EPFLXplore/ERC_AV_HW/README.md

# Electronics Subsystem Harware Repository

## How to clone

`git clone https://github.com/EPFLXplore/AV_HW_workspace.git`

`git submodule update --init --remote`
