EPFLXplore/ERC_AV_HW/node_pcb/orion_pcb/misc/TPS25947xx_Design_Calculator.xlsm

Sheet: Calculation Sheet
TPS25947xx Design Calculation Tool
 |  |  |  |  |  |  |  |  |  | Table - 1: Device Comparison Table
 | Constants Cells |  |  |  |  |  |  |  |  | Part number | Overvoltage Response | Overcurrent response | AUXOFF or PG | FLT or PGTH | Response to Thermal Shutdown (TSD) |  | 3.8 | 5.7 | 13.8
 | Input/SelectCells |  |  |  |  |  |  |  |  | TPS259470A | Adjustable OVLO | Active Current Limit | AUXOFF | FLT | Auto-Retry |  | Short | Open | 390
 | Calculation Cells |  |  |  |  |  |  |  |  | TPS259470L | Adjustable OVLO | Active Current Limit | AUXOFF | FLT | Latch-off
 | Calculated, but can be over-ridden by user |  |  |  |  |  |  |  |  | TPS259472A | Pin Selectable OVC (3.8 V/5.7 V/13.8 V) | Active Current Limit | PG | PGTH | Auto-Retry
 | Error Cells, Must be Fixed |  |  |  |  |  |  |  |  | TPS259472L | Pin Selectable OVC(3.8 V/5.7 V/13.8 V) | Active Current Limit | PG | PGTH | Latch-off
 |  |  |  |  |  |  |  |  |  | TPS259474A | Adjustable OVLO | Circuit Breaker | PG | PGTH | Auto-retry
Parameter | Description | Value | Units | Tolerance | Recommended Value |  |  |  |  | TPS259474L | Adjustable OVLO | Circuit Breaker | PG | PGTH | Latch-off
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
