EPFLXplore/ERC_AV_HW/Power/GEOX/rev1/Documentation/Calculation/TPS249x_8x_Design_Calculator_REV_B.xlsx

Sheet: Instructions
 | © 2016
TPS249x/8x Design Tool- Rev. B
Typical design procedure
Typical applications require multiple passes through the design tool using MOSFET factors such as transient
thermal response and safe operating area curves. Refer to the following application reports for more detail.
Robust Hot Swap Design (http://www.ti.com/lit/pdf/slva673)
The basic design process follows:
1. Enter operating conditions.
2. Select current limit parameters.
3. Enter MOSTFET SOA characteristics & power limit.
4. Select start up conditions (load and/or soft start). Check whether FET is operating with reasonable margin, within the SOA curve.
If not, try changing start-up conditions (soft start values, timer values), add more FETs in parallel, or switch to FET with better SOA.
5. Enter desired UVLO and OVLO values to get recommended resistor values.
6. Done
Notes
1. This worksheet is designed for use with Microsoft Excel 5.0 or later. Its use is intended to assist power supply designers in their
routine, day-to-day calculations.
2. All worksheets have light green inputs cells, white calculated cells, yellow warning cells and red high-risk cells.
3. Formulas and device constants used in the spreadsheet are locked to prohibit them from accidentally being overwritten or deleted.
TEXAS INSTRUMENTS TEXT FILE LICENSE Copyright (c) 2014 Texas Instruments Incorporated All rights reserved not granted herein. Limited License. Texas Instruments Incorporated grants a world-wide, royalty-free, non-exclusive license under copyrights and patents it now or hereafter owns or controls to make, have made, use, import, offer to sell and sell ("Utilize") this software subject to the terms herein. With respect to the foregoing patent license, such license is granted solely to the extent that any such patent is necessary to Utilize the software alone. The patent license shall not apply to any combinations which include this software, other than combinations with devices manufactured by or for TI (“TI Devices”). No hardware patent is licensed hereunder. Redistributions must preserve existing copyright notices and reproduce this license (including the above copyright notice and the disclaimer and (if applicable) source code license limitations below) in the documentation and/or other materials provided with the distribution Redistribution and use in binary form, without modification, are permitted provided that the following conditions are met: * No reverse engineering, decompilation, or disassembly of this software is permitted with respect to any software provided in binary form. * any redistribution and use are licensed by TI for use only with TI Devices. * Nothing shall obligate TI to provide you with source code for the software licensed and provided to you in obje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

Sheet: Design Calculator
TPS2490/1/2/3 & TPS2480/1/2/3 Hot Swap Design Tool
 | www.ti.com/hotswap
 |  |  | Enter Values in Green Shaded Cells
 |  |  | Calculated Values are shown in White Cells
 |  |  | Yellow and Red cells highlight pottential issues with the design. Red highlights items that are higher risk.
 | Step 0: Calculator Tutorials |  | Note: Before proceeding, please watch the video tutorials listed to ensure accurate results from this tool!
 |  |  | Steps 1 & 2: Operating Conditions, Current Limit, & Circuit Breaker (7:41) (https://training.ti.com/node/1133677)
 |  |  | Step 3: MOSFET Selection (9:58) (https://training.ti.com/node/1133673)
 |  |  | Step 4: Startup (10:32) (https://training.ti.com/node/1133664)
 |  |  | Step 5: UVLO, OVLO & PGD Thresholds (4:20) (https://training.ti.com/node/1133681)
 |  |  | TPS2490 Datasheet (http://www.ti.com/product/TPS2490)
 |  |  | I understand and agree to watch the video tutorials if help is needed. (Choose Yes to enable the calculator.) |  |  | Yes
 |  |  | Assure to follow the layout and application guidelines listed on the datasheet. |  |  | Yes
 |  |  | *For additional questions not addressed in the videos, please post on E2E.ti.com
 | Step 1: Operating Conditions |  |  | Minimum Input Operating Voltage: VIN(MIN) | 12 | V
 |  |  |  | Nominal Input Operating Voltage: VIN(NOM) | 48 | V
 |  |  |  | Maximum Input Operating Voltage: VIN(MAX) | 52 | V
 |  |  |  | Maximum Load Current: IOUT(MAX) | 150 | A
 |  |  |  | Maximum Output Load Capacitance: CLOAD | 10000 | µF
 |  |  |  | Maximum Ambient Operating Temperature: TMAX | 55 | oC
 | Steps 1 & 2: Operating Conditions, Current Limit, & Circuit Breaker (https://training.ti.com/node/1133677)
 | Step 2: Current Limit and Circuit Breaker |  |  | Maximum Recommended Value for Rs | 0.30 | mW
 |  |  |  | Use External Resistor Divider to Reduce Effecitve RS | No
 |  |  |  | Enter the Resistance for RS | 0.3 | mW
 |  |  |  | Recommended Value for RCL1 | 10 | W
 |  |  |  | Recommended Value for RCL2 | 0.00 | W
 |  |  |  | Enter value for RCL1 | 10 | W
 |  |  |  | Enter value for RCL2 | 2 | W
 | Steps 1 & 2: Operating Conditions, Current Limit, & Circuit Breaker (https://training.ti.com/node/1133677) |  |  | Effective Sense Resistance (RS,EFF) | 0.30 | mW
 |  |  |  | Resulting Minimum Current Limit | 150.0 | A
 |  |  |  | Resulting Typical Current Limit | 166.7 | A
 |  |  |  | Resulting Maximum Current Limit | 183.3 | A
 |  |  |  | Maximum Power Dissipation in RS | 10.1 | W
 | Step 3: MOSFET Selection |  |  | Q1 FET Name | SQJQ184E-T1_GE3
 |  |  |  | Estimated MOSFET RQJA | 30 | oC/W
 |  |  |  | Number of MosFETs | 4 | #
 |  |  |  | MOSFET On resistance @ TJ,DC | 1.54 | mW
 |  |  |  | Maximum FET Junction Temperature | 175 | oC
 |  |  |  | 100ms SOA Current (re-use 1ms data if unavailable) @ VIN(MAX) | 400.0 | A
 |  |  |  | 1ms SOA Current @ VIN(MAX) | 70.0 | A
 | Step 3: MOSFET Selection (https://training.ti.com/node/1133673) |  |  | 10ms SOA Current @ VIN(MAX) | 30.0 | A
 |  |  |  | 100ms Current at @ VIN(MAX) (use DC if 100ms not available) | 12.0 | A
 |  |  |  | 1s or DC SOA Current at @ VIN(MAX) (use DC if 1s not available) | 12.0 | A
 |  |  |  | FET Power dissapation at full load (per FET) | 2.2 | W
 | Note: TI recommends choosing a FET with SOA current specified for 100ms and/or 1s or DC. If choosing a FET without these parameters, this calculator will estimate the values via extrapolation, which leaves an inherent associated risk. |  |  | Maximum steady state FET Junction Temperature (TJ,DC) | 120.0 | oC
 |  |  |  | Minimum Power Limit to Ensure Vsns > 5mV & Vprog > 0.4V (PLIM,MIN) | 866.7 | W
 |  |  |  | Target Power Limit | 866.0 | W
 |  |  |  | Select R3 | 45.0 | kW
 |  |  |  | Calculated R4 | 6.72 | kW
 |  |  |  | Actual R4 (Select next available std. value) | 6.8 | kW | Note: Hover here to see the 3 values affecting this curve, consult a thermal expert if you are unsure!
 |  |  |  | Actual PLIM | 875.16 | W
 | Step 4: Startup |  |  | Load Turn-On Threshold | 0 | V
 |  |  |  | Startup Load Type | Constant Current
 |  |  |  | Startup Load Value | 0.3 | A
 |  |  |  | Use External Soft-Start Control | Yes
 |  |  |  | Typical Start Time with Vinmax (Tstart) | 260.00 | ms
 |  |  |  | IFET - ILOAD margin (lowest for Vout range) | 86.95652174%
 |  |  |  | Target Fault Timer: Tstart + Margin | 455.00 | ms
 |  |  |  | Target Timer capacitance | 2843.75 | nF
 |  |  |  | Selected Timer capacitance | 220 | nF
 | Step 4: Startup (https://training.ti.com/node/1133664) |  |  | Final Fault Timer(Tfault) | 35.20 | ms
 |  |  |  | Derated SOA / PLIM | 3.62
 |  |  |  | Can a "hot" board be hotplugged | No
 |  |  |  | Recommended slew Rate (max) | 0.59 | V/ms
 |  |  |  | Recommended slew Rate (min) | 0.10 | V/ms
 | Note: This is the typical dv/dt rate, but max value can be larger. This is because the gate source current can vary from 16uA to 28uA. Thus TI recommends keeping the overall SOA margin during start-up >1.5 in order to compensate for this. |  |  | dv/dt rate on Vout | 0.2 | V/ms
 |  |  |  | calculated SS capacitance | 110.00 | nF
 |  |  |  | actual SS capacitance | 110 | nF
 |  |  |  | actual dv/dt rate on Vout | 0.20 | V/ms
 |  |  |  | SOA margin during start-up | 4.17
 |  |  |  | Target Fault Time | 0.4 | ms
 |  |  |  | Calculated Timer Capacitance | 2.50 | nF
 |  |  |  | Actual Timer Capacitance (pick one smaller than CT,CALC) | 2 | nF
 |  |  |  | Actual Fault Time (Tfault) | 0.32 | ms
 |  |  |  | SOA margin during "hot-short" or "start-into short" | 3.62
 | Step 5: UVLO, OVLO & PGD Thresholds |  |  | Target Under - Voltage | 30 | V
 |  |  |  | Recommended R2 | 10.00 | kW
 |  |  |  | Actual R2 | 10 | kW
 |  |  |  | Calculated R1 | 212.22 | kW
 |  |  |  | Actual R1 | 212 | kW
 |  | Resulting Thresholds: | Minimum | Typical | Maximum
 | Step 5: UVLO, OVLO & PGD Thresholds (https://training.ti.com/node/1133681) | Resulting Upper UVLO Threshold = | 29.30 | 29.97 | 30.64 | V
 |  | Resulting Lower UVLO Threshold = | 27.08 | 27.75 | 28.42 | V
 | Design Summary |  |  | RS = | 0.3 | mW
 |  |  |  | RCL1 = | DNP | W
 |  |  |  | RCL2 = | short | W
 |  |  |  | R1 = | 212 | kW |  |  | Typical | Units
 |  |  |  | R2 = | 10 | kW |  | Current limit | 166.7 | A
 |  |  |  | R3 = | 45.0 | kW |  | Power Limit | 875.1608752 | W
 |  |  |  | R4 = | 6.8 | kW |  | Fault Timeout | 0.320 | ms
 |  |  |  | CT = | 2.00 | nF |  | Upper UVLO Threshold | 30.0 | V
 |  |  |  | C1 = | 0.10 | µF |  | Lower UVLO Threshold | 27.8 | V
 |  |  |  | Q1 = | SQJQ184E-T1_GE3
 |  |  |  | RG = | 1 | kW
 |  |  |  | CG = | 110 | nF
 | Notes: | 1. Although not mandatory, CIN provides transient suppression at the VIN pin
 |  | 2. A TVS clamp from VIN to GND is absolutely mandatory to clamp the voltage overshoot upon MOSFET turn-off, e.g. during circuit breaker
 |  | 3. Componet tolerances not accounted for in Min/Max Calculations.

Sheet: Equations
Current Limit
 |  |  | CLMIN = | 45 | mV
 |  |  | CLNOM = | 50 | mV
 |  |  | CLMAX = | 55 | mV
 |  |  |  | Max Rs = | 0.297029703
 |  |  |  | RCL1 Recommended = | 10
 |  |  |  | RCL2 Recommmended = | 0
 |  |  |  | Effective Rs = | 0.3
 |  |  |  | Min. Current limit = | 150.00
 |  |  |  | Typ. Current limit = | 166.6666667
 |  |  |  | Max. Current limit = | 183.3333333
 |  |  |  | Rs Power Diss. = | 10083.33333 |  |  |  | R = R4 / (R4+R3)
 |  |  |  |  |  |  |  |  | R* R4 + R*R3 = R4
FET Selection |  |  |  |  |  |  |  |  | R4(1-R) = R *R3
 |  |  |  |  | Nominal |  | Derated at TJ
 |  |  |  | 100ms SOA Current Maximum Input Voltage | 20800 | W | 7631 |  | R4 = R3 * R/(1-R)
 |  |  |  | 1ms SOA Current Maximum Input Voltage | 3640 | W | 1335.425
 |  |  |  | 10ms SOA Current Maximum Input Voltage | 1560 | W | 572.325
 |  |  |  | 100ms or DC SOA Current at Maximum Input Voltage | 624 | W | 228.93
 |  |  |  | Minimum Power Limit= | 866.6666667 | W
 |  |  |  | Target PLIM | 866 | W
 |  |  |  | Target Vprog | 0.5196 | V
 |  |  |  | R3 | 45 | k-ohm
 |  |  |  | Res. Div. | 0.130
 |  |  |  | R4 | 6.718 | k-ohm
 |  |  |  | Act R4 | 6.8
 |  |  |  | Vprog | 0.525 | V
 |  |  |  | Plim | 875.161
Startup
 |  |  | With PLIM
 |  |  |  | Typical Start time | 260.00 | ms
 |  |  |  | Start-slop | 0.75
 |  |  |  | Target Fault Timer | 455 | ms
 |  |  |  | Target Timer capacitance | 2843.75 | nF
 |  |  |  | Selected Timer capacitance | 220.00 | nF
 |  |  |  | Final Fault Timer | 35.2 | ms
 |  |  |  | SOA / PLIM | 3.615049483
 |  |  | With SS
 |  |  |  | dv/dt rate | 0.2 | V/ms
 |  |  |  | calculated SS capacitance | 110 | nF
 |  |  |  | actual SS capacitance | 110 | nF
 |  |  |  | actual dv/dt rate | 0.2 | V/ms
 |  |  |  | I_Cout | 2 | A
 |  |  |  | typical start time | 260 | ms
 |  |  |  | FET Energy dissipated at start-up (EFET) | 15.3985 | J
 |  |  |  | Peak Power dissipated during start-up (PFET) | 119.6 | W
 |  |  |  | Equivalent time at peak power - EFET/PFET (t_power) | 128.75 | ms
 |  |  |  | Available SOA for t_power at Vinmax | 499.2 | W
 |  |  |  | SOA margin | 4.173913043
 |  |  |  |  | 1 | ms
 |  |  | Covering hot-short, start-into short for SS
 |  |  |  | Target Fault Time | 0.40
 |  |  |  | Calculated Timer Capacitance | 2.5 | nF
 |  |  |  | Actual Timer Capacitance | 2.00 | nF
 |  |  |  | Actual Fault Time (Tfault) | 0.32 | ms
 |  |  |  | Available derated SOA for Tfault | 3163.74987 | W
 |  |  |  | SOA margin | 3.615049483
 |  |  |  | UVLO |  |  |  |  | 1.35 = UV * R2/(R2+R1)
 |  |  |  | Target Under - Voltage | 30 | V
 |  |  |  | Recommended R2 | 10 | k-ohm |  |  | R2+R1 = UV * R2 /1.35
 |  |  |  | Actual R2 | 10 | k-ohm
 |  |  |  | Calculated R1 | 212.22 | k-ohm |  |  | R1 = R2*(-1+UV/1.35)
 |  |  |  | Actual R1 | 212 | k-ohm
 |  |  | Resulting Thresholds: | Minimum | Typical | Maximum
 |  |  | Resulting Upper UVLO Threshold = | 29.30 | 29.97 | 30.64
 |  |  | Resulting Lower UVLO Threshold = | 27.08 | 27.75 | 28.42
 |  | GRAPH:
 |  |  |  | Selected Rs = | 0.3
 |  |  |  | Max System voltage = | 52
 |  |  |  | Current Lim (min) = | 150.00
 |  |  |  | Current Lim (typ) = | 166.67
 |  |  |  | Current Lim (max) = | 183.33
 |  |  |  | Power Limit (typ) = | 875.161
 |  |  | A) This table calculates the Ids current based |  |  |  |  | B) This table corrrects the table at left so no |  |  |  | C) This table creates the |  |  | D) This table changes ID values to zero for Vds>Vin(max)
 |  |  | on power limit only - no current limit info. |  |  |  |  | current is greater than the current limit. |  |  |  | SOA data points from |  |  | and adds the SOA curve. This data is plotted.
 | PLIM |  | Vds | Min | Typ | Max |  | Vds | Min | Typ | Max | the customer's SOA |  |  | Vds | Min | Typ | Max | SOA | Temp Derated SOA
 | 875.1608752 | 0.1 | 0.4333333333 | 1514.70 | 2019.60 | 2524.50 |  | 0.4333333333 | 150.00 | 166.67 | 183.33 | data he entered. |  |  | 0.4333333333 | 150.00 | 166.67 | 183.33 | 7300.96 | 3163.74987 | W
 | 875.1608752 | 1 | 4.333333333 | 151.47 | 201.96 | 252.45 |  | 4.333333333 | 150.00 | 166.67 | 183.33 |  |  |  | 4.333333333 | 150.00 | 166.67 | 183.33 | 730.10
 | 875.1608752 | 2 | 8.666666667 | 75.74 | 100.98 | 126.23 |  | 8.666666667 | 75.74 | 100.98 | 126.23 |  | User's |  | 8.666666667 | 75.74 | 100.98 | 126.23 | 365.05
 | 875.1608752 | 3 | 13 | 50.49 | 67.32 | 84.15 |  | 13 | 50.49 | 67.32 | 84.15 | Vds | Ids |  | 13 | 50.49 | 67.32 | 84.15 | 243.37
 | 875.1608752 | 4 | 17.33333333 | 37.87 | 50.49 | 63.11 |  | 17.33333333 | 37.87 | 50.49 | 63.11 | 0.4333333333 | 3163.74987 | x = customer's entry | 17.33333333 | 37.87 | 50.49 | 63.11 | 182.52
 | 875.1608752 | 5 | 21.66666667 | 30.29 | 40.39 | 50.49 |  | 21.66666667 | 30.29 | 40.39 | 50.49 | 4.333333333 | 2862.44 |  | 21.66666667 | 30.29 | 40.39 | 50.49 | 146.02
 | 875.1608752 | 6 | 26 | 25.25 | 33.66 | 42.08 |  | 26 | 25.25 | 33.66 | 42.08 | 8.666666667 | 2768.28 |  | 26 | 25.25 | 33.66 | 42.08 | 121.68
 | 875.1608752 | 7 | 30.33333333 | 21.64 | 28.85 | 36.06 |  | 30.33333333 | 21.64 | 28.85 | 36.06 | 13 | 2695.05 |  | 30.33333333 | 21.64 | 28.85 | 36.06 | 104.30
 | 875.1608752 | 8 | 34.66666667 | 18.93 | 25.25 | 31.56 |  | 34.66666667 | 18.93 | 25.25 | 31.56 | 17.33333333 | 2636.46 | x | 34.66666667 | 18.93 | 25.25 | 31.56 | 91.26
 | 875.1608752 | 9 | 39 | 16.83 | 22.44 | 28.05 |  | 39 | 16.83 | 22.44 | 28.05 | 21.66666667 | 1792.79 |  | 39 | 16.83 | 22.44 | 28.05 | 81.12
 | 875.1608752 | 10 | 43.33333333 | 15.15 | 20.20 | 25.25 |  | 43.33333333 | 15.15 | 20.20 | 25.25 | 26 | 1190.17 |  | 43.33333333 | 15.15 | 20.20 | 25.25 | 73.01
 | 875.1608752 | 11 | 47.66666667 | 13.77 | 18.36 | 22.95 |  | 47.66666667 | 13.77 | 18.36 | 22.95 | 30.33333333 | 738.21 |  | 47.66666667 | 13.77 | 18.36 | 22.95 | 66.37
 | 875.1608752 | 12 | 52 | 12.62 | 16.83 | 21.04 |  | 52 | 12.62 | 16.83 | 21.04 | 34.66666667 | 386.68 |  | 52 | 12.62 | 16.83 | 21.04 | 60.84
 | 875.1608752 | 13 | 56.33333333 | 11.65 | 15.54 | 19.42 |  | 56.33333333 | 11.65 | 15.54 | 19.42 | 39 | 105.46 | x | 56.33333333 | 5e-10 | 5e-10 | 5e-10 | 56.16
 | 875.1608752 | 14 | 60.66666667 | 10.82 | 14.43 | 18.03 |  | 60.66666667 | 10.82 | 14.43 | 18.03 | 43.33333333 | 70.31 |  | 60.66666667 | 5e-10 | 5e-10 | 5e-10 | 52.15
 | 875.1608752 | 15 | 65 | 10.10 | 13.46 | 16.83 |  | 65 | 10.10 | 13.46 | 16.83 | 47.66666667 | 45.20 |  | 65 | 5e-10 | 5e-10 | 5e-10 | 48.67
 | 875.1608752 | 16 | 69.33333333 | 9.47 | 12.62 | 15.78 |  | 69.33333333 | 9.47 | 12.62 | 15.78 | 52 | 26.36 |  | 69.33333333 | 5e-10 | 5e-10 | 5e-10 | 45.63
 |  |  |  |  |  |  |  |  |  |  |  | 56.33333333 | 11.72 |  |  | 0.00 | 0.00 | 0.00 | #DIV/0!
 |  |  | Note: I added an adjustment for the systematic offset |  |  |  |  |  |  |  |  | 60.66666667 | 0.00 | x |  | 0.00 | 0.00 | 0.00 | #DIV/0!
 |  |  |  |  |  |  |  |  |  |  |  | 65 | 0.00 |  |  | 0.00 | 0.00 | 0.00 | #DIV/0!
 |  |  | Vos syst | #REF! |  |  |  |  |  |  |  | 69.33333333 | 0.00
 |  |  | Rs (ohm) | 0.0003
 |  |  | Vin, max | 52
 |  |  | Plim tolerance |  | 0.25
 |  |  | Plim (Vds) = Plim (Vin,max) + (Vds - Vin,max)*Vos,syst/Rs
