EPFLXplore/ERC_AV_HW/hats/neopixel_Eliot/misc/images.png

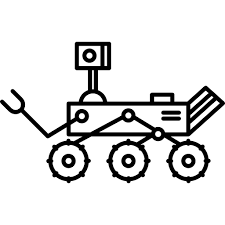
hats/neopixel_Eliot/misc/images.png
