EPFLXplore/ERC_AV_HW/hats/neopixel_Eliot/misc/star-wars-baby-yoda-with-lightsaber-custom-progress-bar-m.png

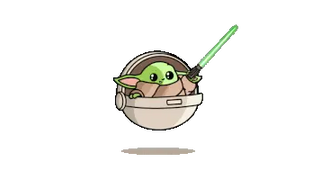
hats/neopixel_Eliot/misc/star-wars-baby-yoda-with-lightsaber-custom-progress-bar-m.png
