EPFLXplore/ERC_AV_HW/nav_controller_interface/nav_controller_interface_v3/nav_lower_controller/misc/kerby_mission_patch.png

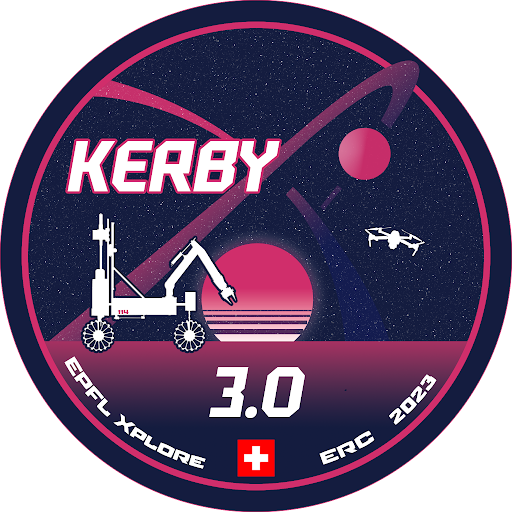
nav_controller_interface/nav_controller_interface_v3/nav_lower_controller/misc/kerby_mission_patch.png
