EPFLXplore/ERC_AV_HW/Power/GEOX/rev2/SMPS_Motherboard/Manufacturing/smps_legged_robot.csv

Id | Référence | Empreinte | Quantité | Désignation | Fournisseur et réf
1 | Y1101 | 7M25000MAAJT | 1 | 7M-25.000MAAJ-T
2 | R1115,R1130,R1135,R1114,R1113,R1136,R1128,R1129 | R_0402_1005_DensityHigh | 8 | 4.75k 0.1% 1/16W
3 | J1104,J1103,J1102,J1105 | 1054301203 | 4 | Nano-Fit 1x03
4 | C1145,C816,C1127,C1709,C1126,C1117,C1116,C901,C1105,C417,C1128,C1146,C808,C1121,C2001,C1115,C1102,C1139,C1140,C809,C416,C409,C1124,C407,C1001,C410,C1104,C403,C408,C1122,C1101,C1801,C815,C1206,C1119,C414,C1109,C1110,C1120,C404,C1112,C1123,C1113,C1701,C1125,C1147,C405,C1118 | C_0402_1005_DensityHigh | 48 | 100n X7R 50V
5 | R1132,R1133,R1125,R1131,R1134 | R_0402_1005_DensityHigh | 5 | 470R 1% 1/16W
6 | Molex_602,Molex_604,Molex_601,Molex_607,Molex_605,Molex_603,Molex_606,Molex_608 | 172448-YY02 | 8 | ~
7 | IC1501 | SOP50P490X110-10N | 1 | TPS2490DGSRG4
8 | R805 | R_0402_1005_DensityHigh | 1 | 43k
9 | C817 | C_0805_2012_DensityHighest | 1 | 22u X7R 10V
10 | D1001,D901,D1301,D2501,D1401,D1302 | SOT1176D | 6 | PESD4USB5B-TBSX
11 | C2103,C2102,C2105,C2201,C2202,C2203,C2204,C2104 | C_0603_1608_DensityHigh | 8 | 1n X7R 1kV
12 | L803 | L_Coilcraft_LPS4018 | 1 | 22u
13 | FB1101,FB1103,FB1104,FB1102 | BLM18SP221SN1B | 4 | BLM18PG330SN1D
14 | D504,D501,D503,D502 | DIOM4336X24N | 4 | SMBJ51CD-M3/H
15 | C802,C1204 | C_0805_2012_DensityHigh | 2 | 100n X7R 100V
16 | D1102,D1104,D1105,D1103 | SOT95P230X117-3N | 4 | PESD2CANFD24V-UX
17 | C805,C1205,C1148,C804 | C_0805_2012_DensityHigh | 4 | 2.2u X7R 25V
18 | R402,R403 | R_0402_1005_DensityHigh | 2 | 5.1k 1% 1/16W
19 | C1133,C1136 | C_0402_1005_DensityHigh | 2 | 18p NP0 50V
20 | R401 | R_0402_1005_DensityHigh | 1 | 33k 1% 1/16W
21 | C1141,C1143,C1142,C1144 | C_0603_1608_DensityHigh | 4 | 22n X7R 50V
22 | R1705,R1103 | R_0603_1608_DensityHigh | 2 | 47k 1% 1/10W
23 | R1101,R406,R1102,R405,R404 | R_0402_1005_DensityHigh | 5 | 10k 1% 1/16W
24 | R1502 | R_1206_3216_DensityHigh_Large | 1 | 10k 1% 1/4W
25 | R1505 | RES_WSLP3921_.003OHM_VIS | 1 | 0.3m
26 | C412,C413,C818,C415,C814,C820,C406 | C_0402_1005_DensityHigh | 7 | 1u X7R 10V
27 | R408,R407 | R_0402_1005_DensityHigh | 2 | 27R 1% 1/5W
28 | Q1102 | SOT-23-3 | 1 | MF-DSC-SOT233-BSS138
29 | L801 | XEL4030682MEC | 1 | 6u8
30 | C1207,C803 | C_1210_3225_DensityHigh | 2 | 10u X7R 25V
31 | D1504,D1505 | LED_0603_1608Metric | 2 | GREEN
32 | IC1102 | SOIC127P600X175-8N | 1 | M24C16-RMN6P
33 | R801 | R_0603_1608_DensityHigh | 1 | 34k 1% 1/4W
34 | FB1201,FB801 | R_0805_2012_DensityHigh | 2 | 1k @ 100MHz
35 | C1111 | C_0402_1005_DensityHigh | 1 | 1u X7R 50V
36 | R806,R803 | R_0402_1005_DensityHigh | 2 | 10k 1%
37 | F1301,F1401 | FUSC6127X294N | 2 | 0451015.MRL
38 | R1127,R1126 | R_0603_1608_DensityHigh | 2 | 10R 1% 1/8W
39 | SW1103,SW1101 | CAS-220A_NDC-L | 2 | CAS-220TA
40 | R1704,R1706,R1703,R1507 | R_0603_1608_DensityHigh | 4 | 1k 1% 1/10W
41 | R1139,R1138,R1108,R1107 | R_0603_1608_DensityHigh | 4 | 60R4 1% 1/4W
42 | C1130,C1138,C1137,C1134,C1131,C1132,C1129,C1135 | C_0603_1608_DensityHigh | 8 | 15p X7R 50V
43 | R1123,R1124,R1117,R1122,R1120,R1119,R1118,R1121 | R_0402_1005_DensityHigh | 8 | 49.9R 0.1% 1/16W
44 | R1501 | R_0603_1608_DensityHigh | 1 | 212k 1% 1/10W
45 | Q1201,Q1202,Q1204,Q1203 | POWERPAK8X8L_VIS | 4 | SQJQ186E-T1_GE3
46 | C1114 | C_0402_1005_DensityHigh | 1 | 220p X7R 50V
47 | C806 | C_1210_3225_DensityHigh | 1 | 4.7uF X7R 25V
48 | FB401 | L_0603_1608Metric | 1 | 100R@100MHz
49 | C1802 | C_0603_1608_DensityHigh | 1 | 4.7u X7R 16V
50 | C1704,C1702,C1703 | C_0603_1608_DensityHigh | 3 | 4.7n X7R 50V
51 | J502 | AMASS_XT90PW-F | 1 | XT90PW-F
52 | U1102,U1101 | HVSON-8-1EP_3x3mm_P0.65mm_EP1.6x2.4mm_ThermalVias | 2 | TCAN1051HGVDRBRQ1
53 | R1116 | R_0402_1005_DensityHigh | 1 | 12k 1%, 1/16W
54 | D1107 | LED_SM1206 | 1 | ORANGE
55 | J501 | AMASS_XT90PW-M | 1 | XT90PW-M
56 | C1503 | C_0603_1608_DensityHigh | 1 | 110n X7R 100V
57 | Q1401,Q1502,Q1501 | SOT-23-3 | 3 | PMV90ENER
58 | J1701 | SHDRRA4W35P0X125_1X4_675X550X350P | 1 | 53048-0450
59 | C1401,C1302,C813 | C_0603_1608_DensityHigh | 3 | 100n X7R 100V
60 | U801 | SOTFL50P160X60-8N | 1 | TPS2116DRLR
61 | R802 | R_0402_1005_DensityHigh | 1 | 0R
62 | J1107,J1108 | RJ45_Wuerth_74980111211_Horizontal | 2 | RJ45_Wuerth_74980111211
63 | R1708,R1707 | R_0603_1608_DensityHigh | 2 | 10k 1% 1/10W
64 | J1702 | 5051103091 | 1 | 505110-3091
65 | R804 | R_0402_1005_DensityHigh | 1 | 10.7k
66 | R1701,R1702 | R_0603_1608_DensityHigh | 2 | 33 1% 1/10W
67 | U1701 | SOT95P280X145-5N | 1 | 74LVC1G125
68 | R1105,R1104 | R_0402_1005_DensityHigh | 2 | 100k 1% 1/8W
69 | C1706,C1705 | C_0603_1608_DensityHigh | 2 | 470n X5R 16V
70 | C1501 | C_1210_3225_DensityHigh | 1 | 10uF X7R 100V
71 | IC2001 | SOP50P490X110-10N | 1 | INA239AQDGSRQ1
72 | C812 | R_0805_2012_DensityHigh | 1 | 2u2 X7R 100V
73 | R1710,R1709 | R_0603_1608_DensityHigh | 2 | 20k 1% 1/10W
74 | C402,C401 | C_0402_1005Metric | 2 | 12p NP0 25V
75 | C801,C1201,C1203,C810,C811,C1202 | C_0805_2012_DensityHigh | 6 | 2u2 X7R 100V
76 | J2501,J1301 | 10159558410421RLF | 2 | 10159558-410421RLF
77 | D401 | SOT-143 | 1 | PRTR5V0U2X
78 | R1508,R1506 | R_0402_1005_DensityHigh | 2 | 470R 1% 1/8W
79 | C1708 | C_0603_1608_DensityHigh | 1 | 1u X7R 16V
80 | C411 | C_0603_1608_DensityHigh | 1 | 4u7 X7R 16V
81 | R1503 | R_0603_1608_DensityHigh | 1 | 45k 1% 1/10W
82 | J402 | CONN_SM06B-GHS-TB_JST | 1 | Conn_Picoblade_JST_DEBUG
83 | C1707 | C_0603_1608_DensityHigh | 1 | 220n X7R 10V
84 | D402 | SOT1176D | 1 | PESD4USB3U-TBSX
85 | C1502 | C_1206_3216_DensityHigh | 1 | 2nF X7R 50V
86 | Q1101 | SOT-23-3 | 1 | MF-DSC-SOT233-BSS84
87 | IC801 | SOTFL50P160X60-8N | 1 | TPS629206QDRLRQ1
88 | IC1101 | QFN50P900X900X100-65N-D | 1 | LAN9252_ML
89 | J1801 | JST_PH_S2B-PH-SM4-TB_1x02-1MP_P2.00mm_Horizontal | 1 | S2B-PH-SM4-TB
90 | J403 | USB_C_Receptacle_GCT_USB4105-xx-A_16P_TopMnt_Horizontal | 1 | USB4105-GF-A
91 | U802 | LMR36503 | 1 | LMR36506MSC5RPERQ1
92 | U1801 | TSOT-23-5 | 1 | DGD0216WT-7
93 | Y401 | ABM8W480000MHZ6D1XT3 | 1 | ABM8W-48.0000MHZ-4-D1X-T3
94 | IC1201 | MAX25262AFOFVY | 1 | MAX25262AFOF_VY+
95 | C1149,C1150 | C_0402_1005_DensityHigh | 2 | 4n7 X7R 100V
96 | R1504 | R_1206_3216_DensityHigh_Large | 1 | 7,5k 1% 1/4W
97 | L802 | IND_XGL3530_COC | 1 | 2u2
98 | U401 | LQFP-64_10x10mm_P0.5mm | 1 | STM32G483RET6
99 | IC1701 | SOP65P490X110-9N | 1 | TPA6205A1DGN
100 | C807 | C_0805_2012_DensityHigh | 1 | 22u X7R 10V
101 | R1602,R1604,R1603,R1601 | R_0805_2012_DensityHigh | 4 | 10R 1% 1/8W
