EPFLXplore/ERC_AV_HW/hats/load_cell_connector_interface/step/load_cell_connector_interface.step

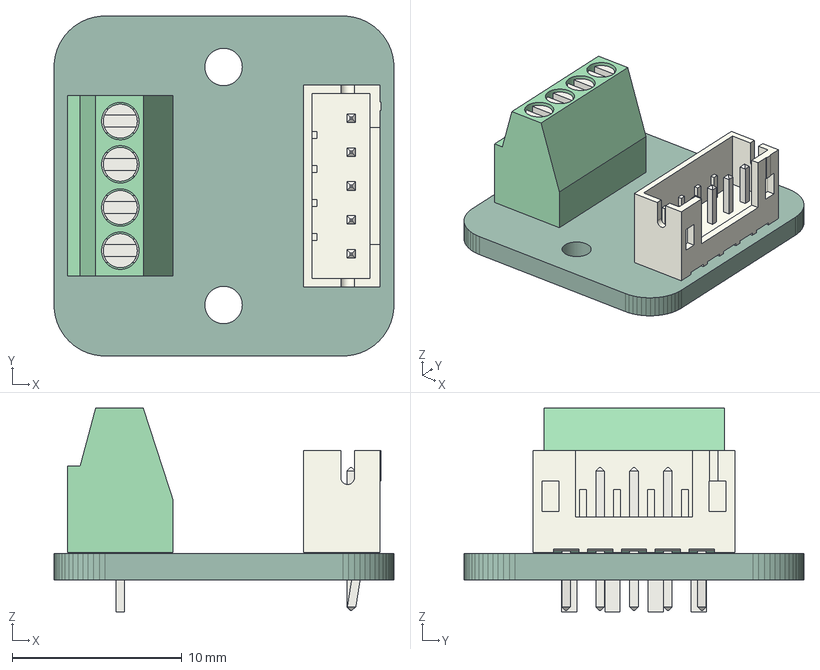
[picture p29: CAD file, 2023-09-30]
hats/load_cell_connector_interface/step/load_cell_connector_interface.step
20.0 x 20.0 x 12.0 mm
PCB
