EPFLXplore/ERC_AV_HW/hats/testing_jig/3d/3352T-1-201LF.STEP

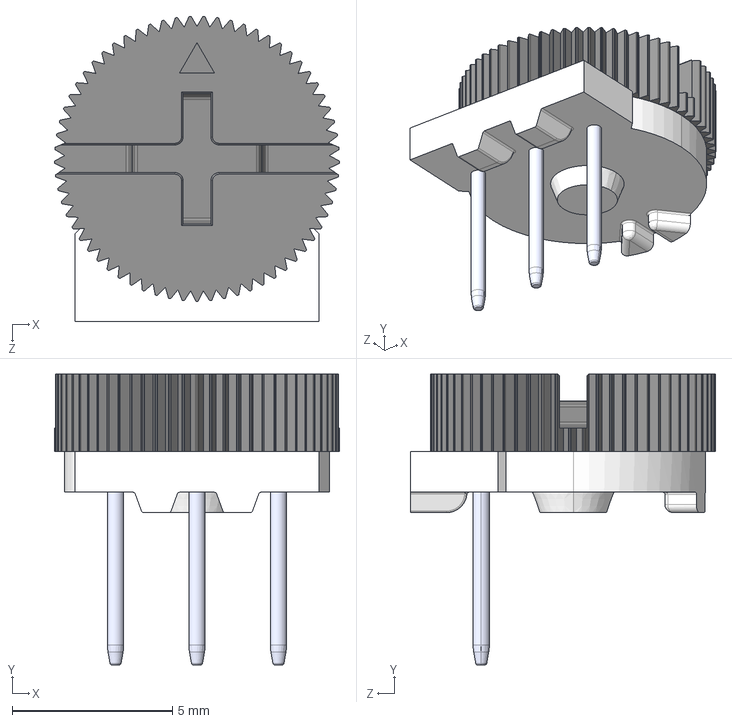
[picture p30: CAD file, 2023-09-30]
hats/testing_jig/3d/3352T-1-201LF.STEP
8.89 x 9.07 x 9.52 mm
