EPFLXplore/ERC_AV_HW/Power/GEOX/rev2/SMPS_legged_robot_module/footprints/Ideal diode controller/LTC4372CMS8#TRPBF.stp

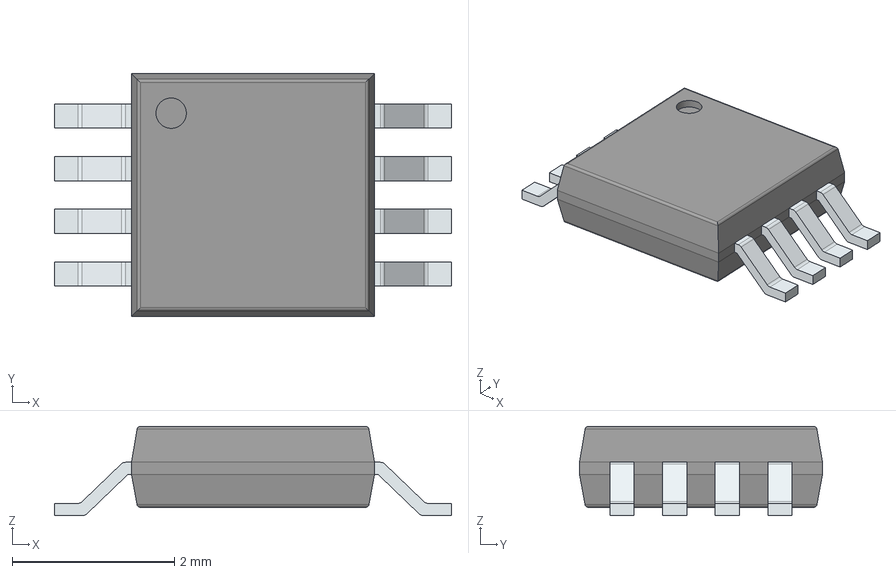
[picture p31: CAD file, 2024-09-16]
Power/GEOX/rev2/SMPS_legged_robot_module/footprints/Ideal diode controller/LTC4372CMS8#TRPBF.stp
4.90 x 3.00 x 1.10 mm
PinsArrayLR
