EPFLXplore/ERC_AV_HW/Power/GEOX/rev2/SMPS_legged_robot_module/footprints/Isolator/SI8630AB-B-IS.step

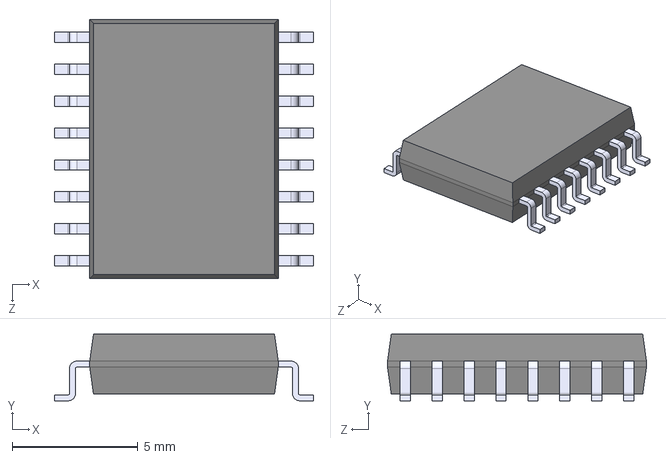
[picture p32: CAD file, 2024-09-16]
Power/GEOX/rev2/SMPS_legged_robot_module/footprints/Isolator/SI8630AB-B-IS.step
10.3 x 2.65 x 10.3 mm
