EPFLXplore/ERC_AV_HW/Power/GEOX/rev2/SMPS_legged_robot_module/footprints/Power module/LTC3889EUKG#PBF.stp

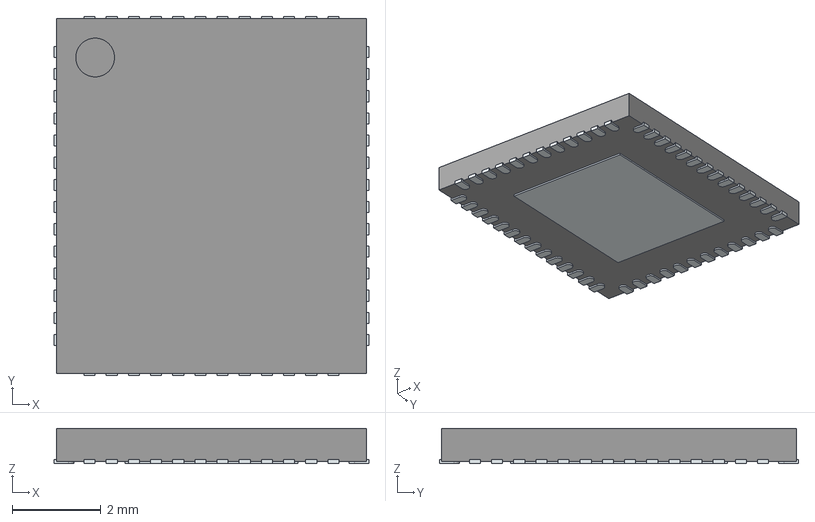
[picture p33: CAD file, 2024-09-16]
Power/GEOX/rev2/SMPS_legged_robot_module/footprints/Power module/LTC3889EUKG#PBF.stp
7.10 x 8.10 x 0.8 mm
ThermalPin
PinsArrayLR
PinsArrayTB
