EPFLXplore/ERC_AV_HW/Power/GEOX/rev2/SMPS_Motherboard/footprints/ampli/TPA6205A1DGN.stp

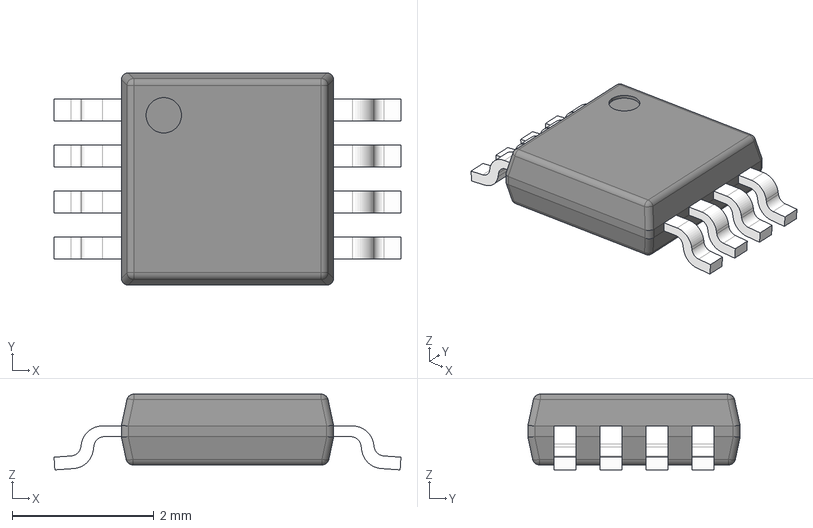
[picture p34: CAD file, 2024-09-16]
Power/GEOX/rev2/SMPS_Motherboard/footprints/ampli/TPA6205A1DGN.stp
4.90 x 3.00 x 1.07 mm
BODY-DGN0008G
LEAD-DGN0008G x 8
PIN1_DGN0008G
DAP_DGN0008G
