EPFLXplore/ERC_AV_HW/Power/GEOX/rev2/SMPS_Motherboard/footprints/connector/Input Voltage/XT90PW-M.STEP

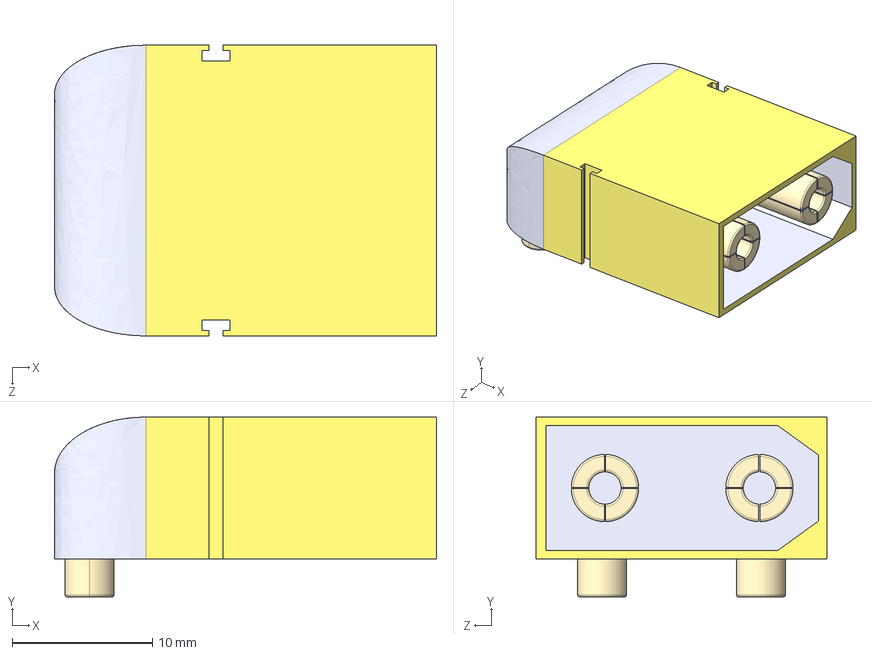
[picture p35: CAD file, 2024-09-16]
Power/GEOX/rev2/SMPS_Motherboard/footprints/connector/Input Voltage/XT90PW-M.STEP
27.2 x 12.8 x 20.7 mm
