EPFLXplore/ERC_AV_HW/Power/GEOX/rev2/SMPS_Motherboard/footprints/connector/JTAG/FTSH-107-01-F-DV-K-P-TR.step

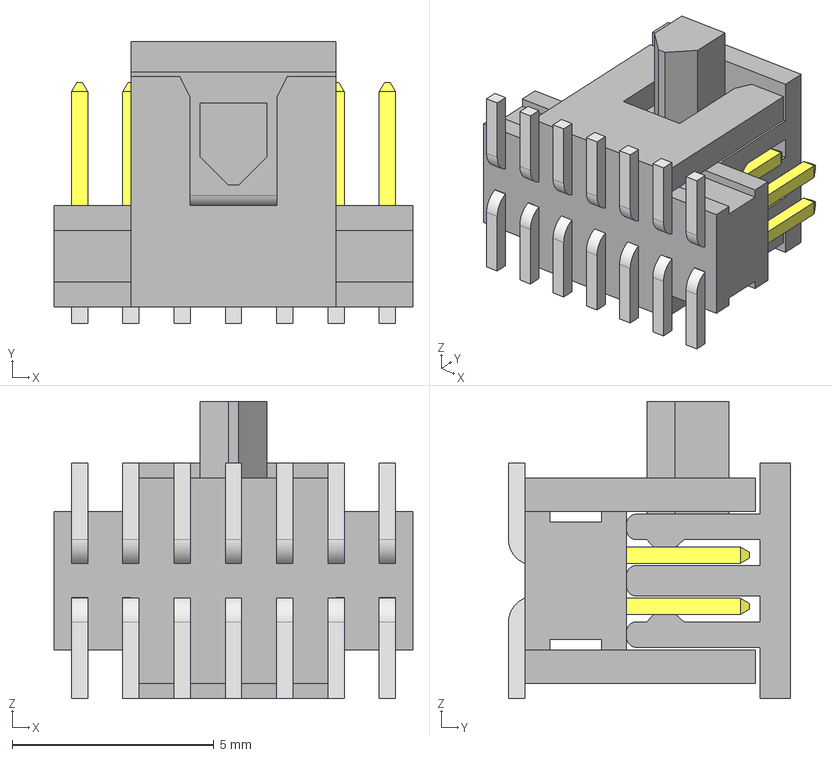
[picture p36: CAD file, 2024-09-16]
Power/GEOX/rev2/SMPS_Motherboard/footprints/connector/JTAG/FTSH-107-01-F-DV-K-P-TR.step
8.89 x 6.98 x 7.37 mm
FTSH-107-01-F-DV-K-P-TR_body
FTSH-107-01-F-DV-K-P-TR_pins1
FTSH-107-01-F-DV-K-P-TR_pins2
FTSH-107-01-F-DV-K-P-TR_pp_pad
