EPFLXplore/ERC_AV_HW/Power/GEOX/rev2/SMPS_Motherboard/footprints/connector/Output Voltage/PJ-082BH.stp

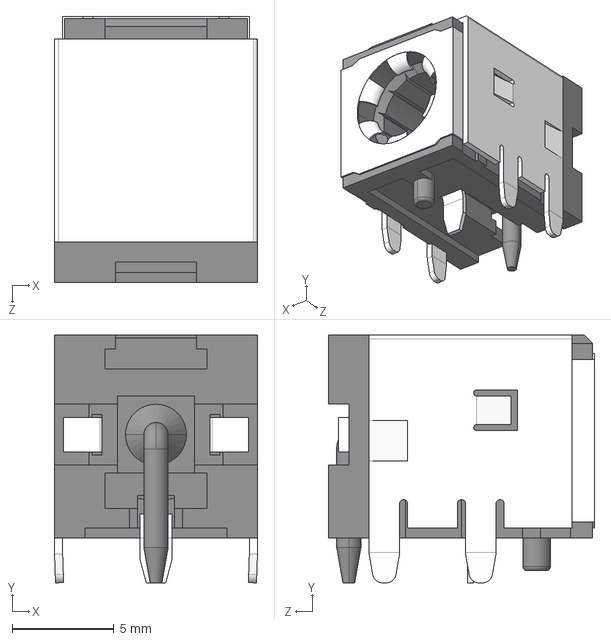
[picture p37: CAD file, 2024-09-16]
Power/GEOX/rev2/SMPS_Motherboard/footprints/connector/Output Voltage/PJ-082BH.stp
10.0 x 12.2 x 13.1 mm
