EPFLXplore/ERC_AV_HW/Power/GEOX/rev2/SMPS_Motherboard/footprints/EEPROM/M24C16-RMN6P.stp

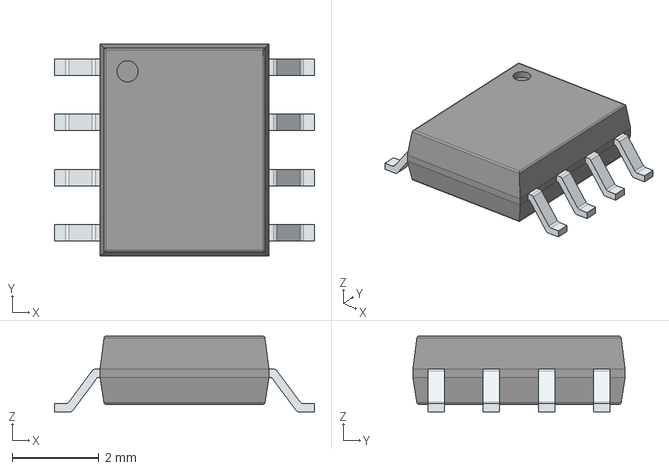
[picture p38: CAD file, 2024-09-16]
Power/GEOX/rev2/SMPS_Motherboard/footprints/EEPROM/M24C16-RMN6P.stp
6.00 x 4.90 x 1.75 mm
PinsArrayLR
