EPFLXplore/ERC_AV_HW/Power/GEOX/rev2/SMPS_Motherboard/footprints/EtherCAT/LAN9252_ML.stp

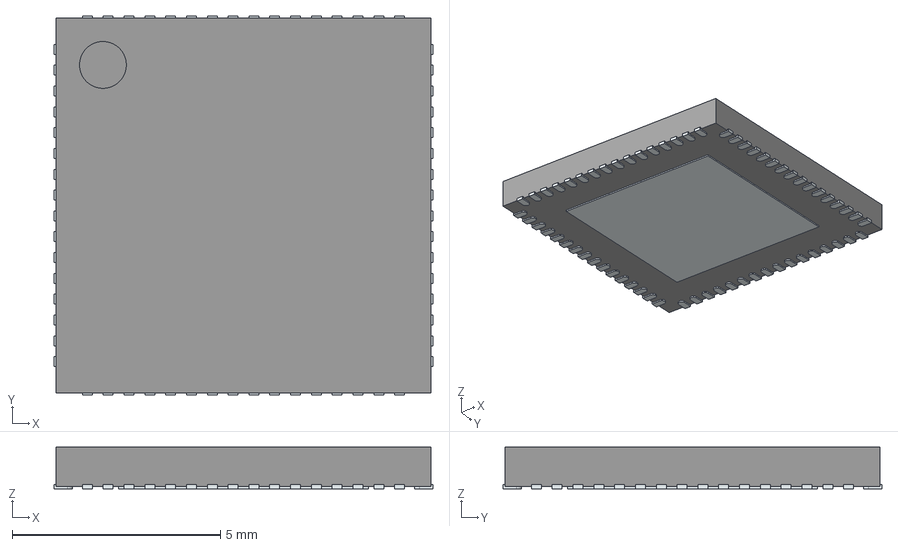
[picture p39: CAD file, 2024-09-16]
Power/GEOX/rev2/SMPS_Motherboard/footprints/EtherCAT/LAN9252_ML.stp
9.10 x 9.10 x 1.00 mm
ThermalPin
PinsArrayLR
PinsArrayTB
