EPFLXplore/ERC_AV_HW/Power/GEOX/rev2/SMPS_Motherboard/footprints/Power safety/Hot-Swap/TPS2490DGSRG4.stp

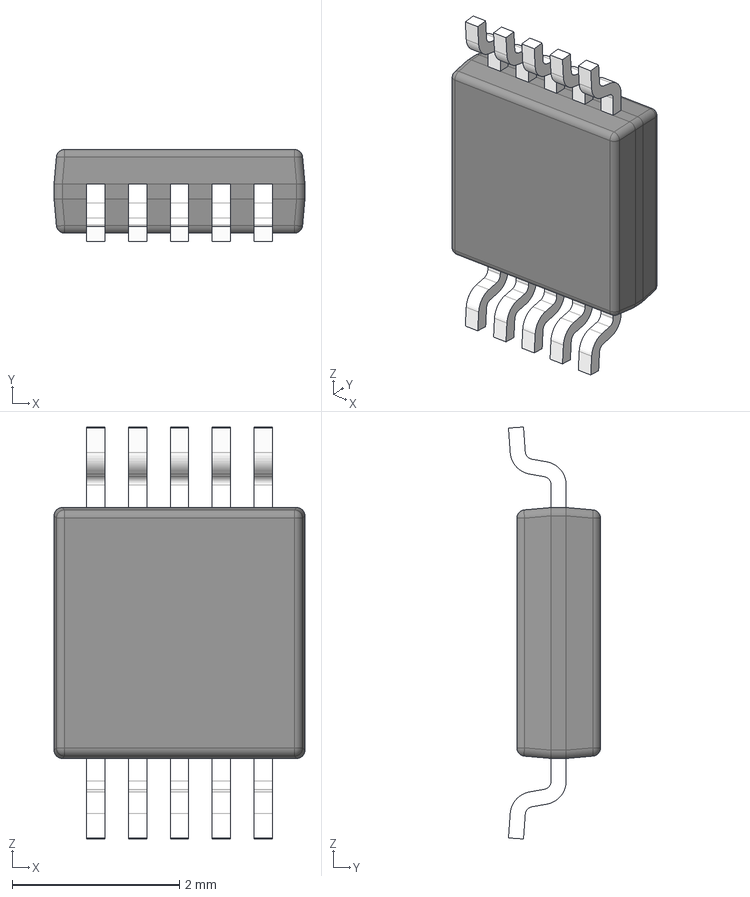
[picture p40: CAD file, 2024-09-16]
Power/GEOX/rev2/SMPS_Motherboard/footprints/Power safety/Hot-Swap/TPS2490DGSRG4.stp
3.00 x 1.10 x 4.93 mm
BODY-SO
LEAD-SO x 10
PIN1-ID
