EPFLXplore/ERC_AV_HW/Power/GEOX/rev2/SMPS_Motherboard/footprints/transistor/PSMN4R8-100BSEJ.stp

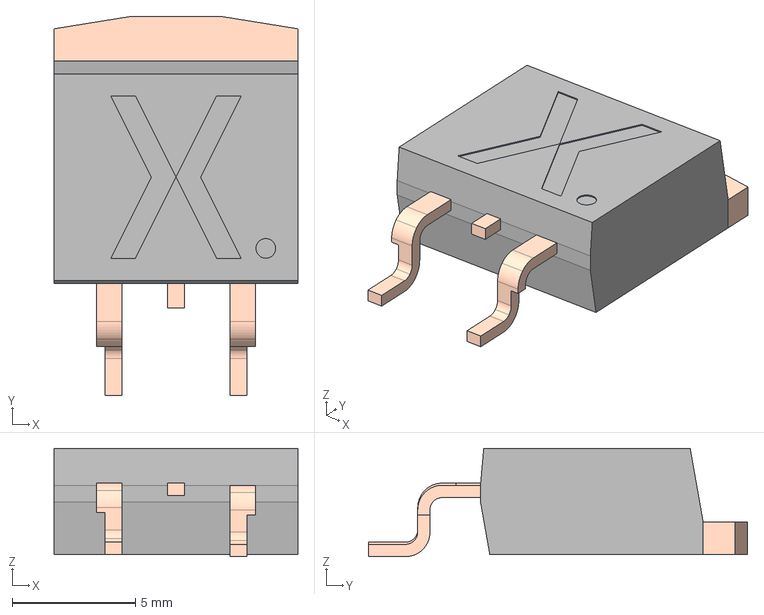
[picture p41: CAD file, 2024-09-16]
Power/GEOX/rev2/SMPS_Motherboard/footprints/transistor/PSMN4R8-100BSEJ.stp
9.90 x 15.4 x 4.40 mm
