EPFLXplore/ERC_AV_HW/Power/GEOX/rev2/SMPS_Motherboard/footprints/connector/Input Voltage/XT90PW-F.STEP

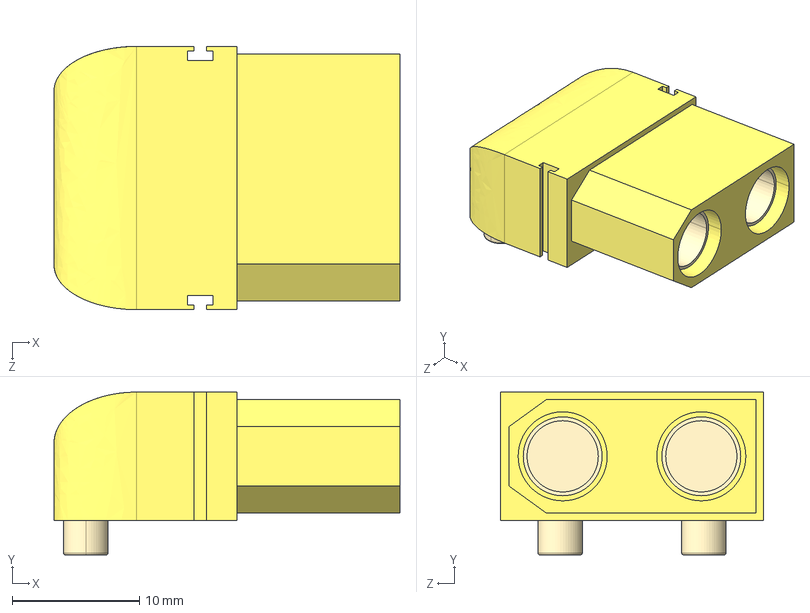
[picture p42: CAD file, 2024-09-16]
Power/GEOX/rev2/SMPS_Motherboard/footprints/connector/Input Voltage/XT90PW-F.STEP
27.2 x 12.8 x 20.7 mm
