EPFLXplore/ERC_AV_HW/Power/GEOX/rev2/SMPS_Motherboard/footprints/connector/ampli/53048-0450.stp

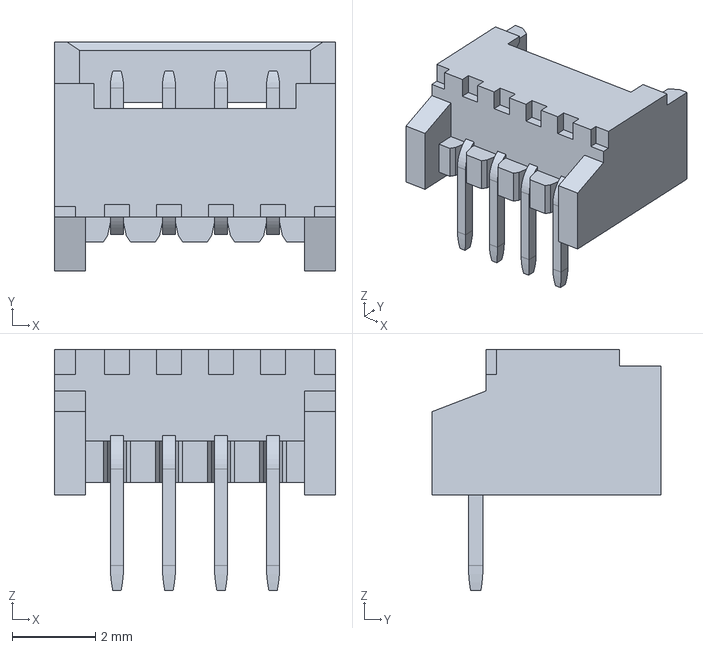
[picture p43: CAD file, 2024-09-16]
Power/GEOX/rev2/SMPS_Motherboard/footprints/connector/ampli/53048-0450.stp
6.75 x 5.50 x 5.80 mm
