EPFLXplore/ERC_AV_HW/(list of files, cad)

Other CAD files:
Power/GEOX/rev2/SMPS_Motherboard/footprints/connector/Board to board/10159558-410421RLF.step
Power/GEOX/rev2/SMPS_Motherboard/footprints/connector/Board to board/10159558-410421RLF.stp
Power/GEOX/rev2/SMPS_Motherboard/footprints/connector/ETH/74980111211_Download_STP_74980111211_rev1.stp
Power/GEOX/rev2/SMPS_Motherboard/footprints/different/fuse/0451015.MRL.stp
