EPFLXplore/ERC_AV_HW/hats/spectrophotometer_interface/plot/spectrophotometer_interface.pdf

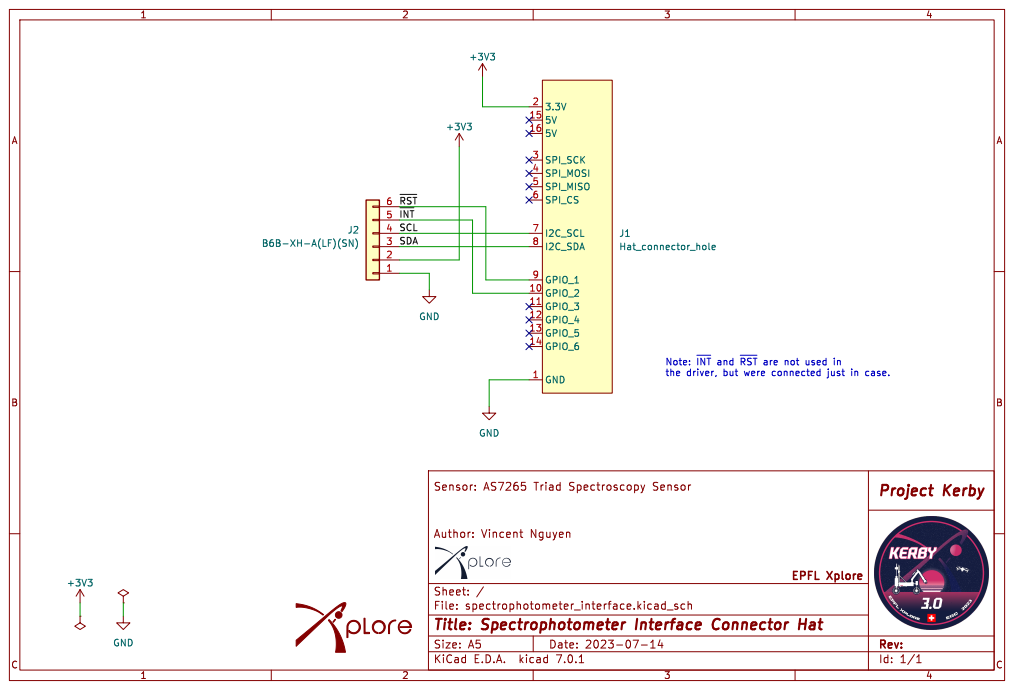
[picture p46: page 1]

SCL ~{INT} SDA 4

2 | I2C_SDA 8 GPIO_1 9
