EPFLXplore/ERC_AV_HW/hats/testing_jig/plot/testing_jig.pdf

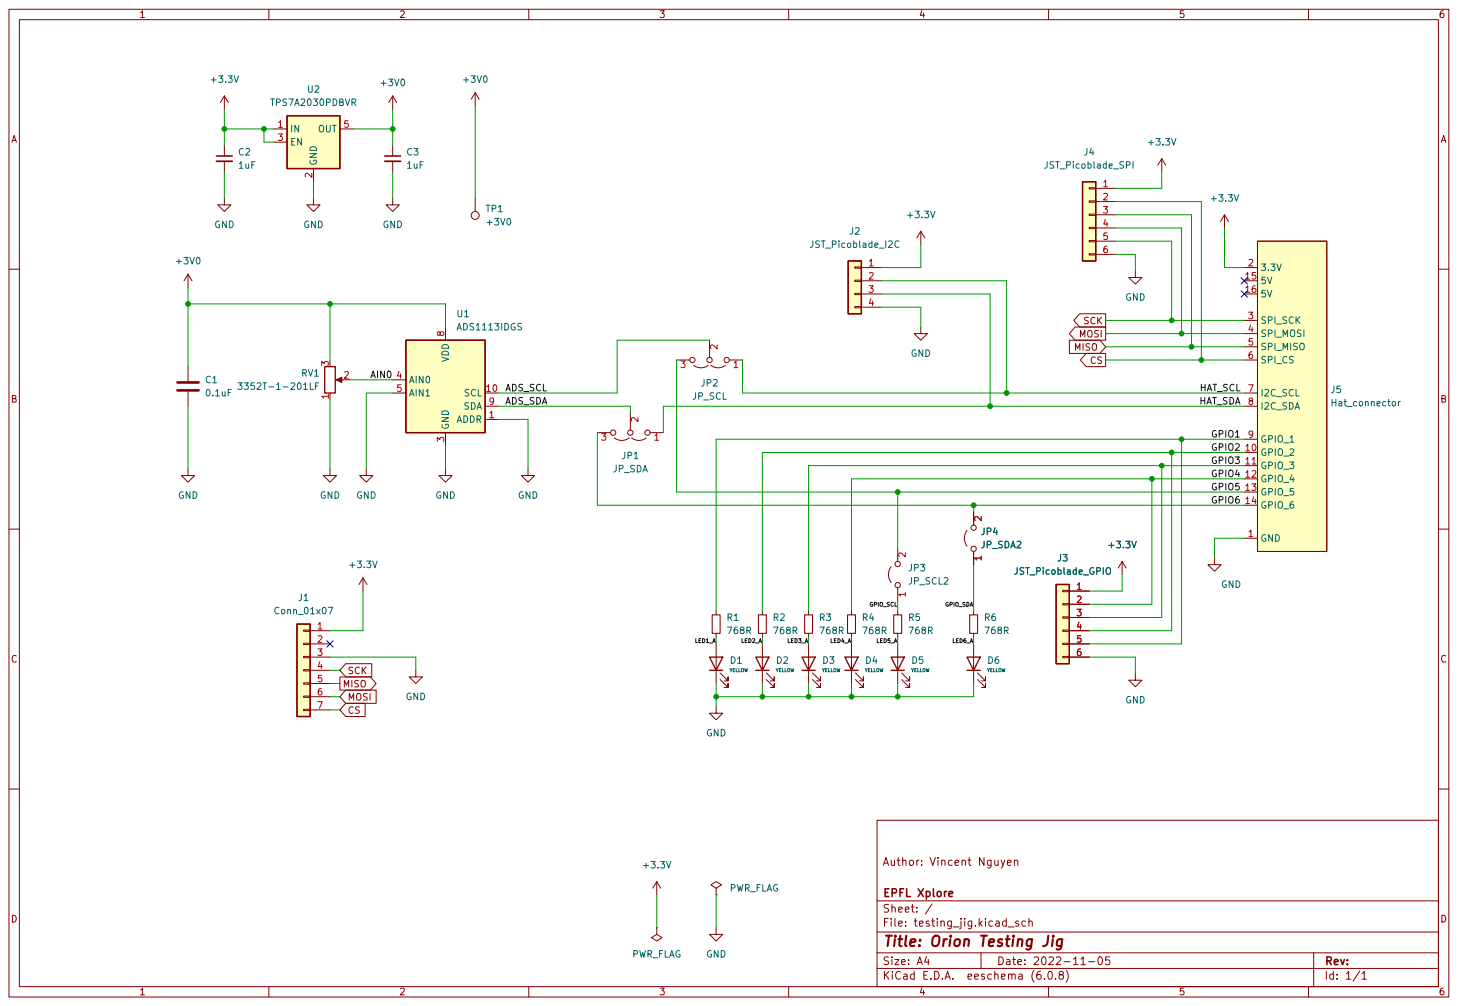
[picture p47: page 1]

File: testing_jig.kicad_sch Sheet: / EPFL Xplore

Id: 1/1 Title: Orion Testing Jig
