EPFLXplore/ERC_AV_HW/hats/new_imu/plot/Xplore ERC IMU.pdf

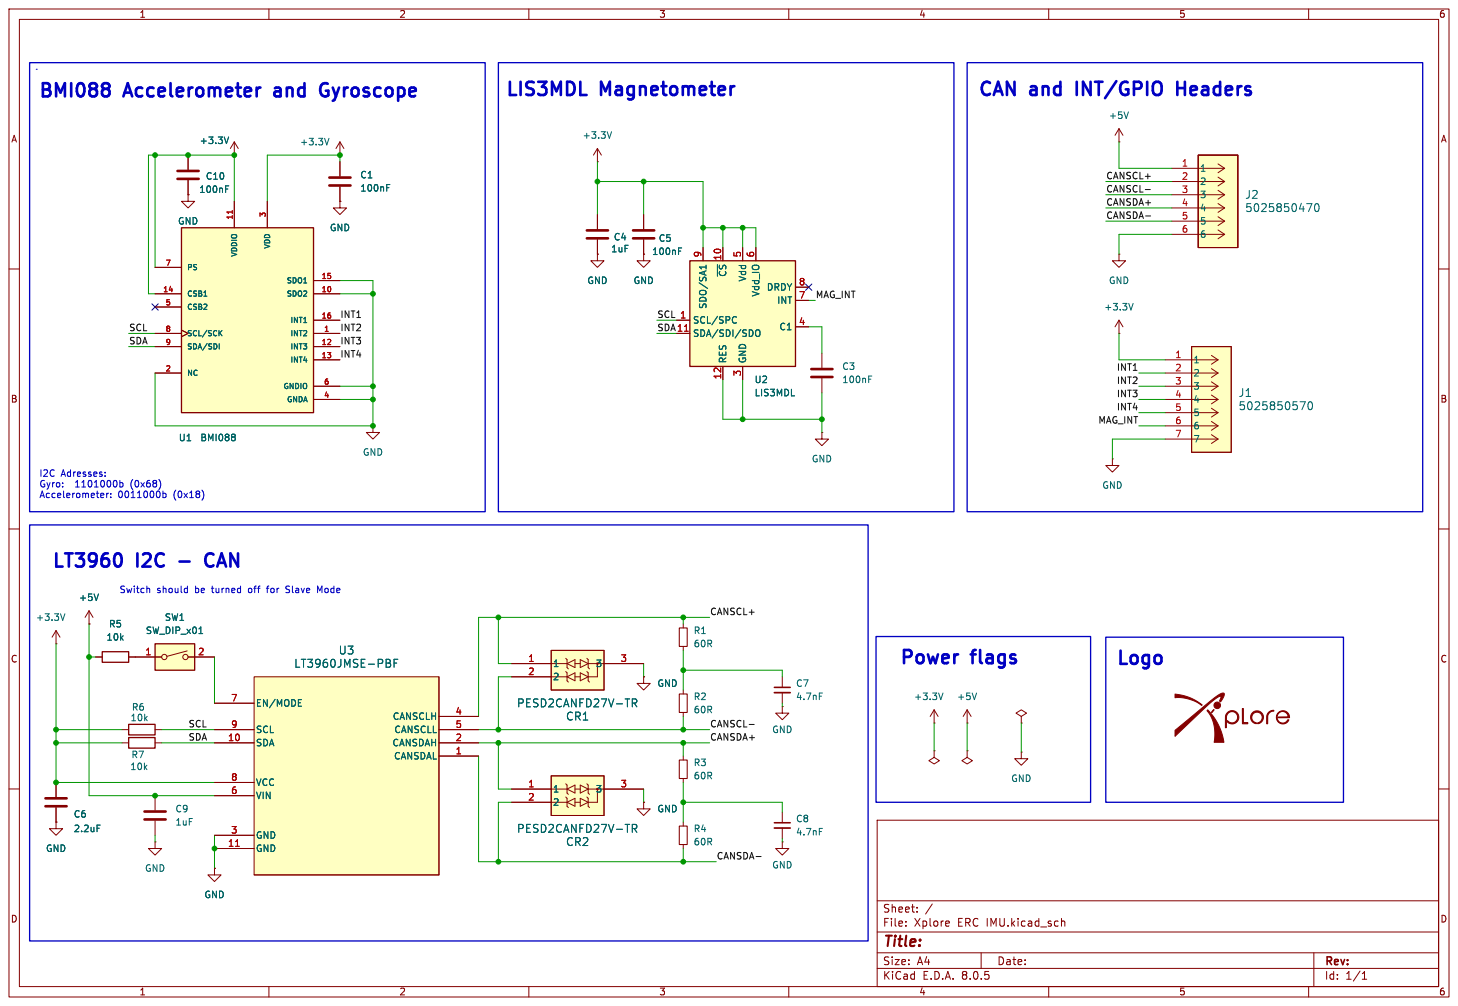
[picture p48: page 1]

CAN and INT/GPIO Headers

3 GNDA 4 CSB2 5 GNDIO 6 PS 7 SCL/SCK 8 SDA/SDI 9 U1 BMI088

3 GNDA 4 CSB2 5 GNDIO 6 PS 7 SCL/SCK 8 SDA/SDI 9 U2

Switch should be turned off for Slave Mode
