EPFLXplore/ERC_AV_HW/hats/new_imu_hat/plot/Xplore ERC IMU HAT.pdf

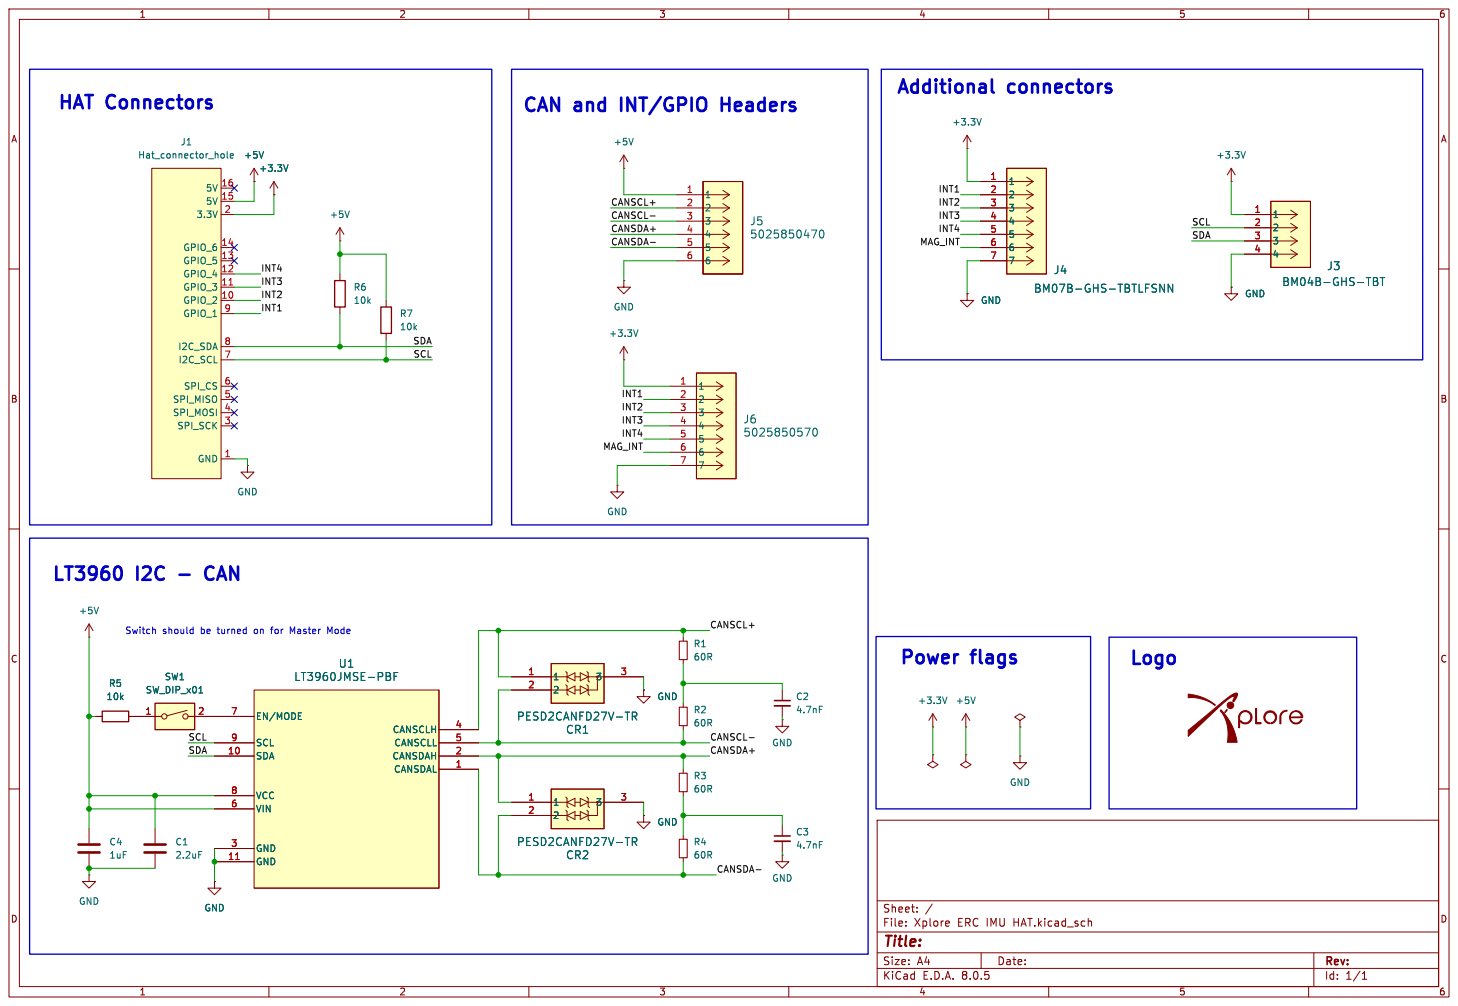
[picture p49: page 1]

CAN and INT/GPIO Headers

Switch should be turned on for Master Mode LT3960 I2C - CAN
