EPFLXplore/ERC_AV_HW/hats/ADS1234_mass_sensor/plot/ADS1234_mass_sensor.pdf

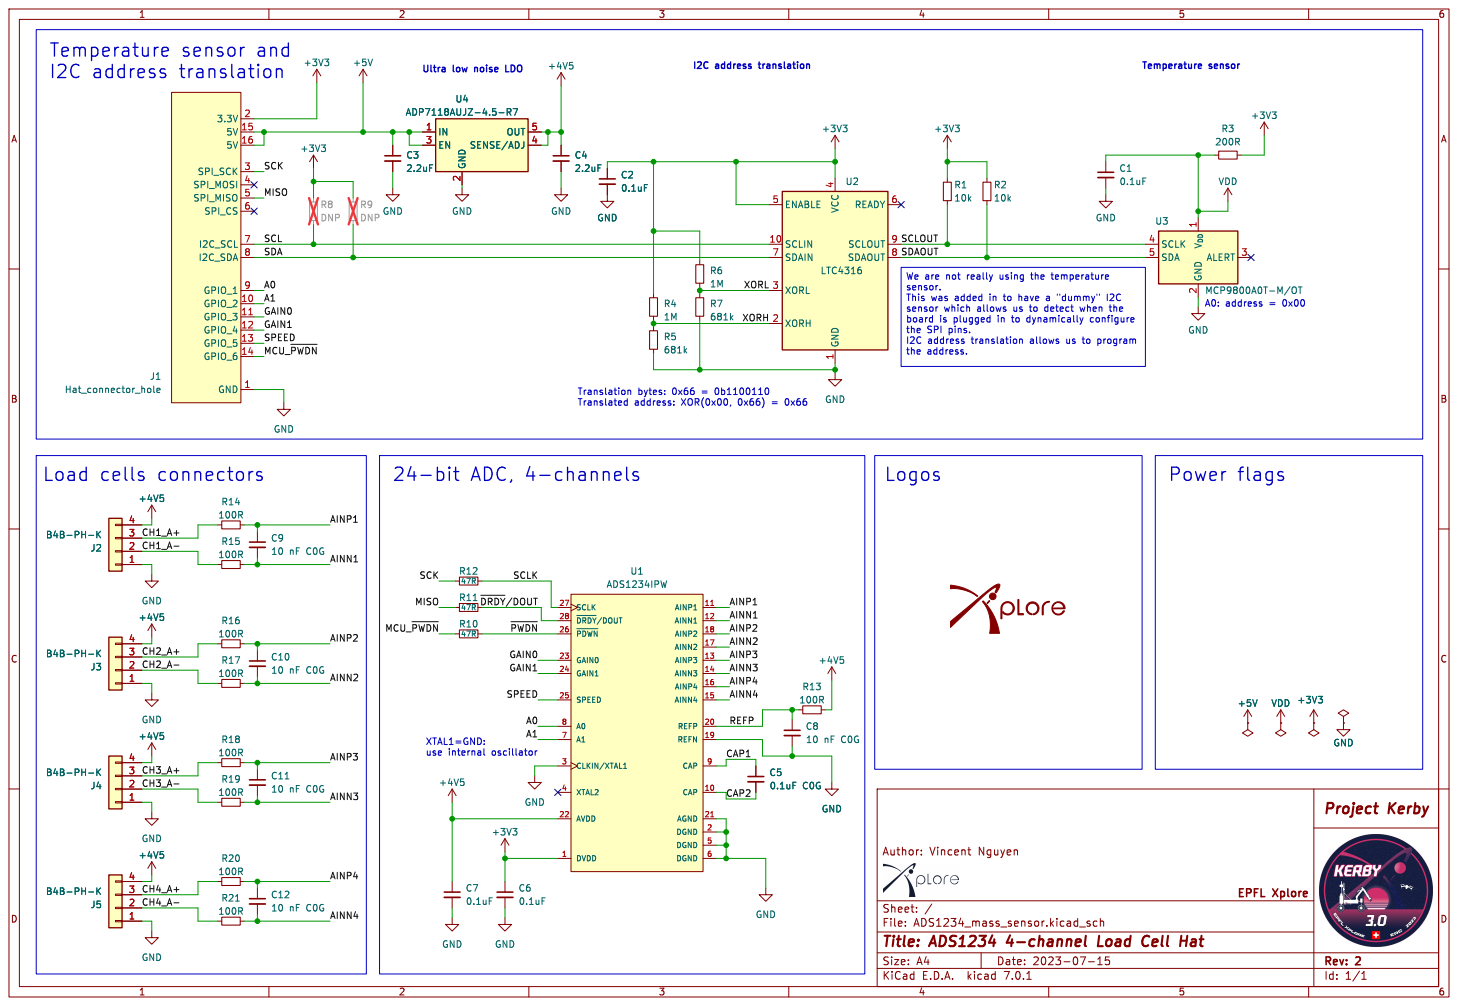
[picture p50: page 1]

Temperature sensor Temperature sensor and

Ultra low noise LDO

2 EN 3 OUT 5 SENSE/ADJ 4 U4 ADP7118AUJZ-4.5-R7 C3

2 EN 3 OUT 5 SENSE/ADJ 4 C3

4 ENABLE 5 READY 6 SDAIN 7 SDAOUT 8 SCLOUT 9 U2

1 SCLIN 10 XORH 2 XORL 3 VCC

2 ALERT 3 SCLK 4 SDA 5 U3 MCP9800A0T-M/OT GND GND

We are not really using the temperature

sensor which allows us to detect when the
the SPI pins.
