EPFLXplore/ERC_AV_HW/hats/imu_9_axis/plot/imu_9_axis.pdf

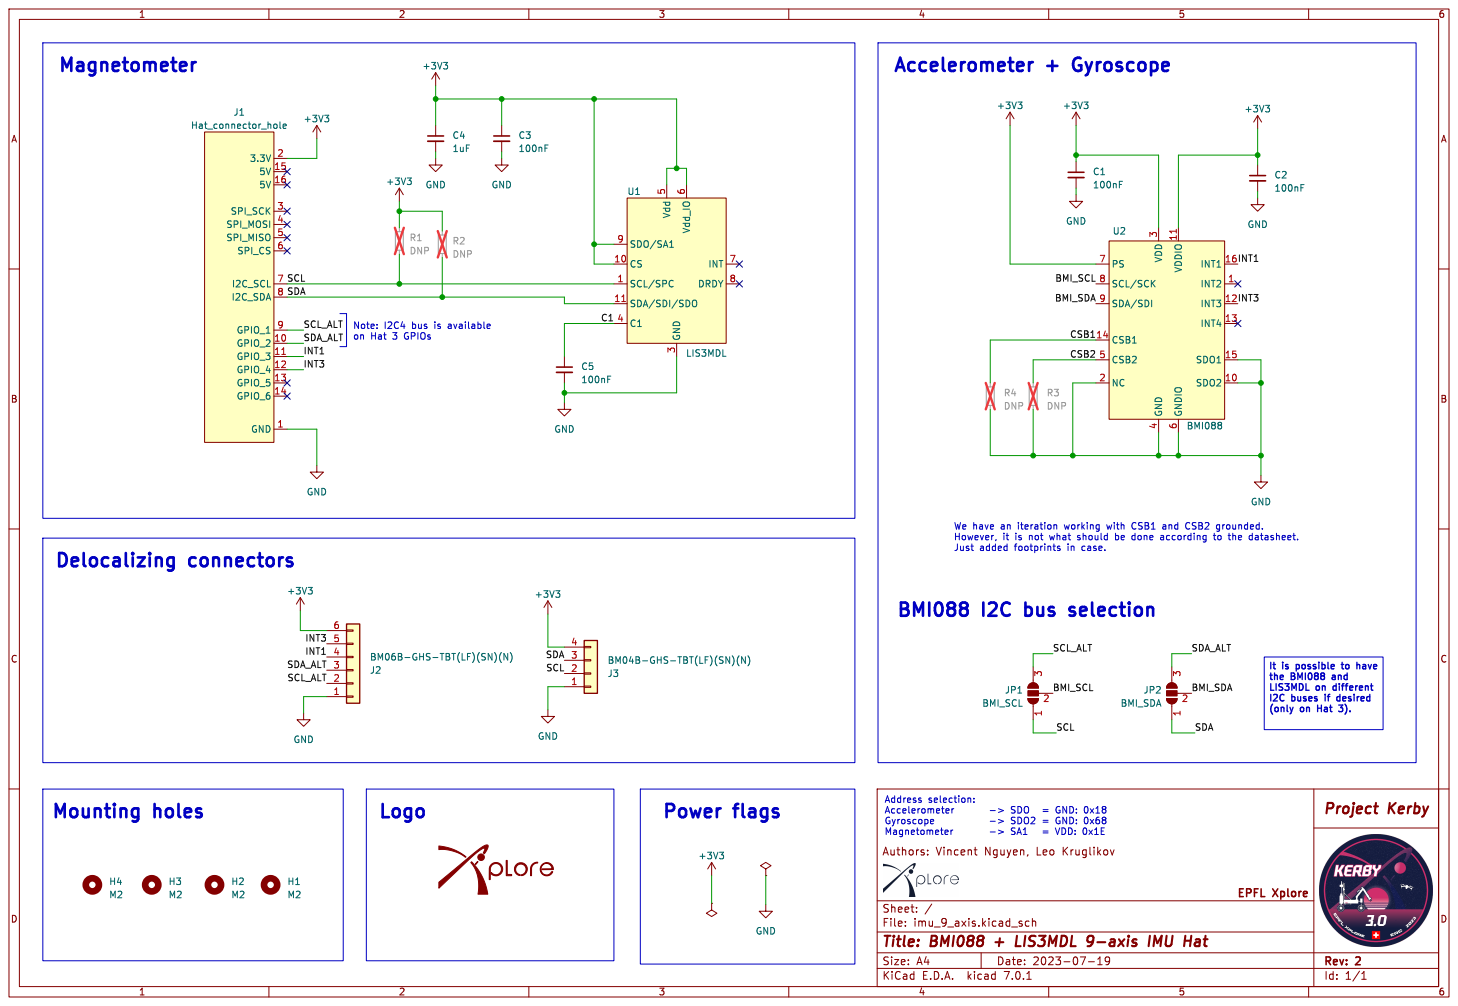
[picture p51: page 1]

6 PS 7 SCL/SCK 8 SDA/SDI 9 U2 BMI088 +3V3 GND GND

J3BM04B-GHS-TBT(LF)(SN)(N) SDA

Note: I2C4 bus is available
on Hat 3 GPIOs

It is possible to have
the BMI088 and
LIS3MDL on different
I2C buses if desired
(only on Hat 3).
