EPFLXplore/ERC_AV_HW/hats/RS485_interface/plot/RS485_interface.pdf

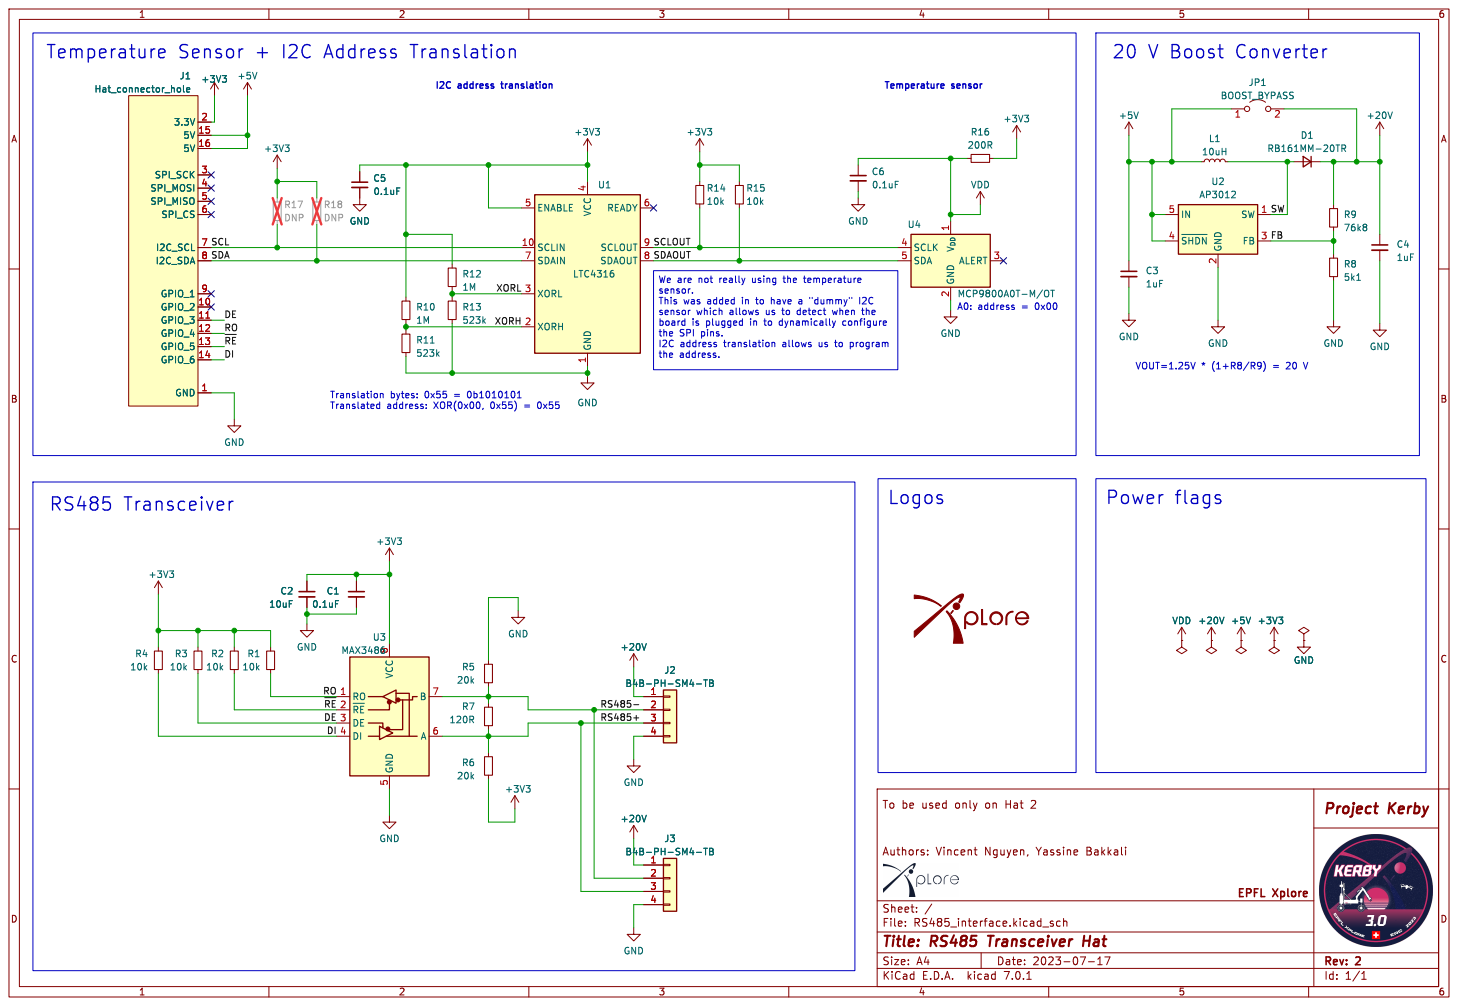
[picture p52: page 1]

20 V Boost Converter We are not really using the temperature

4 ENABLE 5 READY 6 SDAIN 7 SDAOUT 8 SCLOUT 9 U1

2 ALERT 3 SCLK 4 SDA 5 U4 MCP9800A0T-M/OT VDD

1 SCLIN 10 XORH 2 XORL 3 VCC

sensor which allows us to detect when the
the SPI pins.
