EPFLXplore/ERC_AV_HW/hats/servo_level_shifter/plot/servo_level_shifter.pdf

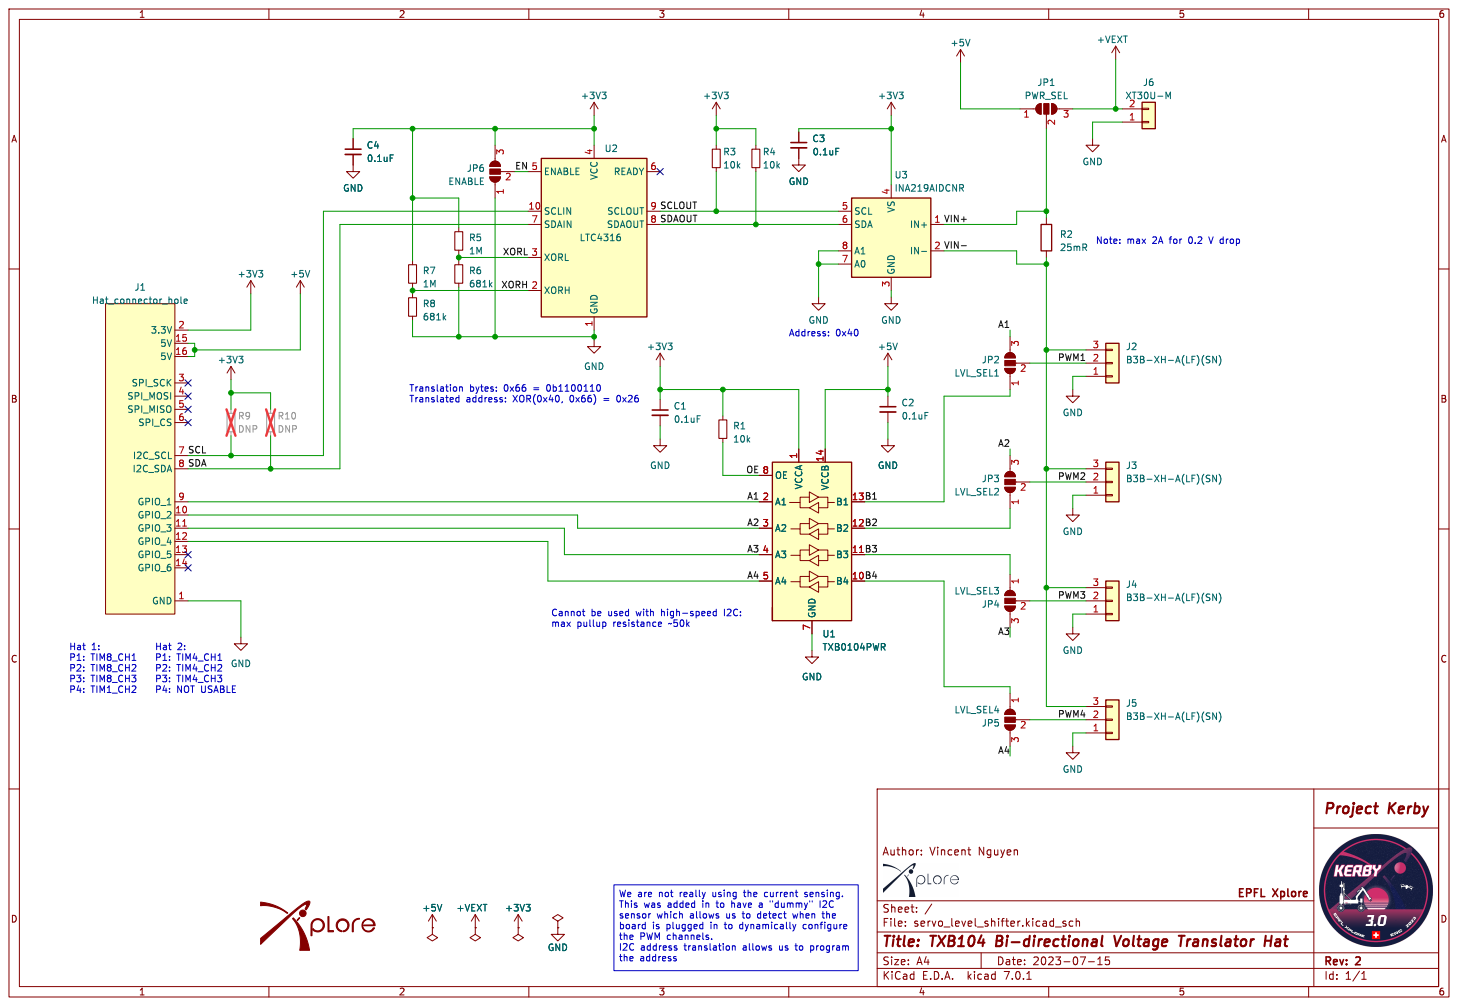
[picture p53: page 1]

4 ENABLE 5 READY 6 SDAIN 7 SDAOUT 8 SCLOUT 9 U2
VIN- VIN+ XORL EN

1 SCLIN 10 XORH 2 XORL 3 VCC

7 OE 8 GND GND GND GND

sensor which allows us to detect when the
the PWM channels.
