EPFLXplore/ERC_AV_HW/hats/voltmeterv2/plot/voltmeter.pdf

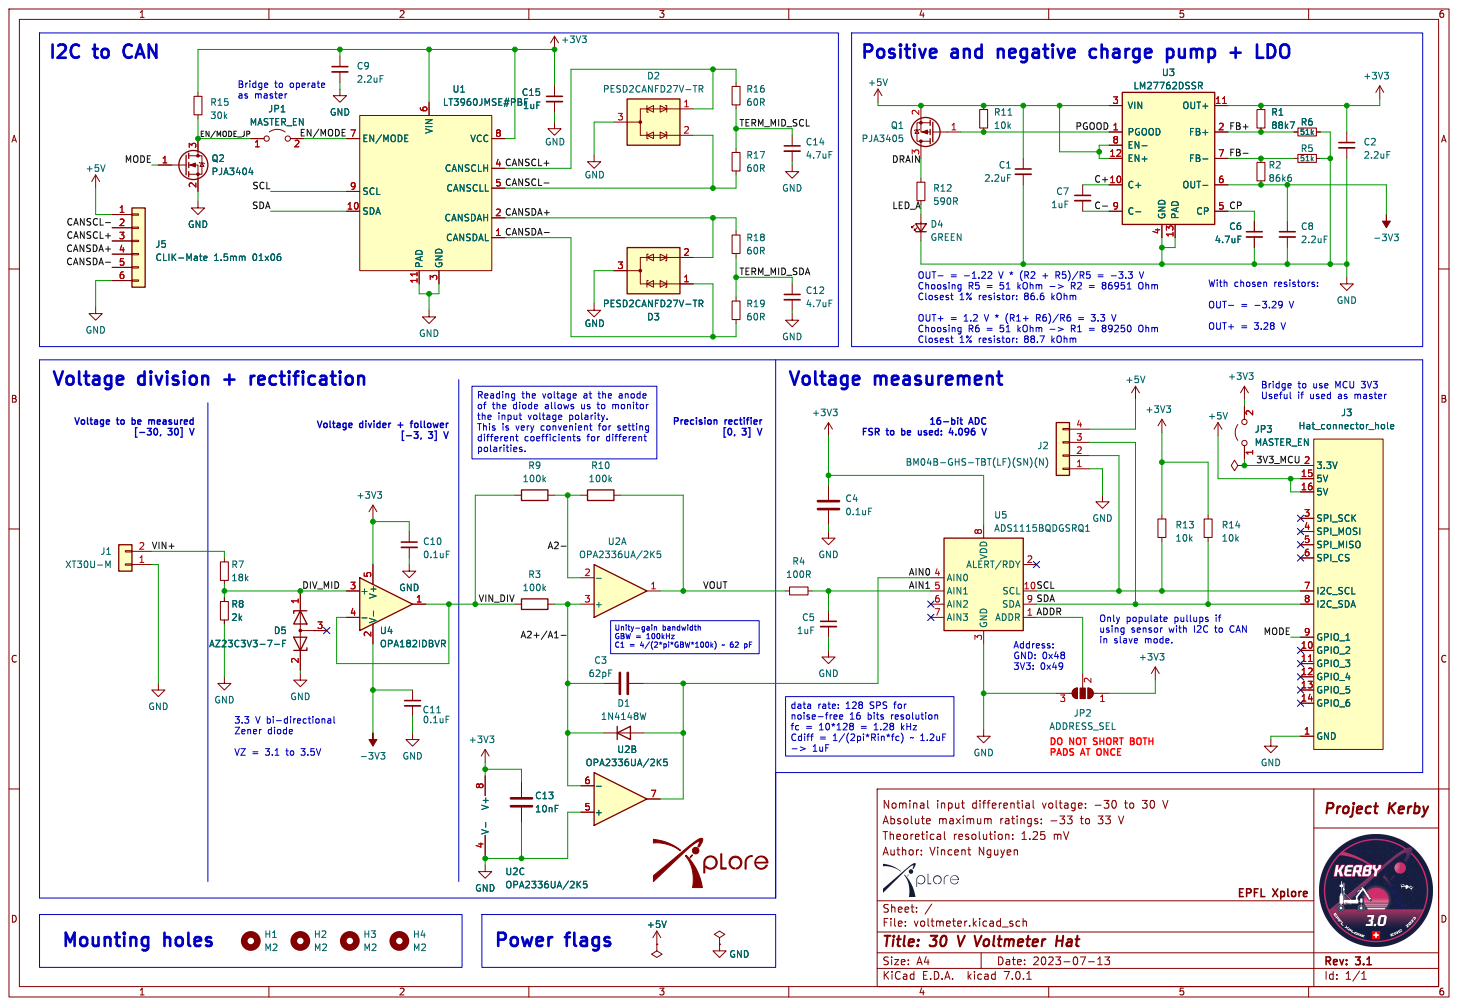
[picture p54: page 1]

FSR to be used: 4.096 V Positive and negative charge pump + LDO

4 CP 5 OUT- 6 FB- 7 EN- 8 C- 9 U3
LM27762DSSR

6 EN/MODE 7 VCC 8 SCL 9 U1
1uF GND

6 EN/MODE 7 VCC 8 SCL 9 GND

4 CP 5 OUT- 6 FB- 7 EN- 8 C- 9

Voltage to be measured

in slave mode. DO NOT SHORT BOTH

3.3 V bi-directional Zener diode VZ = 3.1 to 3.5V
