EPFLXplore/ERC_AV_HW/node_pcb/orion_power/plot/orion_power.pdf

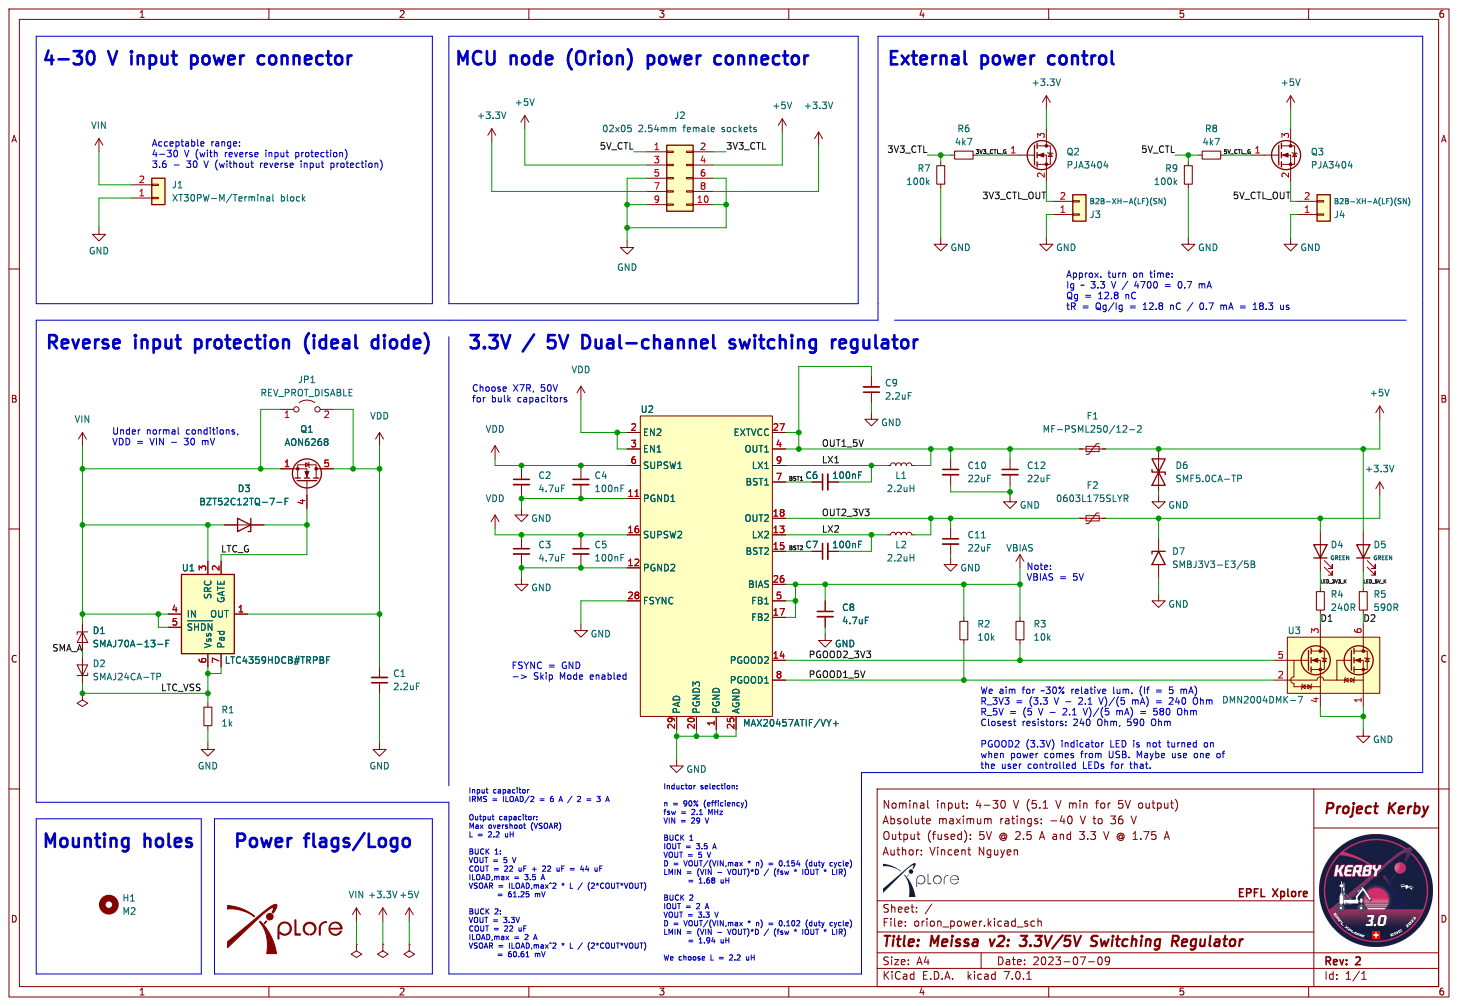
[picture p55: page 1]

02x05 2.54mm female sockets GND GND

tR = Qg/Ig = 12.8 nC / 0.7 mA = 18.3 us MCU node (Orion) power connector

External power control Choose X7R, 50V

IRMS = ILOAD/2 = 6 A / 2 = 3 A Power flags/Logo

BUCK 1: VOUT = 5 V COUT = 22 uF + 22 uF = 44 uF

ILOAD,max = 3.5 A
VSOAR = ILOAD,max^2 * L / (2*COUT*VOUT) = 61.25 mV

BUCK 2: VOUT = 3.3V COUT = 22 uF
