EPFLXplore/ERC_AV_HW/hats/new_imu/plot/New IMU.pdf

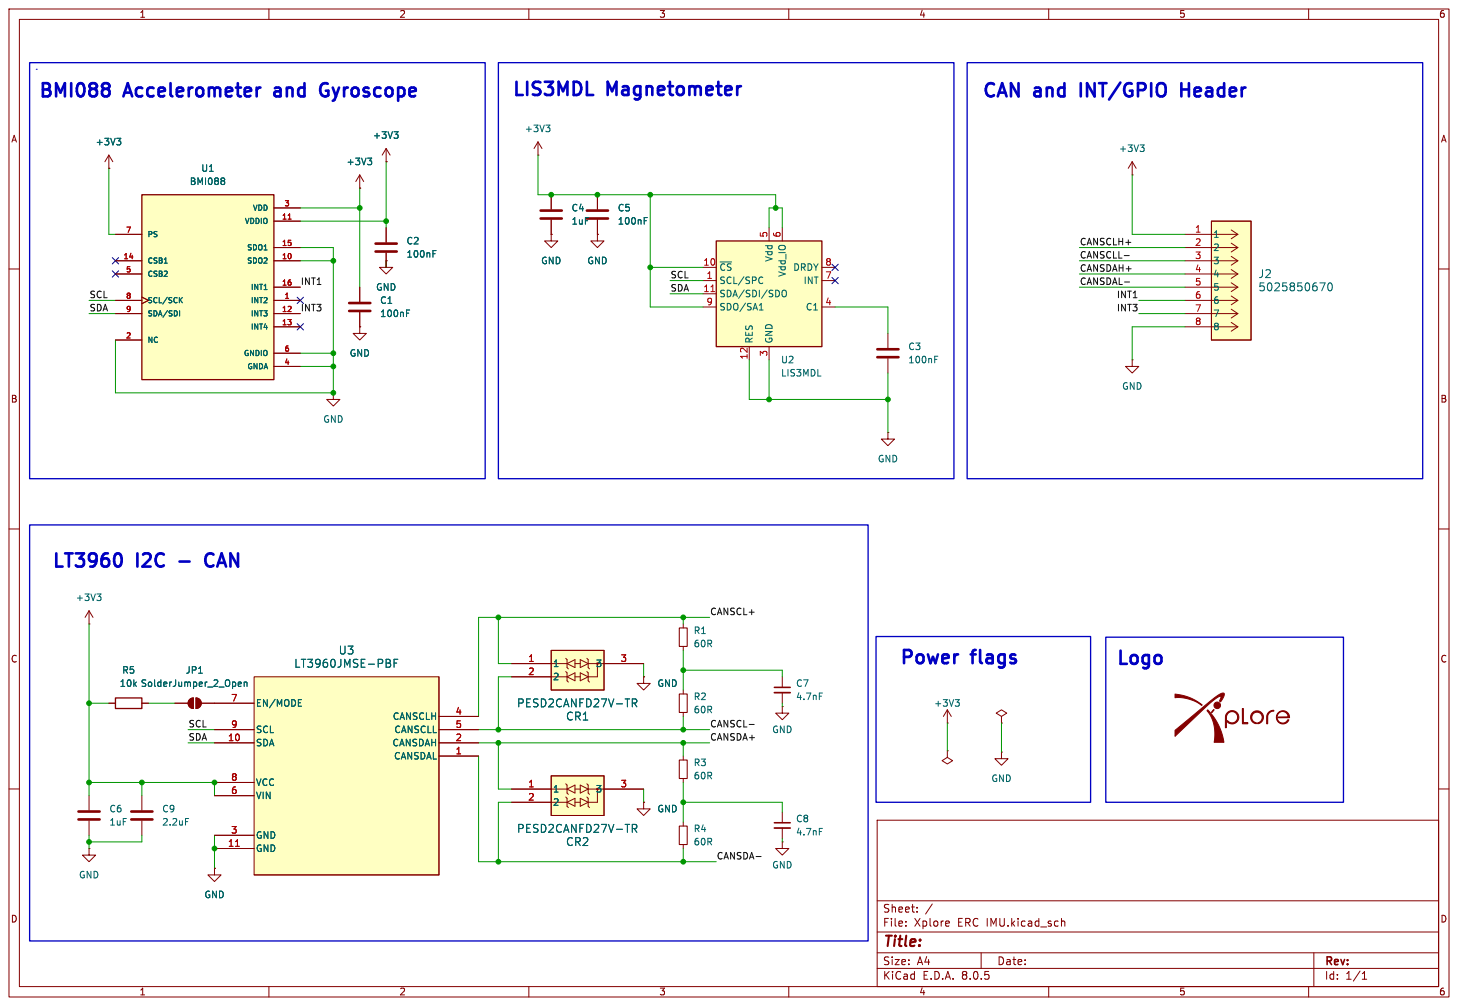
[picture p56: page 1]
