EPFLXplore/ERC_AV_HW/hats/new_imu_hat/plot/New IMU HAT.pdf

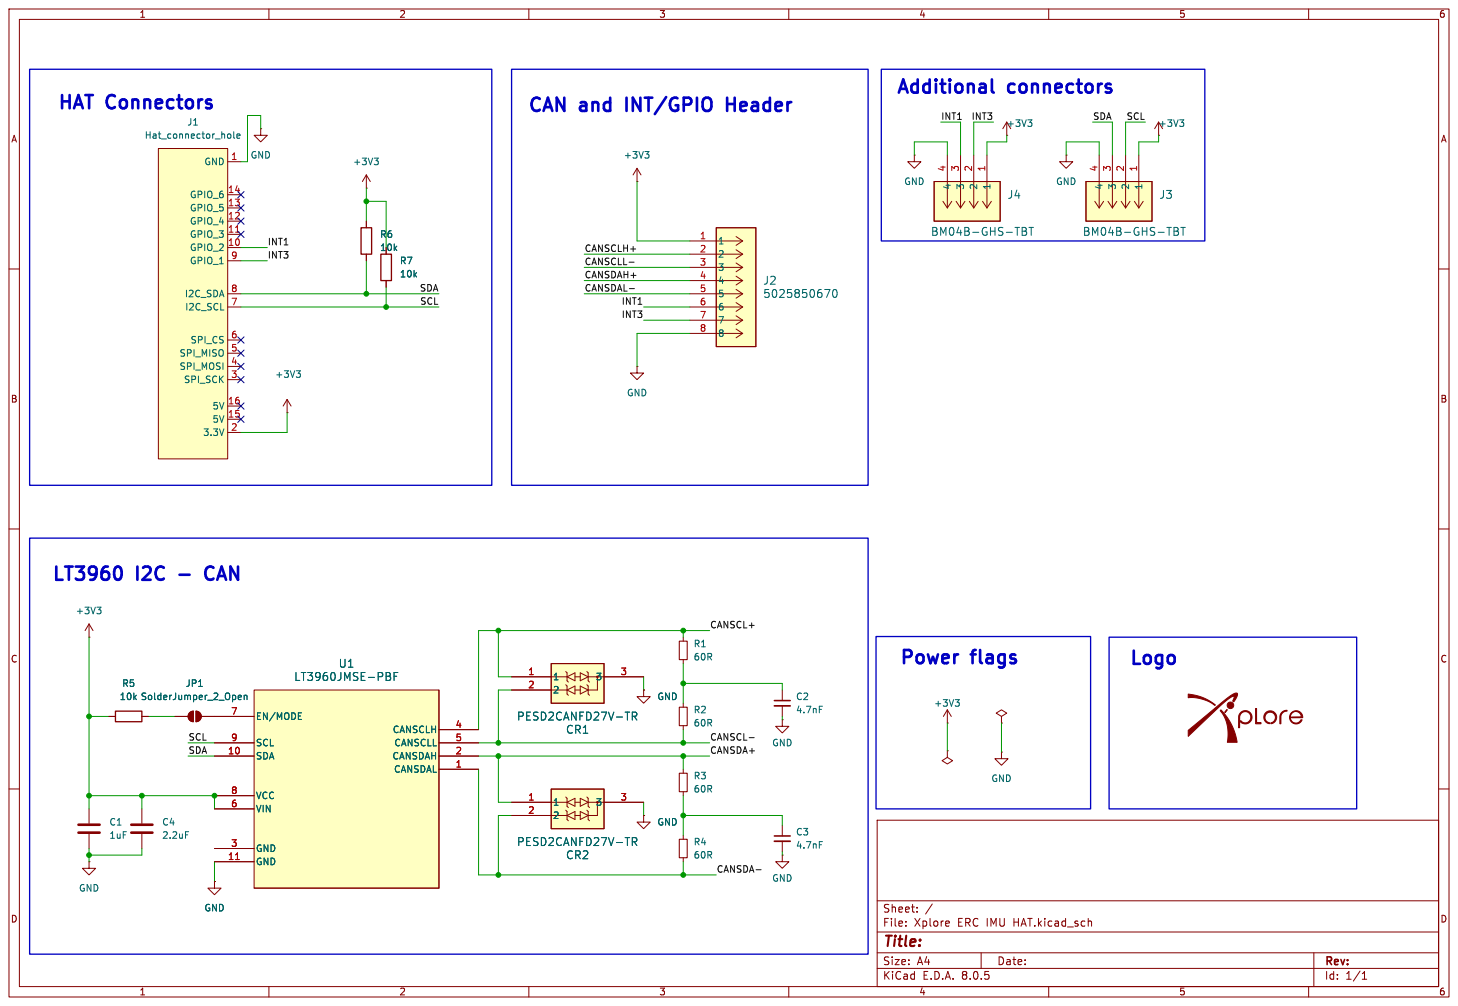
[picture p57: page 1]

CAN and INT/GPIO Header

CANSDAL- CANSDAH+ CANSCLL- CANSCLH+
