EPFLXplore/ERC_AV_HW/hats/ADS1115_POTENTIOMETER/plot/ADS1115_POTENTIOMETER.pdf

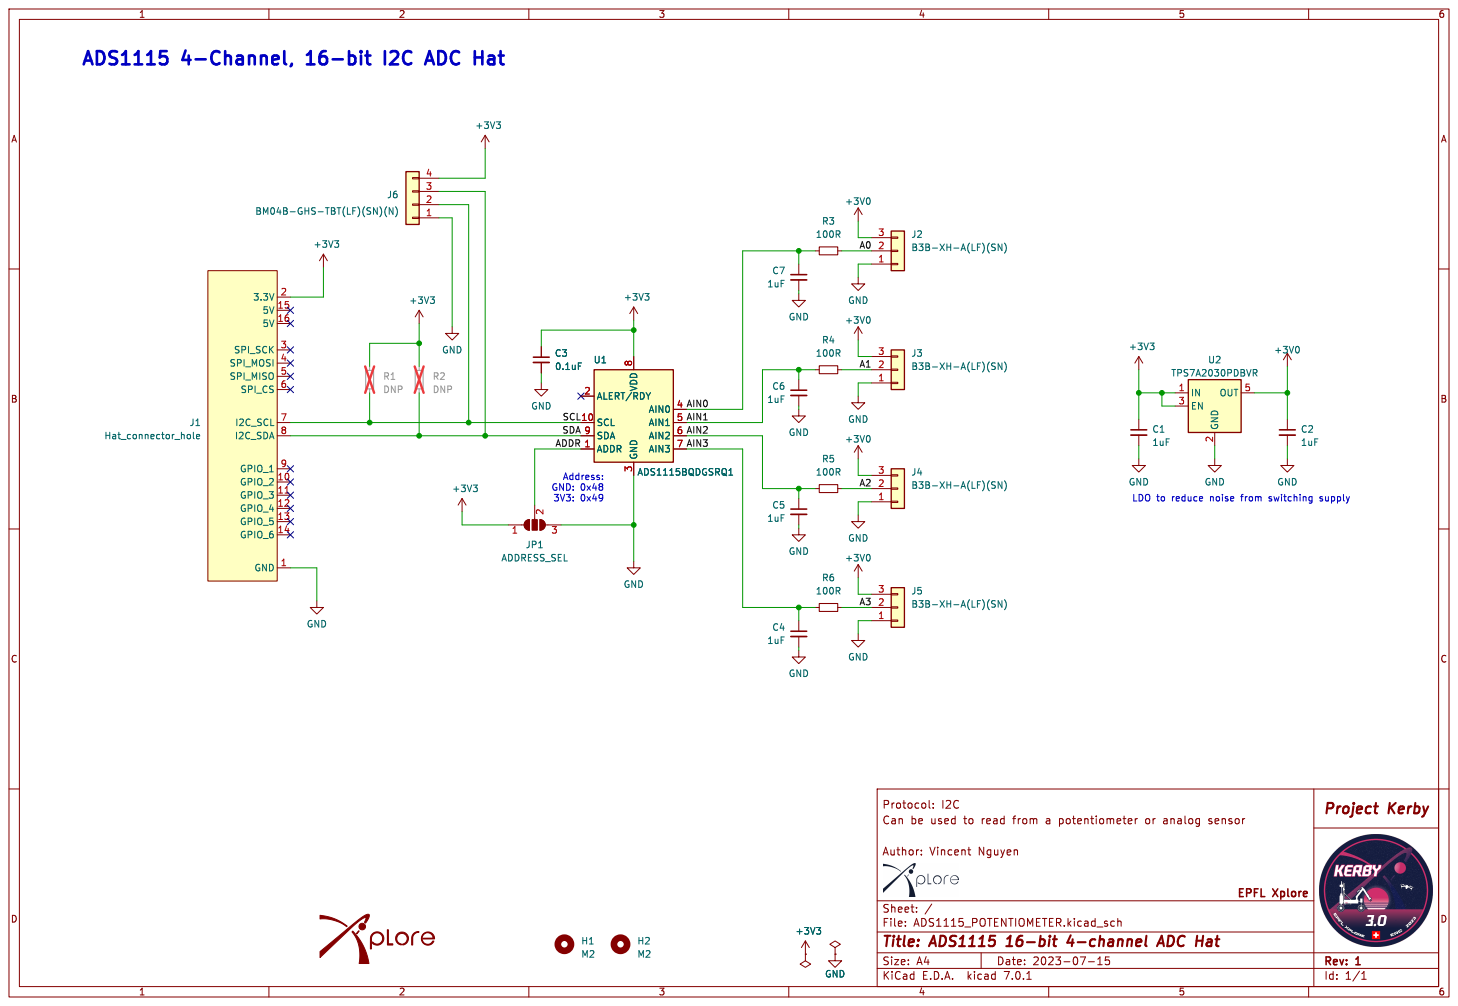
[picture p58: page 1]
