EPFLXplore/ERC_AV_HW/hats/load_cell_connector_interface/plot/load_cell_connector_interface.pdf

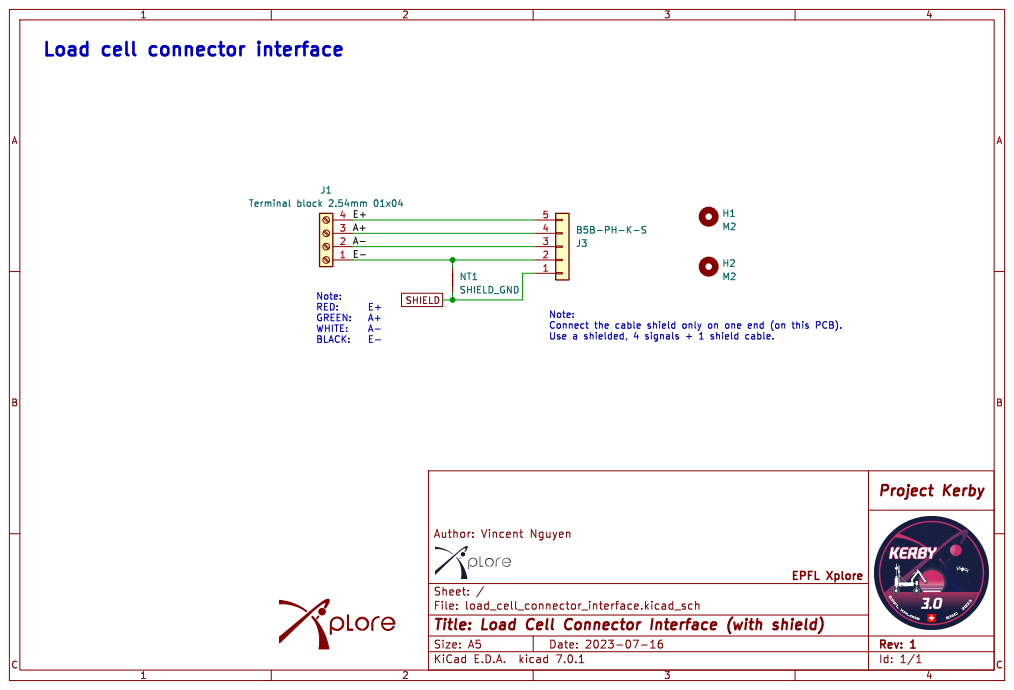
[picture p59: page 1]
