EPFLXplore/ERC_AV_HW/hats/voltmeterv2/spice/voltmeter.asc

C1: cap; 62p
C2: cap; 1µ
D1: diode; 1N4148
R1: res; 100k; tol=1
R2: res; 1k; tol=0.05 pwr=1m
R3: res; 9k; tol=0.05 pwr=100m
R4: res; 100k; tol=0.05 pwr=1m
R5: res; 100k; tol=0.05 pwr=1m
R6: res; 100
U1: opamp2; OPAx336
U2: opamp2; OPAx336
V2: voltage; 3.0
VIN: voltage; 24
Named nets: 0, VIN, VIN_DIV, VOUT, AIN0, 3V0, A1+, A2OUT, A1-
.include C:\\Program Files\\LTC\\LTspiceXVII\\lib\\sub\\OPAx336.LIB
.include C:\\Program Files\\LTC\\LTspiceXVII\\lib\\sub\\1n4148w.lib
.op
