EPFLXplore/ERC_AV_HW/(list of files, drawings)

Other design files:
hats/Meriem_Eliot_IMU.SchDoc
