EPFLXplore/ERC_AV_HW/Power/ElonMux/ElonMux.kicad_pcb

## KiCad design Power/ElonMux/ElonMux.kicad_pcb (continued)

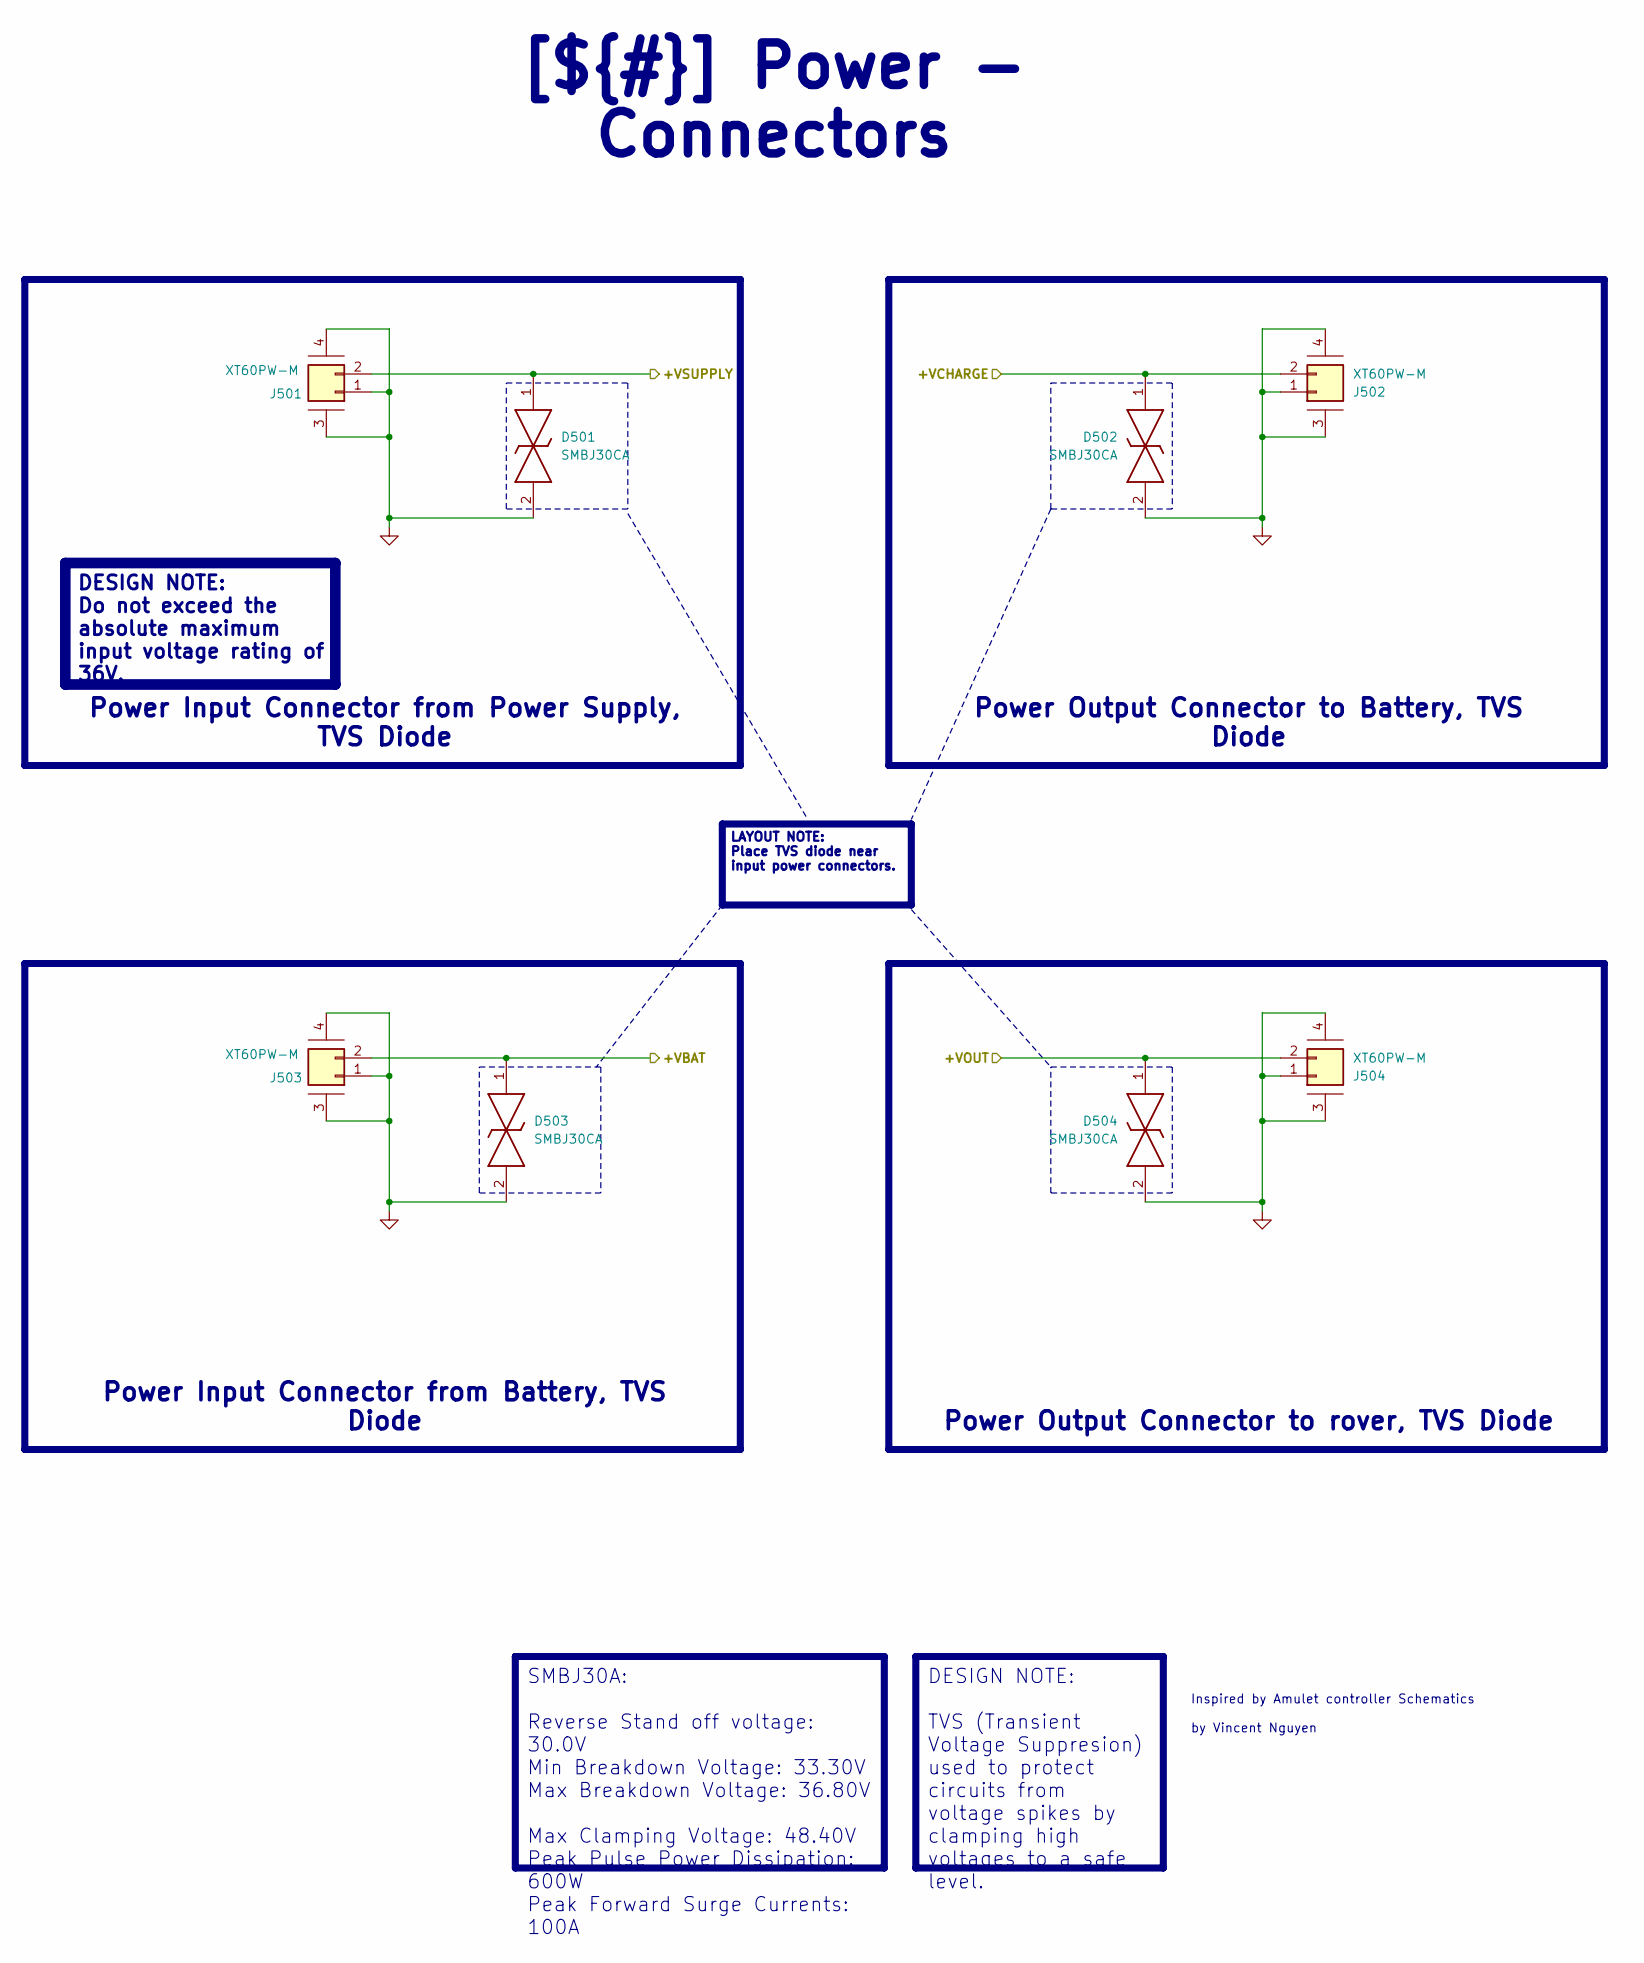
[picture p68: schematic Power - Connectors.kicad_sch]

Parts:
D501, D502, D503, D504: SMBJ30CA; DIOM5436X244N; Manufacturer Part Number SMBJ30CA
J501, J502, J503, J504: XT60PW-M; AMASS_XT60PW-M_1x02_P7.20mm_Horizontal; Manufacturer Part Number XT60PW-M

Connections:
+VBAT: D503.1, J503.2; also elsewhere on the board
+VCHARGE: D502.1, J502.2; also elsewhere on the board
+VSUPPLY: D501.1, J501.2; also elsewhere on the board
/Project Architecture/Power - Generation/+VOUT: D504.1, J504.2; also elsewhere on the board
GND: D501.2, D502.2, D503.2, D504.2, J501.1, J501.3 (MP1), J501.4 (MP2), J502.1, J502.3 (MP1), J502.4 (MP2), J503.1, J503.3 (MP1), J503.4 (MP2), J504.1, J504.3 (MP1), J504.4 (MP2); also elsewhere on the board

Notes on the sheet:
SMBJ30A: Reverse Stand off voltage: 30.0V Min Breakdown Voltage: 33.30V Max Breakdown Voltage: 36.80V Max Clamping Voltage: 48.40V Peak Pulse Power Dissipation: 600W Peak Forward Surge Currents: 100A
DESIGN NOTE: Do not exceed the absolute maximum input voltage rating of 36V.
LAYOUT NOTE: Place TVS diode near input power connectors.
Power Output Connector to Battery, TVS Diode
Power Input Connector from Battery, TVS Diode
Power Output Connector to rover, TVS Diode
[${#}] ${TITLE}
Power Input Connector from Power Supply, TVS Diode
DESIGN NOTE: TVS (Transient Voltage Suppresion) used to protect circuits from voltage spikes by clamping high voltages to a safe level.
Inspired by Amulet controller Schematics by Vincent Nguyen

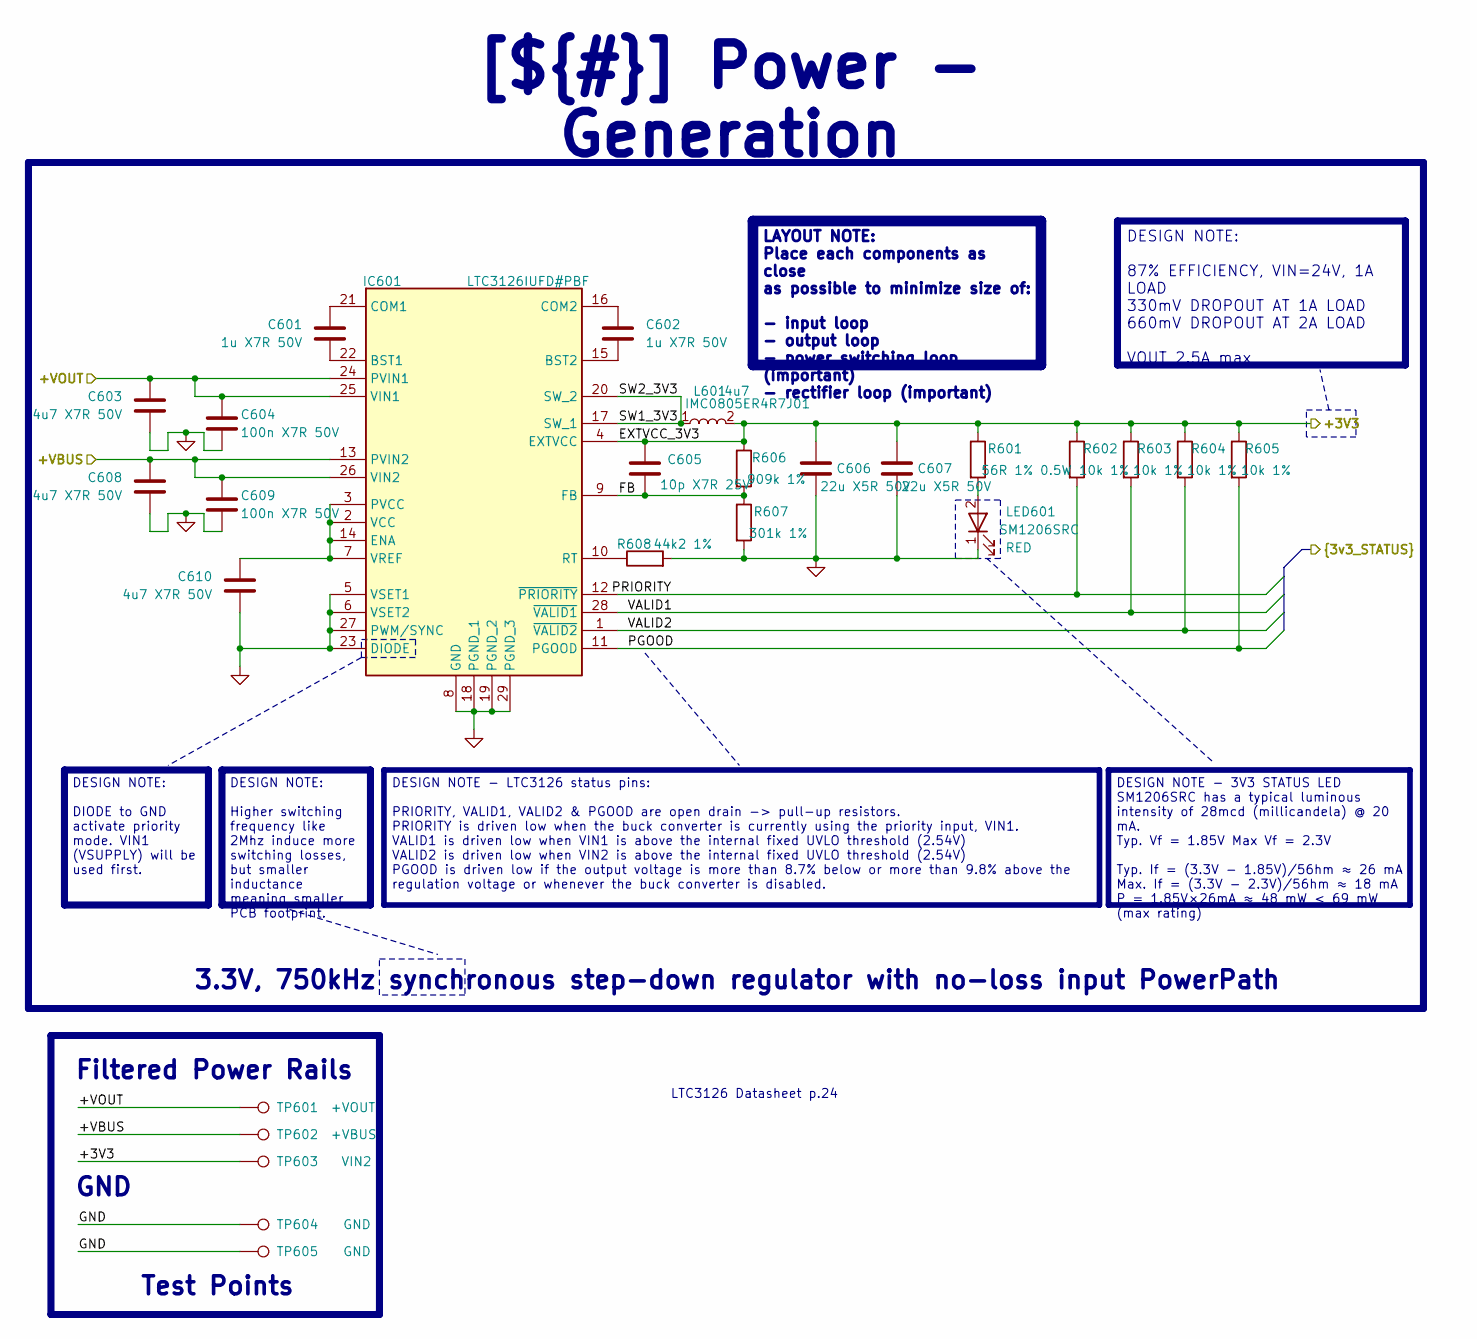
[picture p69: schematic Power - Generation.kicad_sch]

Parts:
C601, C602: 1u X7R 50V; C_0603_1608Metric; Manufacturer Part Number CC0603KRX7R9BB105
C603, C608, C610: 4u7 X7R 50V; C_0805_2012Metric; Manufacturer Part Number CGA4J1X7R1H475K125AC
C604, C609: 100n X7R 50V; C_0402_1005Metric; Manufacturer Part Number UMK105B7104KVHF
C605: 10p X7R 25V; C_0603_1608Metric; Manufacturer Part Number 06033C100KAT2A
C606, C607: 22u X5R 50V; C_0603_1608Metric; Manufacturer Part Number GRT188R61A226ME13D
IC601: LTC3126IUFD#PBF; LTC3126EUFD; Manufacturer Part Number LTC3126IUFD#PBF
L601: 4u7; L_0805_2012Metric; Manufacturer Part Number IMC0805ER4R7J01
LED601: RED; LED_1206_3216Metric; Manufacturer Part Number SM1206SRC
R601: 56R 1% 0.5W; R_0805_2012Metric_Pad1.20x1.40mm_HandSolder; Manufacturer Part Number SG73P2ATTD56R0F
R602, R603, R604, R605: 10k 1%; R_0402_1005Metric; Manufacturer Part Number SG73P1EWTTP1002F
R606: 909k 1%; R_0805_2012Metric_Pad1.20x1.40mm_HandSolder; Manufacturer Part Number ERJ-P06F9093V
R607: 301k 1%; R_0805_2012Metric_Pad1.20x1.40mm_HandSolder; Manufacturer Part Number RK73H2ATTD3013F
R608: 44k2 1%; R_0402_1005Metric; Manufacturer Part Number ERJ-2RKF4422X
TP601: +VOUT; TestPoint_Pad_D1.0mm
TP602: +VBUS; TestPoint_Pad_D1.0mm
TP603: VIN2; TestPoint_Pad_D1.0mm
TP604, TP605: GND; TestPoint_Pad_D1.0mm

Connections:
+3V3: C605.1, C606.2, C607.2, IC601.4 (EXTVCC), L601.2, R601.1, R602.1, R603.1, R604.1, R605.1, R606.1, TP603.1; also elsewhere on the board
+VBUS: C608.1, C609.1, IC601.13 (PVIN2), IC601.26 (VIN2), TP602.1; also elsewhere on the board
/Project Architecture/MCU - Unit/PGOOD: IC601.11 (PGOOD), R605.2; also elsewhere on the board
/Project Architecture/MCU - Unit/PRIORITY: IC601.12 (~PRIORITY), R602.2; also elsewhere on the board
/Project Architecture/MCU - Unit/VALID1: IC601.28 (~VALID1), R603.2; also elsewhere on the board
/Project Architecture/MCU - Unit/VALID2: IC601.1 (~VALID2), R604.2; also elsewhere on the board
/Project Architecture/Power - Generation/+VOUT: C603.1, C604.1, IC601.24 (PVIN1), IC601.25 (VIN1), TP601.1; also elsewhere on the board
/Project Architecture/Power - Generation/FB: C605.2, IC601.9 (FB), R606.2, R607.1
/Project Architecture/Power - Generation/SW1_3V3: IC601.17 (SW_1), IC601.20 (SW_2), L601.1
GND: C603.2, C604.2, C606.1, C607.1, C608.2, C609.2, C610.2, IC601.5 (VSET1), IC601.6 (VSET2), IC601.8 (GND), IC601.18 (PGND_1), IC601.19 (PGND_2), IC601.23 (DIODE), IC601.27 (PWM/SYNC), IC601.29 (PGND_3), LED601.1 (K), R607.2, R608.2, TP604.1, TP605.1; also elsewhere on the board
unnamed: C601.2, IC601.22 (BST1)
unnamed: C602.2, IC601.15 (BST2)
unnamed: C601.1, IC601.21 (COM1)
unnamed: C602.1, IC601.16 (COM2)
unnamed: C610.1, IC601.2 (VCC), IC601.3 (PVCC), IC601.7 (VREF), IC601.14 (ENA)
unnamed: IC601.10 (RT), R608.1
unnamed: LED601.2 (A), R601.2

Notes on the sheet:
DESIGN NOTE: Higher switching frequency like 2Mhz induce more switching losses, but smaller inductance meaning smaller PCB footprint.
Test Points
LAYOUT NOTE: Place each components as close as possible to minimize size of: - input loop - output loop - power switching loop (important) - rectifier loop (important)
GND
Filtered Power Rails
DESIGN NOTE - 3V3 STATUS LED SM1206SRC has a typical luminous intensity of 28mcd (millicandela) @ 20 mA. Typ. Vf = 1.85V Max Vf = 2.3V Typ. If = (3.3V - 1.85V)/56hm ≈ 26 mA Max. If = (3.3V - 2.3V)/56hm ≈ 18 mA P = 1.85V×26mA ≈ 48 mW < 69 mW (max rating)
[${#}] ${TITLE}
DESIGN NOTE - LTC3126 status pins: PRIORITY, VALID1, VALID2 & PGOOD are open drain -> pull-up resistors. PRIORITY is driven low when the buck converter is currently using the priority input, VIN1. VALID1 is driven low when VIN1 is above the internal fixed UVLO threshold (2.54V) VALID2 is driven low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
DESIGN NOTE: DIODE to GND activate priority mode. VIN1 (VSUPPLY) will be used first.
3.3V, 750kHz synchronous step-down regulator with no-loss input PowerPath
DESIGN NOTE: 87% EFFICIENCY, VIN=24V, 1A LOAD 330mV DROPOUT AT 1A LOAD 660mV DROPOUT AT 2A LOAD VOUT 2.5A max
LTC3126 Datasheet p.24

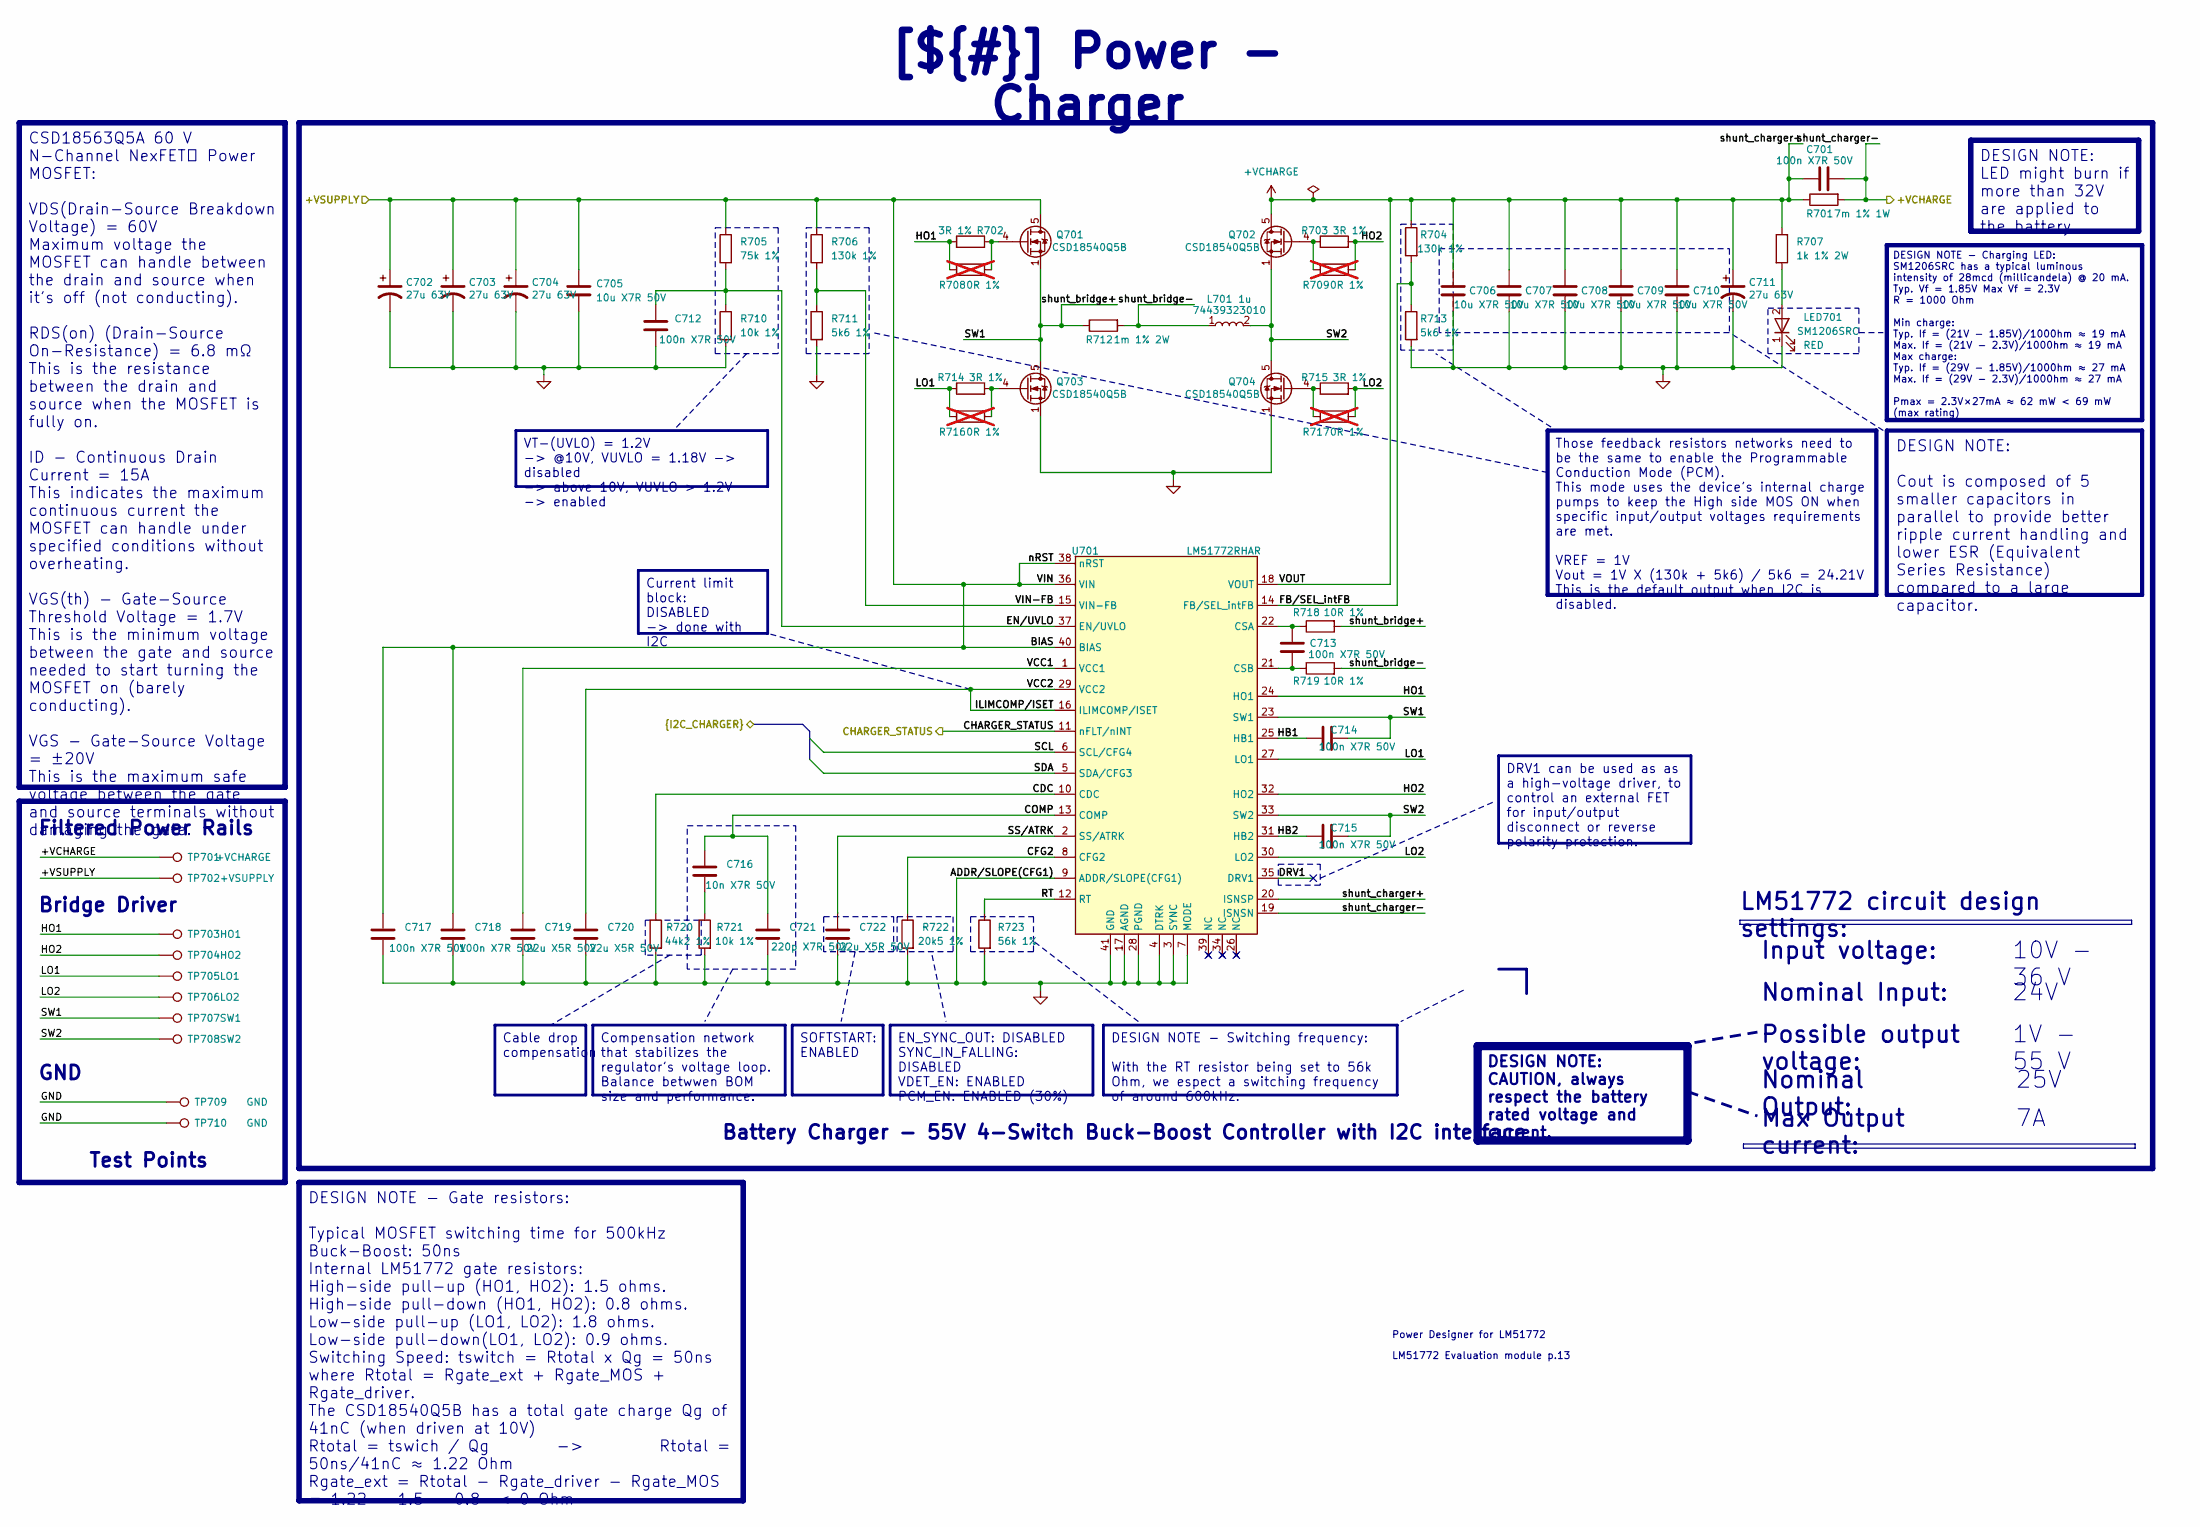
[picture p70: schematic Power - Charger.kicad_sch]

Parts:
C701, C712, C713, C714, C715, C717, C718: 100n X7R 50V; C_0402_1005Metric; Manufacturer Part Number UMK105B7104KVHF
C702, C703, C704, C711: 27u 63V; CP_Elec_8x6.7; Manufacturer Part Number A768KE276M1JLAE054
C705, C706, C707, C708, C709, C710: 10u X7R 50V; C_1206_3216Metric; Manufacturer Part Number CL31B106KBHNNNE
C716: 10n X7R 50V; C_0402_1005Metric; Manufacturer Part Number 04025C103JAT2A
C719, C720, C722: 22u X5R 50V; C_0603_1608Metric; Manufacturer Part Number GRT188R61A226ME13D
C721: 220p X7R 50V; C_0402_1005Metric; Manufacturer Part Number 04025C221JAT2A
L701: 1u; 74439323010; Manufacturer Part Number 74439323010
LED701: RED; LED_1206_3216Metric; Manufacturer Part Number SM1206SRC
Q701, Q702, Q703, Q704: CSD18540Q5B; TDSON-8-1; Manufacturer Part Number CSD18540Q5B
R701: 7m 1% 1W; R_0805_2012Metric_Pad1.20x1.40mm_HandSolder; Manufacturer Part Number WSLP08057L000FEA18
R702, R703, R714, R715: 3R 1%; R_0603_1608Metric; Manufacturer Part Number RK73H1JTTD3R00F
R704, R706: 130k 1%; R_0402_1005Metric; Manufacturer Part Number ERJ-2RKF1303X
R705: 75k 1%; R_0402_1005Metric; Manufacturer Part Number ERJ-PA2F7502X
R707: 1k 1% 2W; R_2010_5025Metric; Manufacturer Part Number 35021K0FT
R708, R709, R716, R717: 0R 1%; R_0603_1608Metric; Manufacturer Part Number RC0603FR-100RL; not fitted
R710, R721: 10k 1%; R_0402_1005Metric; Manufacturer Part Number SG73P1EWTTP1002F
R711, R713: 5k6 1%; R_0402_1005Metric; Manufacturer Part Number RCS04025K60FKED
R712: 1m 1% 2W; R_1206_3216Metric_Pad1.30x1.75mm_HandSolder; Manufacturer Part Number HCS1206FT1L00
R718, R719: 10R 1%; R_0402_1005Metric; Manufacturer Part Number RK73H1ETTPL10R0F
R720: 44k2 1%; R_0402_1005Metric; Manufacturer Part Number ERJ-2RKF4422X
R722: 20k5 1%; R_0402_1005Metric; Manufacturer Part Number RK73H1ETTP2052F
R723: 56k 1%; R_0402_1005Metric; Manufacturer Part Number RCS040256K0FKED
TP701: +VCHARGE; TestPoint_Pad_D1.0mm
TP702: +VSUPPLY; TestPoint_Pad_D1.0mm
TP703: HO1; TestPoint_Pad_D1.0mm
TP704: HO2; TestPoint_Pad_D1.0mm
TP705: LO1; TestPoint_Pad_D1.0mm
TP706: LO2; TestPoint_Pad_D1.0mm
TP707: SW1; TestPoint_Pad_D1.0mm
TP708: SW2; TestPoint_Pad_D1.0mm
TP709, TP710: GND; TestPoint_Pad_D1.0mm
U701: LM51772RHAR; Manufacturer Part Number LM51772RHAR

Connections:
+VCHARGE: C701.1, C701.2, C706.2, C707.2, C708.2, C709.2, C710.2, C711.1, Q702.5 (D), R701.1, R701.2, R704.1, R707.1, TP701.1, U701.18 (VOUT), U701.19 (ISNSN), U701.20 (ISNSP); also elsewhere on the board
+VSUPPLY: C702.1, C703.1, C704.1, C705.2, C717.2, C718.2, Q701.5 (D), R705.1, R706.1, TP702.1, U701.36 (VIN), U701.38 (nRST), U701.40 (BIAS); also elsewhere on the board
/Project Architecture/MCU - Unit/CHARGER_STATUS: U701.11 (nFLT/nINT); also elsewhere on the board
/Project Architecture/MCU - Unit/SCL: U701.6 (SCL/CFG4); also elsewhere on the board
/Project Architecture/MCU - Unit/SDA: U701.5 (SDA/CFG3); also elsewhere on the board
/Project Architecture/Power - Charger/CDC: R720.1, U701.10 (CDC)
/Project Architecture/Power - Charger/CFG2: R722.1, U701.8 (CFG2)
/Project Architecture/Power - Charger/COMP: C716.2, C721.2, U701.13 (COMP)
/Project Architecture/Power - Charger/DRV1: U701.35 (DRV1)
/Project Architecture/Power - Charger/EN/UVLO: C712.2, R705.2, R710.1, U701.37 (EN/UVLO)
/Project Architecture/Power - Charger/FB/SEL_intFB: R704.2, R713.1, U701.14 (FB/SEL_intFB)
/Project Architecture/Power - Charger/HB1: C714.2, U701.25 (HB1)
/Project Architecture/Power - Charger/HB2: C715.2, U701.31 (HB2)
/Project Architecture/Power - Charger/HO1: R702.2, R708.2, TP703.1, U701.24 (HO1)
/Project Architecture/Power - Charger/HO2: R703.2, R709.1, TP704.1, U701.32 (HO2)
/Project Architecture/Power - Charger/ILIMCOMP/ISET: C720.2, U701.16 (ILIMCOMP/ISET), U701.29 (VCC2)
/Project Architecture/Power - Charger/LO1: R714.1, R716.2, TP705.1, U701.27 (LO1)
/Project Architecture/Power - Charger/LO2: R715.2, R717.1, TP706.1, U701.30 (LO2)
/Project Architecture/Power - Charger/RT: R723.1, U701.12 (RT)
/Project Architecture/Power - Charger/SS/ATRK: C722.2, U701.2 (SS/ATRK)
/Project Architecture/Power - Charger/SW1: C714.1, Q701.1 (S), Q701.2 (S), Q701.3 (S), Q703.5 (D), R712.1, R718.2, TP707.1, U701.23 (SW1)
/Project Architecture/Power - Charger/SW2: C715.1, L701.2, Q702.1 (S), Q702.2 (S), Q702.3 (S), Q704.5 (D), TP708.1, U701.33 (SW2)
/Project Architecture/Power - Charger/VCC1: C719.2, U701.1 (VCC1)
/Project Architecture/Power - Charger/VIN-FB: R706.2, R711.1, U701.15 (VIN-FB)
/Project Architecture/Power - Charger/shunt_bridge-: L701.1, R712.2, R719.2
GND: C702.2, C703.2, C704.2, C705.1, C706.1, C707.1, C708.1, C709.1, C710.1, C711.2, C712.1, C717.1, C718.1, C719.1, C720.1, C721.1, C722.1, LED701.1 (K), Q703.1 (S), Q703.2 (S), Q703.3 (S), Q704.1 (S), Q704.2 (S), Q704.3 (S), R710.2, R711.2, R713.2, R720.2, R721.2, R722.2, R723.2, TP709.1, TP710.1, U701.3 (SYNC), U701.4 (DTRK), U701.7 (MODE), U701.9 (ADDR/SLOPE(CFG1)), U701.17 (AGND), U701.28 (PGND), U701.41 (GND); also elsewhere on the board
unnamed: C716.1, R721.1
unnamed: LED701.2 (A), R707.2
unnamed: Q701.4 (G), R702.1, R708.1
unnamed: Q702.4 (G), R703.1, R709.2
unnamed: Q703.4 (G), R714.2, R716.1
unnamed: Q704.4 (G), R715.1, R717.2
unnamed: C713.2, R718.1, U701.22 (CSA)
unnamed: C713.1, R719.1, U701.21 (CSB)

Notes on the sheet:
1V - 55 V
Bridge Driver
Compensation network that stabilizes the regulator's voltage loop. Balance betwwen BOM size and performance.
GND
DESIGN NOTE - Charging LED: SM1206SRC has a typical luminous intensity of 28mcd (millicandela) @ 20 mA. Typ. Vf = 1.85V Max Vf = 2.3V R = 1000 Ohm Min charge: Typ. If = (21V - 1.85V)/1000hm ≈ 19 mA Max. If = (21V - 2.3V)/1000hm ≈ 19 mA Max charge: Typ. If = (29V - 1.85V)/1000hm ≈ 27 mA Max. If = (2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
DESIGN NOTE: LED might burn if more than 32V are applied to the battery
DESIGN NOTE - Gate resistors: Typical MOSFET switching time for 500kHz Buck-Boost: 50ns Internal LM51772 gate resistors: High-side pull-up (HO1, HO2): 1.5 ohms. High-side pull-down (HO1, HO2): 0.8 ohms. Low-side pull-up (LO1, LO2): 1.8 ohms. Low-side pull-down(LO1, LO2): 0.9 ohms . Switching Speed: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
Current limit block: DISABLED -> done with I2C
LM51772 circuit design settings:
DRV1 can be used as as a high-voltage driver, to control an external FET for input/output disconnect or reverse polarity protection.
DESIGN NOTE - Switching frequency: With the RT resistor being set to 56k Ohm, we espect a switching frequency of around 600kHz.
Nominal Input:
Input voltage:
Possible output voltage:
DESIGN NOTE: Cout is composed of 5 smaller capacitors in parallel to provide better ripple current handling and lower ESR (Equivalent Series Resistance) compared to a large capacitor.
Test Points
DESIGN NOTE: CAUTION, always respect the battery rated voltage and current.
VT-(UVLO) = 1.2V -> @10V, VUVLO = 1.18V -> disabled -> above 10V, VUVLO > 1.2V -> enabled
Nominal Output:
24V
[${#}] ${TITLE}
25V
Cable drop compensation
Max Output current:
SOFTSTART: ENABLED
Filtered Power Rails
Those feedback resistors networks need to be the same to enable the Programmable Conduction Mode (PCM). This mode uses the device's internal charge pumps to keep the High side MOS ON when specific input/output voltages requirements are met. VREF = 1V Vout = 1V X (130k + 5k6) / 5k6 = 24.21V This is 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
CSD18563Q5A 60 V N-Channel NexFET™ Power MOSFET: VDS(Drain-Source Breakdown Voltage) = 60V Maximum voltage the MOSFET can handle between the drain and source when it's off (not conducting). RDS(on) (Drain-Source On-Resistance) = 6.8 mΩ This is the resistance between the drain and source when the MO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
Battery Charger - 55V 4-Switch Buck-Boost Controller with I2C interface
EN_SYNC_OUT: DISABLED SYNC_IN_FALLING: DISABLED VDET_EN: ENABLED PCM_EN: ENABLED (30%)
10V - 36 V
LM51772 Evaluation module p.13
Power Designer for LM51772

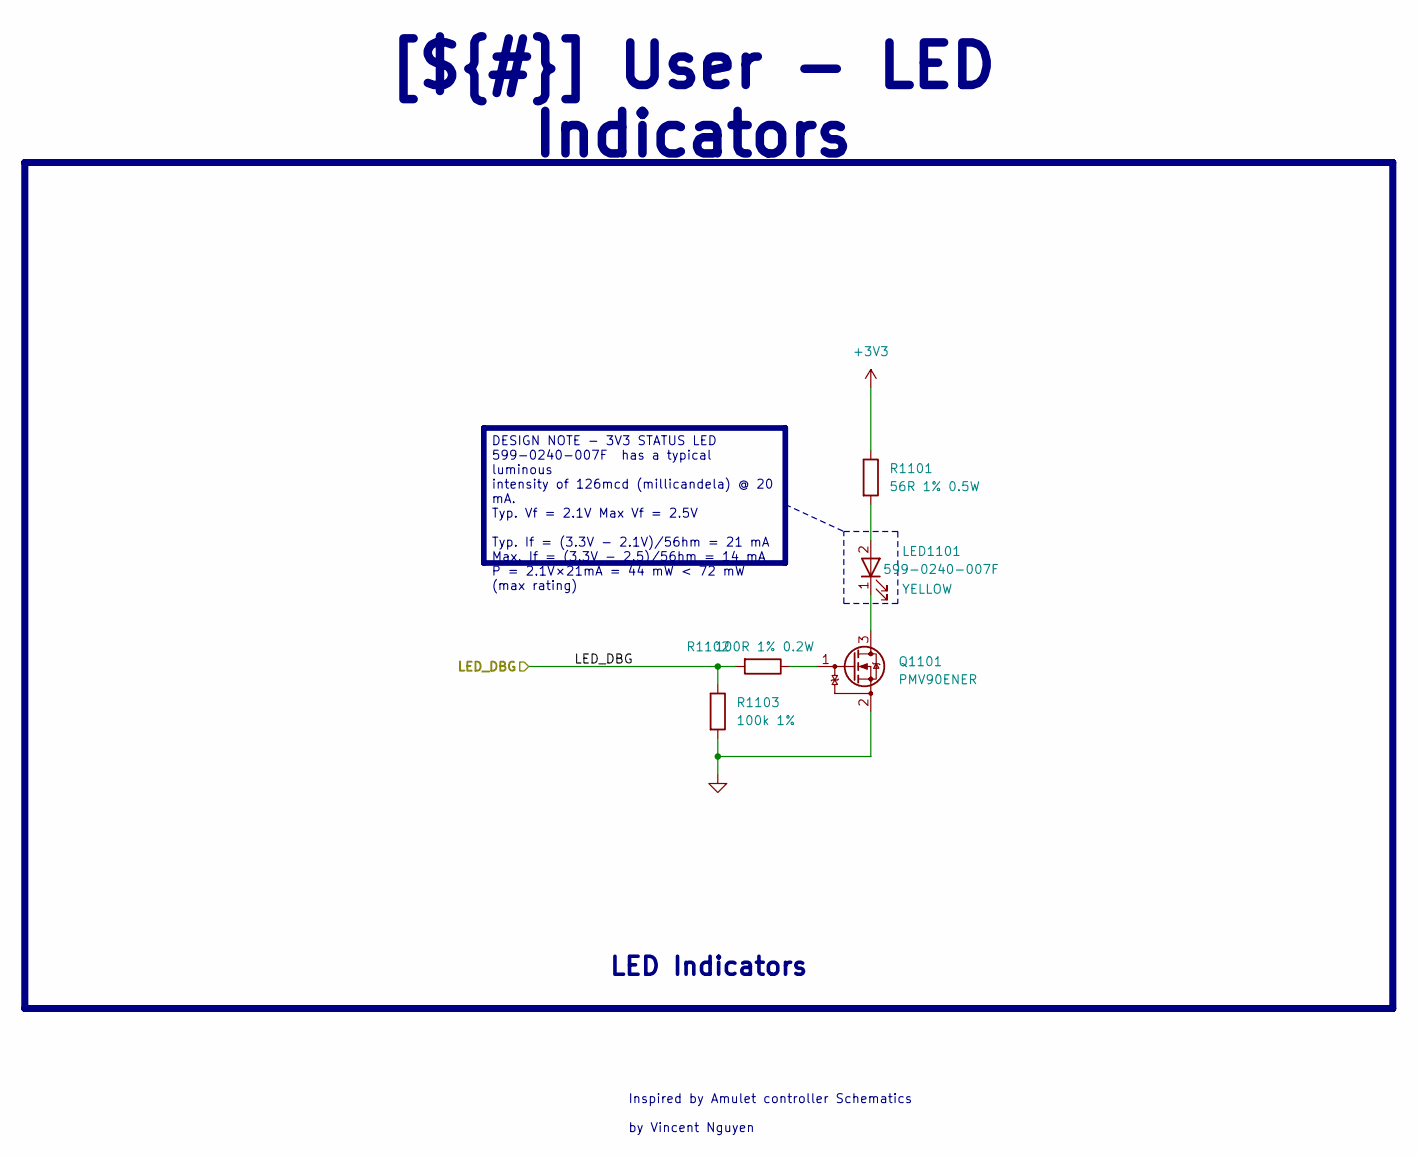
[picture p71: schematic User - LED Indicators.kicad_sch]

Parts:
LED1101: YELLOW; LED_1206_3216Metric; Manufacturer Part Number 599-0240-007F
Q1101: PMV90ENER; SOT-23-3; Manufacturer Part Number PMV90ENER
R1101: 56R 1% 0.5W; R_0805_2012Metric_Pad1.20x1.40mm_HandSolder; Manufacturer Part Number SG73P2ATTD56R0F
R1102: 100R 1% 0.2W; R_0402_1005Metric; Manufacturer Part Number CRCW0402100RFKEDHP
R1103: 100k 1%; R_0402_1005Metric; Manufacturer Part Number ERJ-PA2F1003X

Connections:
+3V3: R1101.1; also elsewhere on the board
/Project Architecture/MCU - Unit/LED_DBG: R1102.2, R1103.1; also elsewhere on the board
GND: Q1101.2 (S), R1103.2; also elsewhere on the board
unnamed: LED1101.2 (A), R1101.2
unnamed: LED1101.1 (K), Q1101.3 (D)
unnamed: Q1101.1 (G), R1102.1

Notes on the sheet:
DESIGN NOTE - 3V3 STATUS LED 599-0240-007F has a typical luminous intensity of 126mcd (millicandela) @ 20 mA. Typ. Vf = 2.1V Max Vf = 2.5V Typ. If = (3.3V - 2.1V)/56hm = 21 mA Max. If = (3.3V - 2.5)/56hm = 14 mA P = 2.1V×21mA = 44 mW < 72 mW (max rating)
[${#}] ${TITLE}
LED Indicators
Inspired by Amulet controller Schematics by Vincent Nguyen

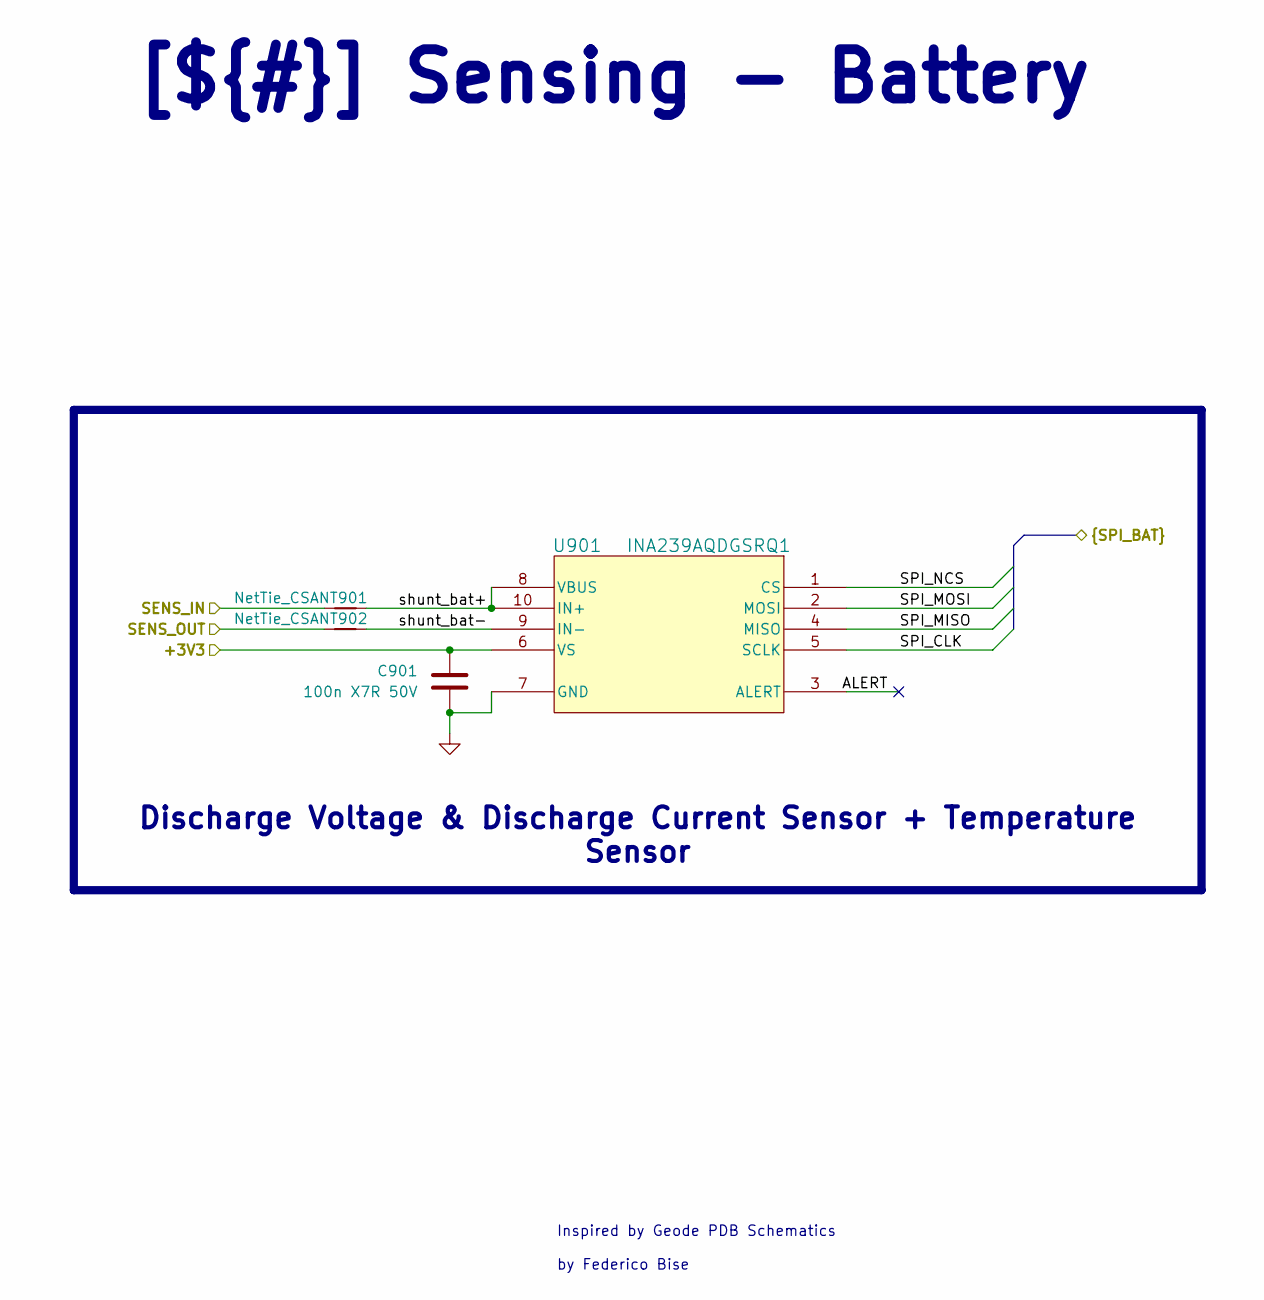
[picture p72: schematic Sensor - Battery.kicad_sch, Sensing - Battery]

Parts:
C901: 100n X7R 50V; C_0402_1005Metric; Manufacturer Part Number UMK105B7104KVHF
NT901, NT902: NetTie_CSA; NetTie-2_SMD_Pad0.5mm
U901: INA239AQDGSRQ1; Manufacturer Part Number INA239AQDGSRQ1

Connections:
+3V3: C901.1, U901.6 (VS); also elsewhere on the board
+VBAT: NT901.1, NT902.1; also elsewhere on the board
/Project Architecture/MCU - Unit/SPI_CLK: U901.5 (SCLK); also elsewhere on the board
/Project Architecture/MCU - Unit/SPI_MISO: U901.4 (MISO); also elsewhere on the board
/Project Architecture/MCU - Unit/SPI_MOSI: U901.2 (MOSI); also elsewhere on the board
/Project Architecture/MCU - Unit/SPI_NCS: U901.1 (CS); also elsewhere on the board
/Project Architecture/Sensing - Battery/ALERT: U901.3 (ALERT)
/Project Architecture/Sensing - Battery/shunt_bat+: NT901.2, U901.8 (VBUS), U901.10 (IN+)
/Project Architecture/Sensing - Battery/shunt_bat-: NT902.2, U901.9 (IN-)
GND: C901.2, U901.7 (GND); also elsewhere on the board

Notes on the sheet:
[${#}] ${TITLE}
Discharge Voltage & Discharge Current Sensor + Temperature Sensor
Inspired by Geode PDB Schematics by Federico Bise
