EPFLXplore/ERC_AV_HW/Power/ElonMux/ElonMux.kicad_pcb

## KiCad design Power/ElonMux/ElonMux.kicad_pcb (continued)

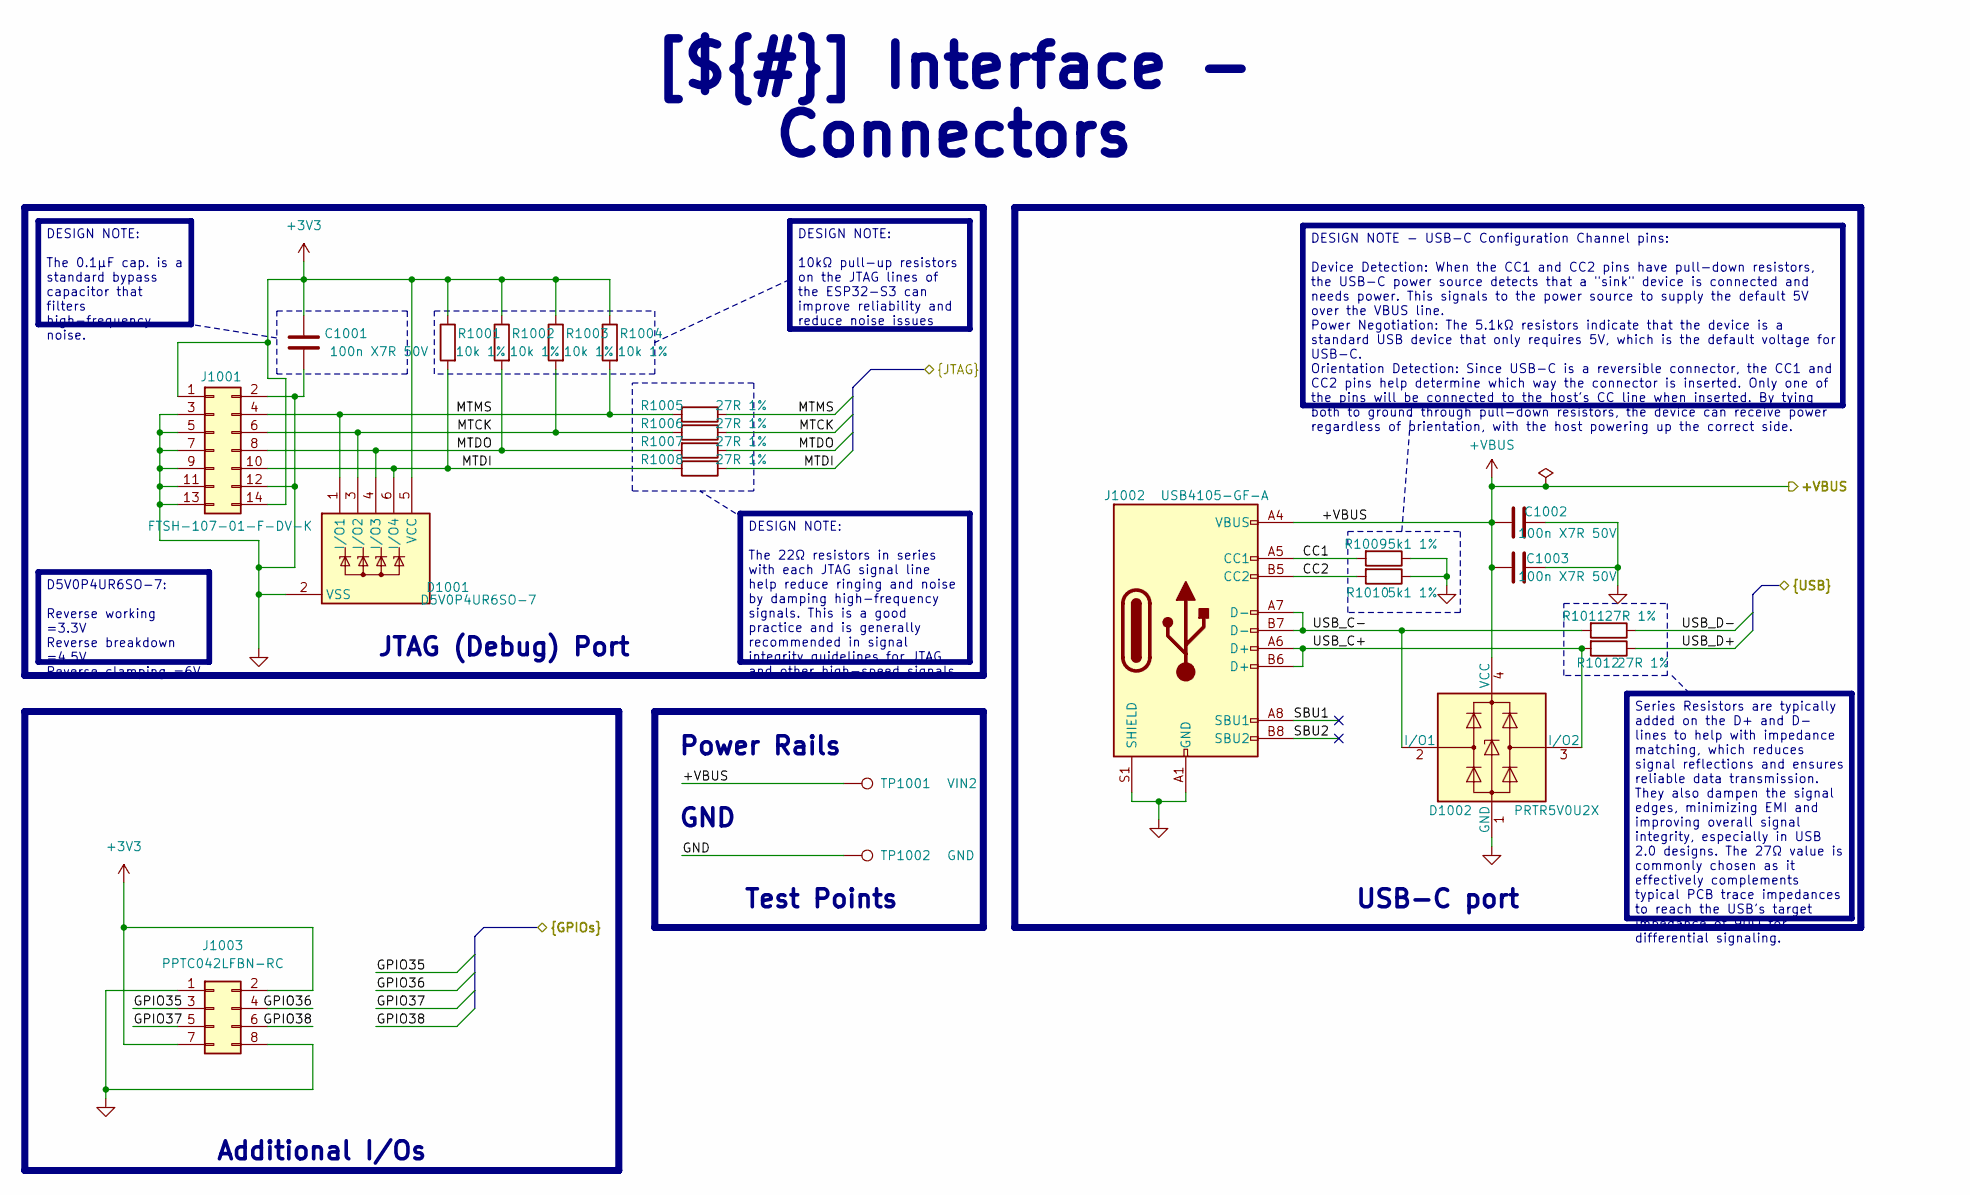
[picture p73: schematic Interface - Connectors.kicad_sch]

Parts:
C1001, C1002, C1003: 100n X7R 50V; C_0402_1005Metric; Manufacturer Part Number UMK105B7104KVHF
D1001: D5V0P4UR6SO-7; D5V0P4UR6SO-7 SOT95P285X140-6N; Manufacturer Part Number D5V0P4UR6SO-7
D1002: PRTR5V0U2X; SOT-143; Manufacturer Part Number PRTR5V0U2X,215
J1001: FTSH-107-01-F-DV-K; FTSH-107-XX-YYY-DV-K; Manufacturer Part Number FTSH-107-01-F-DV-K
J1002: USB4105-GF-A; GCT_USB4105-GF-A; Manufacturer Part Number USB4105-GF-A
J1003: PPTC042LFBN-RC; PinSocket_2x04_P2.54mm_Vertical; Manufacturer Part Number PPTC042LFBN-RC
R1001, R1002, R1003, R1004: 10k 1%; R_0402_1005Metric; Manufacturer Part Number SG73P1EWTTP1002F
R1005, R1006, R1007, R1008, R1011, R1012: 27R 1%; R_0402_1005Metric; Manufacturer Part Number RCS040227R0FKED
R1009, R1010: 5k1 1%; R_0402_1005Metric; Manufacturer Part Number RCS04025K10FKED
TP1001: VIN2; TestPoint_Pad_D1.0mm
TP1002: GND; TestPoint_Pad_D1.0mm

Connections:
+3V3: C1001.1, D1001.5 (VCC), J1001.1, J1001.14, J1003.2, J1003.7, R1001.1, R1002.1, R1003.1, R1004.1; also elsewhere on the board
+VBUS: C1002.1, C1003.1, D1002.4 (VCC), J1002.A4 (VBUS), J1002.A9 (VBUS), J1002.B4 (VBUS), J1002.B9 (VBUS), TP1001.1; also elsewhere on the board
/Project Architecture/Interface - Connectors/CC1: J1002.A5 (CC1), R1009.2
/Project Architecture/Interface - Connectors/CC2: J1002.B5 (CC2), R1010.2
/Project Architecture/Interface - Connectors/GPIO35: J1003.3; also elsewhere on the board
/Project Architecture/Interface - Connectors/GPIO36: J1003.4; also elsewhere on the board
/Project Architecture/Interface - Connectors/GPIO37: J1003.5; also elsewhere on the board
/Project Architecture/Interface - Connectors/GPIO38: J1003.6; also elsewhere on the board
/Project Architecture/Interface - Connectors/MTCK: D1001.3 (I/O2), J1001.6, R1003.2, R1006.1, R1006.2; also elsewhere on the board
/Project Architecture/Interface - Connectors/MTDI: D1001.6 (I/O4), J1001.10, R1001.2, R1008.1, R1008.2; also elsewhere on the board
/Project Architecture/Interface - Connectors/MTDO: D1001.4 (I/O3), J1001.8, R1002.2, R1007.1, R1007.2; also elsewhere on the board
/Project Architecture/Interface - Connectors/MTMS: D1001.1 (I/O1), J1001.4, R1004.2, R1005.1, R1005.2; also elsewhere on the board
/Project Architecture/Interface - Connectors/SBU1: J1002.A8 (SBU1)
/Project Architecture/Interface - Connectors/SBU2: J1002.B8 (SBU2)
/Project Architecture/Interface - Connectors/USB_C+: D1002.3 (I/O2), J1002.A6 (D+), J1002.B6 (D+), R1012.2
/Project Architecture/Interface - Connectors/USB_C-: D1002.2 (I/O1), J1002.A7 (D-), J1002.B7 (D-), R1011.2
/Project Architecture/Interface - Connectors/USB_D+: R1012.1; also elsewhere on the board
/Project Architecture/Interface - Connectors/USB_D-: R1011.1; also elsewhere on the board
GND: C1001.2, C1002.2, C1003.2, D1001.2 (VSS), D1002.1 (GND), J1001.2, J1001.3, J1001.5, J1001.7, J1001.9, J1001.11, J1001.12, J1001.13, J1002.A1 (GND), J1002.A12 (GND), J1002.B1 (GND), J1002.B12 (GND), J1002.S1 (SHIELD), J1003.1, J1003.8, R1009.1, R1010.1, TP1002.1; also elsewhere on the board

Notes on the sheet:
Test Points
GND
DESIGN NOTE: 10kΩ pull-up resistors on the JTAG lines of the ESP32-S3 can improve reliability and reduce noise issues
Additional I/Os
Series Resistors are typically added on the D+ and D- lines to help with impedance matching, which reduces signal reflections and ensures reliable data transmission. They also dampen the signal edges, minimizing EMI and improving overall signal integrity, especially in USB 2.0 designs. The 27Ω valu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
USB-C port
DESIGN NOTE: The 22Ω resistors in series with each JTAG signal line help reduce ringing and noise by damping high-frequency signals. This is a good practice and is generally recommended in signal integrity guidelines for JTAG and other high-speed signals.
JTAG (Debug) Port
Power Rails
D5V0P4UR6SO-7: Reverse working =3.3V Reverse breakdown =4.5V Reverse clamping =6V
[${#}] ${TITLE}
DESIGN NOTE - USB-C Configuration Channel pins: Device Detection: When the CC1 and CC2 pins have pull-down resistors, the USB-C power source detects that a "sink" device is connected and needs power. This signals to the power source to supply the default 5V over the VBUS line. Power Negotiation: Th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
DESIGN NOTE: The 0.1µF cap. is a standard bypass capacitor that filters high-frequency noise.

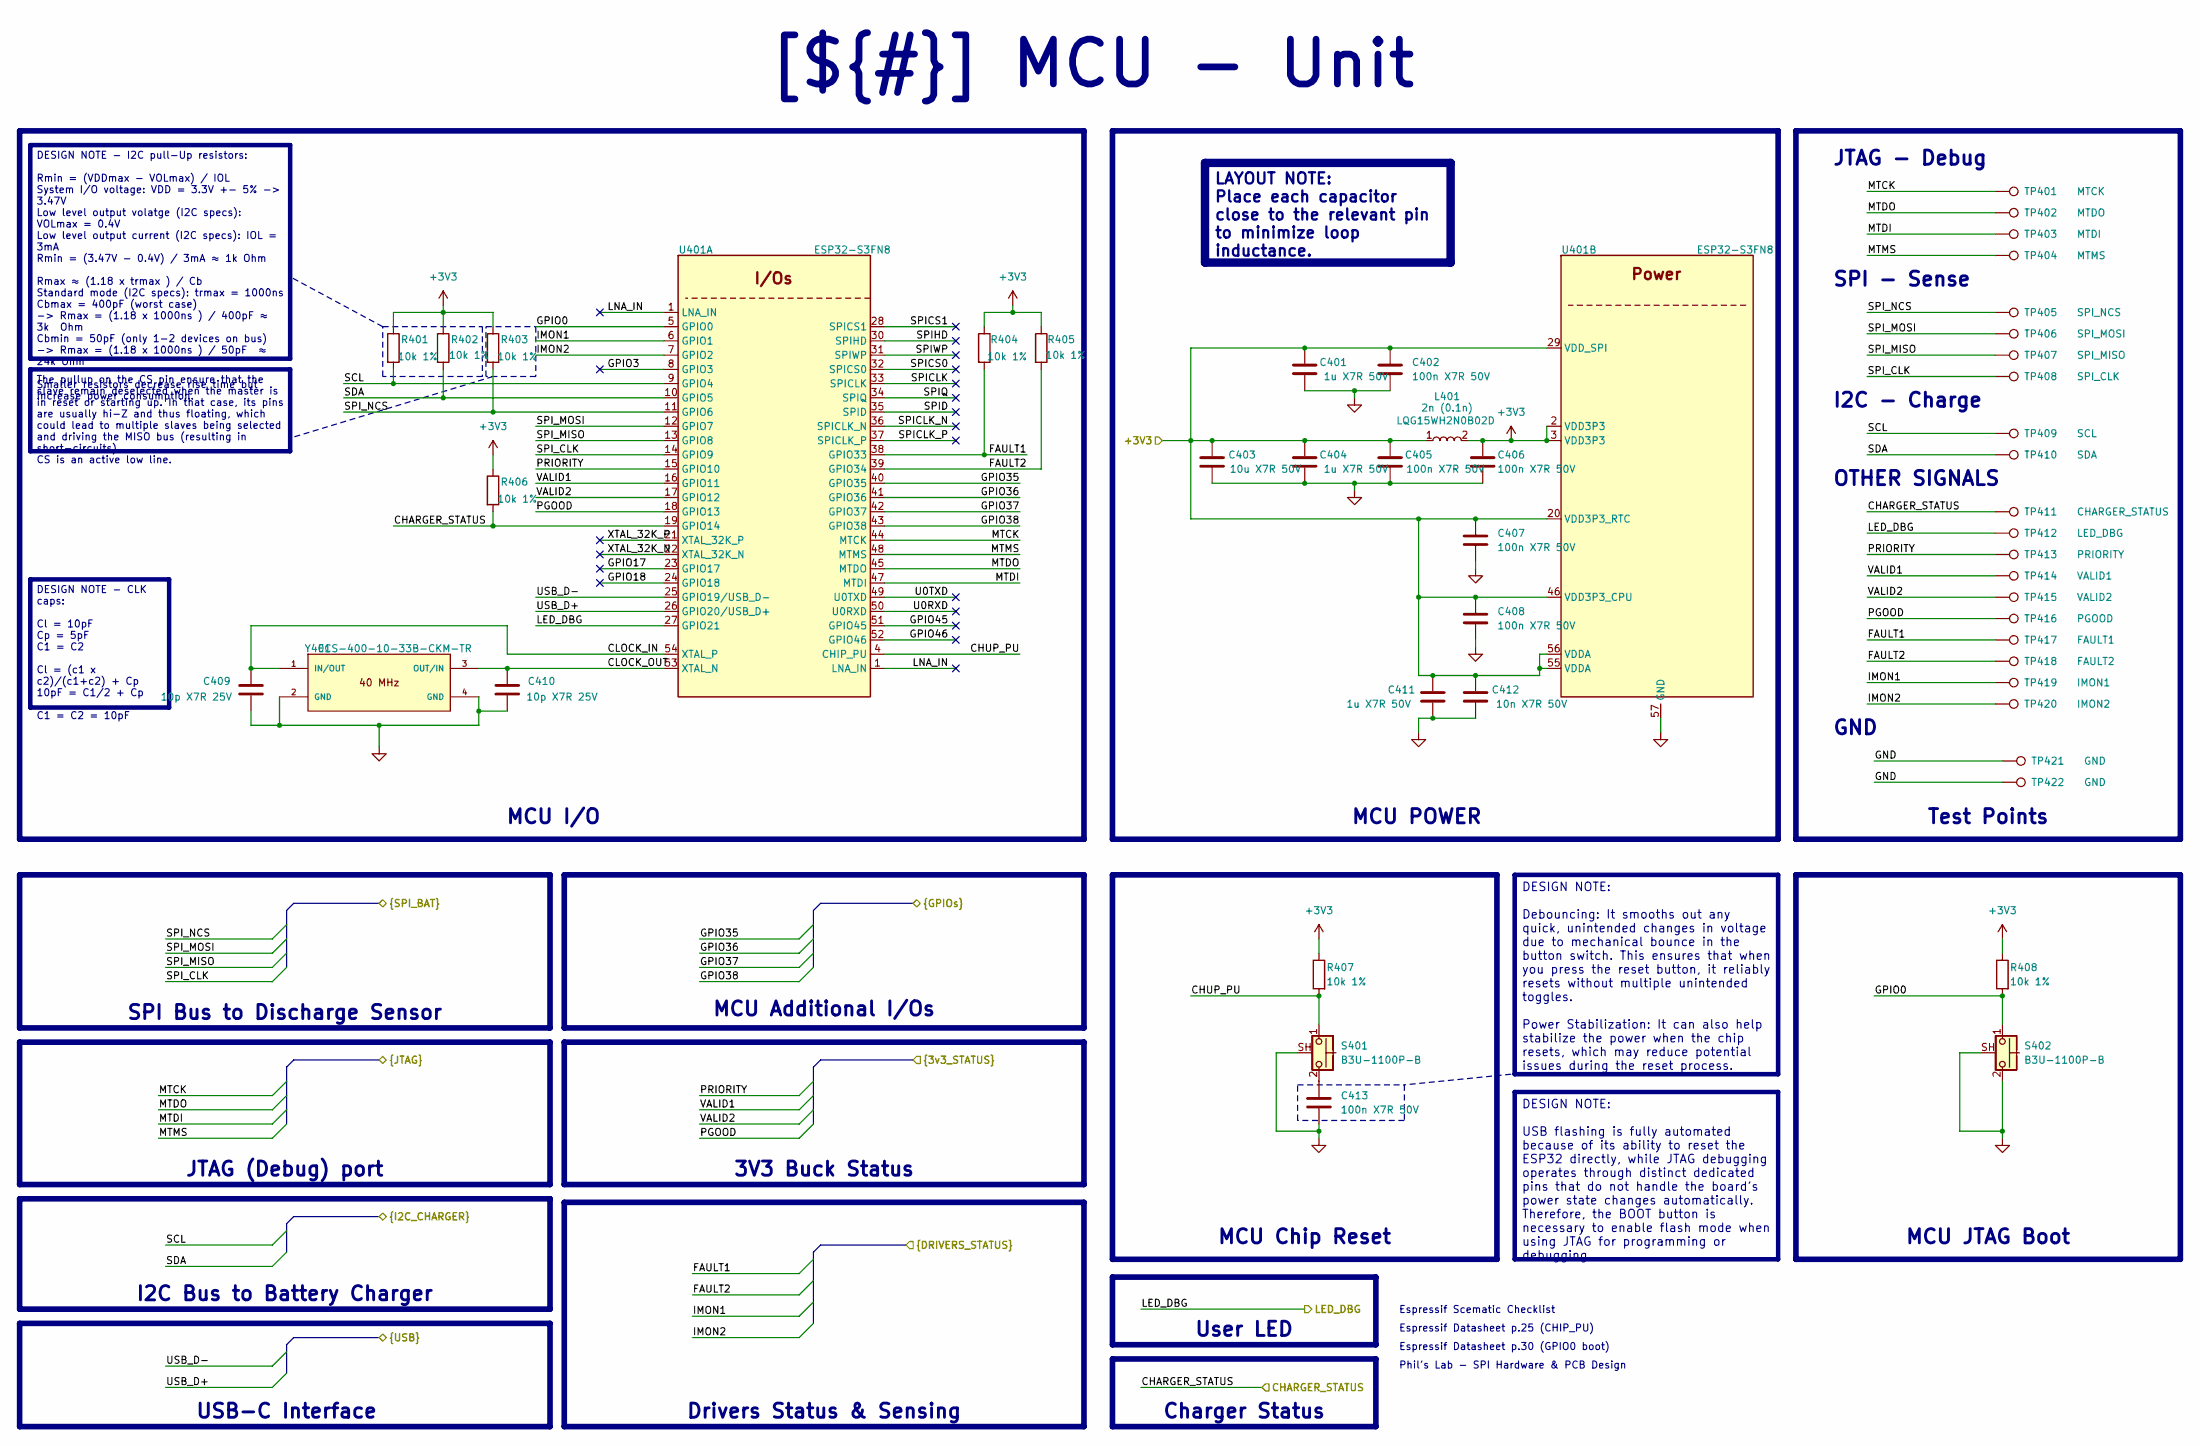
[picture p74: schematic MCU - Unit.kicad_sch]

Parts:
C401, C404, C411: 1u X7R 50V; C_0603_1608Metric; Manufacturer Part Number CC0603KRX7R9BB105
C402, C405, C406, C407, C408, C413: 100n X7R 50V; C_0402_1005Metric; Manufacturer Part Number UMK105B7104KVHF
C403: 10u X7R 50V; C_1206_3216Metric; Manufacturer Part Number CL31B106KBHNNNE
C409, C410: 10p X7R 25V; C_0402_1005Metric; Manufacturer Part Number 04025U100BAT2A
C412: 10n X7R 50V; C_0402_1005Metric; Manufacturer Part Number 04025C103JAT2A
L401: 2n (0.1n); L_0402_1005Metric; Manufacturer Part Number LQG15WH2N0B02D
R401, R402, R403, R404, R405, R406, R407, R408: 10k 1%; R_0402_1005Metric; Manufacturer Part Number SG73P1EWTTP1002F
S401, S402: B3U-1100P-B; B3U1100PB; Manufacturer Part Number B3U-1100P-B
TP401: MTCK; TestPoint_Pad_D1.0mm
TP402: MTDO; TestPoint_Pad_D1.0mm
TP403: MTDI; TestPoint_Pad_D1.0mm
TP404: MTMS; TestPoint_Pad_D1.0mm
TP405: SPI_NCS; TestPoint_Pad_D1.0mm
TP406: SPI_MOSI; TestPoint_Pad_D1.0mm
TP407: SPI_MISO; TestPoint_Pad_D1.0mm
TP408: SPI_CLK; TestPoint_Pad_D1.0mm
TP409: SCL; TestPoint_Pad_D1.0mm
TP410: SDA; TestPoint_Pad_D1.0mm
TP411: CHARGER_STATUS; TestPoint_Pad_D1.0mm
TP412: LED_DBG; TestPoint_Pad_D1.0mm
TP413: PRIORITY; TestPoint_Pad_D1.0mm
TP414: VALID1; TestPoint_Pad_D1.0mm
TP415: VALID2; TestPoint_Pad_D1.0mm
TP416: PGOOD; TestPoint_Pad_D1.0mm
TP417: FAULT1; TestPoint_Pad_D1.0mm
TP418: FAULT2; TestPoint_Pad_D1.0mm
TP419: IMON1; TestPoint_Pad_D1.0mm
TP420: IMON2; TestPoint_Pad_D1.0mm
TP421, TP422: GND; TestPoint_Pad_D1.0mm
U401: ESP32-S3FN8; QFN-56-1EP_7x7mm_P0.4mm_EP4x4mm; Manufacturer Part Number ESP32-S3FN8
Y401: ECS-400-10-33B-CKM-TR; XTAL_ECS-400-10-33B-CKM-TR; Manufacturer Part Number ECS-400-10-33B-CKM-TR

Connections:
+3V3: C401.1, C402.1, C403.1, C404.1, C405.1, C406.1, C407.1, C408.1, C411.1, C412.1, L401.1, L401.2, R401.1, R402.1, R403.1, R404.1, R405.1, R406.1, R407.1, R408.1, U401.2 (VDD3P3), U401.3 (VDD3P3), U401.20 (VDD3P3_RTC), U401.29 (VDD_SPI), U401.46 (VDD3P3_CPU), U401.55 (VDDA), U401.56 (VDDA); also elsewhere on the board
/Project Architecture/Interface - Connectors/GPIO35: U401.40 (GPIO35); also elsewhere on the board
/Project Architecture/Interface - Connectors/GPIO36: U401.41 (GPIO36); also elsewhere on the board
/Project Architecture/Interface - Connectors/GPIO37: U401.42 (GPIO37); also elsewhere on the board
/Project Architecture/Interface - Connectors/GPIO38: U401.43 (GPIO38); also elsewhere on the board
/Project Architecture/Interface - Connectors/MTCK: TP401.1, U401.44 (MTCK); also elsewhere on the board
/Project Architecture/Interface - Connectors/MTDI: TP403.1, U401.47 (MTDI); also elsewhere on the board
/Project Architecture/Interface - Connectors/MTDO: TP402.1, U401.45 (MTDO); also elsewhere on the board
/Project Architecture/Interface - Connectors/MTMS: TP404.1, U401.48 (MTMS); also elsewhere on the board
/Project Architecture/Interface - Connectors/USB_D+: U401.26 (GPIO20/USB_D+); also elsewhere on the board
/Project Architecture/Interface - Connectors/USB_D-: U401.25 (GPIO19/USB_D-); also elsewhere on the board
/Project Architecture/MCU - Unit/CHARGER_STATUS: R406.2, TP411.1, U401.19 (GPIO14); also elsewhere on the board
/Project Architecture/MCU - Unit/CHUP_PU: R407.2, S401.1, U401.4 (CHIP_PU)
/Project Architecture/MCU - Unit/CLOCK_IN: C409.2, U401.54 (XTAL_P), Y401.1 (IN/OUT)
/Project Architecture/MCU - Unit/CLOCK_OUT: C410.2, U401.53 (XTAL_N), Y401.3 (OUT/IN)
/Project Architecture/MCU - Unit/FAULT1: R404.2, TP417.1, U401.38 (GPIO33); also elsewhere on the board
/Project Architecture/MCU - Unit/FAULT2: R405.2, TP418.1, U401.39 (GPIO34); also elsewhere on the board
/Project Architecture/MCU - Unit/GPIO0: R408.2, S402.1, U401.5 (GPIO0)
/Project Architecture/MCU - Unit/GPIO3: U401.8 (GPIO3)
/Project Architecture/MCU - Unit/GPIO17: U401.23 (GPIO17)
/Project Architecture/MCU - Unit/GPIO18: U401.24 (GPIO18)
/Project Architecture/MCU - Unit/GPIO45: U401.51 (GPIO45)
/Project Architecture/MCU - Unit/GPIO46: U401.52 (GPIO46)
/Project Architecture/MCU - Unit/IMON1: TP419.1, U401.6 (GPIO1); also elsewhere on the board
/Project Architecture/MCU - Unit/IMON2: TP420.1, U401.7 (GPIO2); also elsewhere on the board
/Project Architecture/MCU - Unit/LED_DBG: TP412.1, U401.27 (GPIO21); also elsewhere on the board
/Project Architecture/MCU - Unit/LNA_IN: U401.1 (LNA_IN)
/Project Architecture/MCU - Unit/PGOOD: TP416.1, U401.18 (GPIO13); also elsewhere on the board
/Project Architecture/MCU - Unit/PRIORITY: TP413.1, U401.15 (GPIO10); also elsewhere on the board
/Project Architecture/MCU - Unit/SCL: R401.2, TP409.1, U401.9 (GPIO4); also elsewhere on the board
/Project Architecture/MCU - Unit/SDA: R402.2, TP410.1, U401.10 (GPIO5); also elsewhere on the board
/Project Architecture/MCU - Unit/SPICLK: U401.33 (SPICLK)
/Project Architecture/MCU - Unit/SPICLK_N: U401.36 (SPICLK_N)
/Project Architecture/MCU - Unit/SPICLK_P: U401.37 (SPICLK_P)
/Project Architecture/MCU - Unit/SPICS0: U401.32 (SPICS0)
/Project Architecture/MCU - Unit/SPICS1: U401.28 (SPICS1)
/Project Architecture/MCU - Unit/SPID: U401.35 (SPID)
/Project Architecture/MCU - Unit/SPIHD: U401.30 (SPIHD)
/Project Architecture/MCU - Unit/SPIQ: U401.34 (SPIQ)
/Project Architecture/MCU - Unit/SPIWP: U401.31 (SPIWP)
/Project Architecture/MCU - Unit/SPI_CLK: TP408.1, U401.14 (GPIO9); also elsewhere on the board
/Project Architecture/MCU - Unit/SPI_MISO: TP407.1, U401.13 (GPIO8); also elsewhere on the board
/Project Architecture/MCU - Unit/SPI_MOSI: TP406.1, U401.12 (GPIO7); also elsewhere on the board
/Project Architecture/MCU - Unit/SPI_NCS: R403.2, TP405.1, U401.11 (GPIO6); also elsewhere on the board
/Project Architecture/MCU - Unit/U0RXD: U401.50 (U0RXD)
/Project Architecture/MCU - Unit/U0TXD: U401.49 (U0TXD)
/Project Architecture/MCU - Unit/VALID1: TP414.1, U401.16 (GPIO11); also elsewhere on the board
/Project Architecture/MCU - Unit/VALID2: TP415.1, U401.17 (GPIO12); also elsewhere on the board
/Project Architecture/MCU - Unit/XTAL_32K_N: U401.22 (XTAL_32K_N)
/Project Architecture/MCU - Unit/XTAL_32K_P: U401.21 (XTAL_32K_P)
GND: C401.2, C402.2, C403.2, C404.2, C405.2, C406.2, C407.2, C408.2, C409.1, C410.1, C411.2, C412.2, C413.2, S401.SH, S402.2, S402.SH, TP421.1, TP422.1, U401.57 (GND), Y401.2 (GND), Y401.4 (GND); also elsewhere on the board
unnamed: C413.1, S401.2

Notes on the sheet:
MCU Additional I/Os
MCU Chip Reset
SPI Bus to Discharge Sensor
GND
Charger Status
JTAG (Debug) port
DESIGN NOTE - I2C pull-Up resistors: Rmin = (VDDmax - VOLmax) / IOL System I/O voltage: VDD = 3.3V +- 5% -> 3.47V Low level output volatge (I2C specs): VOLmax = 0.4V Low level output current (I2C specs): IOL = 3mA Rmin = (3.47V - 0.4V) / 3mA ≈ 1k Ohm Rmax ≈ (1.18 x trmax ) / Cb Standard mode (I2C s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
User LED
[${#}] ${TITLE}
DESIGN NOTE - CLK caps: Cl = 10pF Cp = 5pF C1 = C2 Cl = (c1 x c2)/(c1+c2) + Cp 10pF = C1/2 + Cp C1 = C2 = 10pF
Test Points
The pullup on the CS pin ensure that the slave remain deselected when the master is in reset or starting up. In that case, its pins are usually hi-Z and thus floating, which could lead to multiple slaves being selected and driving the MISO bus (resulting in short-circuits). CS is an active low line.
SPI - Sense
MCU JTAG Boot
JTAG - Debug
I2C - Charge
LAYOUT NOTE: Place each capacitor close to the relevant pin to minimize loop inductance.
MCU I/O
I2C Bus to Battery Charger
USB-C Interface
MCU POWER
3V3 Buck Status
OTHER SIGNALS
Drivers Status & Sensing
DESIGN NOTE: USB flashing is fully automated because of its ability to reset the ESP32 directly, while JTAG debugging operates through distinct dedicated pins that do not handle the board's power state changes automatically. Therefore, the BOOT button is necessary to enable flash mode when using JT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
DESIGN NOTE: Debouncing: It smooths out any quick, unintended changes in voltage due to mechanical bounce in the button switch. This ensures that when you press the reset button, it reliably resets without multiple unintended toggles. Power Stabilization: It can also help stabilize the power when t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
Espressif Datasheet p.25 (CHIP_PU)
Phil's Lab - SPI Hardware & PCB Design
Espressif Datasheet p.30 (GPIO0 boot)
Espressif Scematic Checklist

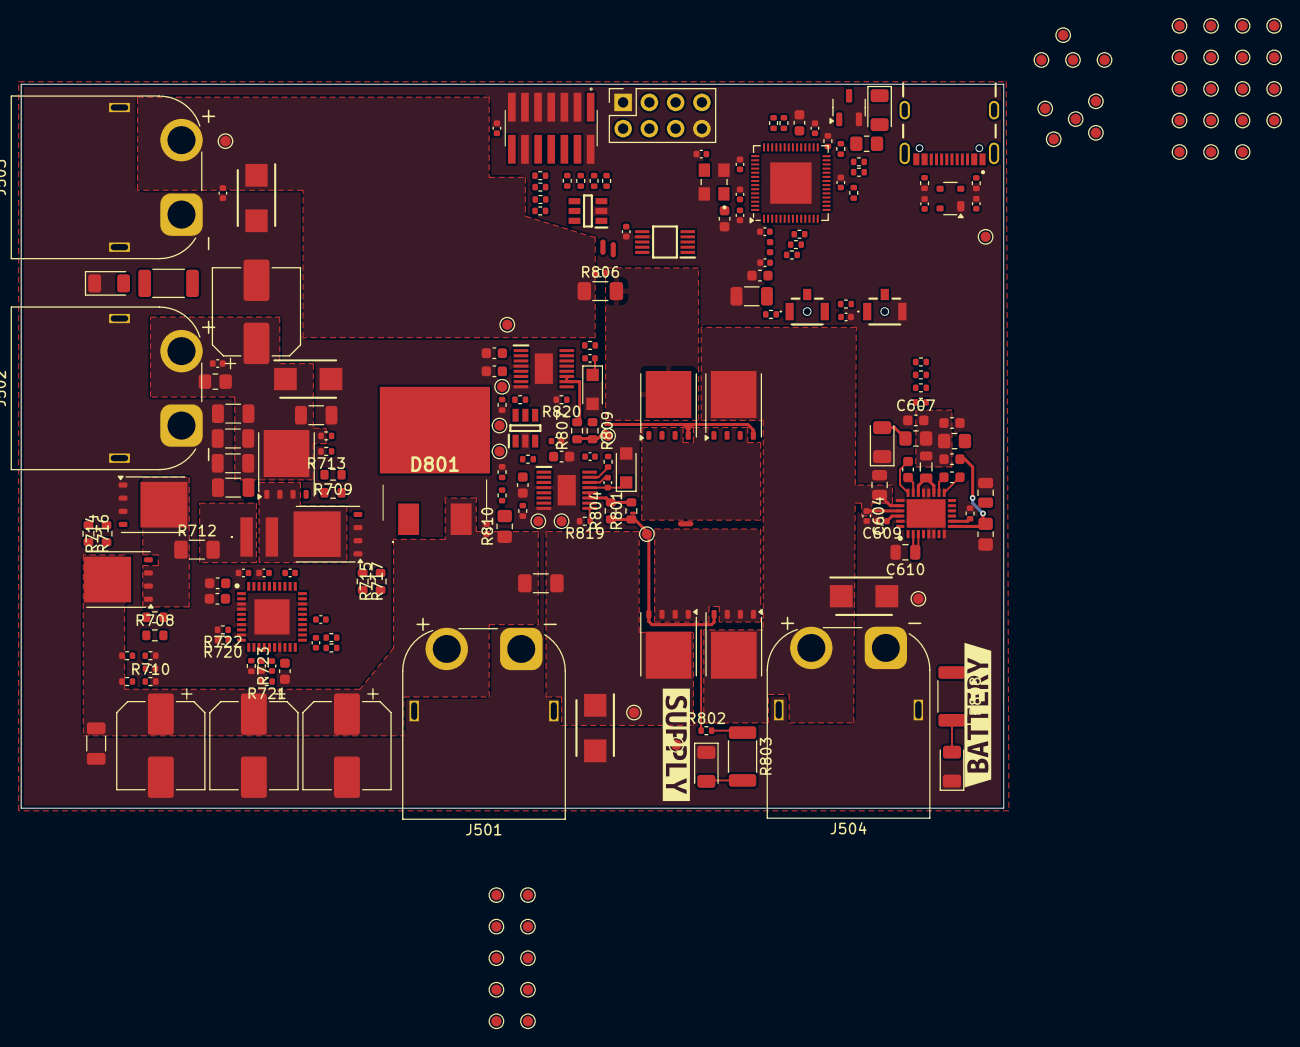
[picture p75: board ElonMux.kicad_pcb from above]

Board: 4 copper layers, 95.0 x 70.0 mm, 233 parts (0 on the bottom side), 106 nets.

Other parts of the board:
kibuzzard-67161F44: G***; kibuzzard-67161F44
kibuzzard-67141537: G***; kibuzzard-67141537
