EPFLXplore/ERC_AV_HW/hats/power_hat/power_hat.kicad_pcb

## KiCad design hats/power_hat/power_hat.kicad_pcb (2024-10-18)

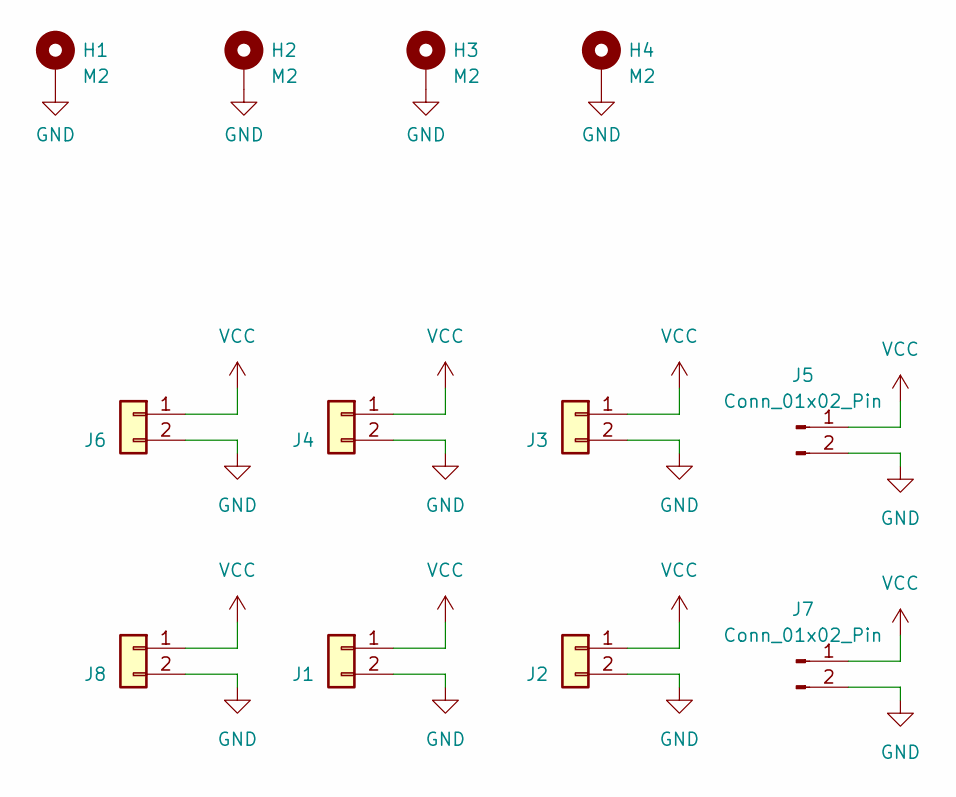
[picture p76: schematic power_hat.kicad_sch]

Parts:
H1, H2, H3, H4: M2; MountingHole_2.2mm_M2_Pad_Via
J1, J2, J3, J4, J6, J8: XT30PW-M/Terminal block; AMASS_XT30PW-M_1x02_P2.50mm_Horizontal
J5, J7: Conn_01x02_Pin; AMASS_XT60PW-F_1x02_P7.20mm_Horizontal

Connections:
GND: H1.1, H2.1, H3.1, H4.1, J1.2, J2.2, J3.2, J4.2, J5.2, J6.2, J7.2, J8.2
VCC: J1.1, J2.1, J3.1, J4.1, J5.1, J6.1, J7.1, J8.1

Board: 2 copper layers, 12 parts (0 on the bottom side), 2 nets, no tracks yet.
