EPFLXplore/ERC_AV_HW/hats/neopixel_Eliot/neopixel_eliot_hat.kicad_pcb

## KiCad design hats/neopixel_Eliot/neopixel_eliot_hat.kicad_pcb (2024-07-27)

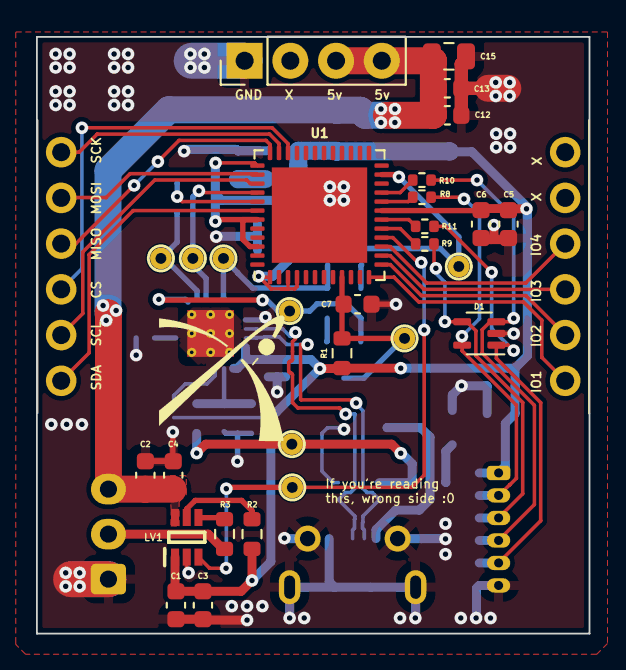
[picture p77: board neopixel_eliot_hat.kicad_pcb from above]

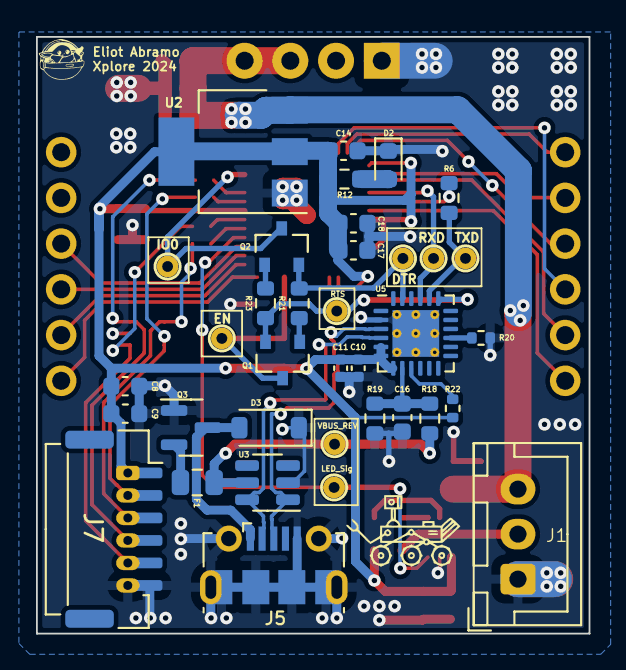
[picture p78: board neopixel_eliot_hat.kicad_pcb from below]

Board: 4 copper layers, 30.7 x 33.1 mm, 59 parts (36 on the bottom side), 43 nets.

Parts:
C1, C4, C8, C13: 4.7uF; C_0603_1608Metric
C2, C3, C5, C6, C7, C9, C12, C17, C18: 0.1uF; C_0603_1608Metric
C10: 0.1uF; C_0402_1005Metric
C11: 4.7uF; C_0402_1005Metric
C14: 22uF; C_0603_1608Metric
C15: 10uF; C_0805_2012Metric
C16: 1uF; C_0603_1608Metric
D1: ESDALC6V1W5; SOT323-5L
D2: RED; LED_0603_1608Metric
D3: SMF5.0CA-TP; D_SOD-123
F1: 0805L075SLYR; Fuse_0805_2012Metric
G1: Xplore_Logo; Xplore_Logo_X_only_20mm
G701: Xplore_Logo; Xplore_Logo_X_only_7mm
J1: B3B-XH-A(LF)(SN); JST_XH_B3B-XH-A_1x03_P2.50mm_Vertical
J2: Hat_connector
J5: USB_B_Micro; USB_Micro-B_Molex-105017-0001
J7: Conn_Picoblade_JST_DEBUG; PicoBlade-JST-GH-1x06_1.25mm_Horizontal
LV1: SN74LVC1T45DCKT; SOP65P210X110-6N
Q1, Q2: SS8050-G; TRANS_SS8050-G
Q3: PJA3405; SOT-23
R1, R2, R21, R23: 10k; R_0603_1608Metric
R3: 100R; R_0603_1608Metric
R6: 499R; R_0603_1608Metric
R8, R9, R10, R11: 22R; R_0402_1005Metric
R12: 2K(1%); R_0603_1608Metric
R18: 22k1; R_0603_1608Metric
R19: 47k5; R_0603_1608Metric
R20: 10k; R_0402_1005Metric
R22: 1k; R_0402_1005Metric
TP1: LED_Sig; TestPoint
TP2: VBUS_REV; TestPoint
TP3: RXD; TestPoint
TP4: TXD; TestPoint
TP6: EN; TestPoint
TP7: DTR; TestPoint
TP8: RTS; TestPoint
TP9: IO0; TestPoint
U1: ESP32-PICO-D4; QFN-48-1EP_7x7mm_P0.5mm_EP5.3x5.3mm
U2: AMS1117; SOT-223-3_TabPin2
U3: SRV05-4A; SOT-23-6
U5: CP2102N-A02-GQFN24; QFN-24-1EP_4x4mm_P0.5mm_EP2.6x2.6mm_ThermalVias

Connections:
+3V3: C1.1, C3.1, C5.1, C6.1, C8.1, C9.1, C10.1, C11.1, C14.1, C17.2, C18.2, J7.1, LV1.1 (VCCA), R1.1, R2.1, R12.2, R22.1, U1.1 (VDDA), U1.3 (VDDA3P3), U1.4 (VDDA3P3), U1.19 (VDD3P3_RTC), U1.37 (VDD3P3_CPU), U1.43 (VDDA), U1.46 (VDDA), U2.2 (VO), U5.5 (VIO), U5.6 (VDD), U5.7 (VREGIN)
+5V_MCU: C2.1, C4.1, C12.1, C13.1, C15.1, J1.3, J2.15 (5V), J2.16 (5V), LV1.6 (VCCB), U2.3 (VI)
/D+: J5.3 (D+), U3.1 (IO1), U5.3 (D+)
/D-: J5.2 (D-), U3.6 (IO4), U5.4 (D-)
/DATA_5V: J1.2, R3.1
/DIR_LED: LV1.5 (DIR), R2.2
/DTR: Q2.2, R21.1, TP7.1, U5.23 (~DTR)
/EN: C7.1, Q1.3, R1.2, TP6.1, U1.9 (EN)
/GPIO0: Q2.3, TP9.1, U1.23 (IO0)
/I2C_SCL: J2.7 (I2C_SCL), U1.39 (IO22)
/I2C_SDA: J2.8 (I2C_SDA), U1.42 (IO21)
/JTCK_MCU: R8.2, U1.20 (IO13)
/JTCK_SIG: D1.5 (IO4), J7.2, R8.1
/JTD0_SIG: D1.3 (IO2), J7.4, R10.1
/JTDI_MCU: R11.2, U1.18 (IO12)
/JTDI_SIG: D1.1 (IO1), J7.5, R11.1
/JTDO_MCU: R10.2, U1.21 (IO15)
/JTMS_MCU: R9.2, U1.17 (IO14)
/JTMS_SIG: D1.4 (IO3), J7.3, R9.1
/MCU_GPIO1: J2.9 (GPIO_1), U1.12 (IO32)
/MCU_GPIO2: J2.10 (GPIO_2), U1.13 (IO33)
/MCU_GPIO3: J2.11 (GPIO_3), U1.14 (IO25)
/MCU_GPIO4: J2.12 (GPIO_4), U1.15 (IO26)
/RSTb: R22.2, U5.9 (~RST)
/RTS: Q1.2, R23.1, TP8.1, U5.19 (~RTS)
/SIGNAL_LED: LV1.3 (A), TP1.1, U1.16 (IO27)
/SPI_CS: J2.6 (SPI_CS), U1.34 (IO5)
/SPI_MISO: J2.5 (SPI_MISO), U1.36 (IO23)
/SPI_MOSI: J2.4 (SPI_MOSI), U1.38 (IO19)
/SPI_SCK: J2.3 (SPI_SCK), U1.35 (IO18)
/SUSPENDb: R20.1, U5.15 (~SUSPEND)
/U0RXD: TP3.1, U1.40 (U0RXD/IO3), U5.21 (TXD)
/U0TXD: R6.1, U1.41 (U0TXD/IO1)
/U0TXD_R: R6.2, TP4.1, U5.20 (RXD)
/VBUS_USB: C16.1, R18.2, R19.1, U5.8 (VBUS)
/base_Q1: Q1.1, R21.2
/base_Q2: Q2.1, R23.2
GND: C1.2, C2.2, C3.2, C4.2, C5.2, C6.2, C7.2, C8.2, C9.2, C10.2, C11.2, C12.2, C13.2, C14.2, C15.2, C16.2, C17.1, C18.1, D1.2 (GND), D2.1 (K), D3.1 (A1), J1.1, J2.1 (GND), J5.5 (GND), J5.6 (Shield), J7.6, LV1.2 (GND), Q3.1 (G), R19.2, R20.2, U1.49 (GND), U2.1 (ADJ), U3.2 (VN), U5.2 (GND), U5.25 (GND)
unnamed: D2.2 (A), R12.1
unnamed: LV1.4 (B), R3.2
unnamed: F1.1, Q3.2 (S)
VBUS: D3.2 (A2), J5.1 (VBUS), Q3.3 (D)
VBUS_REV: F1.2, R18.1, TP2.1, U3.5 (VP)
