EPFLXplore/ERC_AV_HW/hats/voltmeter_Meriem_Eliot/voltmeter_Meriem_Eliot.kicad_pcb

## KiCad design hats/voltmeter_Meriem_Eliot/voltmeter_Meriem_Eliot.kicad_pcb (2024-07-27)

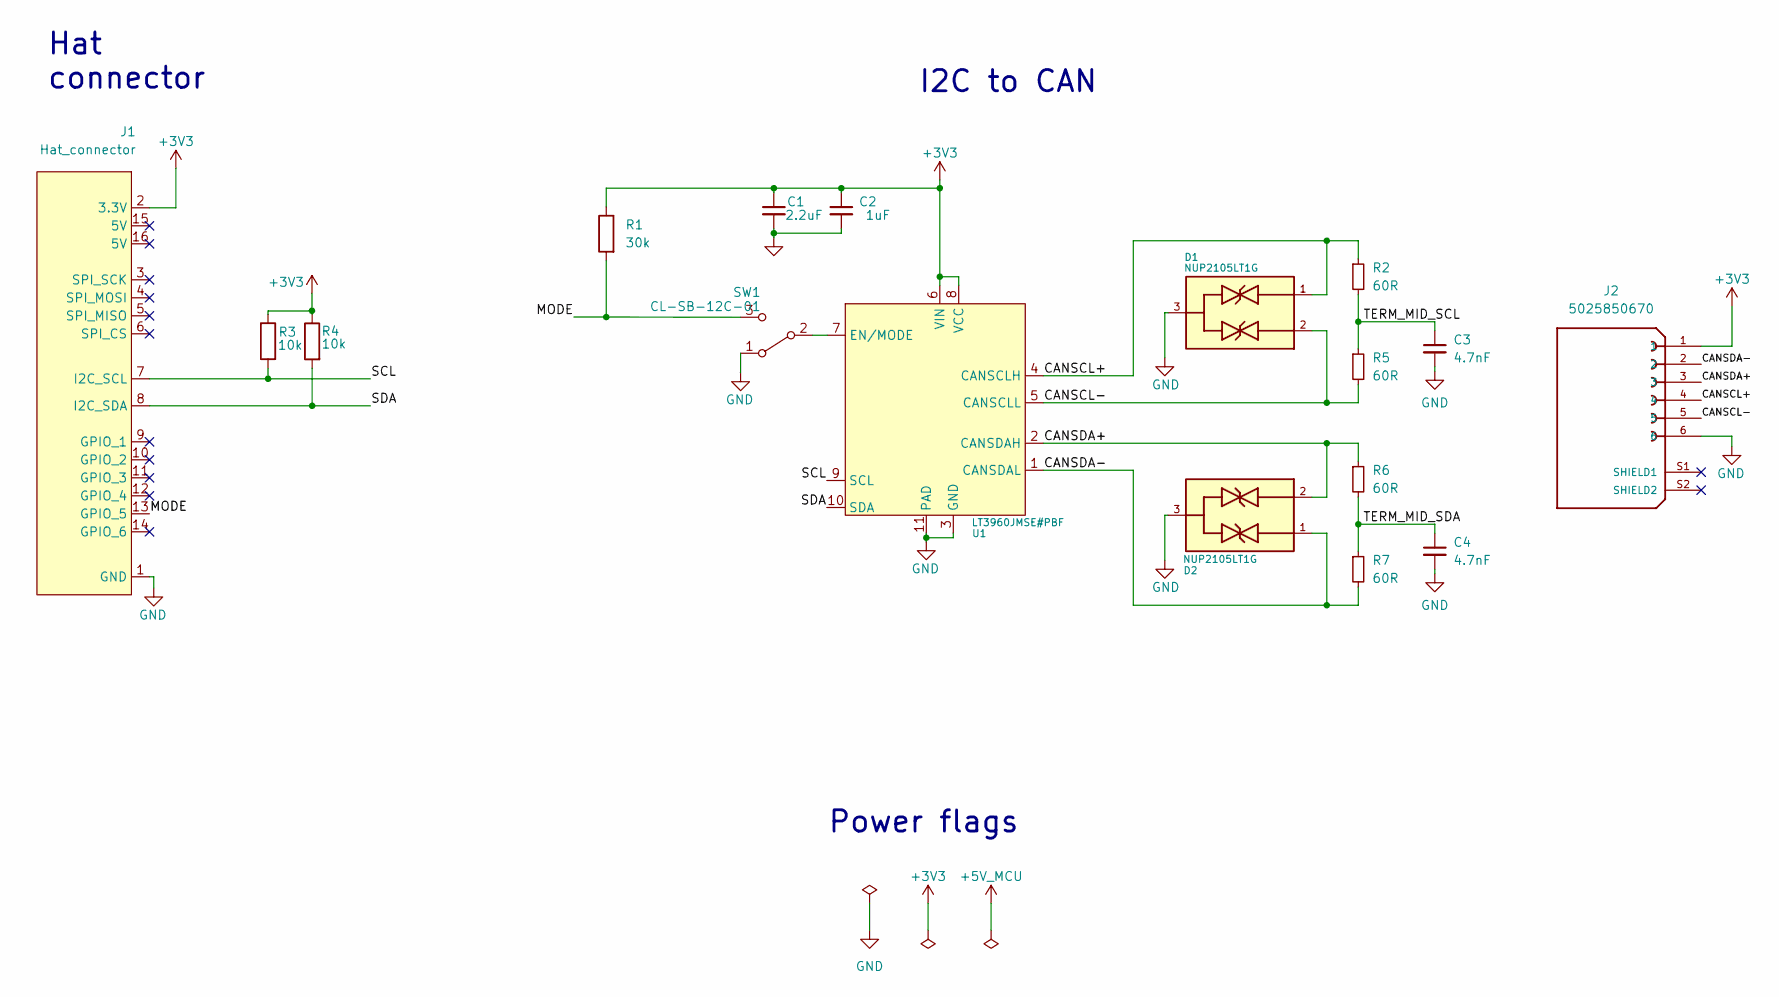
[picture p79: schematic voltmeter_Meriem_Eliot.kicad_sch]

Parts:
C1: 2.2uF; C_0603_1608Metric_Pad1.08x0.95mm_HandSolder
C2: 1uF; C_0603_1608Metric_Pad1.08x0.95mm_HandSolder
C3, C4: 4.7nF; C_0402_1005Metric; Mouser ref 581-0402YD475MAT2A
D1, D2: NUP2105LT1G; SOT95P237X111-3N; PARTREV 10
J1: Hat_connector; Hat_connector_hole
J2: 5025850670; MOLEX_5025850670; PARTREV C
R1: 30k; R_0603_1608Metric
R2, R5, R6, R7: 60R; R_0603_1608Metric; Mouser ref 71-CRCW060360R4FKEAH
R3, R4: 10k; R_0603_1608Metric
SW1: CL-SB-12C-01; SW_DIP_SPSTx01_Slide_Copal_CVS-01xB_W5.9mm_P1mm; Digikey ref 563-1322-ND
U1: LT3960JMSE#PBF; MSOP-10-1EP_3x3mm_P0.5mm_EP1.68x1.88mm; Mouser ref 584-LT3960JMSE#PBF

Connections:
+3V3: C1.1, C2.1, J1.2 (3.3V), J2.1, R1.1, R3.1, R4.1, U1.6 (VIN), U1.8 (VCC)
/CANSCL+: D1.1, J2.4, R2.1, U1.4 (CANSCLH)
/CANSCL-: D1.2, J2.5, R5.2, U1.5 (CANSCLL)
/CANSDA+: D2.2, J2.3, R6.1, U1.2 (CANSDAH)
/CANSDA-: D2.1, J2.2, R7.2, U1.1 (CANSDAL)
/MODE: J1.13 (GPIO_5), R1.2, SW1.3 (C)
/SCL: J1.7 (I2C_SCL), R3.2, U1.9 (SCL)
/SDA: J1.8 (I2C_SDA), R4.2, U1.10 (SDA)
/TERM_MID_SCL: C3.1, R2.2, R5.1
/TERM_MID_SDA: C4.1, R6.2, R7.1
GND: C1.2, C2.2, C3.2, C4.2, D1.3, D2.3, J1.1 (GND), J2.6, SW1.1 (A), U1.3 (GND), U1.11 (PAD)
unnamed: SW1.2 (B), U1.7 (EN/MODE)

Notes on the sheet:
I2C to CAN
Hat connector
Power flags

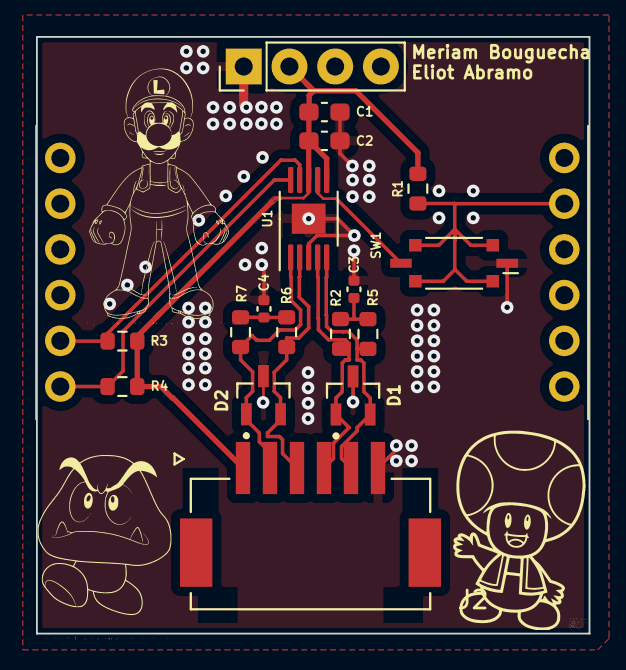
[picture p80: board voltmeter_Meriem_Eliot.kicad_pcb from above]

Board: 2 copper layers, 30.7 x 33.1 mm, 17 parts (0 on the bottom side), 12 nets.
