EPFLXplore/ERC_AV_HW/nav_controller_interface/nav_controller_interface_v3/nav_lower_controller/nav_lower_controller.kicad_pcb

## KiCad design nav_controller_interface/nav_controller_interface_v3/nav_lower_controller/nav_lower_controller.kicad_pcb (2024-05-18)

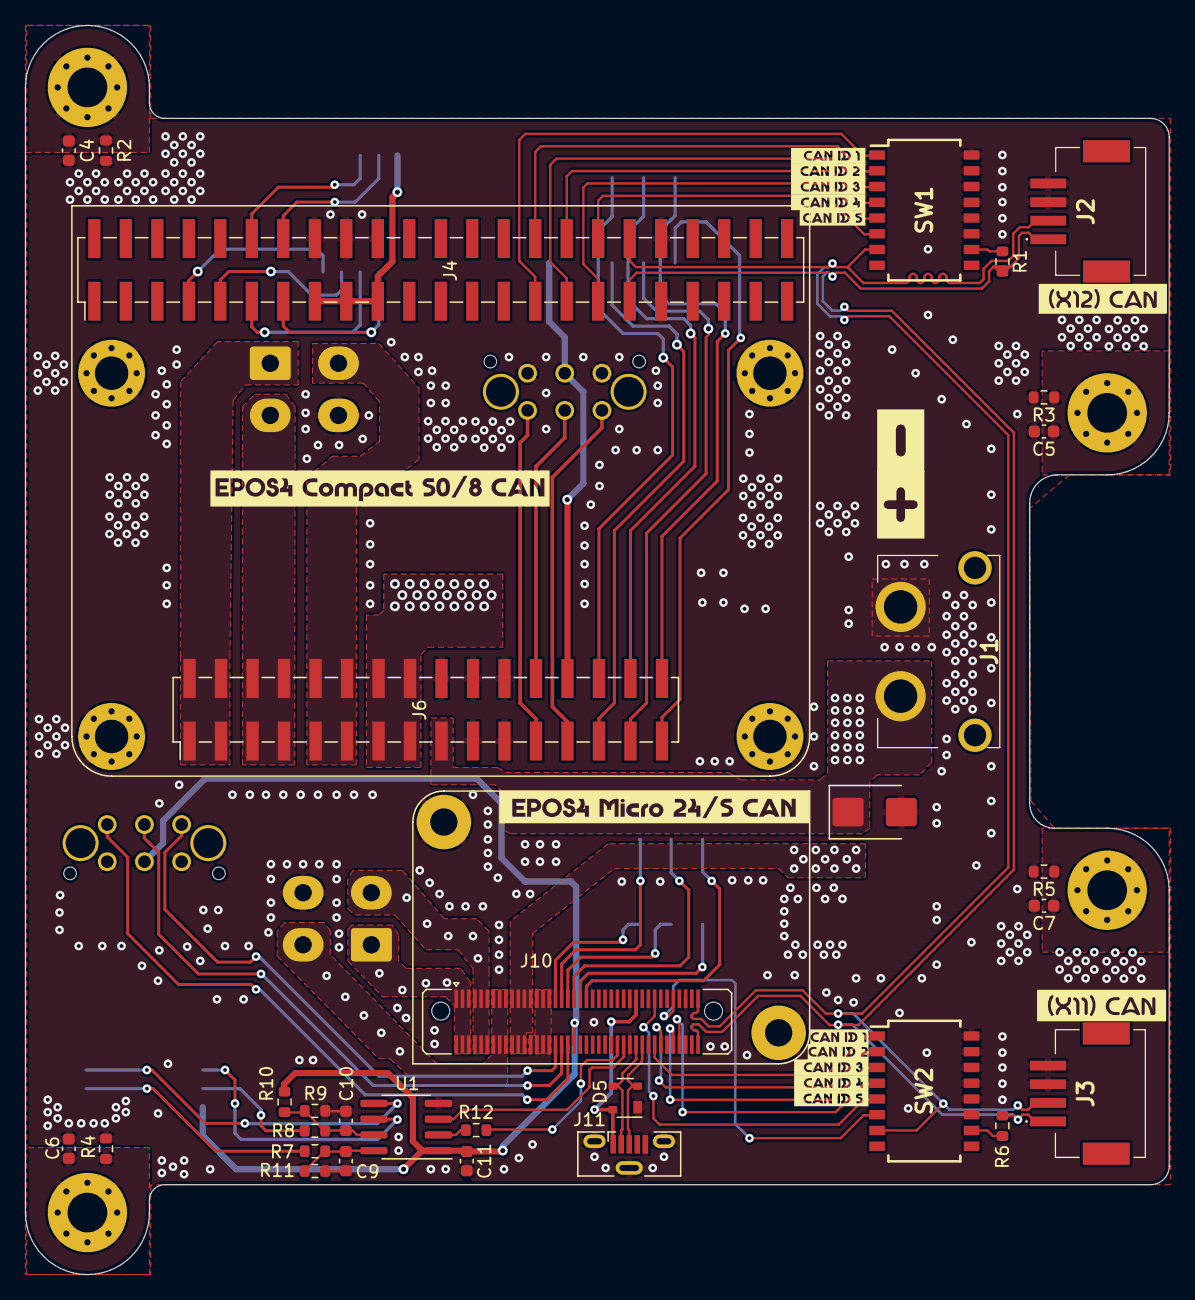
[picture p81: board nav_lower_controller.kicad_pcb from above]

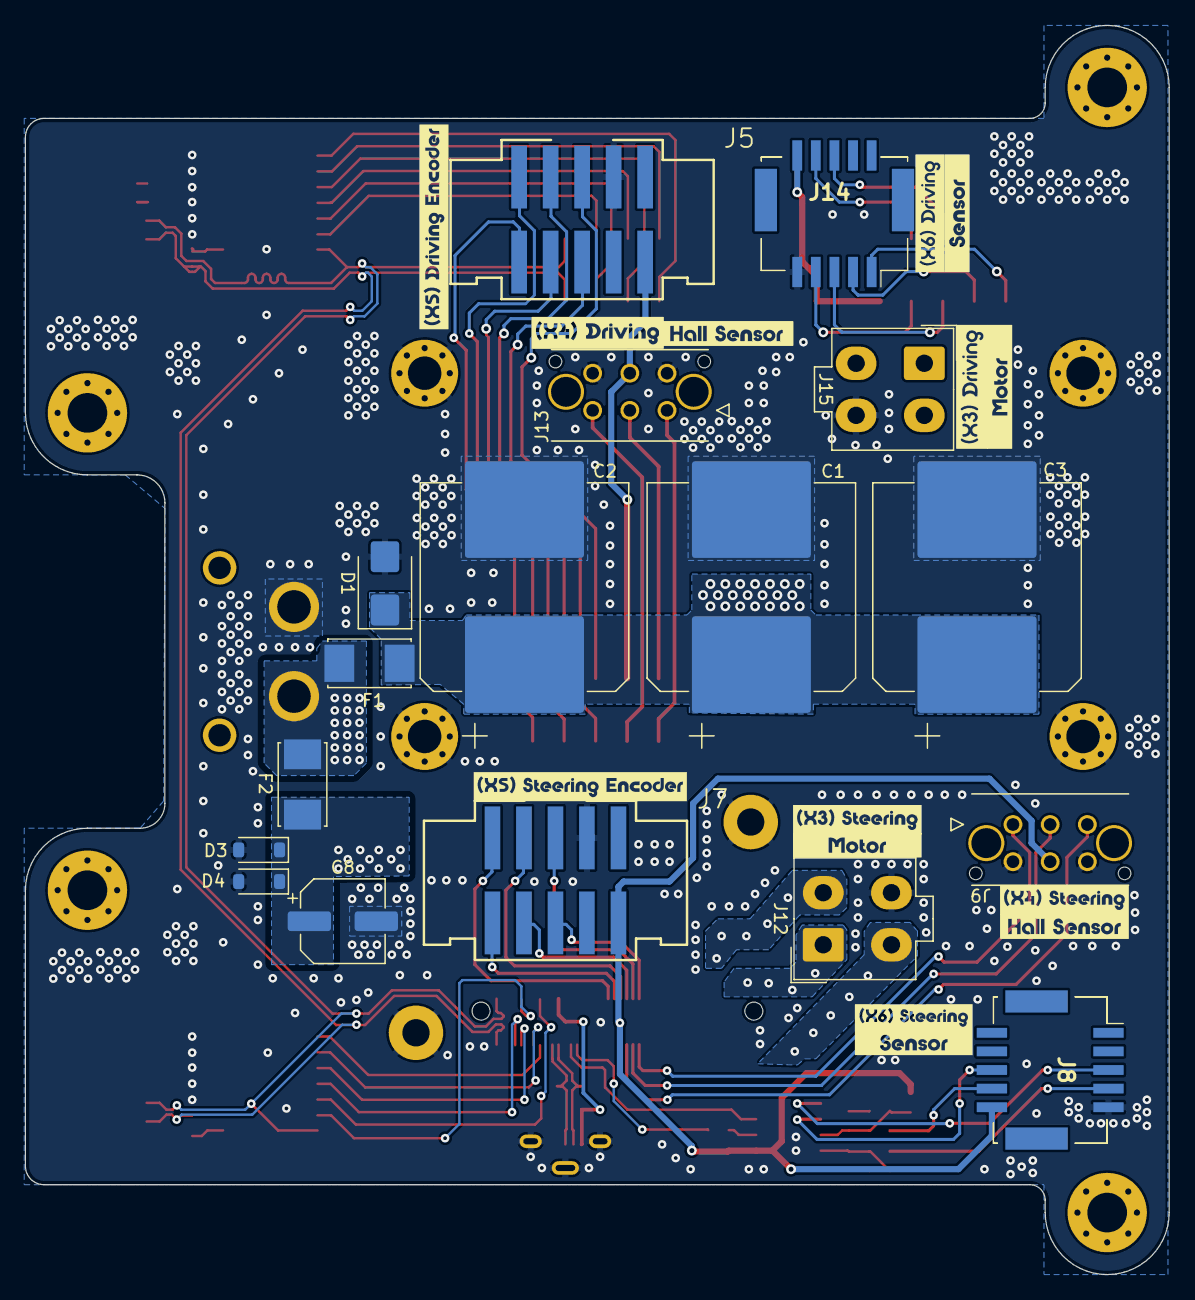
[picture p82: board nav_lower_controller.kicad_pcb from below]

Board: 4 copper layers, 92.2 x 100.8 mm, 88 parts (31 on the bottom side), 69 nets.

Parts:
C1, C2, C3: 390uF 63V (UCZ1J391MNS1MS); CP_Elec_16x17.5
C4, C5, C6, C7: 330nF; C_0603_1608Metric
C8: 68uF (EEHZA1V680XP); CP_Elec_6.3x7.7
C9, C10: 220pF 50V C0G; C_0603_1608Metric
C11: 0.1uF 50V X7R; C_0603_1608Metric
CAN1: G***; kibuzzard-642A8EDE
D1, D2: SMBJ54A; D_SMB
D3, D4: SMF30A; D_SOD-123
D5: PRTR5V0U2X; SOT-143
F1, F2: 0157010; Fuseholder_Littelfuse_Nano2_157x
H1, H2, H3, H4: M2.5 (2.7mm); MountingHole_2.7mm_M2.5_Pad_Via
H5, H6, H7, H8: M3 (3.2mm); MountingHole_3.2mm_M3_Pad_Via
H9, H10: M2 (2.2mm); MountingHole_2.2mm_M2_Pad
J1: Power supply (X1) - XT60; XT60PWM
J2: CAN 1 (X2) - Molex CLIK-Mate; 2132260431
J3: CAN2 (X3) - Molex CLIK-Mate; 2132260431
J4: 02x23 Socket header (SSM-123-L-DV); SSM-123-L-DV
J5, J7: Encoder (X5) - Pin headers 2.54mm; SAMTEC-HTST-105-01-X-DV
J6: 02x16 Socket header (SSM-116-L-DV); SSM-116-L-DV
J8, J14: Sensor (X6) - Molex CLIK-Mate; MOLEX_5031541090
J9, J13: Hall Sensor (X4) - Molex Micro-Fit 3.0; MOLEX_43045-0624
J10: EPOS4 Micro 24/5 CAN Terminal/socket (LSHM-140-02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; Samtec_LSHM-140-xx.x-x-DV-N_2x40_P0.50mm_Vertical
J11: USB_B_Micro; USB_Micro-B_Molex-105133-0001
J12, J15: Motor (X4) - Molex Mini-Fit Jr.; Molex_Mini-Fit_Jr_5566-04A_2x02_P4.20mm_Vertical
R1, R6: 120R; R_0603_1608Metric
R2, R3, R4, R5: 100k; R_0603_1608Metric
R7, R8: 150R; R_0603_1608Metric
R9, R10: 20k; R_0603_1608Metric
R11: 22k; R_0603_1608Metric
R12: 1k; R_0603_1608Metric
SW1, SW2: 218-8LPST; 2188LPST
U1: ISL8490E; ISL8490E-SOIC-8
kibuzzard-642A0BFC: G***; kibuzzard-642A0BFC
kibuzzard-642A0CF2: G***; kibuzzard-642A0CF2
kibuzzard-642A0D20: G***; kibuzzard-642A0D20
kibuzzard-642A04E4: G***; kibuzzard-642A04E4
kibuzzard-642A8EC3, kibuzzard-642A8EC3#2: G***; kibuzzard-642A8EC3
kibuzzard-642A8EC9, kibuzzard-642A8EC9#2: G***; kibuzzard-642A8EC9
kibuzzard-642A8ED1, kibuzzard-642A8ED1#2: G***; kibuzzard-642A8ED1
kibuzzard-642A8ED7, kibuzzard-642A8ED7#2: G***; kibuzzard-642A8ED7
kibuzzard-642A8EDE: G***; kibuzzard-642A8EDE
kibuzzard-642A8F3A: G***; kibuzzard-642A8F3A
kibuzzard-642A8F16: G***; kibuzzard-642A8F16
kibuzzard-642A8FAF: G***; kibuzzard-642A8FAF
kibuzzard-642A8FCA: G***; kibuzzard-642A8FCA
kibuzzard-642A8FD2: G***; kibuzzard-642A8FD2
kibuzzard-642A8FE0: G***; kibuzzard-642A8FE0
kibuzzard-642A056F: G***; kibuzzard-642A056F
kibuzzard-642A90A5: G***; kibuzzard-642A90A5
kibuzzard-642A90B7: G***; kibuzzard-642A90B7
kibuzzard-642A90CC: G***; kibuzzard-642A90CC
kibuzzard-642A90E8: G***; kibuzzard-642A90E8
kibuzzard-642A907B: G***; kibuzzard-642A907B
kibuzzard-642A9061: G***; kibuzzard-642A9061
kibuzzard-642A9082: G***; kibuzzard-642A9082
kibuzzard-642A9089: G***; kibuzzard-642A9089
kibuzzard-642A9101: G***; kibuzzard-642A9101

Connections:
/Driving controller/Auto bit rate: J4.34, SW1.6
/Driving controller/CAN ID 1: J4.29, SW1.1
/Driving controller/CAN ID 2: J4.30, SW1.2
/Driving controller/CAN ID 3: J4.31, SW1.3
/Driving controller/CAN ID 4: J4.32, SW1.4
/Driving controller/CAN ID 5: J4.33, SW1.5
/Driving controller/CAN+: J2.1, J3.1, J4.35, J10.79, R1.2, R6.2
/Driving controller/CAN-: J2.2, J3.2, J4.36, J10.80, SW1.7, SW2.7
/Driving controller/CHA: J5.6, J6.27
/Driving controller/CHA\: J5.5, J6.28
/Driving controller/CHA/HsDigIN1: J4.7, J14.1
/Driving controller/CHB: J5.8, J6.29
/Driving controller/CHB\: J5.7, J6.30
/Driving controller/CHB/HsDigIN2: J4.9, J14.3
/Driving controller/CHI: J5.10, J6.31
/Driving controller/CHI\: J5.9, J6.32
/Driving controller/Clock/HsDigOUT1: J4.11, J14.5
/Driving controller/Clock/HsDigOUT1\: J4.12, J14.6
/Driving controller/Data/HsDigIN4: J4.13, J14.7
/Driving controller/Data/HsDigIN4\: J4.14, J14.8
/Driving controller/HS1-IN: J6.23, J13.1
/Driving controller/HS2-IN: J6.24, J13.2
/Driving controller/HS3-IN: J6.25, J13.3
/Driving controller/M1/M+: J6.1, J6.2, J6.3, J6.4, J15.1
/Driving controller/M2/M-: J6.5, J6.6, J6.7, J6.8, J15.2
/Driving controller/M3: J6.9, J6.10, J6.11, J6.12, J15.3
/Driving controller/VCC_fused: C1.1, C2.1, C3.1, D1.1 (K), F1.2, J6.13, J6.14, J6.15, J6.16
/Steering controller/Auto bit rate: J10.72, SW2.6
/Steering controller/CAN ID 1: J10.65, SW2.1
/Steering controller/CAN ID 2: J10.67, SW2.2
/Steering controller/CAN ID 3: J10.71, SW2.3
/Steering controller/CAN ID 4: J10.73, SW2.4
/Steering controller/CAN ID 5: J10.66, SW2.5
/Steering controller/CHA: J7.6, J10.34
/Steering controller/CHA\: J7.5, J10.36
/Steering controller/CHB: J7.8, J10.38
/Steering controller/CHB\: J7.7, J10.40
/Steering controller/CHI: J7.10, J10.42
/Steering controller/CHI\: J7.9, J10.44
/Steering controller/Clock/HsDigOUT1: J8.5, U1.5 (Y)
/Steering controller/Clock/HsDigOUT1\: J8.6, U1.6 (Z)
/Steering controller/Clock/HsDigOUT1_A55: J10.55, U1.3 (DI)
/Steering controller/Data/HsDigIN4: J8.7, R7.1
/Steering controller/Data/HsDigIN4\: J8.8, R8.1
/Steering controller/Data/HsDigIN4_A53: J10.53, R12.2
/Steering controller/HS1-IN: J9.1, J10.33
/Steering controller/HS2-IN: J9.2, J10.35
/Steering controller/HS3-IN: J9.3, J10.37
/Steering controller/M1/M+: J10.1, J10.2, J10.3, J10.4, J10.5, J10.6, J12.1
/Steering controller/M2/M-: J10.7, J10.8, J10.9, J10.10, J10.11, J10.12, J12.2
/Steering controller/M3: J10.13, J10.14, J10.15, J10.16, J10.17, J10.18, J12.3
/Steering controller/RS422 interface/ISL_A: C9.1, R7.2, R11.1, U1.8 (A)
/Steering controller/RS422 interface/ISL_B: C10.1, R8.2, R9.1, R10.2, U1.7 (B)
/Steering controller/RS422 interface/ISL_RO: R12.1, U1.2 (RO)
/Steering controller/USB_D+: D5.2 (I/O1), J10.61, J11.3 (D+)
/Steering controller/USB_D-: D5.3 (I/O2), J10.59, J11.2 (D-)
/Steering controller/VCC_fused: C8.1, D3.1 (K), D4.1 (K), F2.2, J10.19, J10.20, J10.21, J10.22, J10.23, J10.24, J10.26
GND: C1.2, C2.2, C3.2, C4.2, C5.2, C6.2, C7.2, C8.2, C9.2, C10.2, C11.2, D1.2 (A), D2.2 (A), D3.2 (A), D4.2 (A), D5.1 (GND), H1.1, H2.1, H3.1, H4.1, H9.1, H10.1, J1.1, J2.3, J2.4, J3.3, J3.4, J4.16, J4.18, J4.20, J4.37, J4.38, J5.3, J6.18, J6.19, J6.20, J6.21, J6.22, J7.3, J8.9, J9.4, J9.6, J10.25, J10.27, J10.28, J10.29, J10.30, J10.31, J10.32, J10.57, J10.58, J10.63, J10.64, J10.75, J10.76, J11.5 (GND), J11.6 (Shield), J12.4, J13.4, J13.6, J14.9, J15.4, R2.2, R3.2, R4.2, R5.2, R9.2, R11.2, SW1.11, SW1.12, SW1.13, SW1.14, SW1.15, SW1.16, SW2.11, SW2.12, SW2.13, SW2.14, SW2.15, SW2.16, U1.4 (GND)
unnamed: C4.1, H5.1, R2.1
unnamed: C5.1, H6.1, R3.1
unnamed: C6.1, H7.1, R4.1
unnamed: C7.1, H8.1, R5.1
unnamed: R1.1, SW1.10
unnamed: R6.1, SW2.10
VBUS: D5.4 (VCC), J10.60, J11.1 (VBUS)
VCC: D2.1 (K), F1.1, F2.1, J1.2, J6.17
Vaux2: J4.15, J4.17, J4.19, J14.10
Vsensor: C11.1, J7.2, J8.10, J9.5, J10.39, R10.1, U1.1 (VCC)
Vsensor2: J5.2, J6.26, J13.5
