EPFLXplore/ERC_AV_HW/hats/ADS1115_POTENTIOMETER/ADS1115_POTENTIOMETER.kicad_pcb

## KiCad design hats/ADS1115_POTENTIOMETER/ADS1115_POTENTIOMETER.kicad_pcb (2024-02-15)

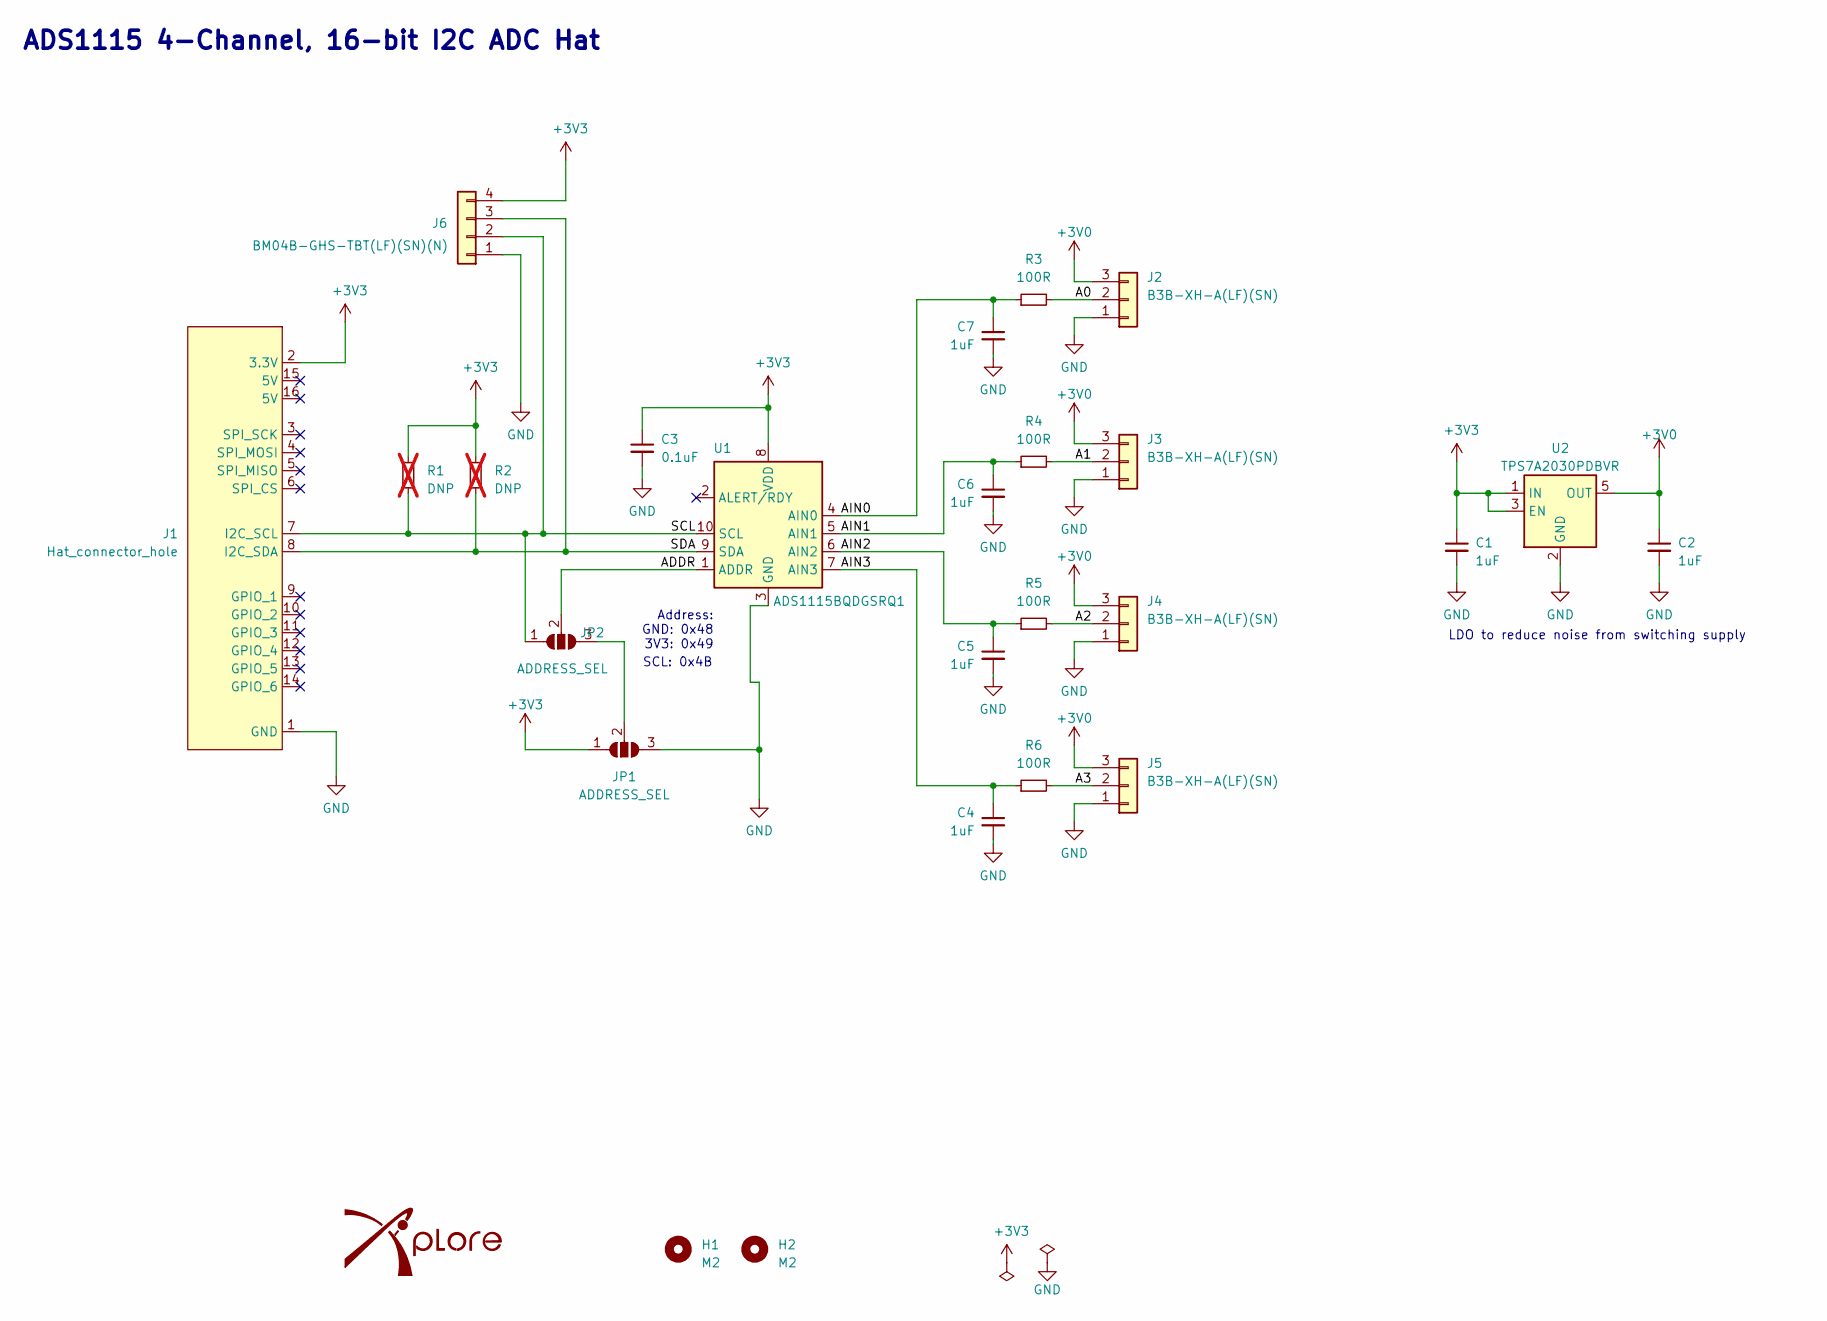
[picture p83: schematic ADS1115_POTENTIOMETER.kicad_sch, ADS1115 16-bit 4-channel ADC Hat]

Parts:
C1, C2, C4, C5, C6, C7: 1uF; C_0603_1608Metric_Pad1.08x0.95mm_HandSolder; Digikey ref 587-2984-1-ND
C3: 0.1uF; C_0603_1608Metric_Pad1.08x0.95mm_HandSolder; Digikey ref 478-KGM15BR71H104JTCT-ND
G1: Xplore_Logo; Xplore_Logo_X_only_10mm
H1, H2: M2; MountingHole_2.2mm_M2
J1: Hat_connector_hole
J2, J3, J4, J5: B3B-XH-A(LF)(SN); JST_XH_B3B-XH-A_1x03_P2.50mm_Vertical; Digikey ref 455-2248-ND
J6: BM04B-GHS-TBT(LF)(SN)(N); PicoBlade-JST-GH-1x04_1.25mm_Vertical; Digikey ref 455-1580-1-ND
JP1, JP2: ADDRESS_SEL; SolderJumper-3_P1.3mm_Open_RoundedPad1.0x1.5mm
R1, R2: DNP; R_0603_1608Metric_Pad0.98x0.95mm_HandSolder; not fitted
R3, R4, R5, R6: 100R; R_0603_1608Metric_Pad0.98x0.95mm_HandSolder; Digikey ref RMCF0603FT100RCT-ND
U1: ADS1115BQDGSRQ1; VSSOP-10_3x3mm_P0.5mm; Mouser ref 595-ADS1115BQDGSRQ1
U2: TPS7A2030PDBVR; SOT-23-5; Digikey ref 296-TPS7A2030PDBVRCT-ND

Connections:
+3V0: C2.1, J2.3, J3.3, J4.3, J5.3, U2.5 (OUT)
+3V3: C1.1, C3.1, J1.2 (3.3V), J6.4, JP1.1 (A), R1.1, R2.1, U1.8 (VDD), U2.1 (IN), U2.3 (EN)
/A0: J2.2, R3.2
/A1: J3.2, R4.2
/A2: J4.2, R5.2
/A3: J5.2, R6.2
/ADDR: JP2.2 (C), U1.1 (ADDR)
/AIN0: C7.1, R3.1, U1.4 (AIN0)
/AIN1: C6.1, R4.1, U1.5 (AIN1)
/AIN2: C5.1, R5.1, U1.6 (AIN2)
/AIN3: C4.1, R6.1, U1.7 (AIN3)
/SCL: J1.7 (I2C_SCL), J6.2, JP2.1 (A), R1.2, U1.10 (SCL)
/SDA: J1.8 (I2C_SDA), J6.3, R2.2, U1.9 (SDA)
GND: C1.2, C2.2, C3.2, C4.2, C5.2, C6.2, C7.2, J1.1 (GND), J2.1, J3.1, J4.1, J5.1, J6.1, JP1.3 (B), U1.3 (GND), U2.2 (GND)
unnamed: JP1.2 (C), JP2.3 (B)

Notes on the sheet:
ADS1115 4-Channel, 16-bit I2C ADC Hat
Address: GND: 0x48 3V3: 0x49
LDO to reduce noise from switching supply
SCL: 0x4B

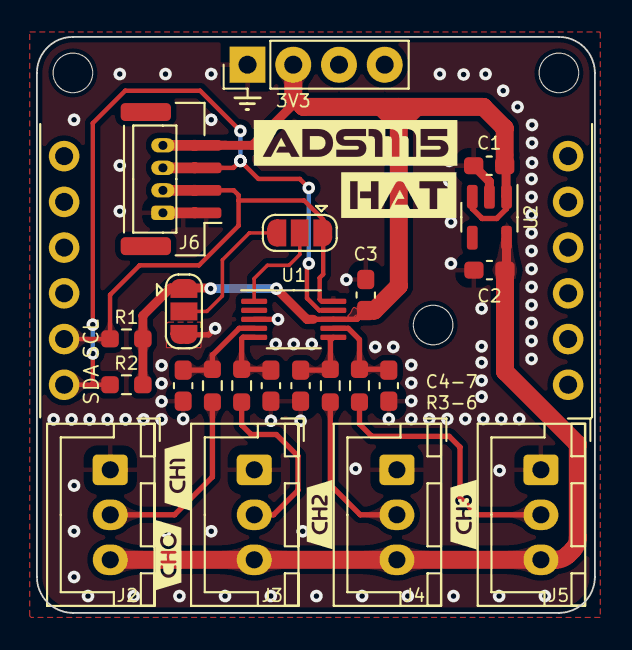
[picture p84: board ADS1115_POTENTIOMETER.kicad_pcb from above]

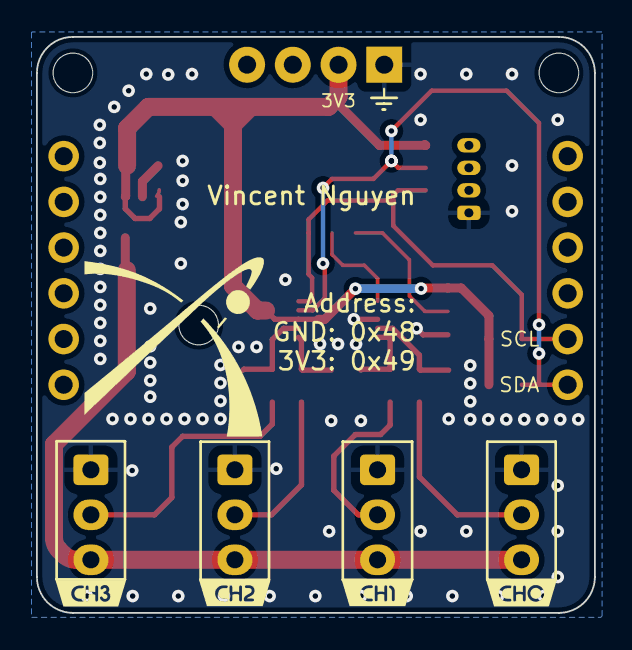
[picture p85: board ADS1115_POTENTIOMETER.kicad_pcb from below]

Board: 2 copper layers, 31.0 x 32.0 mm, 37 parts (6 on the bottom side), 15 nets.

Other parts of the board:
kibuzzard-64B1E9EE: G***; kibuzzard-64B1E9EE
kibuzzard-64B1E571: G***; kibuzzard-64B1E571
kibuzzard-64B1E576: G***; kibuzzard-64B1E576
kibuzzard-64B1EA4E: G***; kibuzzard-64B1EA4E
kibuzzard-64B1EA07: G***; kibuzzard-64B1EA07
kibuzzard-64B1EA19: G***; kibuzzard-64B1EA19
kibuzzard-64B1EB6B: G***; kibuzzard-64B1EB6B
kibuzzard-64B2D70A: G***; kibuzzard-64B2D70A
kibuzzard-64B2D711: G***; kibuzzard-64B2D711
kibuzzard-64B2D718: G***; kibuzzard-64B2D718
kibuzzard-64B2D724: G***; kibuzzard-64B2D724
