EPFLXplore/ERC_AV_HW/hats/RS485_interface/RS485_interface.kicad_pcb

## KiCad design hats/RS485_interface/RS485_interface.kicad_pcb (2023-09-30)

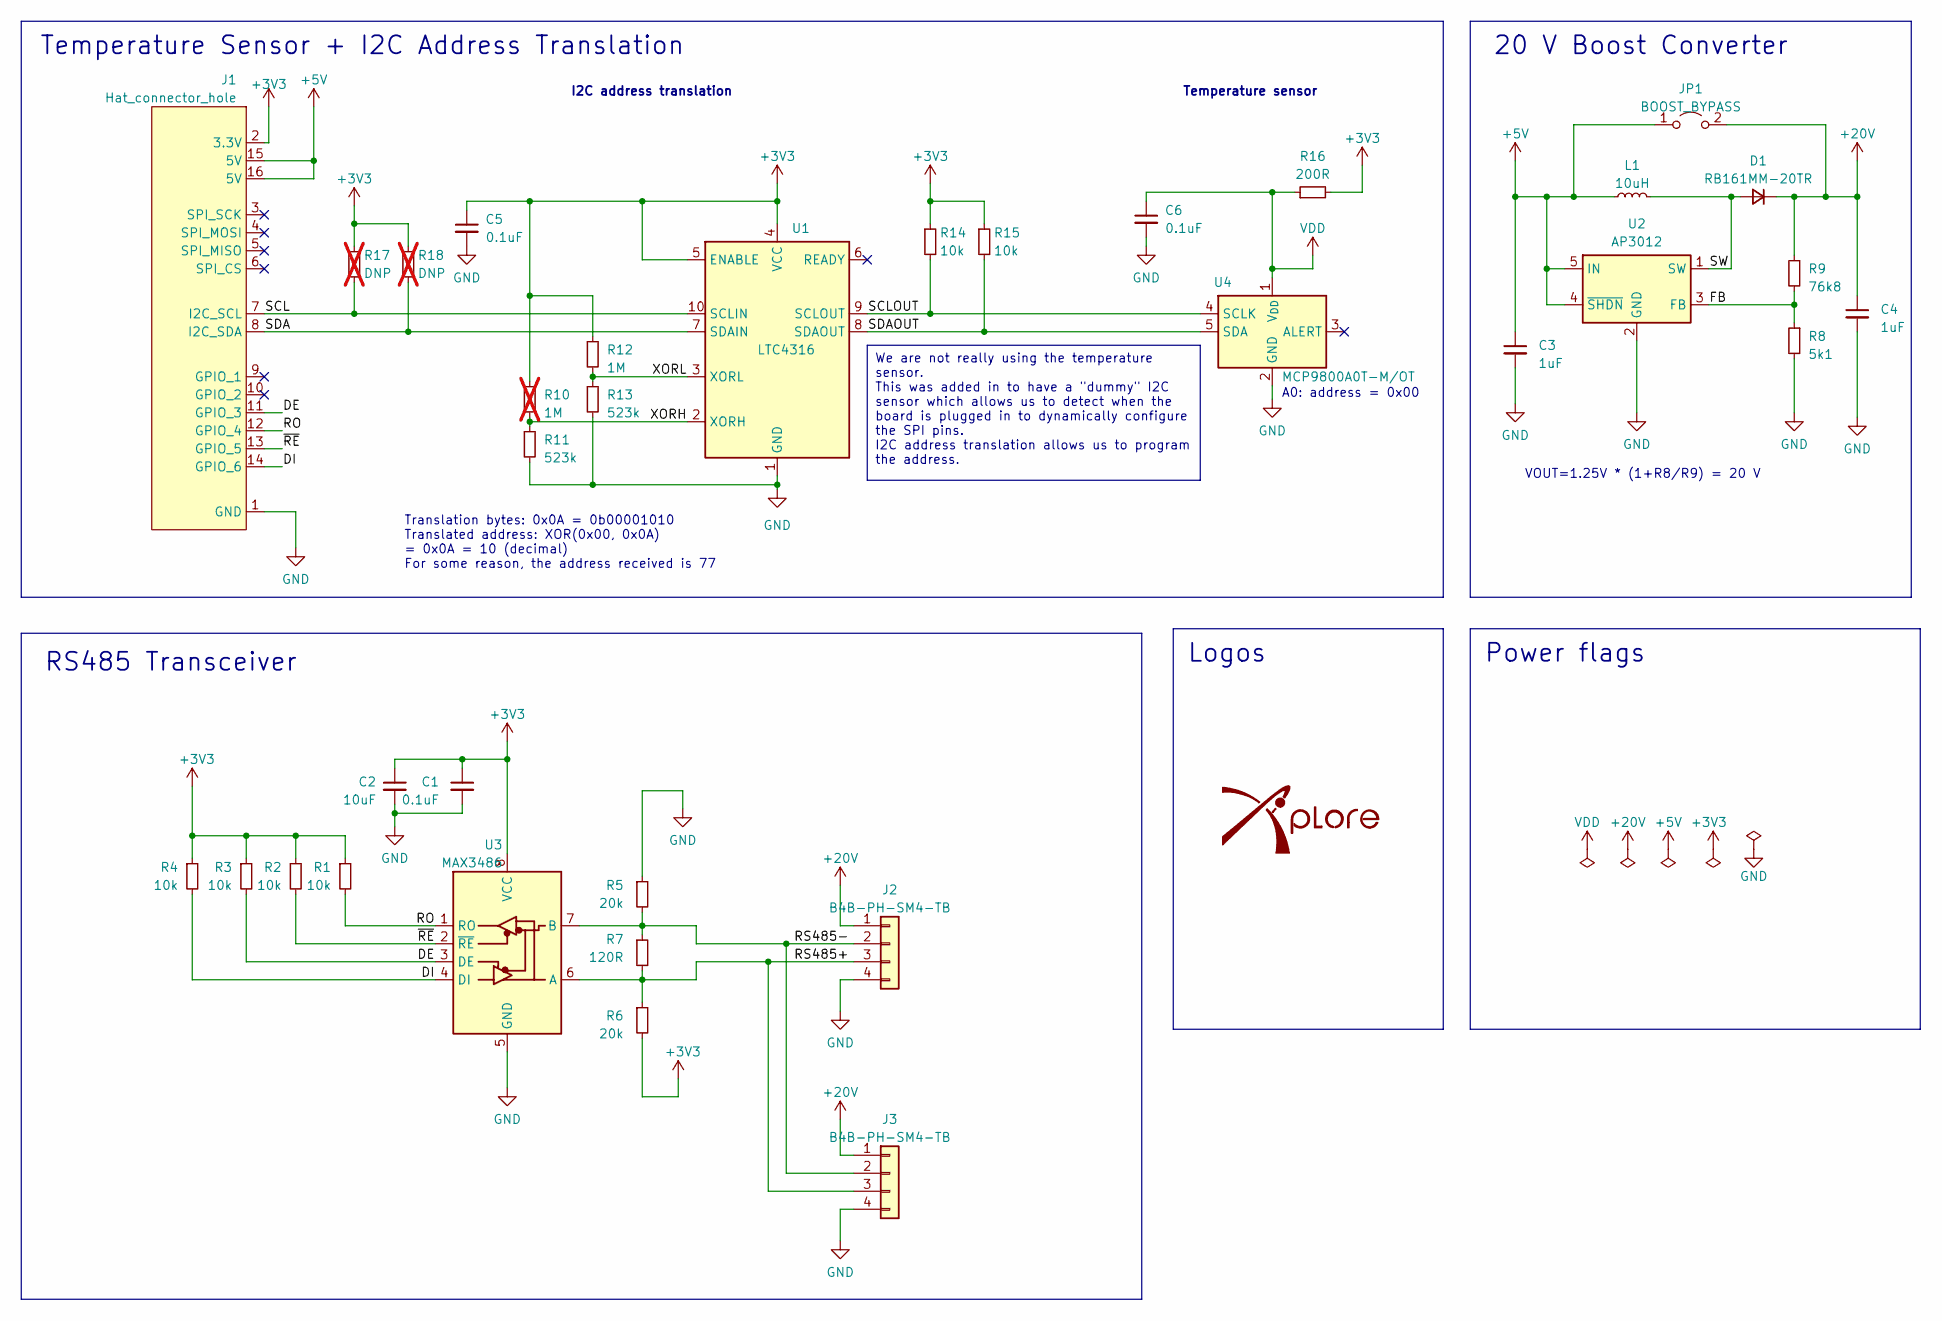
[picture p86: schematic RS485_interface.kicad_sch, RS485 Transceiver Hat]

Parts:
C1: 0.1uF; C_0603_1608Metric_Pad1.08x0.95mm_HandSolder; Digikey ref 478-KGM15BR71H104JTCT-ND
C2: 10uF; C_0603_1608Metric_Pad1.08x0.95mm_HandSolder; Digikey ref 1276-1948-1-ND
C3, C4: 1uF; C_0603_1608Metric_Pad1.08x0.95mm_HandSolder; Digikey ref 587-3247-1-ND
C5, C6: 0.1uF; C_0603_1608Metric; Digikey ref 478-KGM15BR71H104JTCT-ND
D1: RB161MM-20TR; D_SOD-123F; Digikey ref RB161MM-20CT-ND
G1: Xplore_Logo; Xplore_Logo_X_only_10mm
J1: Hat_connector_hole
J2, J3: B4B-PH-SM4-TB; JST_PH_B4B-PH-SM4-TB_1x04-1MP_P2.00mm_Vertical; Digikey ref 455-B4B-PH-SM4-TBCT-ND
JP1: BOOST_BYPASS; SolderJumper-2_P1.3mm_Open_RoundedPad1.0x1.5mm
L1: 10uH; L_1210_3225Metric_Pad1.42x2.65mm_HandSolder; Digikey ref 490-10589-1-ND
R1, R2, R3, R4: 10k; R_0603_1608Metric_Pad0.98x0.95mm_HandSolder; Digikey ref RNCP0603FTD10K0CT-ND
R5, R6: 20k; R_0603_1608Metric_Pad0.98x0.95mm_HandSolder; Digikey ref A102237CT-ND
R7: 120R; R_0603_1608Metric_Pad0.98x0.95mm_HandSolder; Digikey ref 541-120SCT-ND
R8: 5k1; R_0603_1608Metric_Pad0.98x0.95mm_HandSolder; Digikey ref 13-RC0603FR-135K1LCT-ND
R9: 76k8; R_0603_1608Metric_Pad0.98x0.95mm_HandSolder; Digikey ref 311-76.8KHRCT-ND
R10: 1M; R_0603_1608Metric; Digikey ref A121559CT-ND; not fitted
R11, R13: 523k; R_0603_1608Metric; Digikey ref 311-523KHRCT-ND
R12: 1M; R_0603_1608Metric; Digikey ref A121559CT-ND
R14, R15: 10k; R_0603_1608Metric; Digikey ref RNCP0603FTD10K0CT-ND
R16: 200R; R_0603_1608Metric; Digikey ref RHM200ADCT-ND
R17, R18: DNP; R_0603_1608Metric; not fitted
U1: LTC4316; MSOP-10_3x3mm_P0.5mm; Digikey ref 505-LTC4316IMS#PBF-ND
U2: AP3012; SOT-23-5; Digikey ref AP3012KTR-G1DICT-ND
U3: MAX3486; SOIC-8_3.9x4.9mm_P1.27mm; Digikey ref MAX3486ESA+CT-ND
U4: MCP9800A0T-M/OT; SOT-23-5; Digikey ref MCP9800A0T-M/OTCT-ND

Connections:
+3V3: C1.1, C2.1, C5.1, J1.2 (3.3V), R1.1, R2.1, R3.1, R4.1, R6.2, R10.1, R12.1, R14.1, R15.1, R16.2, R17.1, R18.1, U1.4 (VCC), U1.5 (ENABLE), U3.8 (VCC)
+5V: C3.1, J1.15 (5V), J1.16 (5V), JP1.1 (A), L1.1, U2.4 (~SHDN), U2.5 (IN)
+20V: C4.1, D1.1 (K), J2.1, J3.1, JP1.2 (B), R9.1
/DE: J1.11 (GPIO_3), R3.2, U3.3 (DE)
/DI: J1.14 (GPIO_6), R4.2, U3.4 (DI)
/FB: R8.1, R9.2, U2.3 (FB)
/RO: J1.12 (GPIO_4), R1.2, U3.1 (RO)
/RS485+: J2.3, J3.3, R6.1, R7.2, U3.6 (A)
/RS485-: J2.2, J3.2, R5.2, R7.1, U3.7 (B)
/SCL: J1.7 (I2C_SCL), R17.2, U1.10 (SCLIN)
/SCLOUT: R14.2, U1.9 (SCLOUT), U4.4 (SCLK)
/SDA: J1.8 (I2C_SDA), R18.2, U1.7 (SDAIN)
/SDAOUT: R15.2, U1.8 (SDAOUT), U4.5 (SDA)
/SW: D1.2 (A), L1.2, U2.1 (SW)
/XORH: R10.2, R11.1, U1.2 (XORH)
/XORL: R12.2, R13.1, U1.3 (XORL)
/~RE: J1.13 (GPIO_5), R2.2, U3.2 (~RE)
GND: C1.2, C2.2, C3.2, C4.2, C5.2, C6.2, J1.1 (GND), J2.4, J3.4, R5.1, R8.2, R11.2, R13.2, U1.1 (GND), U2.2 (GND), U3.5 (GND), U4.2 (GND)
VDD: C6.1, R16.1, U4.1 (V_{DD})

Notes on the sheet:
We are not really using the temperature sensor. This was added in to have a "dummy" I2C sensor which allows us to detect when the board is plugged in to dynamically configure the SPI pins. I2C address translation allows us to program the address.
A0: address = 0x00
Translation bytes: 0x0A = 0b00001010 Translated address: XOR(0x00, 0x0A) = 0x0A = 10 (decimal) For some reason, the address received is 77
I2C address translation
20 V Boost Converter
Logos
Power flags
RS485 Transceiver
Temperature Sensor + I2C Address Translation
VOUT=1.25V * (1+R8/R9) = 20 V
Temperature sensor

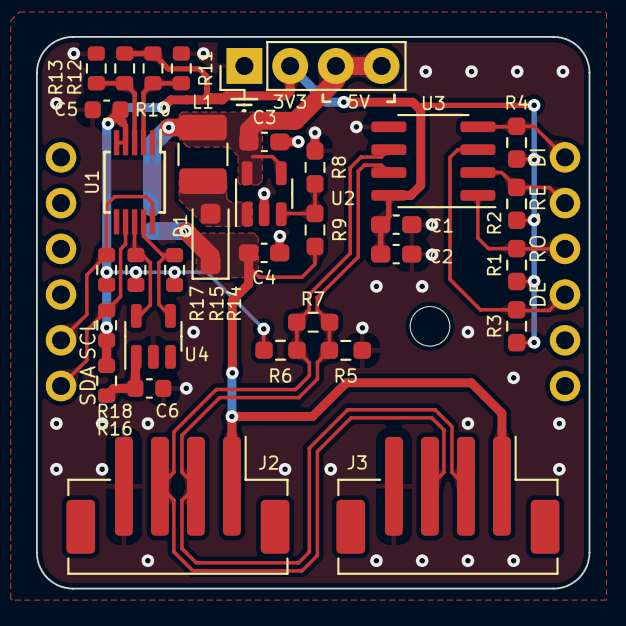
[picture p87: board RS485_interface.kicad_pcb from above]

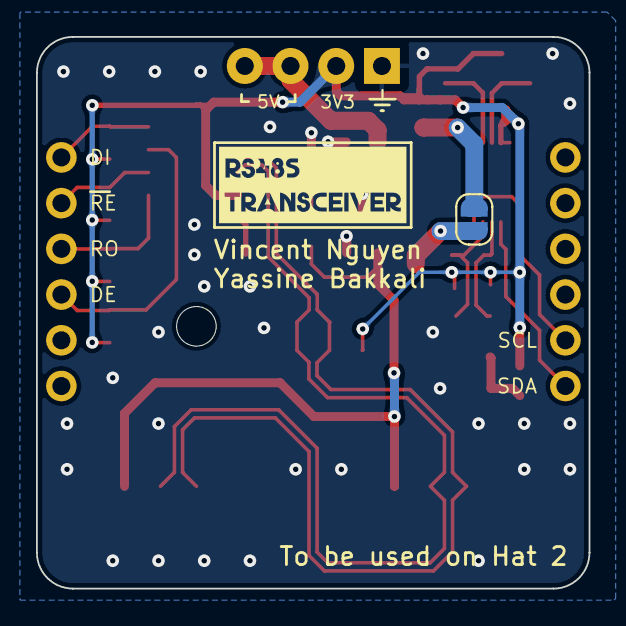
[picture p88: board RS485_interface.kicad_pcb from below]

Board: 2 copper layers, 30.7 x 30.7 mm, 35 parts (2 on the bottom side), 19 nets.

Other parts of the board:
kibuzzard-64B3FF95: G***; kibuzzard-64B3FF95
