EPFLXplore/ERC_AV_HW/hats/untested/Yassine_Leds/Yassine_Leds.kicad_pcb

## KiCad design hats/untested/Yassine_Leds/Yassine_Leds.kicad_pcb (2023-09-30)

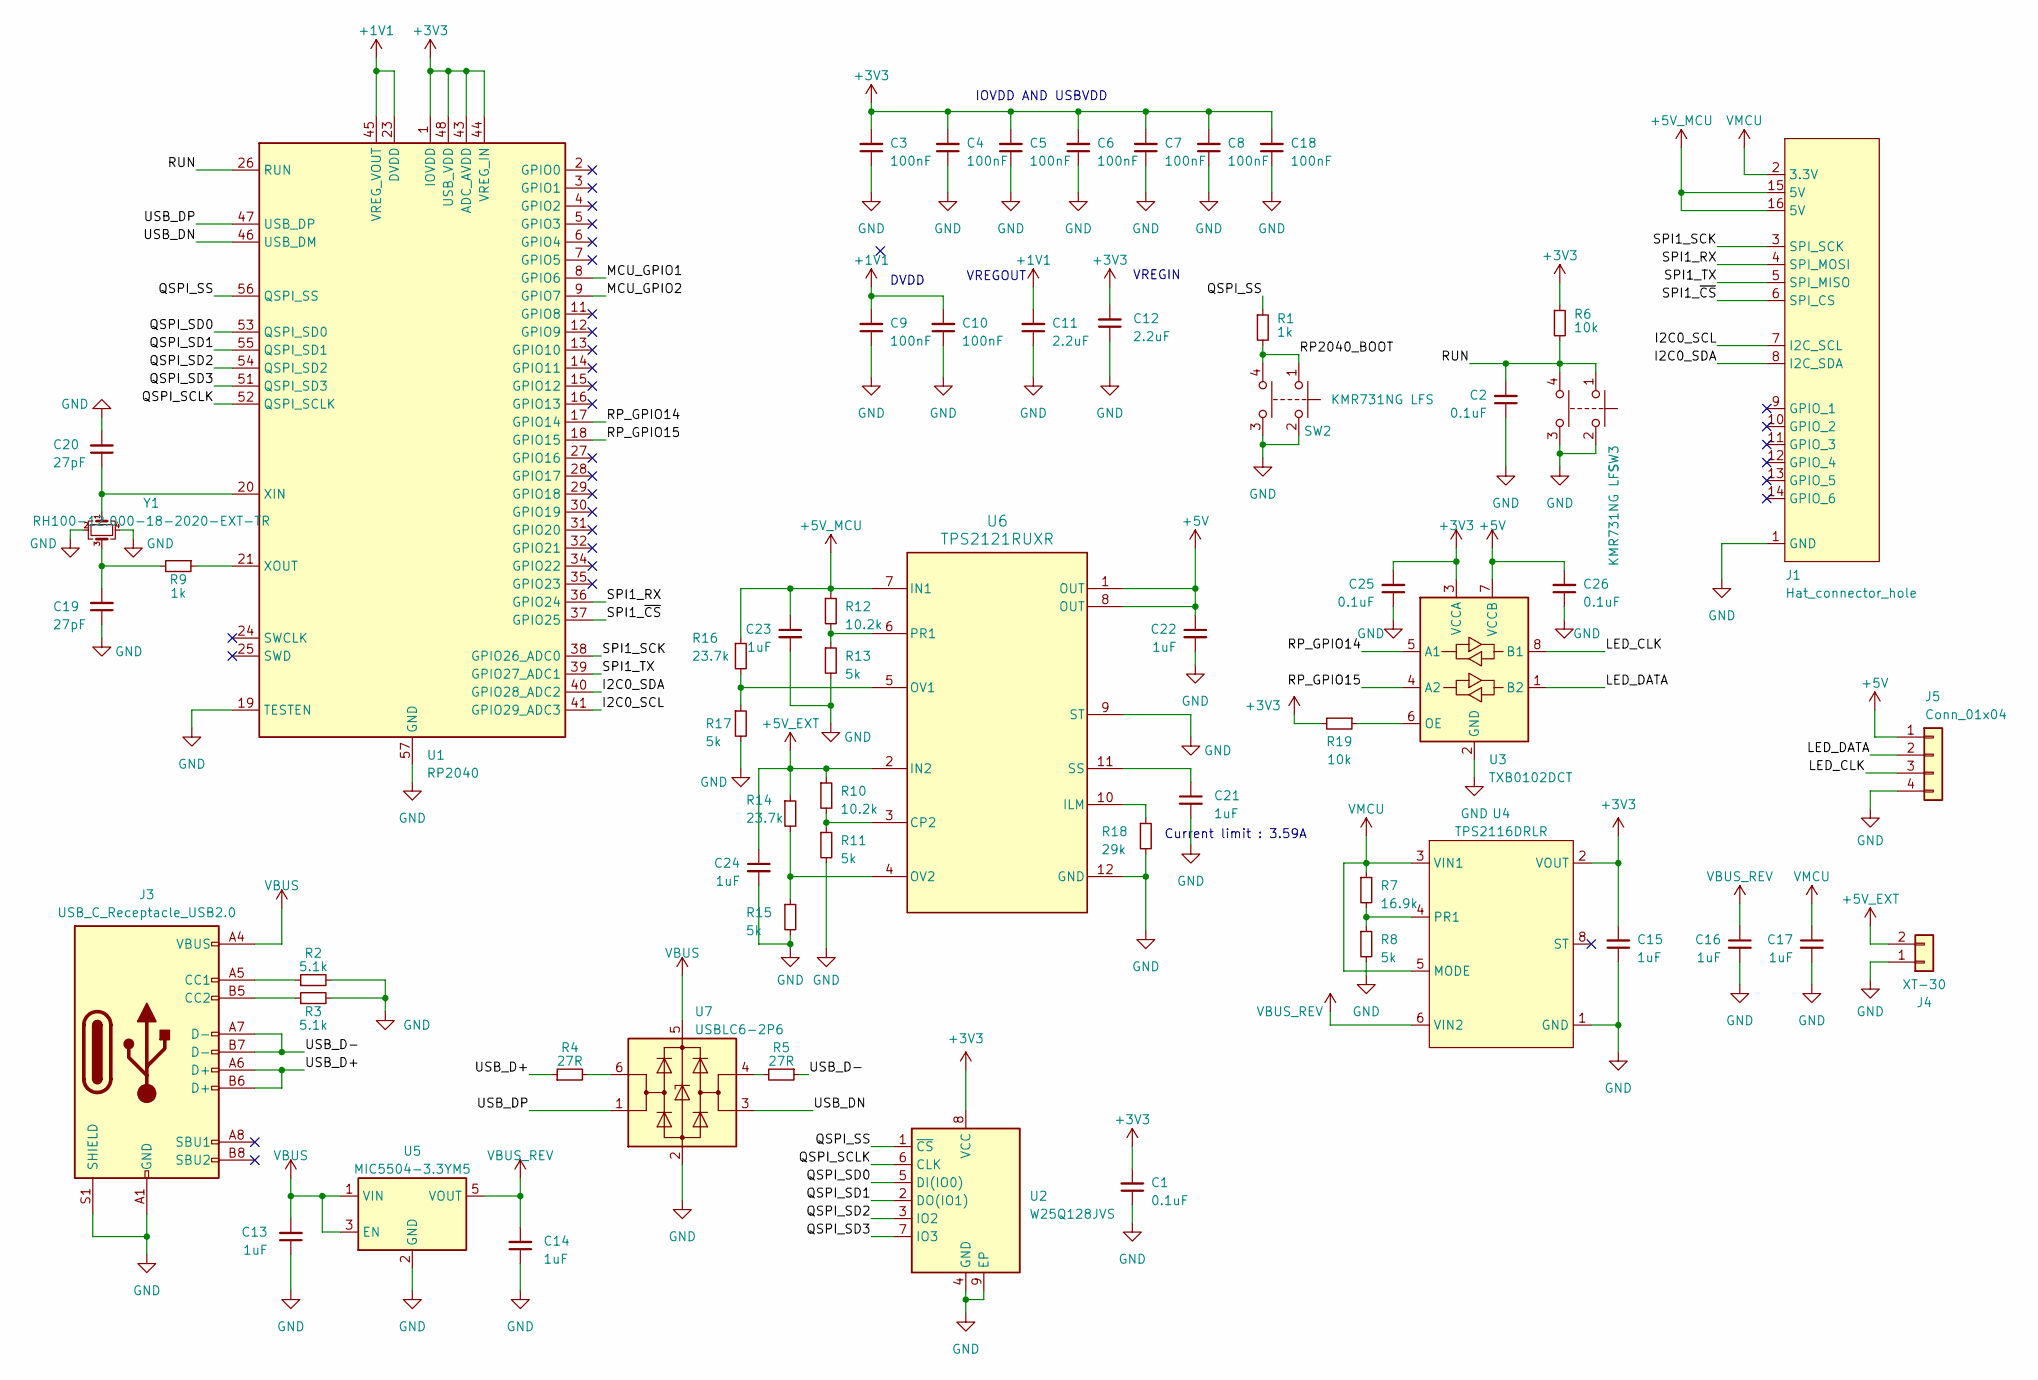
[picture p89: schematic Yassine_Leds.kicad_sch]

Parts:
C1, C2, C25, C26: 0.1uF; C_0402_1005Metric_Pad0.74x0.62mm_HandSolder
C3, C4, C5, C6, C7, C8, C9, C10, C18: 100nF; C_0402_1005Metric_Pad0.74x0.62mm_HandSolder
C11, C12: 2.2uF; C_0402_1005Metric_Pad0.74x0.62mm_HandSolder
C13, C14, C15, C16, C17, C21, C22, C23, C24: 1uF; C_0402_1005Metric_Pad0.74x0.62mm_HandSolder
C19, C20: 27pF; C_0402_1005Metric_Pad0.74x0.62mm_HandSolder
J1: Hat_connector_hole
J3: USB_C_Receptacle_USB2.0; USB_C_Receptacle_GCT_USB4105-xx-A_16P_TopMnt_Horizontal
J4: XT-30; AMASS_XT30U-M_1x02_P5.0mm_Vertical
J5: Conn_01x04; JST_XH_B4B-XH-A_1x04_P2.50mm_Vertical
R1, R9: 1k; R_0402_1005Metric_Pad0.72x0.64mm_HandSolder
R2, R3: 5.1k; R_0402_1005Metric_Pad0.72x0.64mm_HandSolder
R4, R5: 27R; R_0402_1005Metric_Pad0.72x0.64mm_HandSolder
R6, R19: 10k; R_0402_1005Metric_Pad0.72x0.64mm_HandSolder
R7: 16.9k; R_0402_1005Metric_Pad0.72x0.64mm_HandSolder
R8, R11, R13, R15, R17: 5k; R_0402_1005Metric_Pad0.72x0.64mm_HandSolder
R10, R12: 10.2k; R_0402_1005Metric_Pad0.72x0.64mm_HandSolder
R14, R16: 23.7k; R_0402_1005Metric_Pad0.72x0.64mm_HandSolder
R18: 29k; R_0402_1005Metric_Pad0.72x0.64mm_HandSolder
SW2, SW3: KMR731NG LFS; SW_KMR731NGLFS
U1: RP2040; QFN-56-1EP_7x7mm_P0.4mm_EP3.2x3.2mm
U2: W25Q128JVS; WSON-8-1EP_6x5mm_P1.27mm_EP3.4x4.3mm
U3: TXB0102DCT; TSSOP-8_3x3mm_P0.65mm
U4: TPS2116DRLR
U5: MIC5504-3.3YM5; SOT-23-5
U6: TPS2121RUXR; IC_TPS2121RUXR
U7: USBLC6-2P6; SOT-666
Y1: RH100-12.000-18-2020-EXT-TR; Crystal_SMD_3225-4Pin_3.2x2.5mm

Connections:
+1V1: C9.2, C10.2, C11.2, U1.23 (DVDD), U1.45 (VREG_VOUT), U1.50 (DVDD)
+3V3: C1.2, C3.2, C4.2, C5.2, C6.2, C7.2, C8.2, C12.2, C15.2, C18.2, C25.2, R6.1, R19.2, U1.1 (IOVDD), U1.10 (IOVDD), U1.22 (IOVDD), U1.33 (IOVDD), U1.42 (IOVDD), U1.43 (ADC_AVDD), U1.44 (VREG_IN), U1.48 (USB_VDD), U1.49 (IOVDD), U2.8 (VCC), U3.3 (VCCA), U4.2 (VOUT), U4.7 (VOUT)
+5V: C22.1, C26.2, J5.1, U3.7 (VCCB), U6.1 (OUT), U6.1_1 (OUT), U6.8 (OUT), U6.8_1 (OUT)
+5V_EXT: C24.1, J4.2, R10.1, R14.1, U6.2 (IN2), U6.2_1 (IN2)
+5V_MCU: C23.1, J1.15 (5V), J1.16 (5V), R12.1, R16.1, U6.7 (IN1), U6.7_1 (IN1)
/I2C0_SCL: J1.7 (I2C_SCL), U1.41 (GPIO29_ADC3)
/I2C0_SDA: J1.8 (I2C_SDA), U1.40 (GPIO28_ADC2)
/LED_CLK: J5.3, U3.8 (B1)
/LED_DATA: J5.2, U3.1 (B2)
/MCU_GPIO1: U1.8 (GPIO6)
/MCU_GPIO2: U1.9 (GPIO7)
/QSPI_SCLK: U1.52 (QSPI_SCLK), U2.6 (CLK)
/QSPI_SD0: U1.53 (QSPI_SD0), U2.5 (DI(IO0))
/QSPI_SD1: U1.55 (QSPI_SD1), U2.2 (DO(IO1))
/QSPI_SD2: U1.54 (QSPI_SD2), U2.3 (IO2)
/QSPI_SD3: U1.51 (QSPI_SD3), U2.7 (IO3)
/QSPI_SS: R1.1, U1.56 (QSPI_SS), U2.1 (~CS)
/RP2040_BOOT: R1.2, SW2.1, SW2.4
/RP_GPIO14: U1.17 (GPIO14), U3.5 (A1)
/RP_GPIO15: U1.18 (GPIO15), U3.4 (A2)
/RUN: C2.2, R6.2, SW3.1, SW3.4, U1.26 (RUN)
/SPI1_RX: J1.4 (SPI_MOSI), U1.36 (GPIO24)
/SPI1_SCK: J1.3 (SPI_SCK), U1.38 (GPIO26_ADC0)
/SPI1_TX: J1.5 (SPI_MISO), U1.39 (GPIO27_ADC1)
/SPI1_~CS: J1.6 (SPI_CS), U1.37 (GPIO25)
/USB_D+: J3.A6 (D+), J3.B6 (D+), R4.1
/USB_D-: J3.A7 (D-), J3.B7 (D-), R5.1
/USB_DN: U1.46 (USB_DM), U7.3 (I/O2)
/USB_DP: U1.47 (USB_DP), U7.1 (I/O1)
GND: C1.1, C2.1, C3.1, C4.1, C5.1, C6.1, C7.1, C8.1, C9.1, C10.1, C11.1, C12.1, C13.1, C14.1, C15.1, C16.2, C17.2, C18.1, C19.1, C20.2, C21.2, C22.2, C23.2, C24.2, C25.1, C26.1, J1.1 (GND), J3.A1 (GND), J3.A12 (GND), J3.B1 (GND), J3.B12 (GND), J3.S1 (SHIELD), J4.1, J5.4, R2.2, R3.2, R8.2, R11.2, R13.2, R15.2, R17.2, R18.2, SW2.2, SW2.3, SW3.2, SW3.3, U1.19 (TESTEN), U1.57 (GND), U2.4 (GND), U2.9 (EP), U3.2 (GND), U4.1 (GND), U5.2 (GND), U6.9 (ST), U6.12 (GND), U7.2 (GND), Y1.2, Y1.4
unnamed: C19.2, R9.2, Y1.3
unnamed: J3.A5 (CC1), R2.1
unnamed: J3.B5 (CC2), R3.1
unnamed: R4.2, U7.6 (I/O1)
unnamed: R5.2, U7.4 (I/O2)
unnamed: C20.1, U1.20 (XIN), Y1.1
unnamed: R9.1, U1.21 (XOUT)
unnamed: R19.1, U3.6 (OE)
unnamed: R7.2, R8.1, U4.4 (PR1)
unnamed: R10.2, R11.1, U6.3 (CP2)
unnamed: R18.1, U6.10 (ILM)
unnamed: R16.2, R17.1, U6.5 (OV1)
unnamed: R14.2, R15.1, U6.4 (OV2)
unnamed: R12.2, R13.1, U6.6 (PR1)
unnamed: C21.1, U6.11 (SS)
VBUS: C13.2, J3.A4 (VBUS), J3.A9 (VBUS), J3.B4 (VBUS), J3.B9 (VBUS), U5.1 (VIN), U5.3 (EN), U7.5 (VBUS)
VBUS_REV: C14.2, C16.1, U4.6 (VIN2), U5.5 (VOUT)
VMCU: C17.1, J1.2 (3.3V), R7.1, U4.3 (VIN1), U4.5 (MODE)

Notes on the sheet:
VREGOUT
VREGIN
DVDD
IOVDD AND USBVDD
Current limit : 3.59A
