EPFLXplore/ERC_AV_HW/hats/untested/Yassine_Leds/Yassine_Leds.kicad_pcb

## KiCad design hats/untested/Yassine_Leds/Yassine_Leds.kicad_pcb (continued)

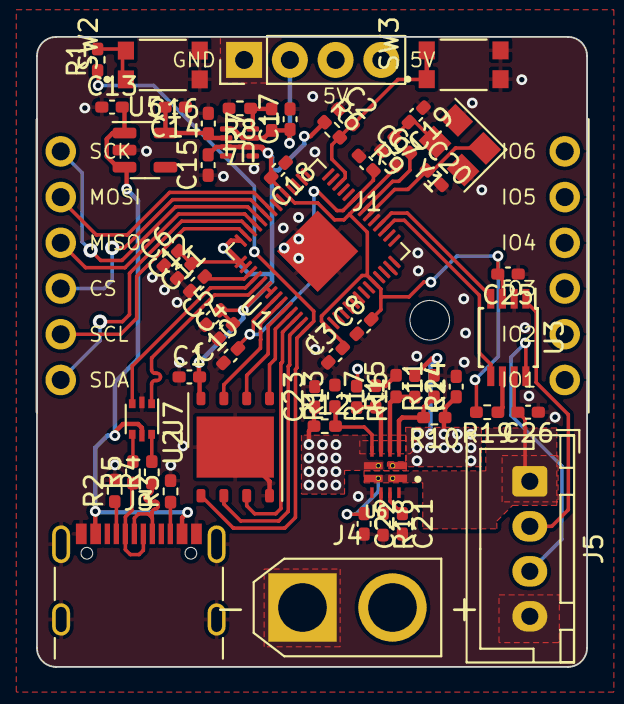
[picture p90: board Yassine_Leds.kicad_pcb from above]

Board: 2 copper layers, 30.6 x 35.0 mm, 59 parts (0 on the bottom side), 46 nets.
