EPFLXplore/ERC_AV_HW/hats/testing_jig/testing_jig.kicad_pcb

## KiCad design hats/testing_jig/testing_jig.kicad_pcb (2023-09-30)

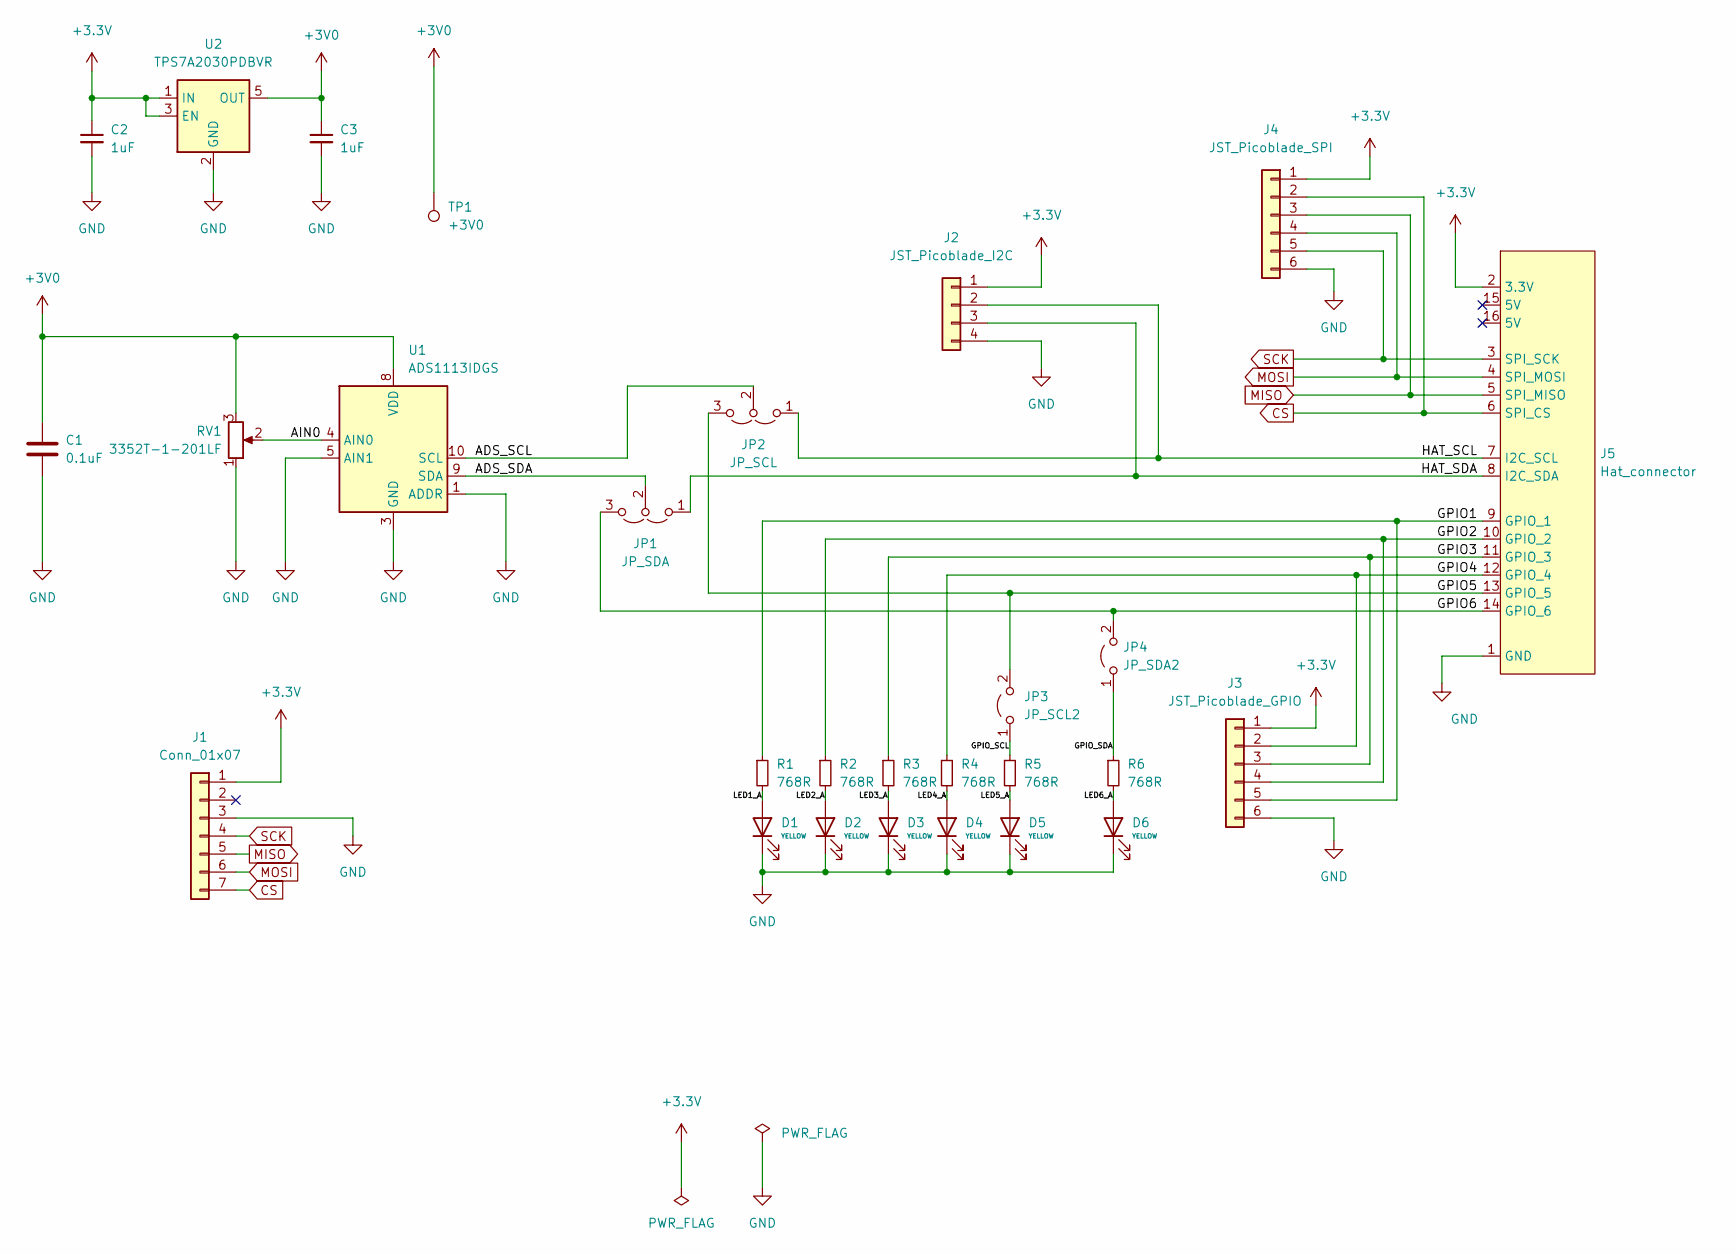
[picture p91: schematic testing_jig.kicad_sch, Orion Testing Jig]

Parts:
C1: 0.1uF; C_0603_1608Metric
C2, C3: 1uF; C_0603_1608Metric
D1, D2, D3, D4, D5, D6: YELLOW; LED_0603_1608Metric; Digikey ref 492-1325-1-ND
J1: Conn_01x07; PinHeader_1x07_P2.54mm_Vertical
J2: JST_Picoblade_I2C; PicoBlade-JST-GH-1x04_1.25mm_Vertical
J3: JST_Picoblade_GPIO; PicoBlade_JST-GH-1x06_1.25mm_Vertical
J4: JST_Picoblade_SPI; PicoBlade_JST-GH-1x06_1.25mm_Vertical
J5: Hat_connector
JP1: JP_SDA; SolderJumper-3_P1.3mm_Open_RoundedPad1.0x1.5mm
JP2: JP_SCL; SolderJumper-3_P1.3mm_Open_RoundedPad1.0x1.5mm
JP3: JP_SCL2; SolderJumper-2_P1.3mm_Open_RoundedPad1.0x1.5mm
JP4: JP_SDA2; SolderJumper-2_P1.3mm_Open_RoundedPad1.0x1.5mm
R1, R2, R3, R4, R5, R6: 768R; R_0603_1608Metric
RV1: 3352T-1-201LF; TRIM_3352T-1-201LF; Digikey ref 3352T-201LF-ND
TP1: +3V0; TestPoint
U1: ADS1113IDGS; TSSOP-10_3x3mm_P0.5mm; Digikey ref 296-24930-1-ND
U2: TPS7A2030PDBVR; SOT-23-5; Digikey ref 296-TPS7A2030PDBVRCT-ND

Connections:
+3.3V: C2.1, J1.1, J2.1, J3.1, J4.1, J5.2 (3.3V), U2.1 (IN), U2.3 (EN)
+3V0: C1.1, C3.1, RV1.3, TP1.1, U1.8 (VDD), U2.5 (OUT)
/ADS_SCL: JP2.2 (C), U1.10 (SCL)
/ADS_SDA: JP1.2 (C), U1.9 (SDA)
/AIN0: RV1.2, U1.4 (AIN0)
/GPIO1: J3.5, J5.9 (GPIO_1), R1.1
/GPIO2: J3.4, J5.10 (GPIO_2), R2.1
/GPIO3: J3.3, J5.11 (GPIO_3), R3.1
/GPIO4: J3.2, J5.12 (GPIO_4), R4.1
/GPIO5: J5.13 (GPIO_5), JP2.3 (B), JP3.2 (B)
/GPIO6: J5.14 (GPIO_6), JP1.3 (B), JP4.2 (B)
/GPIO_SCL: JP3.1 (A), R5.1
/GPIO_SDA: JP4.1 (A), R6.1
/HAT_SCL: J2.2, J5.7 (I2C_SCL), JP2.1 (A)
/HAT_SDA: J2.3, J5.8 (I2C_SDA), JP1.1 (A)
/LED1_A: D1.2 (A), R1.2
/LED2_A: D2.2 (A), R2.2
/LED3_A: D3.2 (A), R3.2
/LED4_A: D4.2 (A), R4.2
/LED5_A: D5.2 (A), R5.2
/LED6_A: D6.2 (A), R6.2
CS: J1.7, J4.2, J5.6 (SPI_CS)
GND: C1.2, C2.2, C3.2, D1.1 (K), D2.1 (K), D3.1 (K), D4.1 (K), D5.1 (K), D6.1 (K), J1.3, J2.4, J3.6, J4.6, J5.1 (GND), RV1.1, U1.1 (ADDR), U1.3 (GND), U1.5 (AIN1), U2.2 (GND)
MISO: J1.5, J4.3, J5.5 (SPI_MISO)
MOSI: J1.6, J4.4, J5.4 (SPI_MOSI)
SCK: J1.4, J4.5, J5.3 (SPI_SCK)

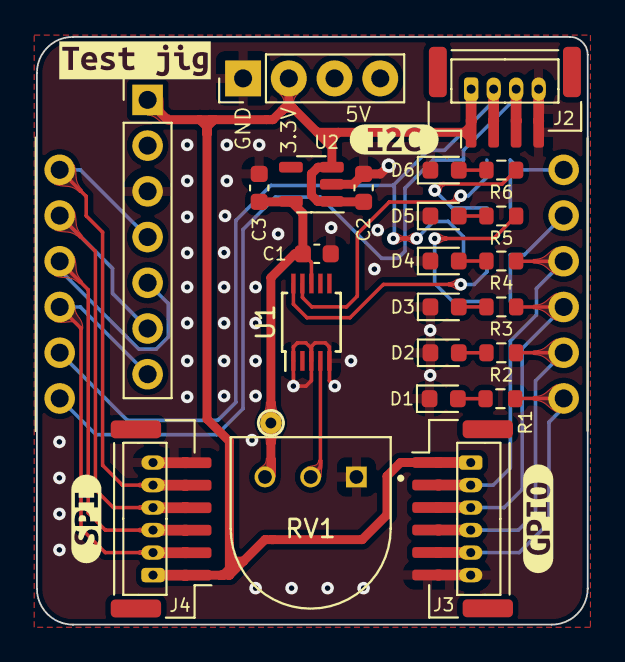
[picture p92: board testing_jig.kicad_pcb from above]

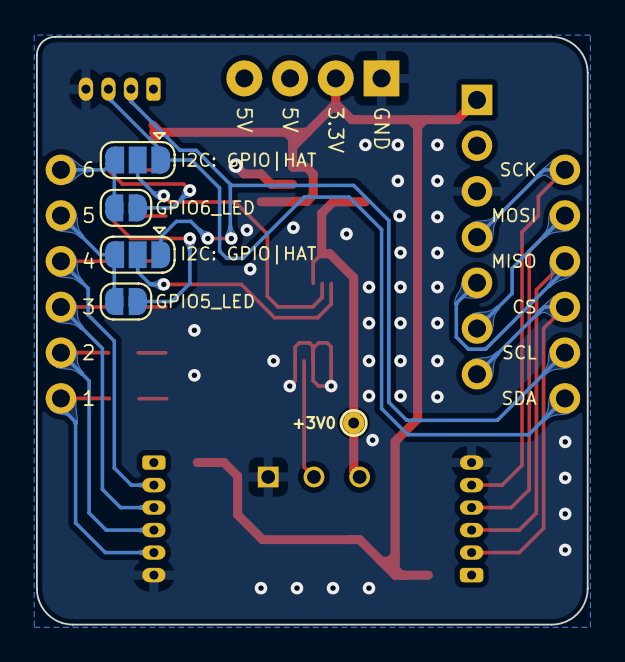
[picture p93: board testing_jig.kicad_pcb from below]

Board: 2 copper layers, 30.6 x 32.7 mm, 32 parts (4 on the bottom side), 26 nets.

Other parts of the board:
kibuzzard-6366EC6B: G***; kibuzzard-6366EC6B
kibuzzard-6366EC37: G***; kibuzzard-6366EC37
kibuzzard-6366EC83: G***; kibuzzard-6366EC83
kibuzzard-6366ECB1: G***; kibuzzard-6366ECB1
