EPFLXplore/ERC_AV_HW/node_pcb/orion_debug/orion_debug.kicad_pcb

## KiCad design node_pcb/orion_debug/orion_debug.kicad_pcb (2023-09-30)

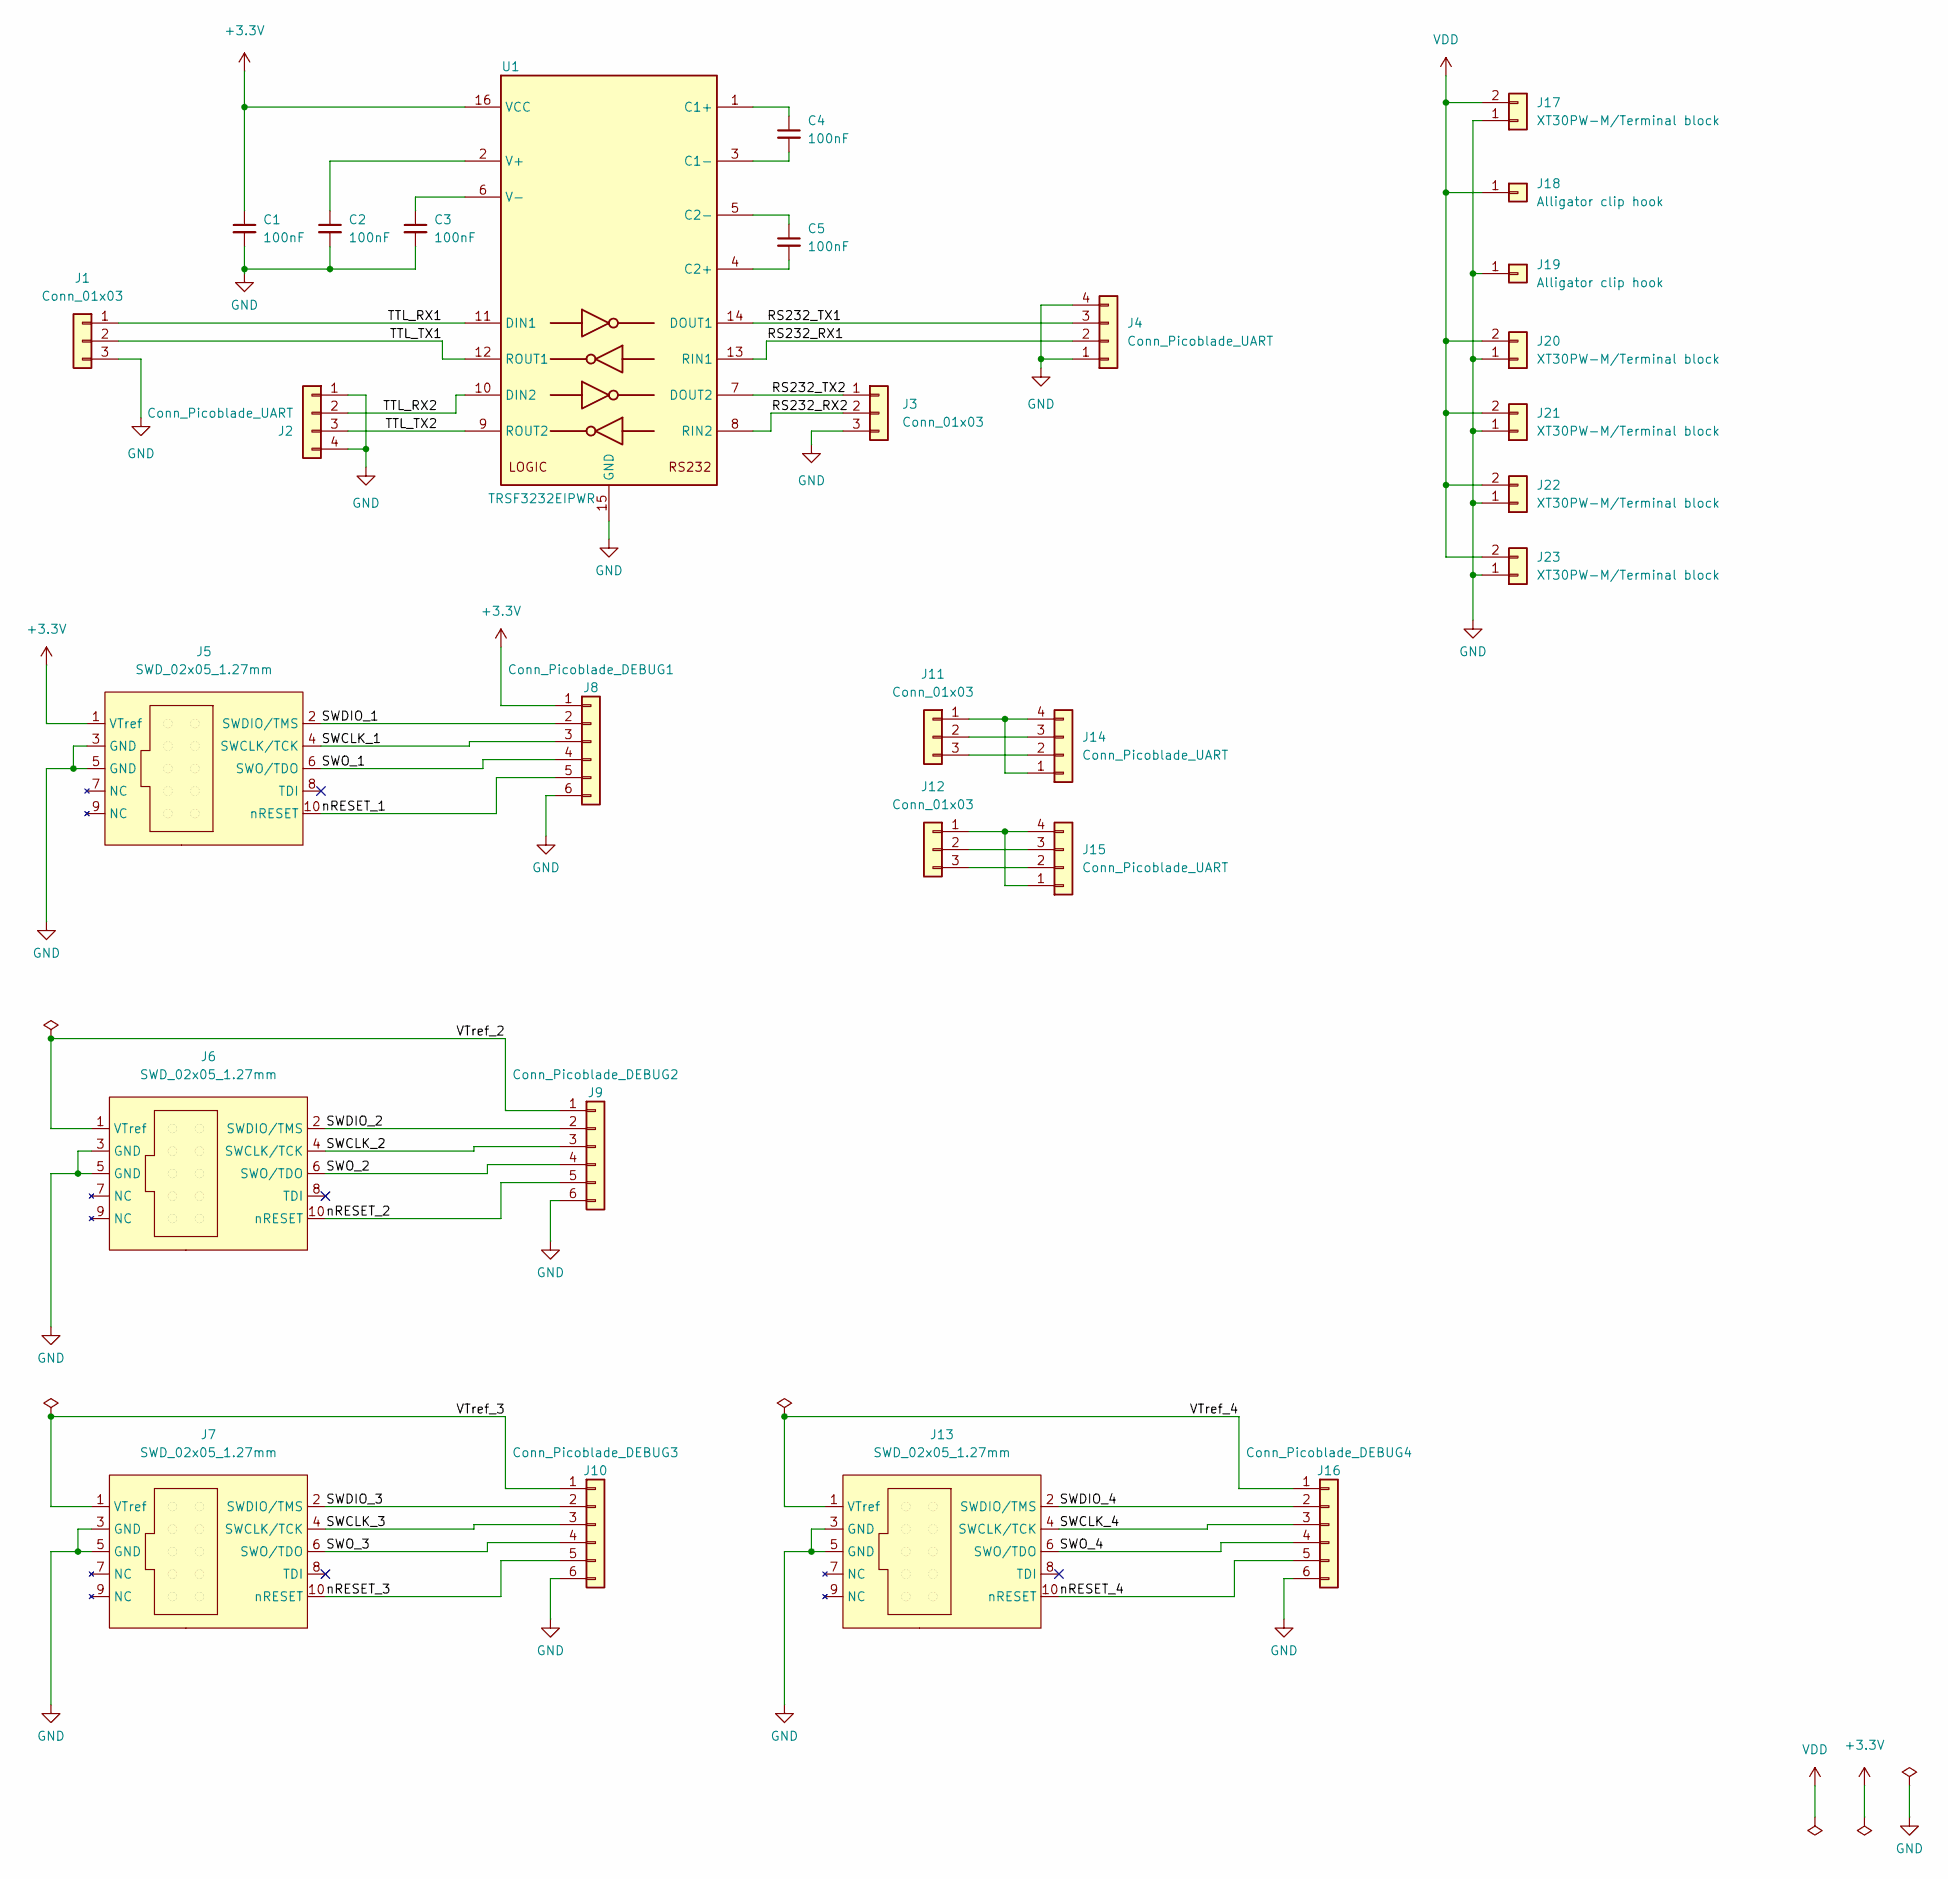
[picture p94: schematic orion_debug.kicad_sch]

Parts:
C1, C2, C3, C4, C5: 100nF; C_0603_1608Metric
J1, J3, J11, J12: Conn_01x03; PinHeader_1x03_P2.54mm_Vertical
J2, J4, J14, J15: Conn_Picoblade_UART; Molex_PicoBlade_53047-0410_1x04_P1.25mm_Vertical; Digikey ref WM1733-ND
J5, J6, J7, J13: SWD_02x05_1.27mm; 3220-10-0100-00; Digikey ref 1175-1627-ND
J8: Conn_Picoblade_DEBUG1; Molex_PicoBlade_53047-0610_1x06_P1.25mm_Vertical; Digikey ref WM1735-ND
J9: Conn_Picoblade_DEBUG2; Molex_PicoBlade_53047-0610_1x06_P1.25mm_Vertical; Digikey ref WM1735-ND
J10: Conn_Picoblade_DEBUG3; Molex_PicoBlade_53047-0610_1x06_P1.25mm_Vertical; Digikey ref WM1735-ND
J16: Conn_Picoblade_DEBUG4; Molex_PicoBlade_53047-0610_1x06_P1.25mm_Vertical; Digikey ref WM1735-ND
J17, J20, J21, J22, J23: XT30PW-M/Terminal block; AMASS_XT30PW-M_1x02_P2.50mm_Horizontal
J18, J19: Alligator clip hook; Alligator_clip_hook
U1: TRSF3232EIPWR; TSSOP-16_4.4x5mm_P0.65mm; Digikey ref 296-25093-1-ND

Connections:
+3.3V: C1.1, J5.1 (VTref), J8.1, U1.16 (VCC)
/RS232_RX1: J4.2, U1.13 (RIN1)
/RS232_RX2: J3.2, U1.8 (RIN2)
/RS232_TX1: J4.3, U1.14 (DOUT1)
/RS232_TX2: J3.1, U1.7 (DOUT2)
/SWCLK_1: J5.4 (SWCLK/TCK), J8.3
/SWCLK_2: J6.4 (SWCLK/TCK), J9.3
/SWCLK_3: J7.4 (SWCLK/TCK), J10.3
/SWCLK_4: J13.4 (SWCLK/TCK), J16.3
/SWDIO_1: J5.2 (SWDIO/TMS), J8.2
/SWDIO_2: J6.2 (SWDIO/TMS), J9.2
/SWDIO_3: J7.2 (SWDIO/TMS), J10.2
/SWDIO_4: J13.2 (SWDIO/TMS), J16.2
/SWO_1: J5.6 (SWO/TDO), J8.4
/SWO_2: J6.6 (SWO/TDO), J9.4
/SWO_3: J7.6 (SWO/TDO), J10.4
/SWO_4: J13.6 (SWO/TDO), J16.4
/TTL_RX1: J1.1, U1.11 (DIN1)
/TTL_RX2: J2.2, U1.10 (DIN2)
/TTL_TX1: J1.2, U1.12 (ROUT1)
/TTL_TX2: J2.3, U1.9 (ROUT2)
/VTref_2: J6.1 (VTref), J9.1
/VTref_3: J7.1 (VTref), J10.1
/VTref_4: J13.1 (VTref), J16.1
/nRESET_1: J5.10 (nRESET), J8.5
/nRESET_2: J6.10 (nRESET), J9.5
/nRESET_3: J7.10 (nRESET), J10.5
/nRESET_4: J13.10 (nRESET), J16.5
GND: C1.2, C2.2, C3.2, J1.3, J2.1, J2.4, J3.3, J4.1, J4.4, J5.3 (GND), J5.5 (GND), J6.3 (GND), J6.5 (GND), J7.3 (GND), J7.5 (GND), J8.6, J9.6, J10.6, J13.3 (GND), J13.5 (GND), J16.6, J17.1, J19.1, J20.1, J21.1, J22.1, J23.1, U1.15 (GND)
unnamed: C2.1, U1.2 (V+)
unnamed: C3.1, U1.6 (V-)
unnamed: C4.1, U1.1 (C1+)
unnamed: C4.2, U1.3 (C1-)
unnamed: C5.1, U1.5 (C2-)
unnamed: C5.2, U1.4 (C2+)
unnamed: J11.1, J14.1, J14.4
unnamed: J11.2, J14.3
unnamed: J11.3, J14.2
unnamed: J12.1, J15.1, J15.4
unnamed: J12.2, J15.3
unnamed: J12.3, J15.2
VDD: J17.2, J18.1, J20.2, J21.2, J22.2, J23.2

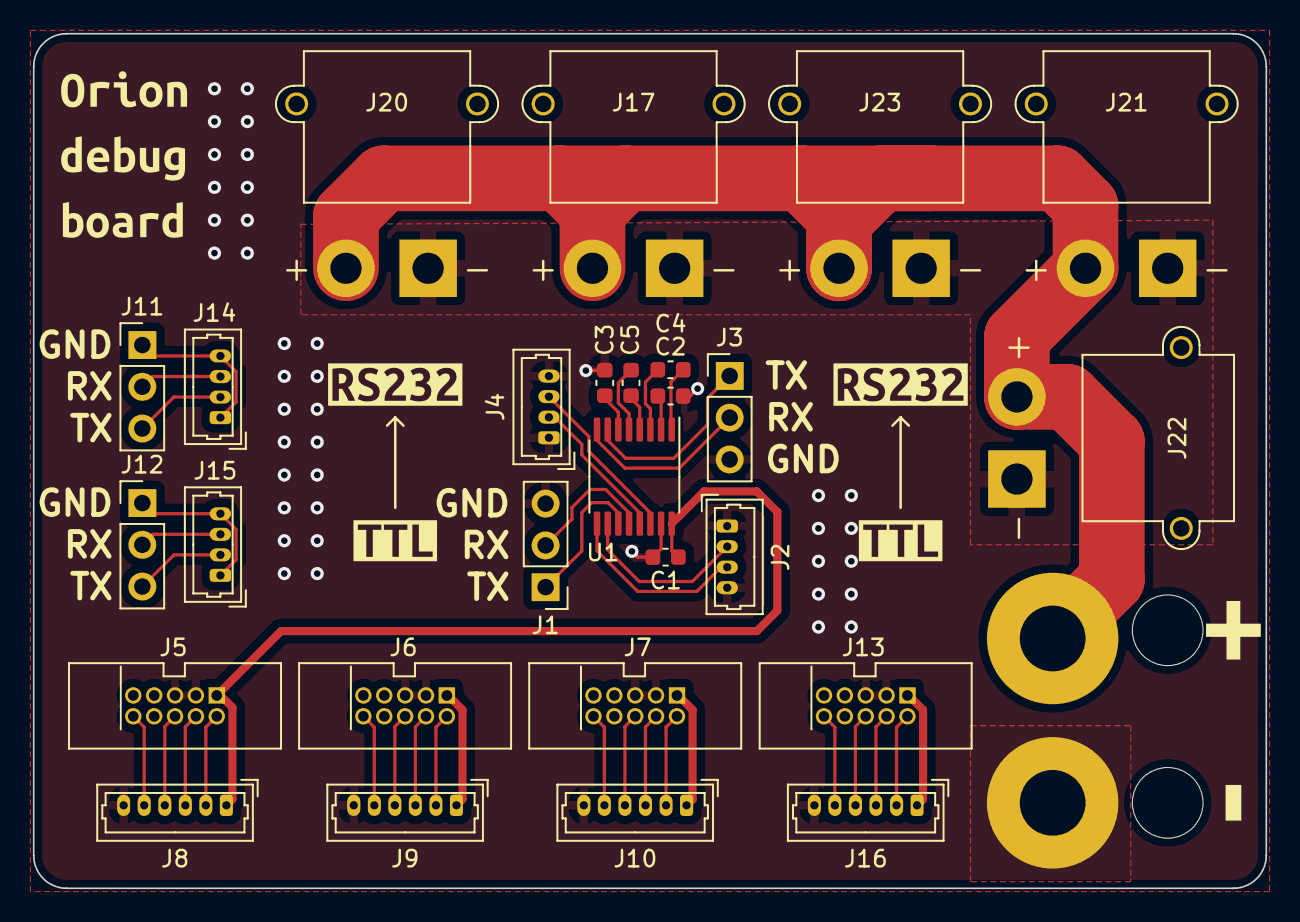
[picture p95: board orion_debug.kicad_pcb from above]

Board: 2 copper layers, 75.0 x 52.0 mm, 36 parts (0 on the bottom side), 42 nets.

Other parts of the board:
kibuzzard-634C72A3: G***; kibuzzard-634C72A3
kibuzzard-634C72BB: G***; kibuzzard-634C72BB
kibuzzard-634C755D, kibuzzard-634C755D#2: G***; kibuzzard-634C755D
kibuzzard-634C7533: G***; kibuzzard-634C7533
kibuzzard-634C7551, kibuzzard-634C7551#2: G***; kibuzzard-634C7551
