EPFLXplore/ERC_AV_HW/node_pcb/orion_power/orion_power.kicad_pcb

## KiCad design node_pcb/orion_power/orion_power.kicad_pcb (2023-09-30)

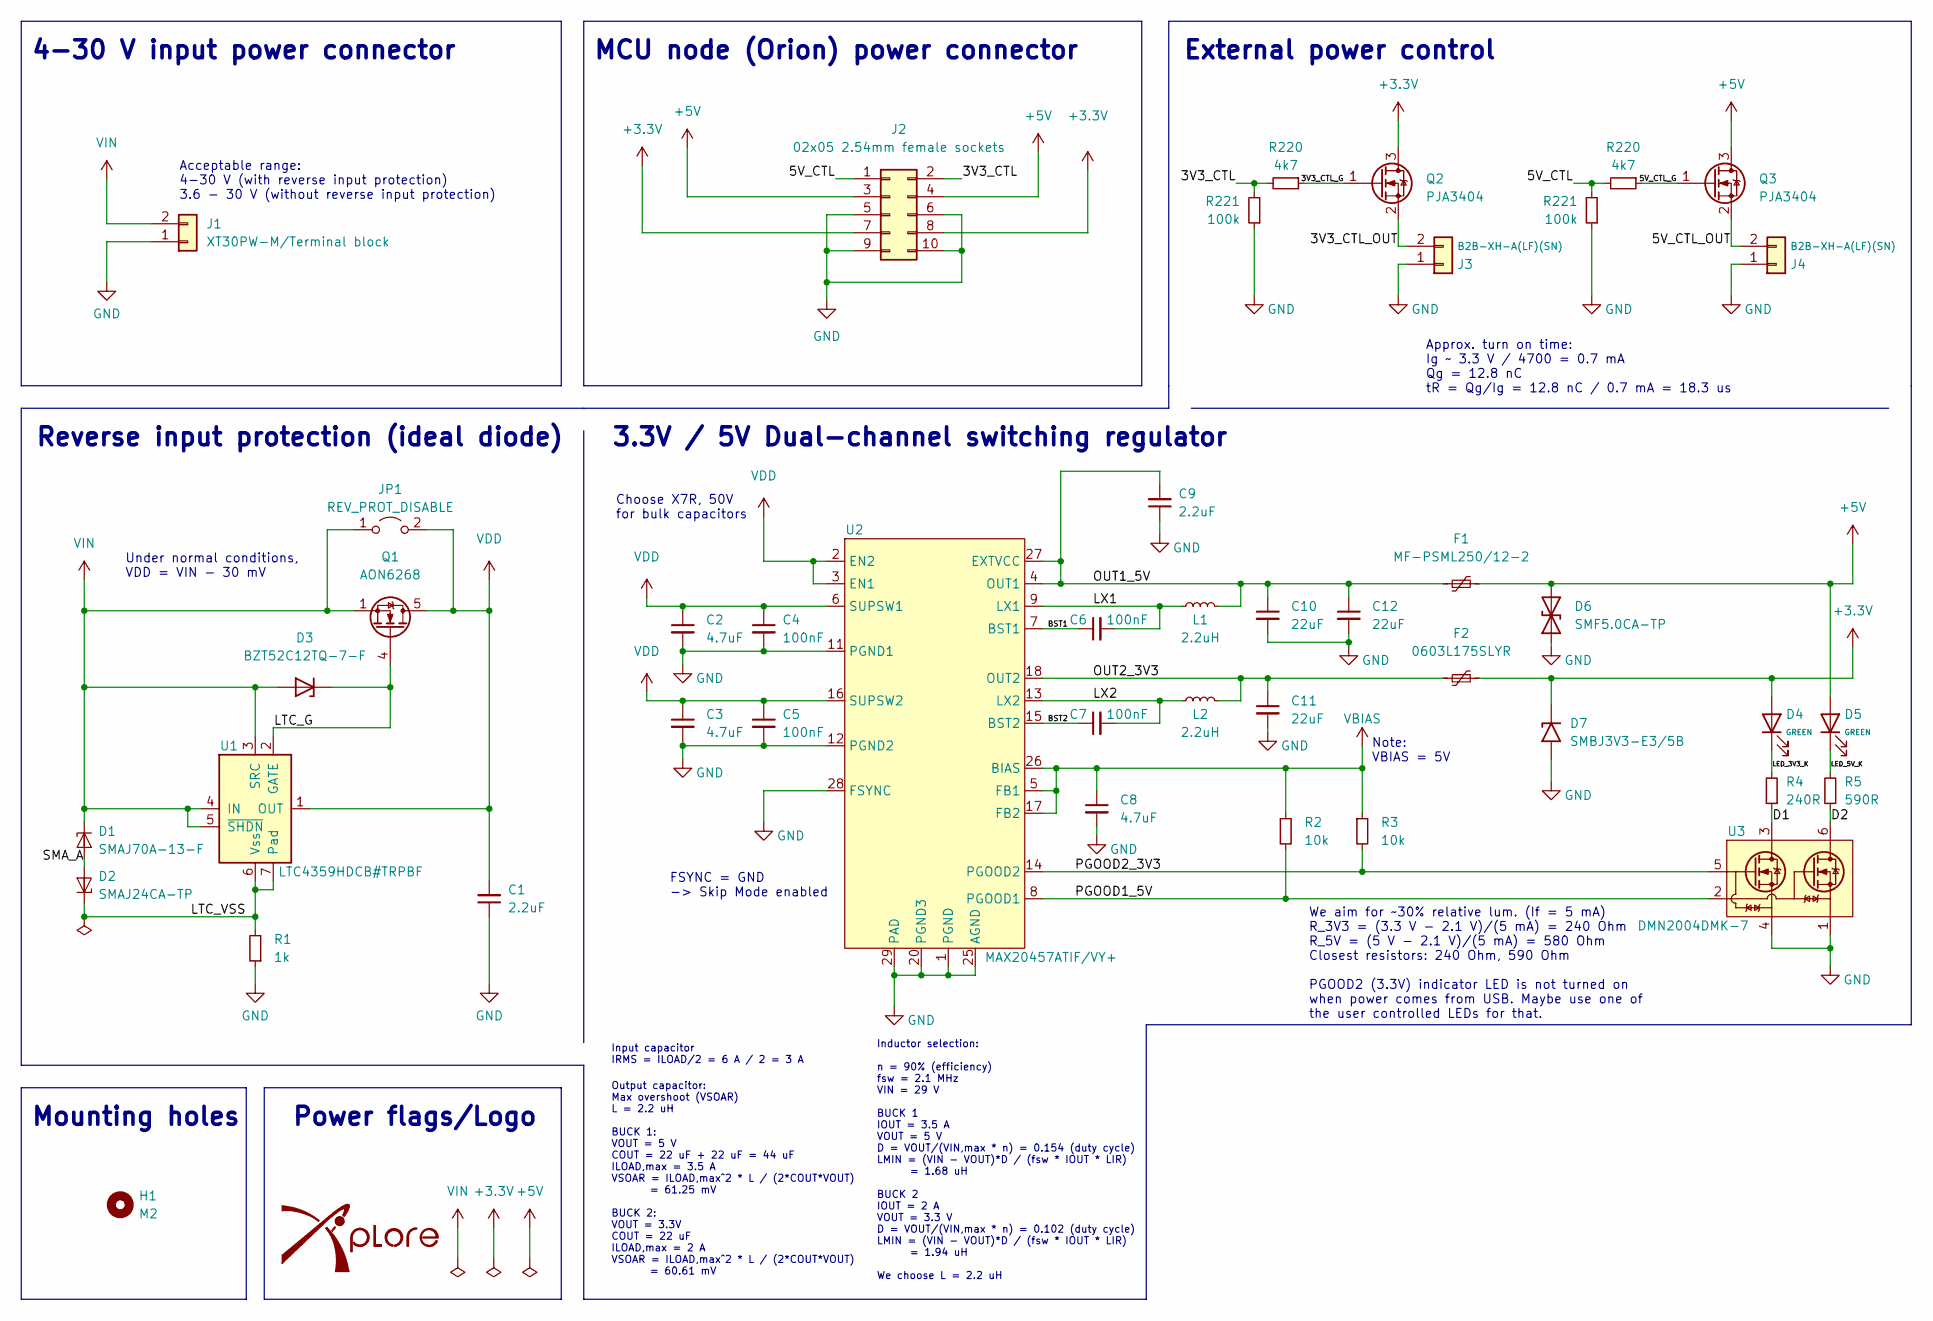
[picture p96: schematic orion_power.kicad_sch, Meissa v2: 3.3V/5V Switching Regulator]

Parts:
C1, C9: 2.2uF; C_0603_1608Metric; Digikey ref 587-4320-1-ND
C2, C3: 4.7uF; C_1206_3216Metric; Digikey ref 490-6521-1-ND
C4, C5: 100nF; C_0603_1608Metric; Digikey ref 478-KGM15BR71H104JTCT-ND
C6, C7: 100nF; C_0603_1608Metric_Pad1.08x0.95mm_HandSolder; Digikey ref 478-KGM15BR71H104JTCT-ND
C8: 4.7uF; C_0603_1608Metric; Digikey ref 490-GRM188Z71C475KE21JCT-ND
C10, C11, C12: 22uF; C_1206_3216Metric; Digikey ref 490-5309-1-ND
D1: SMAJ70A-13-F; D_SMA; Digikey ref SMAJ70A-FDICT-ND
D2: SMAJ24CA-TP; D_SMA; Digikey ref SMAJ24CA-TPMSCT-ND
D3: BZT52C12TQ-7-F; D_SOD-523; Digikey ref BZT52C12TQ-7-FDICT-ND
D4, D5: GREEN; LED_0603_1608Metric; Digikey ref 492-1324-1-ND
D6: SMF5.0CA-TP; D_SOD-123; Digikey ref 353-SMF5.0CA-TPCT-ND
D7: SMBJ3V3-E3/5B; D_SMB; Digikey ref SMBJ3V3-E3/5BGICT-ND
F1: MF-PSML250/12-2; Fuse_0805_2012Metric; Digikey ref MF-PSML250/12-2CT-ND
F2: 0603L175SLYR; Fuse_0603_1608Metric; Digikey ref F5778CT-ND
G1: Xplore_Logo; Xplore_Logo_X_only_10mm
H1: M2; MountingHole_2.2mm_M2
J1: XT30PW-M/Terminal block; AMASS_XT30PW-M_1x02_P2.50mm_Horizontal
J2: 02x05 2.54mm female sockets; SFH11-PBPC-D05-ST-BK; Digikey ref S9194-ND
J3, J4: B2B-XH-A(LF)(SN); JST_XH_B2B-XH-A_1x02_P2.50mm_Vertical; Digikey ref 455-2247-ND
JP1: REV_PROT_DISABLE; Jumper_wide
L1, L2: 2.2uH; 0640CDMCCDS-2R2MC; Digikey ref 308-0640CDMCCDS-2R2MCCT-ND
Q1: AON6268; AO_DFN-8-1EP_5.55x5.2mm_P1.27mm_EP4.12x4.6mm; Digikey ref 800-3748-1-ND
Q2, Q3: PJA3404; SOT-23; Digikey ref 3757-PJA3404_R1_00001CT-ND
R1: 1k; R_1206_3216Metric; Digikey ref 541-1.0KUACT-ND
R2, R3: 10k; R_0603_1608Metric; Digikey ref RNCP0603FTD10K0CT-ND
R4: 240R; R_0603_1608Metric; Digikey ref RHM240DCT-ND
R5: 590R; R_0603_1608Metric; Digikey ref 2019-RK73H1JTTD5900FCT-ND
R220: 4k7; R_0402_1005Metric; Digikey ref A130363CT-ND
R221: 100k; R_0402_1005Metric; Digikey ref 13-AC0402FR-7W100KLCT-ND
U1: LTC4359HDCB#TRPBF; DFN-6-1EP_3x2mm_P0.5mm_EP1.65x1.35mm; Digikey ref 505-LTC4359HDCB#TRPBFCT-ND
U2: MAX20457ATIF/VY+; TQFN-28-1EP_5x5mm_P0.5mm_EP3.25x3.25mm_ThermalVias; Digikey ref 175-MAX20457ATIF/VY+-ND
U3: DMN2004DMK-7; SOT-23-6; Digikey ref DMN2004DMKDICT-ND

Connections:
+3.3V: D4.2 (A), D7.1 (A1), F2.2, J2.7, J2.8, Q2.3 (D)
+5V: D5.2 (A), D6.2 (A2), F1.2, J2.3, J2.4, Q3.3 (D)
/3V3_CTL: J2.2; also elsewhere on the board
/3V3_CTL_G: Q2.1 (G); also elsewhere on the board
/3V3_CTL_OUT: J3.2, Q2.2 (S)
/5V_CTL: J2.1; also elsewhere on the board
/5V_CTL_G: Q3.1 (G); also elsewhere on the board
/5V_CTL_OUT: J4.2, Q3.2 (S)
/BST1: C6.1, U2.7 (BST1)
/BST2: C7.1, U2.15 (BST2)
/D1: R4.1, U3.3 (D1)
/D2: R5.1, U3.6 (D2)
/LED_3V3_K: D4.1 (K), R4.2
/LED_5V_K: D5.1 (K), R5.2
/LTC_G: D3.1 (K), Q1.4 (G), U1.2 (GATE)
/LTC_VSS: D2.1 (K1), R1.2, U1.6 (Vss), U1.7 (Pad)
/LX1: C6.2, L1.1, U2.9 (LX1), U2.10 (LX1)
/LX2: C7.2, L2.1, U2.13 (LX2)
/OUT1_5V: C9.2, C10.1, C12.1, F1.1, L1.2, U2.4 (OUT1), U2.27 (EXTVCC)
/OUT2_3V3: C11.1, F2.1, L2.2, U2.18 (OUT2)
/PGOOD1_5V: R2.2, U2.8 (PGOOD1), U3.2 (G2)
/PGOOD2_3V3: R3.2, U2.14 (PGOOD2), U3.5 (G1)
/SMA_A: D1.2 (A), D2.2 (A)
GND: C1.1, C2.2, C3.2, C4.2, C5.2, C8.2, C9.1, C10.2, C11.2, C12.2, D6.1 (A1), D7.2 (A2), J1.1, J2.5, J2.6, J2.9, J2.10, J3.1, J4.1, R1.1, U2.1 (PGND), U2.11 (PGND1), U2.12 (PGND2), U2.19 (PGND), U2.20 (PGND3), U2.23 (PGND), U2.24 (PGND), U2.25 (AGND), U2.28 (FSYNC), U2.29 (PAD), U3.1 (S2), U3.4 (S1); also elsewhere on the board
VBIAS: C8.1, R2.1, R3.1, U2.5 (FB1), U2.17 (FB2), U2.26 (BIAS)
VDD: C1.2, C2.1, C3.1, C4.1, C5.1, JP1.2 (B), Q1.5 (D), U1.1 (OUT), U2.2 (EN2), U2.3 (EN1), U2.6 (SUPSW1), U2.16 (SUPSW2)
VIN: D1.1 (K1), D3.2 (A), J1.2, JP1.1 (A), Q1.1 (S), Q1.2 (S), Q1.3 (S), U1.3 (SRC), U1.4 (IN), U1.5 (~SHDN)

Notes on the sheet:
Approx. turn on time: Ig ~ 3.3 V / 4700 = 0.7 mA Qg = 12.8 nC tR = Qg/Ig = 12.8 nC / 0.7 mA = 18.3 us
Output capacitor: Max overshoot (VSOAR) L = 2.2 uH BUCK 1: VOUT = 5 V COUT = 22 uF + 22 uF = 44 uF ILOAD,max = 3.5 A VSOAR = ILOAD,max^2 * L / (2*COUT*VOUT) = 61.25 mV BUCK 2: VOUT = 3.3V COUT = 22 uF ILOAD,max = 2 A VSOAR = ILOAD,max^2 * L / (2*COUT*VOUT) = 60.61 mV
Reverse input protection (ideal diode)
3.3V / 5V Dual-channel switching regulator
We aim for ~30% relative lum. (If = 5 mA) R_3V3 = (3.3 V - 2.1 V)/(5 mA) = 240 Ohm R_5V = (5 V - 2.1 V)/(5 mA) = 580 Ohm Closest resistors: 240 Ohm, 590 Ohm PGOOD2 (3.3V) indicator LED is not turned on when power comes from USB. Maybe use one of the user controlled LEDs for that.
Inductor selection: n = 90% (efficiency) fsw = 2.1 MHz VIN = 29 V BUCK 1 IOUT = 3.5 A VOUT = 5 V D = VOUT/(VIN,max * n) = 0.154 (duty cycle) LMIN = (VIN - VOUT)*D / (fsw * IOUT * LIR) = 1.68 uH BUCK 2 IOUT = 2 A VOUT = 3.3 V D = VOUT/(VIN,max * n) = 0.102 (duty cycle) LMIN = (VIN - VOUT)*D / (fsw *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
4-30 V input power connector
Acceptable range: 4-30 V (with reverse input protection) 3.6 - 30 V (without reverse input protection)
FSYNC = GND -> Skip Mode enabled
Power flags/Logo
Choose X7R, 50V for bulk capacitors
MCU node (Orion) power connector
Mounting holes
Note: VBIAS = 5V
External power control
Input capacitor IRMS = ILOAD/2 = 6 A / 2 = 3 A
Under normal conditions, VDD = VIN - 30 mV

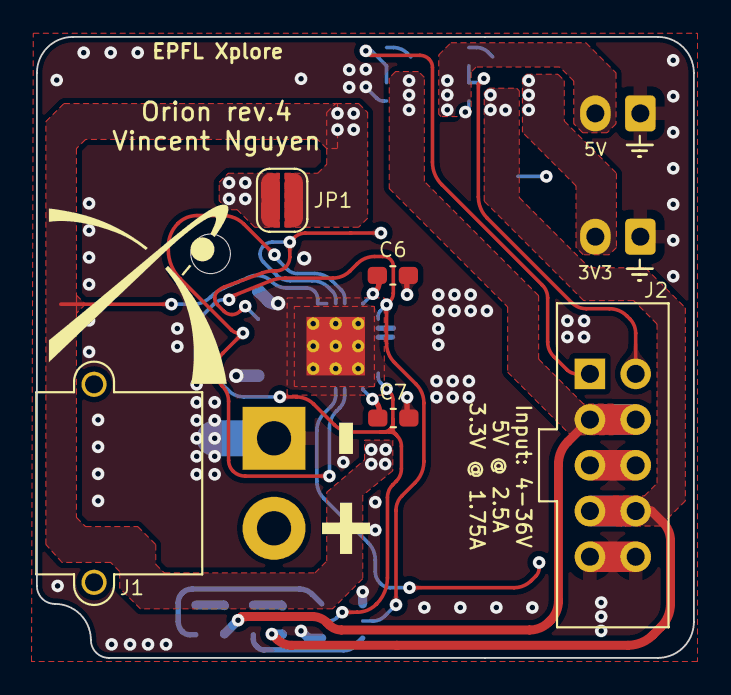
[picture p97: board orion_power.kicad_pcb from above]

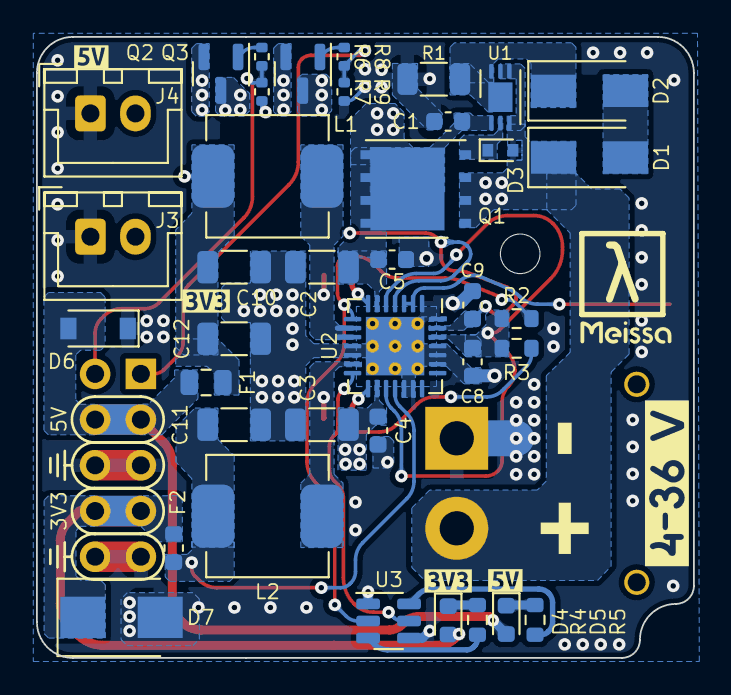
[picture p98: board orion_power.kicad_pcb from below]

Board: 4 copper layers, 36.5 x 34.5 mm, 57 parts (47 on the bottom side), 27 nets.

Other parts of the board:
R6, R8: 4k7; R_0402_1005Metric
R7, R9: 100k; R_0402_1005Metric
kibuzzard-64AA9C09: G***; kibuzzard-64AA9C09
kibuzzard-64AA9EDE: G***; kibuzzard-64AA9EDE
kibuzzard-64AAA738: G***; kibuzzard-64AAA738
kibuzzard-63491EED, kibuzzard-63491EED#2: G***; kibuzzard-63491EED
kibuzzard-63491F09, kibuzzard-63491F09#2: G***; kibuzzard-63491F09
kibuzzard-634922C3, kibuzzard-634922C3#2: G***; kibuzzard-634922C3
kibuzzard-634922CB, kibuzzard-634922CB#2: G***; kibuzzard-634922CB
kibuzzard-6349252F: G***; kibuzzard-6349252F

Their connections:
/3V3_CTL: R6.2, R7.2; also elsewhere on the board
/3V3_CTL_G: R6.1; also elsewhere on the board
/5V_CTL: R8.2, R9.2; also elsewhere on the board
/5V_CTL_G: R8.1; also elsewhere on the board
GND: R7.1, R9.1; also elsewhere on the board
