EPFLXplore/ERC_AV_HW/hats/load_cell_connector_interface/load_cell_connector_interface.kicad_pcb

## KiCad design hats/load_cell_connector_interface/load_cell_connector_interface.kicad_pcb (2023-09-30)

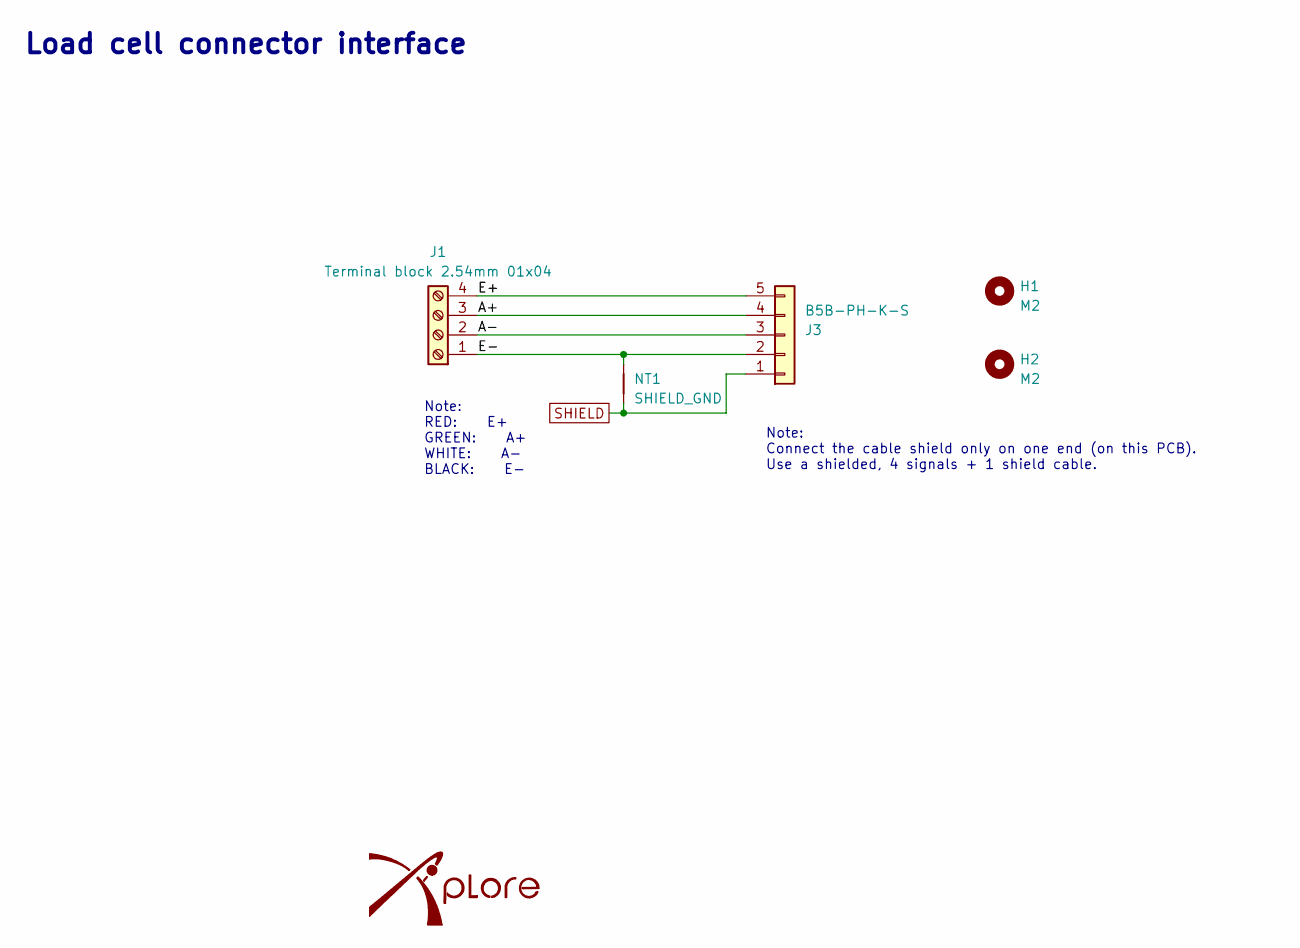
[picture p99: schematic load_cell_connector_interface.kicad_sch, Load Cell Connector Interface (with shield)]

Parts:
G1: Xplore_Logo; Xplore_Logo_X_only_10mm
H1, H2: M2; MountingHole_2.2mm_M2
J1: Terminal block 2.54mm 01x04; TerminalBlock_Phoenix_MPT-0,5-4-2.54_1x04_P2.54mm_Horizontal; Digikey ref 277-1275-ND
J3: B5B-PH-K-S; JST_PH_B5B-PH-K_1x05_P2.00mm_Vertical; Digikey ref 455-1707-ND
NT1: SHIELD_GND; NetTie-2_SMD_Pad0.5mm

Connections:
/A+: J1.3, J3.4
/A-: J1.2, J3.3
/E+: J1.4, J3.5
/E-: J1.1, J3.2, NT1.2
SHIELD: J3.1, NT1.1

Notes on the sheet:
Note: Connect the cable shield only on one end (on this PCB). Use a shielded, 4 signals + 1 shield cable.
Load cell connector interface
Note: RED: E+ GREEN: A+ WHITE: A- BLACK: E-

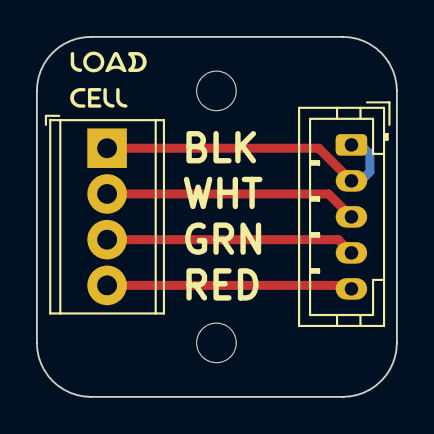
[picture p100: board load_cell_connector_interface.kicad_pcb from above]

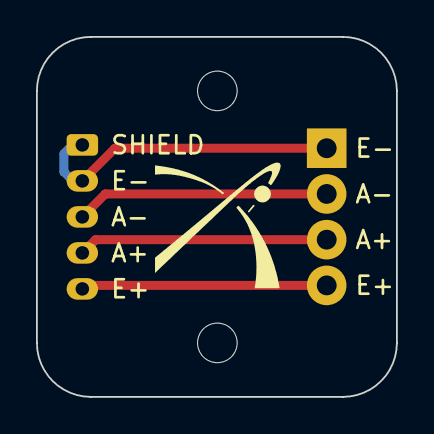
[picture p101: board load_cell_connector_interface.kicad_pcb from below]

Board: 2 copper layers, 20.0 x 20.0 mm, 7 parts (2 on the bottom side), 5 nets.

Other parts of the board:
kibuzzard-64B349D4: G***; kibuzzard-64B349D4
