EPFLXplore/ERC_AV_HW/hats/voltmeterv2/voltmeter.kicad_pcb

## KiCad design hats/voltmeterv2/voltmeter.kicad_pcb (2023-09-30)

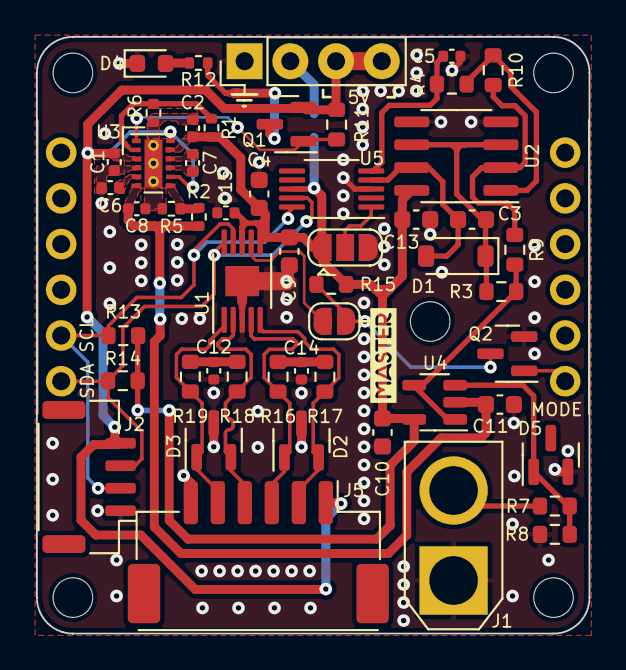
[picture p102: board voltmeter.kicad_pcb from above]

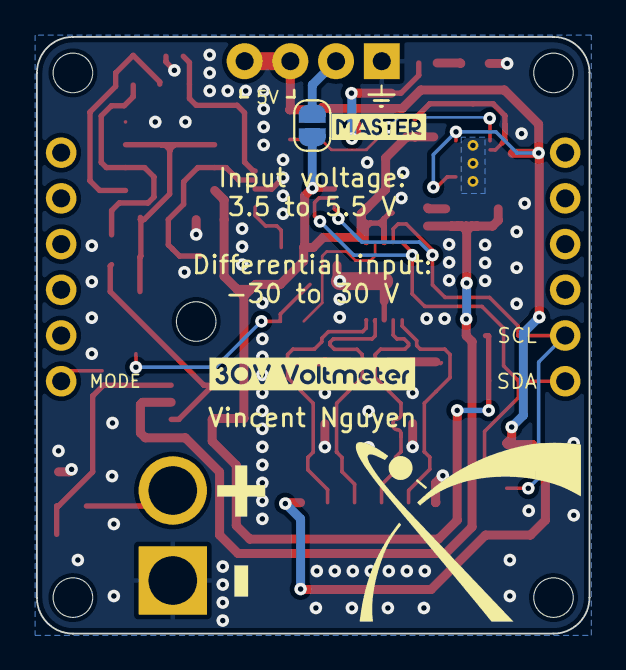
[picture p103: board voltmeter.kicad_pcb from below]

Board: 2 copper layers, 30.7 x 33.1 mm, 63 parts (6 on the bottom side), 33 nets.

Parts:
C1, C2, C8: 2.2uF; C_0402_1005Metric
C3: 62pF; C_0603_1608Metric
C4, C10, C11: 0.1uF; C_0603_1608Metric
C5, C7, C15: 1uF; C_0402_1005Metric
C6, C12, C14: 4.7uF; C_0402_1005Metric
C9: 2.2uF; C_0603_1608Metric
C13: 10nF; C_0603_1608Metric
D1: 1N4148W; D_SOD-123
D2, D3: PESD2CANFD27V-TR; SOT-23
D4: GREEN; LED_0603_1608Metric
D5: AZ23C3V3-7-F; SOT-23
G1: Xplore_Logo; Xplore_Logo_X_only_10mm
H1, H2, H3, H4: M2; MountingHole_2.2mm_M2
J1: XT30U-M; AMASS_XT30U-M_1x02_P5.0mm_Vertical
J2: BM04B-GHS-TBT(LF)(SN)(N); JST_GH_BM04B-GHS-TBT_1x04-1MP_P1.25mm_Vertical
J3: Hat_connector_hole
J5: CLIK-Mate 1.5mm 01x06; Molex_CLIK-Mate_505405-0670_1x06-1MP_P1.50mm_Vertical
JP1, JP3: MASTER_EN; SolderJumper-2_P1.3mm_Open_RoundedPad1.0x1.5mm
JP2: ADDRESS_SEL; SolderJumper-3_P1.3mm_Open_RoundedPad1.0x1.5mm
Q1: PJA3405; SOT-23
Q2: PJA3404; SOT-23
R1: 88k7; R_0402_1005Metric
R2: 86k6; R_0402_1005Metric
R3, R9, R10: 100k; R_0603_1608Metric
R4: 100R; R_0603_1608Metric
R5, R6: 51k; R_0402_1005Metric
R7: 18k; R_0603_1608Metric
R8: 2k; R_0603_1608Metric
R11, R13, R14: 10k; R_0603_1608Metric
R12: 590R; R_0402_1005Metric
R15: 30k; R_0603_1608Metric
R16, R17, R18, R19: 60R; R_0603_1608Metric
U1: LT3960JMSE#PBF; MSOP-10-1EP_3x3mm_P0.5mm_EP1.68x1.88mm
U2: OPA2336UA/2K5; SOIC-8_3.9x4.9mm_P1.27mm
U3: LM27762DSSR; WSON-12-1EP_3x2mm_P0.5mm_EP1x2.65_ThermalVias
U4: OPA182IDBVR; SOT-23-5
U5: ADS1115BQDGSRQ1; VSSOP-10_3x3mm_P0.5mm
kibuzzard-64AE83D2: G***; kibuzzard-64AE83D2
kibuzzard-64AE87D5, kibuzzard-64AE87D5#2: G***; kibuzzard-64AE87D5
kibuzzard-63491EED: G***; kibuzzard-63491EED
kibuzzard-63491F09: G***; kibuzzard-63491F09

Connections:
+3V3: C2.1, C4.1, C9.1, C10.1, C13.1, C15.1, JP2.1 (A), JP3.2 (B), R1.1, R13.1, R14.1, R15.1, U1.6 (VIN), U1.8 (VCC), U2.8 (V+), U3.11 (OUT+), U4.5 (V+), U5.8 (VDD)
+5V: C1.1, J2.4, J3.15 (5V), J3.16 (5V), J5.1, Q1.2 (S), R11.1, U3.3 (VIN), U3.8 (EN-), U3.12 (EN+)
-3V3: C8.1, C11.1, R2.2, U3.6 (OUT-), U4.2 (V-)
/3V3_MCU: J3.2 (3.3V), JP3.1 (A)
/A2+/A1-: C3.1, D1.1 (K), R3.2, U2.3 (+), U2.6 (-)
/A2-: R9.2, R10.1, U2.2 (-)
/ADDR: JP2.2 (C), U5.1 (ADDR)
/AIN0: C3.2, D1.2 (A), U2.7, U5.4 (AIN0)
/AIN1: C5.1, R4.2, U5.5 (AIN1)
/C+: C7.1, U3.10 (C+)
/C-: C7.2, U3.9 (C-)
/CANSCL+: D2.1 (K1), J5.3, R16.1, U1.4 (CANSCLH)
/CANSCL-: D2.2 (K2), J5.2, R17.2, U1.5 (CANSCLL)
/CANSDA+: D3.2 (K2), J5.4, R18.1, U1.2 (CANSDAH)
/CANSDA-: D3.1 (K1), J5.5, R19.2, U1.1 (CANSDAL)
/CP: C6.1, U3.5 (CP)
/DIV_MID: D5.1 (K), R7.2, R8.1, U4.3 (+)
/DRAIN: Q1.3 (D), R12.1
/EN/MODE: JP1.2 (B), U1.7 (EN/MODE)
/EN/MODE_JP: JP1.1 (A), Q2.3 (D), R15.2
/FB+: R1.2, R6.1, U3.2 (FB+)
/FB-: R2.1, R5.1, U3.7 (FB-)
/LED_A: D4.2 (A), R12.2
/MODE: J3.9 (GPIO_1), Q2.1 (G)
/PGOOD: Q1.1 (G), R11.2, U3.1 (PGOOD)
/SCL: J2.2, J3.7 (I2C_SCL), R13.2, U1.9 (SCL), U5.10 (SCL)
/SDA: J2.3, J3.8 (I2C_SDA), R14.2, U1.10 (SDA), U5.9 (SDA)
/TERM_MID_SCL: C14.1, R16.2, R17.1
/TERM_MID_SDA: C12.1, R18.2, R19.1
/VIN+: J1.2, R7.1
/VIN_DIV: R3.1, R9.1, U4.1, U4.4 (-)
/VOUT: R4.1, R10.2, U2.1
GND: C1.2, C2.2, C4.2, C5.2, C6.2, C8.2, C9.2, C10.2, C11.2, C12.2, C13.2, C14.2, C15.2, D2.3 (CC), D3.3 (CC), D4.1 (K), D5.2 (K), J1.1, J2.1, J3.1 (GND), J5.6, JP2.3 (B), Q2.2 (S), R5.2, R6.2, R8.2, U1.3 (GND), U1.11 (PAD), U2.4 (V-), U2.5 (+), U3.4 (GND), U3.13 (PAD), U5.3 (GND)
