EPFLXplore/ERC_AV_HW/hats/ADS1234_mass_sensor/ADS1234_mass_sensor.kicad_pcb

## KiCad design hats/ADS1234_mass_sensor/ADS1234_mass_sensor.kicad_pcb (2023-09-30)

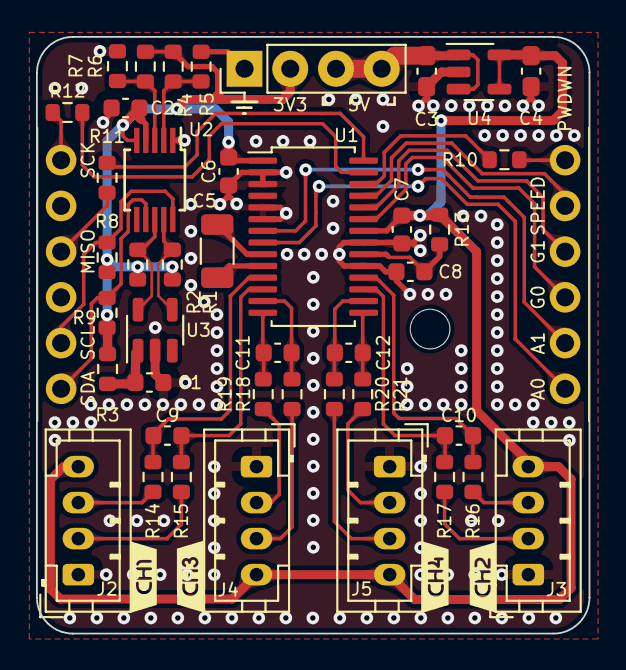
[picture p104: board ADS1234_mass_sensor.kicad_pcb from above]

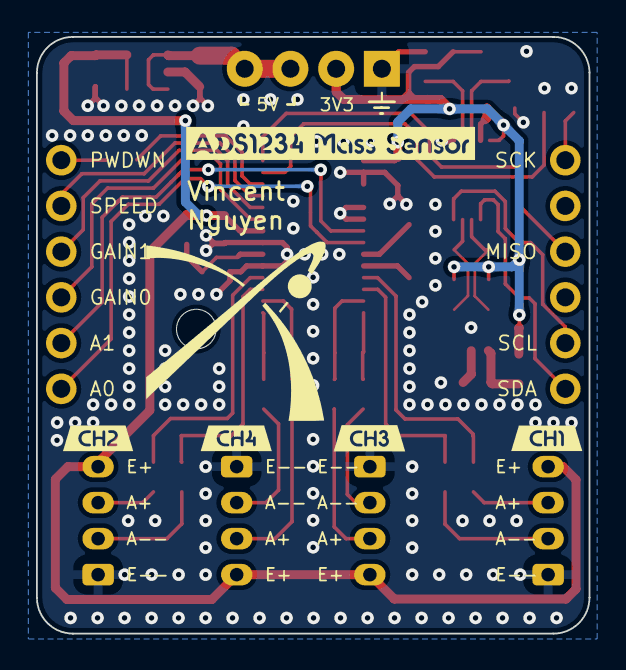
[picture p105: board ADS1234_mass_sensor.kicad_pcb from below]

Board: 2 copper layers, 30.7 x 33.1 mm, 52 parts (6 on the bottom side), 41 nets.

Parts:
C1, C2, C6, C7: 0.1uF; C_0603_1608Metric
C3, C4: 2.2uF; C_0603_1608Metric_Pad1.08x0.95mm_HandSolder
C5: 0.1uF C0G; C_1206_3216Metric
C8, C9, C10, C11, C12: 10 nF C0G; C_0603_1608Metric
G1: Xplore_Logo; Xplore_Logo_X_only_10mm
J1: Hat_connector_hole
J2, J3, J4, J5: B4B-PH-K; JST_PH_B4B-PH-K_1x04_P2.00mm_Vertical
R1, R2: 10k; R_0603_1608Metric
R3: 200R; R_0603_1608Metric
R4, R6: 1M; R_0603_1608Metric
R5, R7: 681k; R_0603_1608Metric
R8, R9: DNP; R_0603_1608Metric
R10, R11, R12: 47R; R_0603_1608Metric
R13, R14, R15, R16, R17, R18, R19, R20, R21: 100R; R_0603_1608Metric
U1: ADS1234IPW; ADS1234
U2: LTC4316; MSOP-10_3x3mm_P0.5mm
U3: MCP9800A0T-M/OT; SOT-23-5
U4: ADP7118AUJZ-4.5-R7; SOT-23-5
kibuzzard-64B335B3, kibuzzard-64B335B3#2: G***; kibuzzard-64B335B3
kibuzzard-64B335BD: G***; kibuzzard-64B335BD
kibuzzard-64B335C8, kibuzzard-64B335C8#2: G***; kibuzzard-64B335C8
kibuzzard-64B335D1: G***; kibuzzard-64B335D1
kibuzzard-64B338A8: G***; kibuzzard-64B338A8
kibuzzard-64B339BA: G***; kibuzzard-64B339BA
kibuzzard-64B339D1: G***; kibuzzard-64B339D1

Connections:
+3V3: C2.1, C6.1, J1.2 (3.3V), R1.1, R2.1, R3.2, R4.1, R6.1, R8.1, R9.1, U1.1 (DVDD), U2.4 (VCC), U2.5 (ENABLE)
+4V5: C4.1, C7.1, J2.4, J3.4, J4.4, J5.4, R13.2, U1.22 (AVDD), U4.4 (SENSE/ADJ), U4.5 (OUT)
+5V: C3.1, J1.15 (5V), J1.16 (5V), U4.1 (IN), U4.3 (EN)
/A0: J1.9 (GPIO_1), U1.8 (A0)
/A1: J1.10 (GPIO_2), U1.7 (A1)
/AINN1: C9.2, R15.1, U1.12 (AINN1)
/AINN2: C10.2, R17.1, U1.17 (AINN2)
/AINN3: C11.2, R19.1, U1.14 (AINN3)
/AINN4: C12.2, R21.1, U1.15 (AINN4)
/AINP1: C9.1, R14.1, U1.11 (AINP1)
/AINP2: C10.1, R16.1, U1.18 (AINP2)
/AINP3: C11.1, R18.1, U1.13 (AINP3)
/AINP4: C12.1, R20.1, U1.16 (AINP4)
/CAP1: C5.1, U1.9 (CAP)
/CAP2: C5.2, U1.10 (CAP)
/CH1_A+: J2.3, R14.2
/CH1_A-: J2.2, R15.2
/CH2_A+: J3.3, R16.2
/CH2_A-: J3.2, R17.2
/CH3_A+: J4.3, R18.2
/CH3_A-: J4.2, R19.2
/CH4_A+: J5.3, R20.2
/CH4_A-: J5.2, R21.2
/GAIN0: J1.11 (GPIO_3), U1.23 (GAIN0)
/GAIN1: J1.12 (GPIO_4), U1.24 (GAIN1)
/MCU_~PWDN: J1.14 (GPIO_6), R10.1
/MISO: J1.5 (SPI_MISO), R11.1
/REFP: C8.1, R13.1, U1.20 (REFP)
/SCK: J1.3 (SPI_SCK), R12.1
/SCL: J1.7 (I2C_SCL), R8.2, U2.10 (SCLIN)
/SCLK: R12.2, U1.27 (SCLK)
/SCLOUT: R1.2, U2.9 (SCLOUT), U3.4 (SCLK)
/SDA: J1.8 (I2C_SDA), R9.2, U2.7 (SDAIN)
/SDAOUT: R2.2, U2.8 (SDAOUT), U3.5 (SDA)
/SPEED: J1.13 (GPIO_5), U1.25 (SPEED)
/XORH: R4.2, R5.1, U2.2 (XORH)
/XORL: R6.2, R7.1, U2.3 (XORL)
/~DRDY/DOUT: R11.2, U1.28 (~DRDY/DOUT)
/~PWDN: R10.2, U1.26 (~PDWN)
GND: C1.2, C2.2, C3.2, C4.2, C6.2, C7.2, C8.2, J1.1 (GND), J2.1, J3.1, J4.1, J5.1, R5.2, R7.2, U1.2 (DGND), U1.3 (CLKIN/XTAL1), U1.5 (DGND), U1.6 (DGND), U1.19 (REFN), U1.21 (AGND), U2.1 (GND), U3.2 (GND), U4.2 (GND)
VDD: C1.1, R3.1, U3.1 (V_{DD})
