EPFLXplore/ERC_AV_HW/hats/spectrophotometer_interface/spectrophotometer_interface.kicad_pcb

## KiCad design hats/spectrophotometer_interface/spectrophotometer_interface.kicad_pcb (2023-09-30)

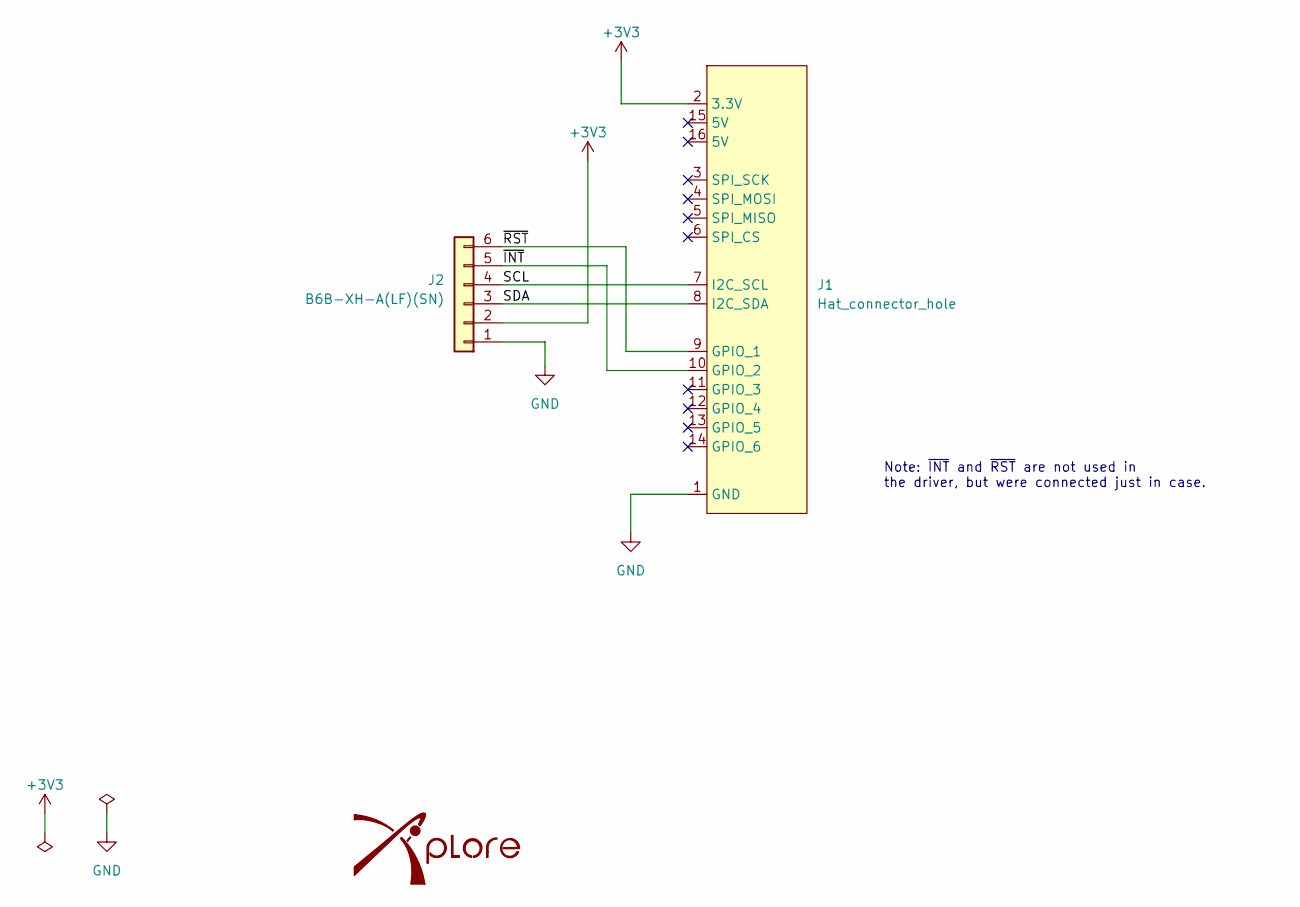
[picture p106: schematic spectrophotometer_interface.kicad_sch, Spectrophotometer Interface Connector Hat]

Parts:
G1: Xplore_Logo; Xplore_Logo_X_only_20mm
J1: Hat_connector_hole
J2: B6B-XH-A(LF)(SN); JST_XH_B6B-XH-A_1x06_P2.50mm_Vertical; Digikey ref 455-2271-ND

Connections:
+3V3: J1.2 (3.3V), J2.2
/SCL: J1.7 (I2C_SCL), J2.4
/SDA: J1.8 (I2C_SDA), J2.3
/~INT: J1.10 (GPIO_2), J2.5
/~RST: J1.9 (GPIO_1), J2.6
GND: J1.1 (GND), J2.1

Notes on the sheet:
Note: ~{INT} and ~{RST} are not used in the driver, but were connected just in case.

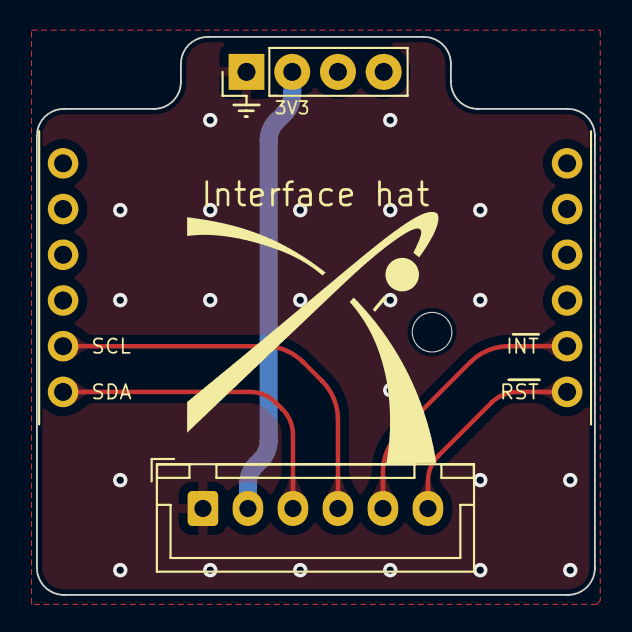
[picture p107: board spectrophotometer_interface.kicad_pcb from above]

Board: 2 copper layers, 31.0 x 31.0 mm, 4 parts (0 on the bottom side), 6 nets.

Other parts of the board:
kibuzzard-64B17C81: G***; kibuzzard-64B17C81
