EPFLXplore/ERC_AV_HW/hats/can_transceiver/can_transceiver.kicad_pcb

## KiCad design hats/can_transceiver/can_transceiver.kicad_pcb (2023-09-30)

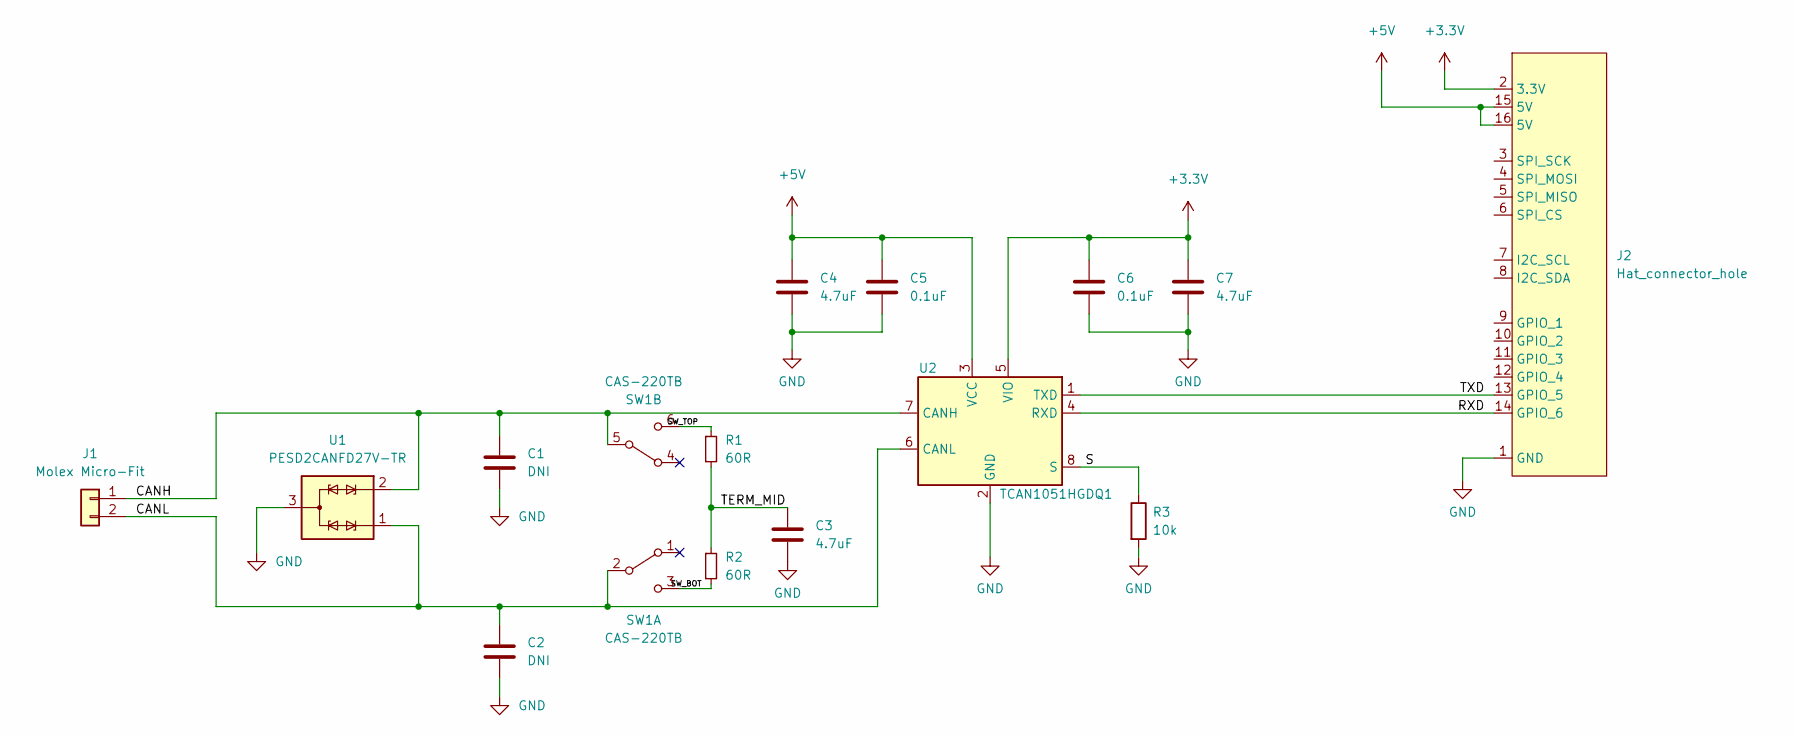
[picture p108: schematic can_transceiver.kicad_sch, FD CAN Transceiver Hat]

Parts:
C1, C2: DNI; C_0603_1608Metric
C3, C4, C7: 4.7uF; C_0603_1608Metric
C5, C6: 0.1uF; C_0603_1608Metric
J1: Molex Micro-Fit; Molex_Micro-Fit_3.0_43650-0200_1x02_P3.00mm_Horizontal; Digikey ref WM1860-ND
J2: Hat_connector_hole
R1, R2: 60R; R_0603_1608Metric
R3: 10k; R_0603_1608Metric
SW1: CAS-220TB; Digikey ref CAS220GCT-ND
U1: PESD2CANFD27V-TR; SOT-23; Digikey ref 1727-PESD2CANFD27V-CT-ND
U2: TCAN1051HGDQ1; SOIC-8_3.9x4.9mm_P1.27mm

Connections:
+3.3V: C6.1, C7.1, J2.2 (3.3V), U2.5 (VIO)
+5V: C4.1, C5.1, J2.15 (5V), J2.16 (5V), U2.3 (VCC)
/CANH: C1.1, J1.1, SW1.5 (B), U1.2 (K2), U2.7 (CANH)
/CANL: C2.1, J1.2, SW1.2 (B), U1.1 (K1), U2.6 (CANL)
/RXD: J2.14 (GPIO_6), U2.4 (RXD)
/S: R3.1, U2.8 (S)
/SW_BOT: R2.2, SW1.3 (C)
/SW_TOP: R1.1, SW1.6 (C)
/TERM_MID: C3.1, R1.2, R2.1
/TXD: J2.13 (GPIO_5), U2.1 (TXD)
GND: C1.2, C2.2, C3.2, C4.2, C5.2, C6.2, C7.2, J2.1 (GND), R3.2, U1.3 (CC), U2.2 (GND)

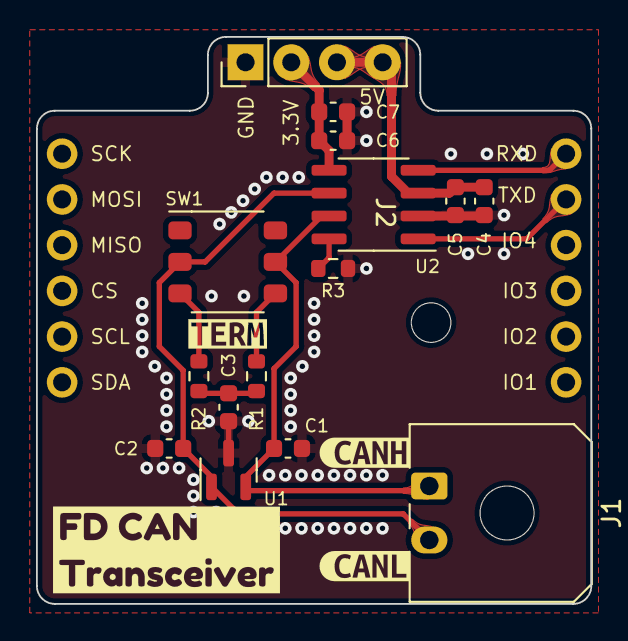
[picture p109: board can_transceiver.kicad_pcb from above]

Board: 2 copper layers, 30.8 x 31.5 mm, 19 parts (0 on the bottom side), 11 nets.

Other parts of the board:
kibuzzard-636A35EF: G***; kibuzzard-636A35EF
kibuzzard-636A35F6: G***; kibuzzard-636A35F6
kibuzzard-636A273C: G***; kibuzzard-636A273C
kibuzzard-636A342C: G***; kibuzzard-636A342C
