EPFLXplore/ERC_AV_HW/hats/imu_9_axis/imu_9_axis.kicad_pcb

## KiCad design hats/imu_9_axis/imu_9_axis.kicad_pcb (2023-09-30)

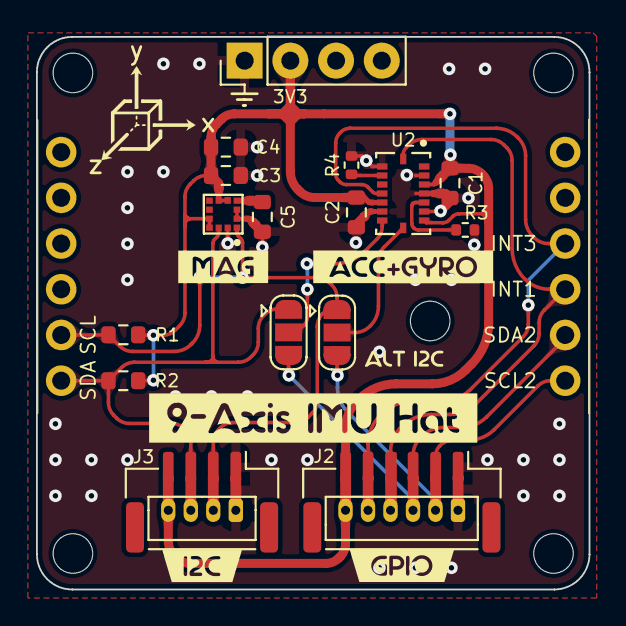
[picture p110: board imu_9_axis.kicad_pcb from above]

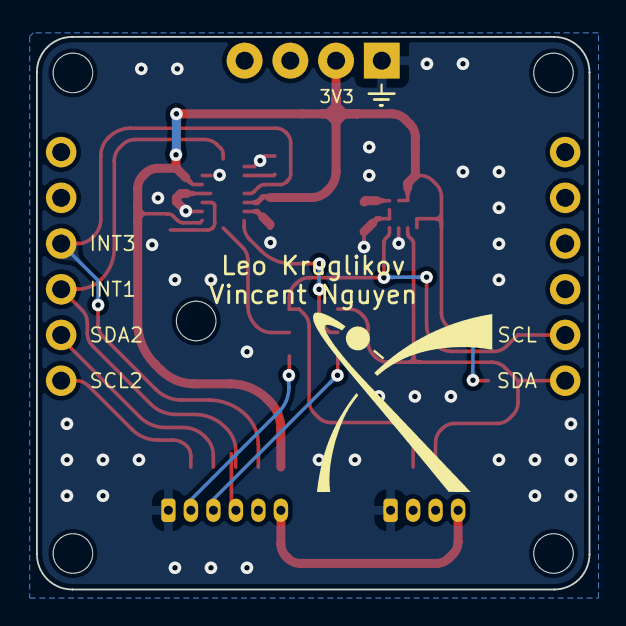
[picture p111: board imu_9_axis.kicad_pcb from below]

Board: 2 copper layers, 30.7 x 30.7 mm, 28 parts (2 on the bottom side), 13 nets.

Parts:
C1, C2, C3, C5: 100nF; R_0603_1608Metric
C4: 1uF; R_0603_1608Metric
G1: Xplore_Logo; Xplore_Logo_X_only_10mm
H1, H2, H3, H4: M2; MountingHole_2.2mm_M2
J1: Hat_connector_hole
J2: BM06B-GHS-TBT(LF)(SN)(N); PicoBlade_JST-GH-1x06_1.25mm_Vertical
J3: BM04B-GHS-TBT(LF)(SN)(N); PicoBlade-JST-GH-1x04_1.25mm_Vertical
JP1: BMI_SCL; SolderJumper-3_P1.3mm_Open_RoundedPad1.0x1.5mm
JP2: BMI_SDA; SolderJumper-3_P1.3mm_Open_RoundedPad1.0x1.5mm
R1, R2: DNP; R_0603_1608Metric
R3, R4: DNP; R_0402_1005Metric
U1: LIS3MDL; LGA12_2X2
U2: BMI088
kibuzzard-64B87A2A: G***; kibuzzard-64B87A2A
kibuzzard-64B87A9E: G***; kibuzzard-64B87A9E
kibuzzard-64B87A63: G***; kibuzzard-64B87A63
kibuzzard-64B87B4C: G***; kibuzzard-64B87B4C
kibuzzard-64B87E6D: G***; kibuzzard-64B87E6D
kibuzzard-64B8586A: G***; kibuzzard-64B8586A
kibuzzard-64B85862: G***; kibuzzard-64B85862

Connections:
+3V3: C1.1, C2.1, C3.1, C4.1, J1.2 (3.3V), J2.6, J3.4, R1.1, R2.1, U1.5 (Vdd), U1.6 (Vdd_IO), U1.9 (SDO/SA1), U1.10 (CS), U2.3 (VDD), U2.7 (PS), U2.11 (VDDIO)
/BMI_SCL: JP1.2 (C), U2.8 (SCL/SCK)
/BMI_SDA: JP2.2 (C), U2.9 (SDA/SDI)
/C1: C5.1, U1.4 (C1)
/CSB1: R4.1, U2.14 (CSB1)
/CSB2: R3.1, U2.5 (CSB2)
/INT1: J1.11 (GPIO_3), J2.4, U2.16 (INT1)
/INT3: J1.12 (GPIO_4), J2.5, U2.12 (INT3)
/SCL: J1.7 (I2C_SCL), J3.2, JP1.1 (A), R1.2, U1.1 (SCL/SPC)
/SCL_ALT: J1.9 (GPIO_1), J2.2, JP1.3 (B)
/SDA: J1.8 (I2C_SDA), J3.3, JP2.1 (A), R2.2, U1.11 (SDA/SDI/SDO)
/SDA_ALT: J1.10 (GPIO_2), J2.3, JP2.3 (B)
GND: C1.2, C2.2, C3.2, C4.2, C5.2, J1.1 (GND), J2.1, J3.1, R3.2, R4.2, U1.2 (GND), U1.3 (GND), U1.12 (GND), U2.2 (NC), U2.4 (GND), U2.6 (GNDIO), U2.10 (SDO2), U2.15 (SDO1)
