EPFLXplore/ERC_AV_HW/hats/servo_level_shifter/servo_level_shifter.kicad_pcb

## KiCad design hats/servo_level_shifter/servo_level_shifter.kicad_pcb (2023-09-30)

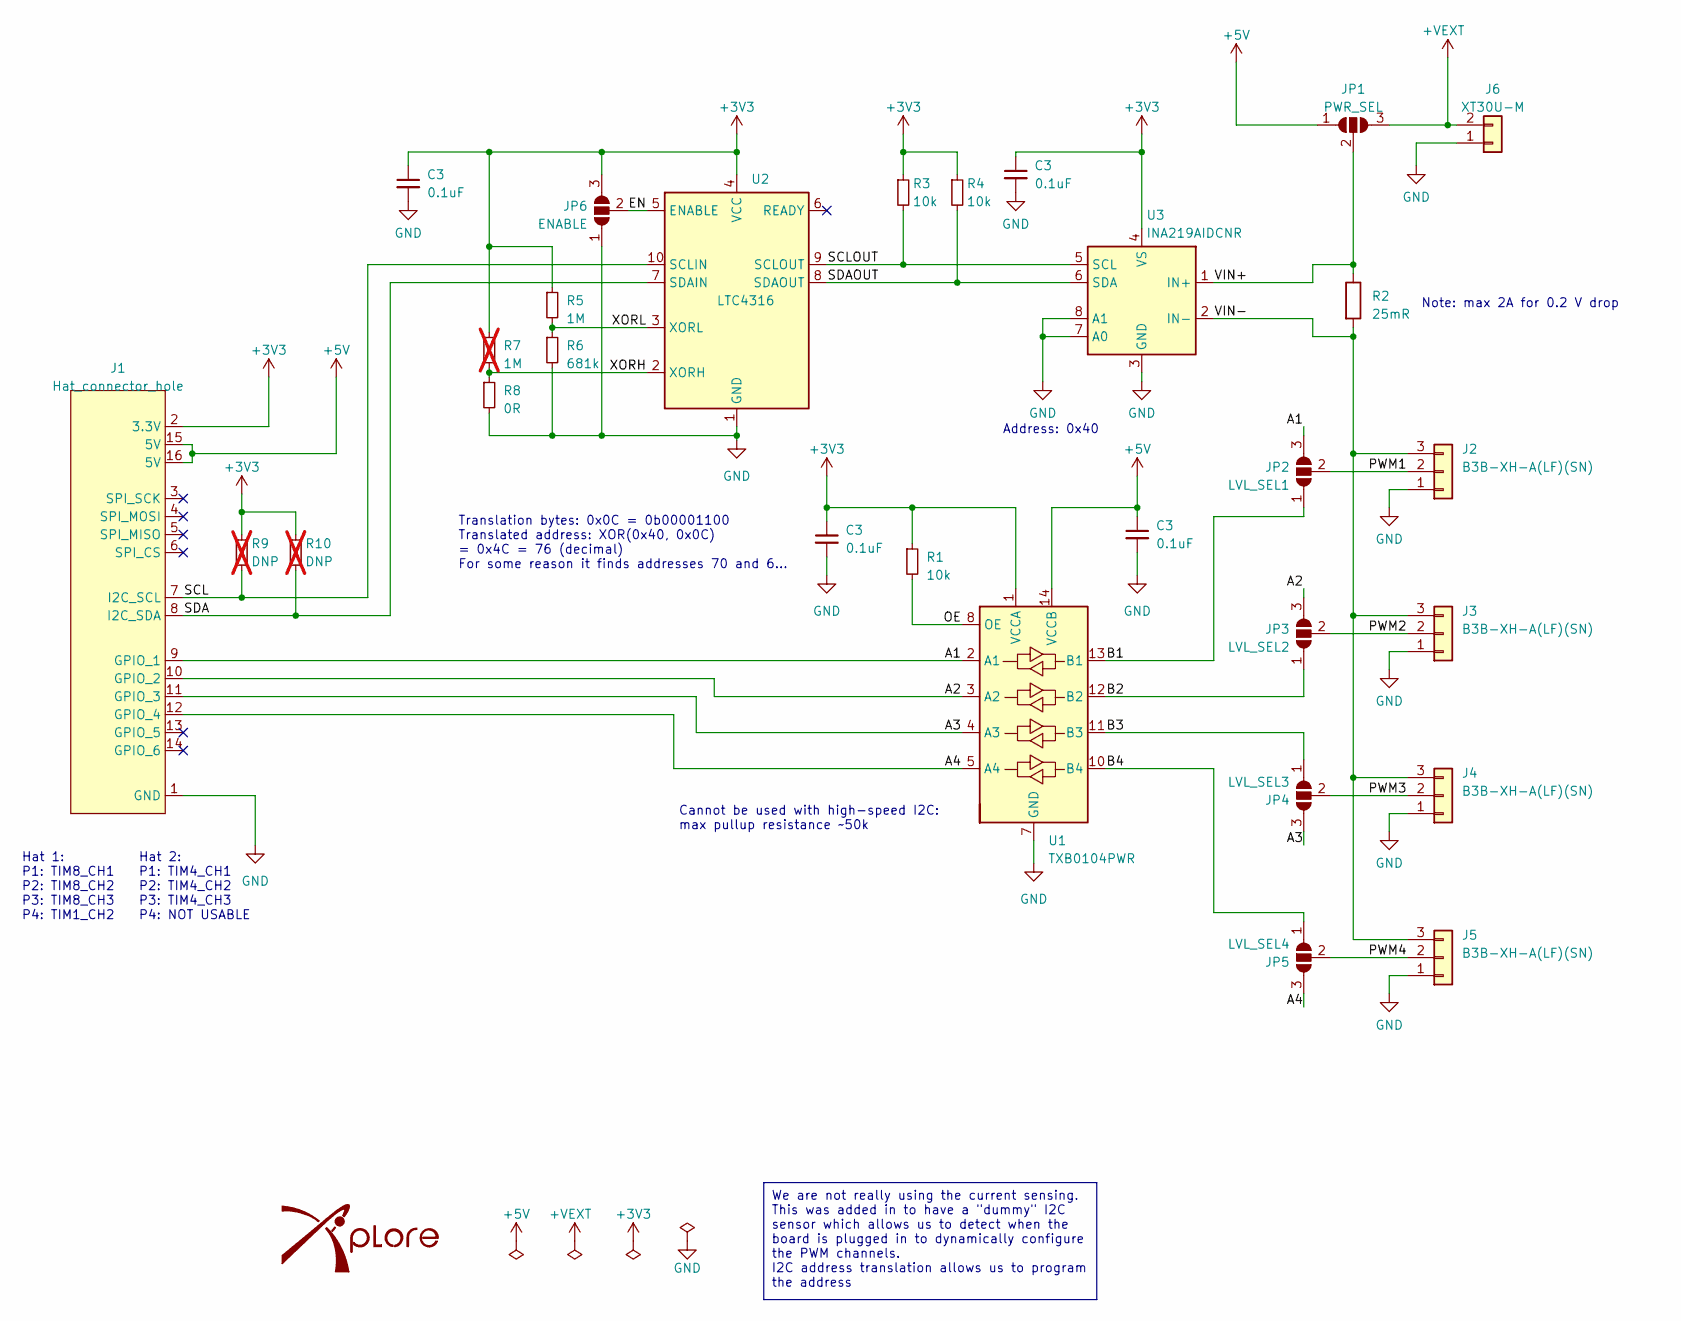
[picture p112: schematic servo_level_shifter.kicad_sch, TXB104 Bi-directional Voltage Translator Hat]

Parts:
C3: 0.1uF; C_0603_1608Metric; Digikey ref 478-KGM15BR71H104JTCT-ND
G1: Xplore_Logo; Xplore_Logo_X_only_10mm
J1: Hat_connector_hole
J2, J3, J4, J5: B3B-XH-A(LF)(SN); JST_XH_B3B-XH-A_1x03_P2.50mm_Vertical; Digikey ref 455-2248-ND
J6: XT30U-M; AMASS_XT30U-M_1x02_P5.0mm_Vertical
JP1: PWR_SEL; SolderJumper-3_P1.3mm_Open_RoundedPad1.0x1.5mm
JP2: LVL_SEL1; SolderJumper-3_P1.3mm_Open_RoundedPad1.0x1.5mm
JP3: LVL_SEL2; SolderJumper-3_P1.3mm_Open_RoundedPad1.0x1.5mm
JP4: LVL_SEL3; SolderJumper-3_P1.3mm_Open_RoundedPad1.0x1.5mm
JP5: LVL_SEL4; SolderJumper-3_P1.3mm_Open_RoundedPad1.0x1.5mm
JP6: ENABLE; SolderJumper-3_P1.3mm_Open_RoundedPad1.0x1.5mm
R1, R3, R4: 10k; R_0603_1608Metric; Digikey ref RNCP0603FTD10K0CT-ND
R2: 25mR; R_2512_6332Metric_Pad1.40x3.35mm_HandSolder; Digikey ref CRA2512-FZ-R025ELFCT-ND
R5: 1M; R_0603_1608Metric; Digikey ref A121559CT-ND
R6: 681k; R_0603_1608Metric; Digikey ref 311-681KHRCT-ND
R7: 1M; R_0603_1608Metric; Digikey ref A121559CT-ND; not fitted
R8: 0R; R_0603_1608Metric
R9, R10: DNP; R_0603_1608Metric; not fitted
U1: TXB0104PWR; TSSOP-14_4.4x5mm_P0.65mm; Digikey ref 296-21929-1-ND
U2: LTC4316; MSOP-10_3x3mm_P0.5mm; Digikey ref 505-LTC4316IMS#PBF-ND
U3: INA219AIDCNR; SOT-23-8; Digikey ref 296-23770-1-ND

Connections:
+VEXT: J6.2, JP1.3 (B)
/A1: J1.9 (GPIO_1), JP2.3 (B), U1.2 (A1)
/A2: J1.10 (GPIO_2), JP3.3 (B), U1.3 (A2)
/A3: J1.11 (GPIO_3), JP4.3 (B), U1.4 (A3)
/A4: J1.12 (GPIO_4), JP5.3 (B), U1.5 (A4)
/B1: JP2.1 (A), U1.13 (B1)
/B2: JP3.1 (A), U1.12 (B2)
/B3: JP4.1 (A), U1.11 (B3)
/B4: JP5.1 (A), U1.10 (B4)
/EN: JP6.2 (C), U2.5 (ENABLE)
/OE: R1.2, U1.8 (OE)
/PWM1: J2.2, JP2.2 (C)
/PWM2: J3.2, JP3.2 (C)
/PWM3: J4.2, JP4.2 (C)
/PWM4: J5.2, JP5.2 (C)
/SCL: J1.7 (I2C_SCL), R9.2, U2.10 (SCLIN)
/SCLOUT: R3.2, U2.9 (SCLOUT), U3.5 (SCL)
/SDA: J1.8 (I2C_SDA), R10.2, U2.7 (SDAIN)
/SDAOUT: R4.2, U2.8 (SDAOUT), U3.6 (SDA)
/VIN+: JP1.2 (C), R2.1, U3.1 (IN+)
/VIN-: J2.3, J3.3, J4.3, J5.3, R2.2, U3.2 (IN-)
/XORH: R7.2, R8.1, U2.2 (XORH)
/XORL: R5.2, R6.1, U2.3 (XORL)
GND: C3.2, J1.1 (GND), J2.1, J3.1, J4.1, J5.1, J6.1, JP6.1 (A), R6.2, R8.2, U1.7 (GND), U2.1 (GND), U3.3 (GND), U3.7 (A0), U3.8 (A1); also elsewhere on the board

Notes on the sheet:
We are not really using the current sensing. This was added in to have a "dummy" I2C sensor which allows us to detect when the board is plugged in to dynamically configure the PWM channels. I2C address translation allows us to program the address
Hat 2: P1: TIM4_CH1 P2: TIM4_CH2 P3: TIM4_CH3 P4: NOT USABLE
Translation bytes: 0x0C = 0b00001100 Translated address: XOR(0x40, 0x0C) = 0x4C = 76 (decimal) For some reason it finds addresses 70 and 6...
Address: 0x40
Note: max 2A for 0.2 V drop
Hat 1: P1: TIM8_CH1 P2: TIM8_CH2 P3: TIM8_CH3 P4: TIM1_CH2
Cannot be used with high-speed I2C: max pullup resistance ~50k

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
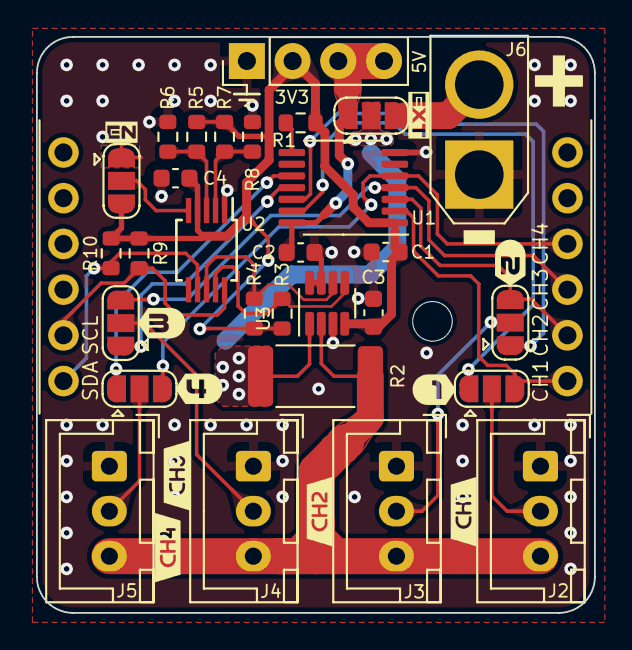
[picture p113: board servo_level_shifter.kicad_pcb from above]

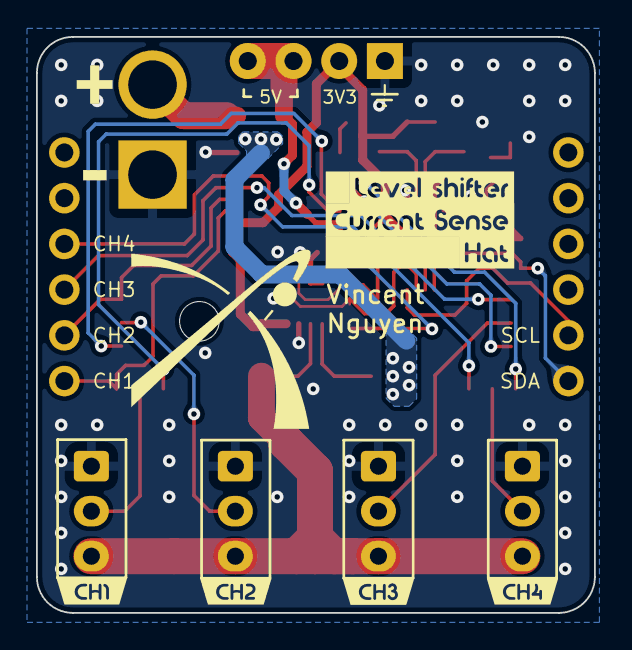
[picture p114: board servo_level_shifter.kicad_pcb from below]

Board: 2 copper layers, 31.0 x 32.0 mm, 51 parts (10 on the bottom side), 26 nets.

Other parts of the board:
C1, C2, C4: 0.1uF; C_0603_1608Metric
kibuzzard-64B2D4C0: G***; kibuzzard-64B2D4C0
kibuzzard-64B2D4E1: G***; kibuzzard-64B2D4E1
kibuzzard-64B2D5B5: G***; kibuzzard-64B2D5B5
kibuzzard-64B2D5C0: G***; kibuzzard-64B2D5C0
kibuzzard-64B2D5D3: G***; kibuzzard-64B2D5D3
kibuzzard-64B2D5F7: G***; kibuzzard-64B2D5F7
kibuzzard-64B2D6D4: G***; kibuzzard-64B2D6D4
kibuzzard-64B2D6DE: G***; kibuzzard-64B2D6DE
kibuzzard-64B2D6E9: G***; kibuzzard-64B2D6E9
kibuzzard-64B2D6F0: G***; kibuzzard-64B2D6F0
kibuzzard-64B2D8B6: G***; kibuzzard-64B2D8B6
kibuzzard-64B2D9BB: G***; kibuzzard-64B2D9BB
kibuzzard-64B2D86D: G***; kibuzzard-64B2D86D
kibuzzard-64B2D98F: G***; kibuzzard-64B2D98F
kibuzzard-64B2D504: G***; kibuzzard-64B2D504
kibuzzard-64B2D508: G***; kibuzzard-64B2D508
kibuzzard-64B2D646: G***; kibuzzard-64B2D646
kibuzzard-64B2D888: G***; kibuzzard-64B2D888
kibuzzard-64B2D984: G***; kibuzzard-64B2D984
kibuzzard-63491EED: G***; kibuzzard-63491EED
kibuzzard-63491F09: G***; kibuzzard-63491F09

Their connections:
GND: C1.2, C2.2, C4.2; also elsewhere on the board
