EPFLXplore/ERC_AV_HW/hats/jetson_hat/HatV5.kicad_pcb

## KiCad design hats/jetson_hat/HatV5.kicad_pcb (2024-08-22)

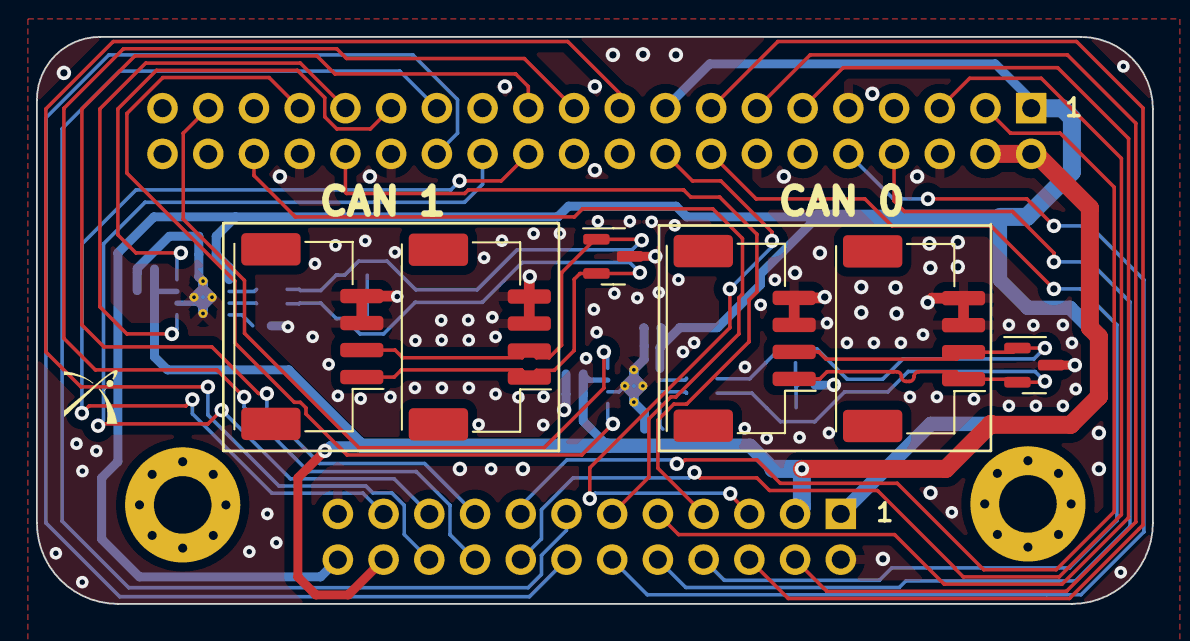
[picture p115: board HatV5.kicad_pcb from above]

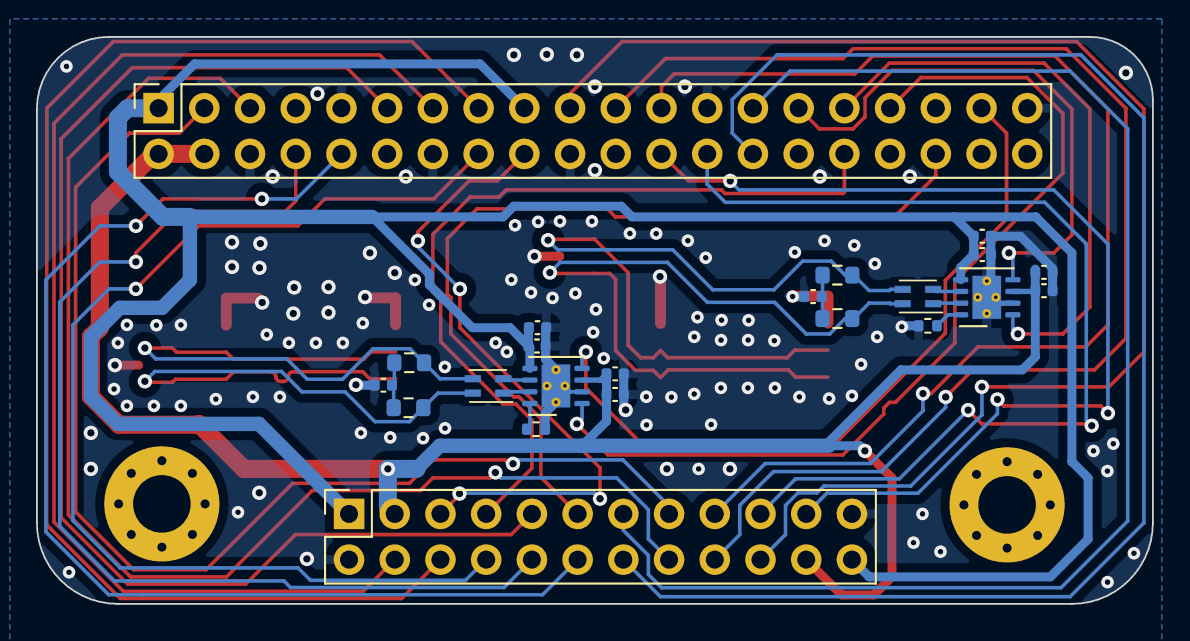
[picture p116: board HatV5.kicad_pcb from below]

Board: 4 copper layers, 62.0 x 31.5 mm, 30 parts (22 on the bottom side), 37 nets.

Parts:
C1, C4, C6, C9: 4.7uF; C_0402_1005Metric
C2, C3, C7, C8: 100nF; C_0402_1005Metric
C5, C10: 4.7nF; C_0402_1005Metric
FL1, FL2: ACE1V2012-222-R
H1, H2: M3; MountingHole_3.2mm_M3_Pad_Via
J1, J2, J3, J4: CLIK-Mate 502584; Molex_CLIK-Mate_505405-0470_1x04-1MP_P1.50mm_Vertical
J5: 02x20 2.54 mm Female Socket; PinSocket_2x20_P2.54mm_Vertical
J6: 24 Pin Header; PinSocket_2x12_P2.54mm_Vertical
R1, R4: 4k7; R_0402_1005Metric
R2, R3, R5, R6: 60R; R_0603_1608Metric
U1, U3: TCAN1051HGVDRBRQ1; HVSON-8-1EP_3x3mm_P0.65mm_EP1.6x2.4mm_ThermalVias
U2, U4: PESD2CANFD27V-TR; SOT-23

Connections:
+3V3: C1.1, C2.1, C6.1, C7.1, J5.1, J5.17, J6.1, J6.24, U1.5 (VIO), U3.5 (VIO)
+5V: C3.1, C4.1, C8.1, C9.1, J5.2, J5.4, J6.3, J6.22, U1.3 (VCC), U3.3 (VCC)
/CAN0_DIN: J5.29, U1.4 (RXD)
/CAN0_DOUT: J5.31, U1.1 (TXD)
/CAN1_DIN: J5.37, U3.4 (RXD)
/CAN1_DOUT: J5.33, U3.1 (TXD)
/CAN BUS 0/CAN+: FL1.1, U1.7 (CANH)
/CAN BUS 0/CAN-: FL1.2, U1.6 (CANL)
/CAN BUS 0/CAN_SILENT_1: R1.1, U1.8 (S)
/CAN BUS 0/CH0+: FL1.4, J1.1, J2.1, R2.1, U2.2 (K2)
/CAN BUS 0/CH0-: FL1.3, J1.2, J2.2, R3.2, U2.1 (K1)
/CAN BUS 0/TERM_CAPA: C5.1, R2.2, R3.1
/CAN BUS 1/CAN+: FL2.1, U3.7 (CANH)
/CAN BUS 1/CAN-: FL2.2, U3.6 (CANL)
/CAN BUS 1/CAN_SILENT_1: R4.1, U3.8 (S)
/CAN BUS 1/CH1+: FL2.4, J3.1, J4.1, R5.1, U4.2 (K2)
/CAN BUS 1/CH1-: FL2.3, J3.2, J4.2, R6.2, U4.1 (K1)
/CAN BUS 1/TERM_CAPA: C10.1, R5.2, R6.1
/GPIO8_AO_DMIC_IN_DAT: J5.16, J6.8
/GPIO9_CAN1_GPIO0_DMIC_CLK: J5.32, J6.7
/GPIO27_PWM2: J5.15, J6.6
/GPIO35_PWM3: J5.18, J6.5
/I2C_GP2_CLK: J5.28, J6.14
/I2C_GP2_DAT: J5.27, J6.13
/I2C_GP5_CLK: J5.5, J6.16
/I2C_GP5_DAT: J5.3, J6.15
/PWM01: J5.13, J6.4
/SPI1_CS0: J5.24, J6.21
/SPI1_CS1: J5.26, J6.19
/SPI1_MISO: J5.21, J6.18
/SPI1_MOSI: J5.19, J6.20
/SPI1_SCK: J5.23, J6.17
/UART1_CTS: J5.36, J6.11
/UART1_RTS: J5.11, J6.9
/UART1_RX: J5.10, J6.12
/UART1_TX: J5.8, J6.10
GND: C1.2, C2.2, C3.2, C4.2, C5.2, C6.2, C7.2, C8.2, C9.2, C10.2, J1.3, J1.4, J2.3, J2.4, J3.3, J3.4, J4.3, J4.4, J5.6, J5.9, J5.14, J5.20, J5.25, J5.30, J5.34, J5.39, J6.2, J6.23, R1.2, R4.2, U1.2 (GND), U1.9 (PAD), U2.3 (CC), U3.2 (GND), U3.9 (PAD), U4.3 (CC)
