EPFLXplore/ERC_AV_HW/nav_controller_interface/nav_controller_interface_v2/nav_controller_interface_v2.kicad_pcb

## KiCad design nav_controller_interface/nav_controller_interface_v2/nav_controller_interface_v2.kicad_pcb (2023-11-25, an earlier design)

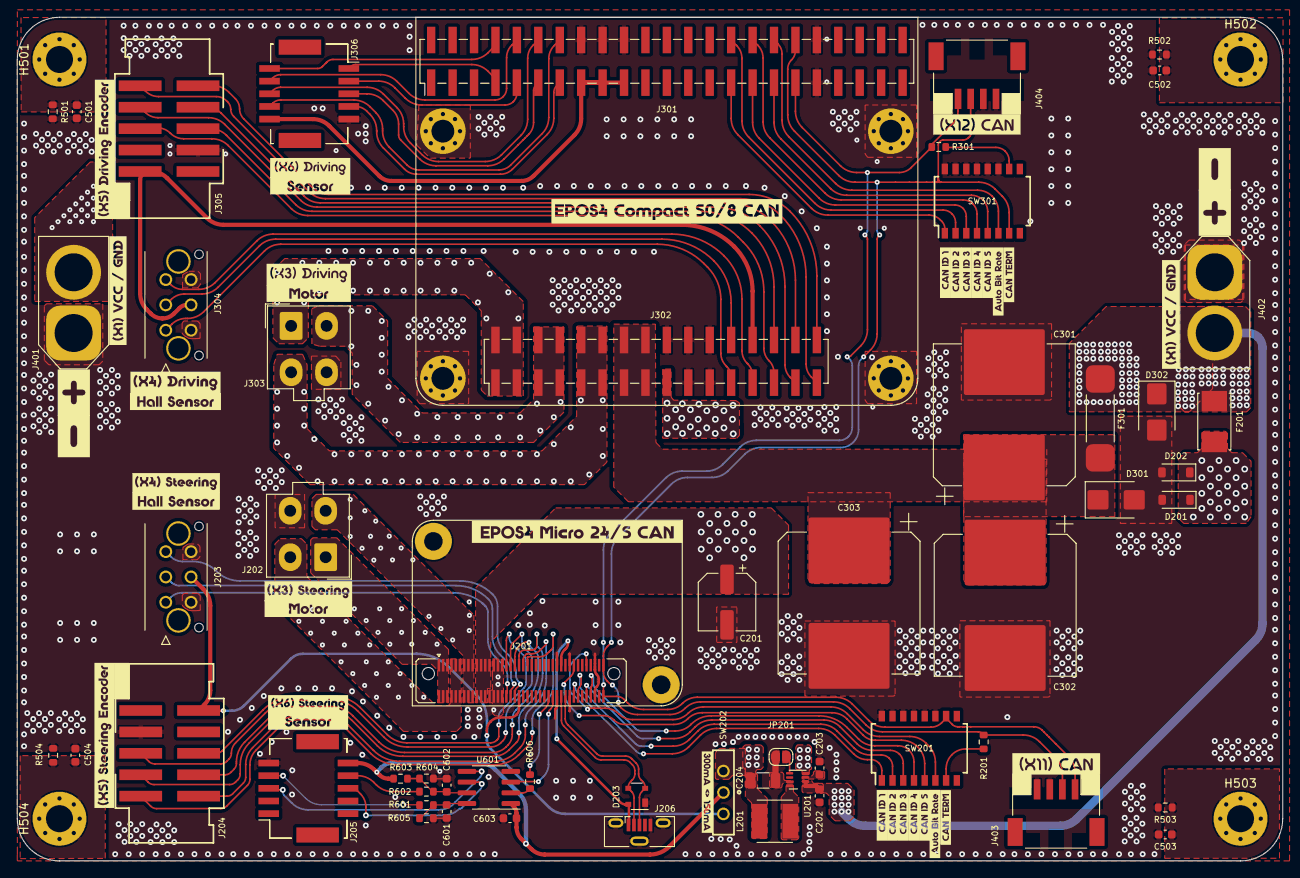
[picture p117: board nav_controller_interface_v2.kicad_pcb from above]

Board: 4 copper layers, 150.0 x 100.0 mm, 107 parts (0 on the bottom side), 76 nets.

Parts:
C201: 68uF (EEHZA1V680XP); CP_Elec_6.3x7.7
C202: 1uF 50V X7R; C_0603_1608Metric
C203: 1uF 6.3V X7R; C_0603_1608Metric
C204: 10uF 6.3V X7R; C_1206_3216Metric
C301, C302, C303: 390uF 63V (UCZ1J391MNS1MS); CP_Elec_16x17.5
C501, C502, C503, C504: 330nF; C_0603_1608Metric
C601, C602: 220pF 50V C0G; C_0603_1608Metric
C603: 0.1uF 50V X7R; C_0603_1608Metric
D201, D202: SMF30A; D_SOD-123
D203: PRTR5V0U2X; SOT-143
D301, D302: SMBJ54A; D_SMB
F201: 0157010; Fuseholder_Littelfuse_Nano2_157x
F301: 0456 020
G201: Micro_24_5_CAN
G301: Compact_50_8_CAN
H201, H202: M2 (2.2mm); MountingHole_2.2mm_M2_Pad
H301, H302, H303, H304: M2.5 (2.7mm); MountingHole_2.7mm_M2.5_Pad_Via
H501, H502, H503, H504: M3 (3.2mm); MountingHole_3.2mm_M3_Pad_Via
J201: EPOS4 Micro 24/5 CAN Terminal/socket (LSHM-140-02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; Samtec_LSHM-140-xx.x-x-DV-N_2x40_P0.50mm_Vertical
J202, J303: Motor (X3) - Molex Mini-Fit Jr.; Molex_Mini-Fit_Jr_5566-04A_2x02_P4.20mm_Vertical
J203, J304: Hall Sensor (X4) - Molex Micro-Fit 3.0; MOLEX_43045-0624
J204, J305: Encoder (X5) - Pin headers 2.54mm; SAMTEC-HTST-105-01-X-DV
J205, J306: Sensor (X6) - Molex CLIK-Mate; MOLEX_5031541090
J206: USB_B_Micro; USB_Micro-B_Molex-105133-0001
J301: 02x23 Socket header (SSM-123-L-DV); SSM-123-L-DV
J302: 02x16 Socket header (SSM-116-L-DV); SSM-116-L-DV
J401, J402: Power supply (X1) - XT60; AMASS_XT60-M_1x02_P7.20mm_Vertical
J403: CAN 1 (X11) - Molex CLIK-Mate; MOLEX_5025840460
J404: CAN2 (X12) - Molex CLIK-Mate; MOLEX_5025840460
JP201: DCDC_PWM_MODE; SolderJumper-2_P1.3mm_Open_RoundedPad1.0x1.5mm
L201: LQH5BPH470MT0L (47uH); LQH5BPB100MT0L
R201, R301: 120R; R_0603_1608Metric
R501, R502, R503, R504: 100k; R_0603_1608Metric
R601, R602: 150R; R_0603_1608Metric
R603, R604: 20k; R_0603_1608Metric
R605: 22k; R_0603_1608Metric
R606: 1k; R_0603_1608Metric
SW201, SW301: 218-8LPST; 2188LPST
SW202: 450301014042
U201: MAX15462BATA+T; MAX15462BATA
U601: ISL8490E; ISL8490E-SOIC-8
kibuzzard-642A0BFC: G***; kibuzzard-642A0BFC
kibuzzard-642A0CF2, kibuzzard-642A0CF2#2: G***; kibuzzard-642A0CF2
kibuzzard-642A0D20, kibuzzard-642A0D20#2: G***; kibuzzard-642A0D20
kibuzzard-642A04E4: G***; kibuzzard-642A04E4
kibuzzard-642A8E9B: G***; kibuzzard-642A8E9B
kibuzzard-642A8EB4: G***; kibuzzard-642A8EB4
kibuzzard-642A8EBB: G***; kibuzzard-642A8EBB
kibuzzard-642A8EC3: G***; kibuzzard-642A8EC3
kibuzzard-642A8EC9: G***; kibuzzard-642A8EC9
kibuzzard-642A8ED1: G***; kibuzzard-642A8ED1
kibuzzard-642A8ED7: G***; kibuzzard-642A8ED7
kibuzzard-642A8EDE: G***; kibuzzard-642A8EDE
kibuzzard-642A8F3A: G***; kibuzzard-642A8F3A
kibuzzard-642A8F5C: G***; kibuzzard-642A8F5C
kibuzzard-642A8F6B: G***; kibuzzard-642A8F6B
kibuzzard-642A8F16: G***; kibuzzard-642A8F16
kibuzzard-642A8F43: G***; kibuzzard-642A8F43
kibuzzard-642A8F53: G***; kibuzzard-642A8F53
kibuzzard-642A8F64: G***; kibuzzard-642A8F64
kibuzzard-642A8F72: G***; kibuzzard-642A8F72
kibuzzard-642A8F79: G***; kibuzzard-642A8F79
kibuzzard-642A8F81: G***; kibuzzard-642A8F81
kibuzzard-642A8FAF: G***; kibuzzard-642A8FAF
kibuzzard-642A8FCA: G***; kibuzzard-642A8FCA
kibuzzard-642A8FD2: G***; kibuzzard-642A8FD2
kibuzzard-642A8FE0: G***; kibuzzard-642A8FE0
kibuzzard-642A056F: G***; kibuzzard-642A056F
kibuzzard-642A90A5: G***; kibuzzard-642A90A5
kibuzzard-642A90AD: G***; kibuzzard-642A90AD
kibuzzard-642A90B7: G***; kibuzzard-642A90B7
kibuzzard-642A90CC: G***; kibuzzard-642A90CC
kibuzzard-642A90E8: G***; kibuzzard-642A90E8
kibuzzard-642A907B: G***; kibuzzard-642A907B
kibuzzard-642A9061: G***; kibuzzard-642A9061
kibuzzard-642A9082: G***; kibuzzard-642A9082
kibuzzard-642A9089: G***; kibuzzard-642A9089
kibuzzard-642A9101: G***; kibuzzard-642A9101

Connections:
/Driving inteface/Auto bit rate: J301.34, SW301.6
/Driving inteface/CAN ID 1: J301.29, SW301.1
/Driving inteface/CAN ID 2: J301.30, SW301.2
/Driving inteface/CAN ID 3: J301.31, SW301.3
/Driving inteface/CAN ID 4: J301.32, SW301.4
/Driving inteface/CAN ID 5: J301.33, SW301.5
/Driving inteface/CANH: J201.79, J301.35, J403.1, J404.1, R301.2, SW201.10
/Driving inteface/CANL: J201.80, J301.36, J403.2, J404.2, R201.1, SW301.7
/Driving inteface/Channel A: J302.27, J305.6
/Driving inteface/Channel A\: J302.28, J305.5
/Driving inteface/Channel A/HsDigIN1: J301.7, J306.1
/Driving inteface/Channel A/HsDigIN1\: J301.8, J306.2
/Driving inteface/Channel B: J302.29, J305.8
/Driving inteface/Channel B\: J302.30, J305.7
/Driving inteface/Channel B/HsDigIN2: J301.9, J306.3
/Driving inteface/Channel B/HsDigIN2\: J301.10, J306.4
/Driving inteface/Channel I: J302.31, J305.10
/Driving inteface/Channel I\: J302.32, J305.9
/Driving inteface/Clock/HsDigOUT1: J301.11, J306.5
/Driving inteface/Clock/HsDigOUT1\: J301.12, J306.6
/Driving inteface/Data/HsDigIN4: J301.13, J306.7
/Driving inteface/Data/HsDigIN4\: J301.14, J306.8
/Driving inteface/Hall sensor 1: J302.23, J304.1
/Driving inteface/Hall sensor 2: J302.24, J304.2
/Driving inteface/Hall sensor 3: J302.25, J304.3
/Driving inteface/M1/+M: J302.1, J302.2, J302.3, J302.4, J303.1
/Driving inteface/M2/-M: J302.5, J302.6, J302.7, J302.8, J303.2
/Driving inteface/M3: J302.9, J302.10, J302.11, J302.12, J303.3
/Driving inteface/VCC_FUSED: C301.1, C302.1, C303.1, D301.1 (K), F301.2, J302.13, J302.14, J302.15, J302.16
/Steering interface/Auto bit rate: J201.72, SW201.6
/Steering interface/CAN ID 1: J201.65, SW201.1
/Steering interface/CAN ID 2: J201.67, SW201.2
/Steering interface/CAN ID 3: J201.71, SW201.3
/Steering interface/CAN ID 4: J201.73, SW201.4
/Steering interface/CAN ID 5: J201.66, SW201.5
/Steering interface/Channel A: J201.34, J204.6
/Steering interface/Channel A\: J201.36, J204.5
/Steering interface/Channel B: J201.38, J204.8
/Steering interface/Channel B\: J201.40, J204.7
/Steering interface/Channel I: J201.42, J204.10
/Steering interface/Channel I\: J201.44, J204.9
/Steering interface/Clock/HsDigOUT1: J205.5, U601.5 (Y)
/Steering interface/Clock/HsDigOUT1\: J205.6, U601.6 (Z)
/Steering interface/Clock/HsDigOUT1_A55: J201.55, U601.3 (DI)
/Steering interface/Data/HsDigIN4: J205.7, R601.1
/Steering interface/Data/HsDigIN4\: J205.8, R602.1
/Steering interface/Data/HsDigIN4_A53: J201.53, R606.2
/Steering interface/Hall Sensor 1: J201.33, J203.1
/Steering interface/Hall Sensor 2: J201.35, J203.2
/Steering interface/Hall Sensor 3: J201.37, J203.3
/Steering interface/LX: L201.1, U201.8 (LX)
/Steering interface/M1/+M: J201.1, J201.2, J201.3, J201.4, J201.5, J201.6, J202.1
/Steering interface/M2/-M: J201.7, J201.8, J201.9, J201.10, J201.11, J201.12, J202.2
/Steering interface/M3: J201.13, J201.14, J201.15, J201.16, J201.17, J201.18, J202.3
/Steering interface/MAX_VCC: C203.1, U201.3 (VCC)
/Steering interface/MODE: JP201.2 (B), U201.5 (MODE)
/Steering interface/RS422 Transceiver/ISL_A: C601.1, R601.2, R605.1, U601.8 (A)
/Steering interface/RS422 Transceiver/ISL_B: C602.1, R602.2, R603.1, R604.2, U601.7 (B)
/Steering interface/RS422 Transceiver/ISL_RO: R606.1, U601.2 (RO)
/Steering interface/USB_D+: D203.2 (I/O1), J201.61, J206.3 (D+)
/Steering interface/USB_D-: D203.3 (I/O2), J201.59, J206.2 (D-)
/Steering interface/VCC_FUSED: C201.1, D201.1 (K), D202.1 (K), F201.2, J201.19, J201.20, J201.21, J201.22, J201.23, J201.24, J201.26
GND: C201.2, C202.1, C203.2, C204.2, C301.2, C302.2, C303.2, C501.2, C502.2, C503.2, C504.2, C601.2, C602.2, C603.2, D201.2 (A), D202.2 (A), D203.1 (GND), D301.2 (A), D302.2 (A), H201.1, H202.1, H301.1, H302.1, H303.1, H304.1, J201.25, J201.27, J201.28, J201.29, J201.30, J201.31, J201.32, J201.57, J201.58, J201.63, J201.64, J201.75, J201.76, J202.4, J203.4, J203.6, J204.3, J205.9, J206.5 (GND), J206.6 (Shield), J301.16, J301.18, J301.20, J301.37, J301.38, J302.18, J302.19, J302.20, J302.21, J302.22, J303.4, J304.4, J304.6, J305.3, J306.9, J401.1, J402.1, J403.3, J403.4, J404.3, J404.4, JP201.1 (A), R501.2, R502.2, R503.2, R504.2, R603.2, R605.2, SW201.11, SW201.12, SW201.13, SW201.14, SW201.15, SW201.16, SW301.11, SW301.12, SW301.13, SW301.14, SW301.15, SW301.16, U201.7 (GND), U601.4 (GND)
unnamed: C501.1, H501.1, R501.1
unnamed: C502.1, H502.1, R502.1
unnamed: C503.1, H503.1, R503.1
unnamed: C504.1, H504.1, R504.1
unnamed: R201.2, SW201.7
unnamed: R301.1, SW301.10
VBUS: D203.4 (VCC), J201.60, J206.1 (VBUS)
VCC: C202.2, D302.1 (K), F201.1, F301.1, J302.17, J401.2, J402.2, U201.1 (VIN), U201.2 (EN/UVLO)
VDD: C204.1, L201.2, SW202.1 (A), U201.4 (FB/Vout)
Vaux: C603.1, J205.10, R604.1, SW202.2 (B), U601.1 (VCC)
Vaux2: J301.15, J301.17, J301.19, J306.10
Vsensor: J201.39, J203.5, J204.2, SW202.3 (C)
Vsensor2: J302.26, J304.5, J305.2
