EPFLXplore/ERC_AV_HW/(commit log)

2021-11-14 Added Kicad libraries currently used
    [HLE-106-02-F-DV-A.step, HLE-106-02-F-DV-A.stp]
2021-11-14 Added current node_pcb Kicad design
    [USART_interface.sch, iso_3v3_supply.sch, mcu_core.sch, node_pcb.kicad_pcb, node_pcb.sch]
2021-11-14 Kicad screwed up and saved a blank schematic
    [node_pcb.sch]
2021-11-14 Resolved stock issues for 3v3 supply components
    [iso_3v3_supply.sch]
2021-11-17 Cleaned up Kicad footprint/symbol libraries
    created IS25LP256E-JLLE footprint
    [HLE-102-02-F-DV.step]
2021-11-17 Added Yassine's CAN interface schematic
    Annotated all components
    Added an isolated SPI interface to connect to Jetson/PSU
    Updated flash memory's symbol to a custom one
    Added ADC inputs as appropriate and broke out DAC/extra GPIOs
    Found a cheaper digital isolator series in stock so substituted it in
    [CAN_interface.sch, USART_interface.sch, iso_3v3_supply.sch, isolated_SPI.sch, mcu_core.sch, node_pcb.sch]
2021-11-19 Added Footprints of various components. Changed TVS diodes into bigger one. (Switches are still missing)
2021-11-19 added footprints for coilformer and RJ45 ports
    [TDK_-_B65808E1508T001.step]
2021-11-19 Added test pads+LEDs to generic node and assigned footprints
    Changed from 4 independent RJ45s to 1 ganged 4 port for USART
    [CAN_interface.sch, RJ45_consolidator.sch, USART_interface.sch, iso_3v3_supply.sch, isolated_SPI.sch, mcu_core.sch, node_pcb.sch]
2021-11-20 corrected HLE-106 footprint
    [HLE-106-02-F-DV-BE-TR.step, HLE-106-02-F-DV-BE-TR.stp]
2021-11-20 Corrected clocks design, added load caps
    [mcu_core.sch]
2021-11-20 minor updates to symbol/footprint tables
    assigned footprints for test pads and HLE-102/106 connectors
    [USART_interface.sch, node_pcb.sch]
2021-11-20 Updated schematics metadata
    [CAN_interface.sch, RJ45_consolidator.sch, USART_interface.sch, iso_3v3_supply.sch, isolated_SPI.sch, node_pcb.sch]
2021-11-20 Replaced values and names of components. Finished assigning all footprints.
    [CAN_interface.sch, USART_interface.sch, iso_3v3_supply.sch, isolated_SPI.sch, mcu_core.sch, node_pcb.sch]
2021-11-20 Started routing crystals and STM32
    [node_pcb.kicad_pcb]
2021-11-21 Routed most of node PCB
    [CAN_interface.sch, USART_interface.sch, iso_3v3_supply.sch, isolated_SPI.sch, mcu_core.sch, node_pcb.kicad_pcb, node_pcb.sch]
2021-11-21 Added DIP switch for USARTs, routed out most of node PCB.
    [RJ45_consolidator.sch, node_pcb.kicad_pcb, node_pcb.sch]
2021-11-23 Routed power supply and some HLE-102s
    [CAN_interface.sch, HLE-102-02-F-DV-BE.step, HLE-102-02-F-DV-BE.stp, USART_interface.sch, node_pcb.kicad_pcb, node_pcb.sch]
2021-11-24 Managed to route pretty much everything necessary
    just missing a few HLE-102s
    [mcu_core.sch, node_pcb.kicad_pcb]
2021-11-25 Reupdated footprints and components
    [CAN_interface.sch, USART_interface.sch]
2021-11-28 Switched HLE connectors for CLPs
    Separated power supply schematic from generic node's
    Added pushbutton footprint
    [CAN_interface.sch, CLP-102-02-L-D-BE.stp, CLP-106-02-F-D-BE-K.stp, HLE-102-02-F-DV-BE.step, HLE-102-02-F-DV-BE.stp, HLE-102-02-F-DV.step, HLE-106-02-F-DV-A.step, HLE-106-02-F-DV-A.stp]
2021-11-30 Made new revision of node PCB with separate power supply board
    changed HLE connectors to CLPs
    fanout planned is in docx file
    current board comes in much smaller
    added more components necessary for CAN
    [CAN_interface.sch, RJ45_consolidator.sch, USART_interface.sch, isolated_SPI.sch, mcu_core.sch, node_pcb.kicad_pcb, node_pcb.sch]
2021-12-04 Some order pages were missing
    The clocks' load capacitors were 0603 (oops), fixed to 0805
    The STM32's LEDs had excessive resistors
    Fixed CLP-102s' availability
    [USART_interface.sch, isolated_SPI.sch, mcu_core.sch, node_pcb.kicad_pcb, node_pcb.sch]
2021-12-04 Routed 3v3 power supply PCB
    added necessary connectors: JST 6 pin SM06B-SURS to consolidate BOM
    [power_supply.kicad_pcb, power_supply.sch]
2021-12-05 Added passives' datasheets where necessary
    Consolidated a few BOM items
    [power_supply.kicad_pcb, power_supply.sch]
2021-12-06 Traced fuses on PCB
    [mcu_core.sch, node_pcb.kicad_pcb]
2021-12-07 Added more screw holes to power supply/MCU PCBs
    Swapped CAN EMI filter and rerouted
    [CAN_interface.sch, DLP31SN121ML2L.step, USART_interface.sch, node_pcb.kicad_pcb, node_pcb.sch, power_supply.kicad_pcb, power_supply.sch]
2021-12-07 Updated datasheets of some remaining capacitors
    Fixed up silkscreen of MCU node_pcb
    Added version info to PCB and schematics
    [CAN_interface.sch, RJ45_consolidator.sch, USART_interface.sch, isolated_SPI.sch, mcu_core.sch, node_pcb.kicad_pcb, node_pcb.sch, power_supply.sch]
2021-12-08 Added node PCB block diagram
2021-12-08 Forgot Cref thermal spokes for power supply
    Fixed up power supply silkscreen
    Added name to node PCB silkscreen
    [CAN_interface.sch, node_pcb.kicad_pcb, power_supply.kicad_pcb, power_supply.sch]
2021-12-09 Finalised power supply + node PCB RC1
    Replaced ADUM141D with ADUM7643: 141 out of stock
    Took advantage of 6 channel isolator to route GPIO_AUX_2/3 as isolated outputs
    Added fuses to power supply and main PCB
    Fixed up minor silkscreen issues again
    Added STM32Cube project files for pinout
    [CAN_interface.sch, isolated_SPI.sch, node_pcb.kicad_pcb, node_pcb.sch, power_supply.kicad_pcb, power_supply.sch]
2021-12-10 Added breakout module and adapter boards designs
    [2X2_1.27MM_TO_JST_GH_I2C.kicad_pcb, 2X2_1.27MM_TO_JST_GH_I2C.sch, 2X6_1.27MM_TO_JST_GH_I2C.kicad_pcb, 2X6_1.27MM_TO_JST_GH_I2C.sch, 2X6_1.27MM_TO_JST_PH_I2C.kicad_pcb, 2X6_1.27MM_TO_JST_PH_I2C.sch, BNO055_ADAPTER_BOARD.kicad_pcb, BNO055_ADAPTER_BOARD.sch]
2021-12-16 Added JST-GH adapter for I2C with inverted pinout (for bottom center connector)
    [2X6_1.27MM_TO_JST_GH_I2C_INVERTED.kicad_pcb, 2X6_1.27MM_TO_JST_GH_I2C_INVERTED.sch]
2021-12-16 changed page settings
    [2X6_1.27MM_TO_JST_GH_I2C_INVERTED.sch]
2021-12-16 Trimmed PCB
    [2X6_1.27MM_TO_JST_PH_I2C.kicad_pcb]
2021-12-16 Added left and right variants to ADC JST connectors
    [2X2_1.27MM_TO_JST_GH.kicad_pcb, 2X2_1.27MM_TO_JST_GH.sch, 2X2_1.27MM_TO_JST_GH_LEFT.kicad_pcb, 2X2_1.27MM_TO_JST_GH_LEFT.sch, 2X2_1.27MM_TO_JST_GH_RIGHT.kicad_pcb, 2X2_1.27MM_TO_JST_GH_RIGHT.sch]
2021-12-16 Trimmed BNO055 adapter board and changed location on MCU node
    [BNO055_ADAPTER_BOARD.kicad_pcb]
2021-12-17 Replaced optocouplers and inverter with TLP2710
    [PWM_ISO.kicad_pcb, PWM_ISO.sch]
2021-12-18 Replaced optocouplers with TLP2710
    [LED_STRIP.kicad_pcb, LED_STRIP.sch]
2021-12-18 Added optional pullup resistors to I2C JST-GH adapter boards
    [2X6_1.27MM_TO_JST_GH_I2C.kicad_pcb, 2X6_1.27MM_TO_JST_GH_I2C.sch, 2X6_1.27MM_TO_JST_GH_I2C_INVERTED.kicad_pcb, 2X6_1.27MM_TO_JST_GH_I2C_INVERTED.sch]
2021-12-18 Deleted obsolete breakout module (NAV LED)
    [NAV_LED.kicad_pcb, NAV_LED.sch]
2022-02-23 Added panelized version containing left/right JST-GH adapter boards
    [2X2_1.27MM_TO_JST_GH_LEFT_RIGHT.kicad_pcb]
2022-02-25 added bom
    [2X2_1.27MM_TO_JST_GH.csv, 2X2_1.27MM_TO_JST_GH_LEFT.csv, 2X2_1.27MM_TO_JST_GH_RIGHT.csv, 2X6_1.27MM_TO_JST_GH_I2C.csv, 2X6_1.27MM_TO_JST_GH_I2C_INVERTED.csv, 2X6_1.27MM_TO_JST_PH_I2C.csv, CAN_interface.sch, DLP31SN121ML2L.step]
2022-02-28 updated bom
    [2X2_1.27MM_TO_JST_GH.csv, 2X2_1.27MM_TO_JST_GH_LEFT.csv, 2X2_1.27MM_TO_JST_GH_RIGHT.csv, 2X6_1.27MM_TO_JST_GH_I2C.csv, 2X6_1.27MM_TO_JST_GH_I2C_INVERTED.csv, 2X6_1.27MM_TO_JST_PH_I2C.csv, LED_STRIP.csv]
2022-04-19 Added voltmeter breakout board (ADS1113)
    [ADS1113.csv, ADS1113.kicad_pcb, ADS1113.kicad_sch, TB001-500-02BE.step]
2022-04-19 Tidy up schematic
    [ADS1113.kicad_sch]
2022-04-19 moved via
    [ADS1113.kicad_pcb]
2022-04-19 fixed comments
    [ADS1113.csv, ADS1113.kicad_sch]
2022-04-19 fixed silkscreen
    [ADS1113.kicad_pcb]
2022-04-30 Added led switch pcb
    [LED_SWITCH.csv, LED_SWITCH.kicad_pcb, LED_SWITCH.kicad_sch, LED_SWITCH.sch, TB001-500-02BE.step, TB003V-500-P02BE.step]
2022-05-01 Updated isolated PWM and isolated LED with barrel jack, fixed 2x2 to JST adapter board
    [2X2_1.27MM_TO_JST_GH.kicad_pcb, 2X2_1.27MM_TO_JST_GH.kicad_sch, ADS1115.csv, ADS1115.kicad_pcb, ADS1115.kicad_sch, ISOLATED_PWM.csv, ISOLATED_PWM.kicad_pcb, ISOLATED_PWM.kicad_sch]
2022-05-02 Added bno and debug board
    [BNO055_ADAPTER_BOARD.kicad_pcb, BNO055_ADAPTER_BOARD.sch, CLP6_BREAKOUT.kicad_pcb, CLP6_BREAKOUT.kicad_sch]
2022-05-02 deprecated led strip
    [LED_STRIP.kicad_pcb]
2022-05-06 Replaced barrel jacks with terminal blocks
    [ISOLATED_PWM.csv, ISOLATED_PWM.kicad_pcb, ISOLATED_PWM.kicad_sch, LED_SWITCH.csv, LED_SWITCH.kicad_pcb, LED_SWITCH.kicad_sch]
2022-05-07 Removed obsoltete module
    [LED_STRIP.kicad_pcb]
2022-05-07 Refilled zones
    [LED_SWITCH.kicad_pcb]
2022-05-07 DRC check
    [ISOLATED_PWM.kicad_pcb]
2022-05-08 Changed connectors from jst to molex
    [ADS1113.kicad_pcb, ADS1113.kicad_sch, BNO055_ADAPTER_BOARD.kicad_pcb, ISOLATED_PWM.kicad_pcb, ISOLATED_PWM.kicad_sch, LED_SWITCH.kicad_pcb, LED_SWITCH.kicad_sch]
2022-05-09 Added Jetson interface board
    [1725672.step, 1725685.step, ADS1115.csv, ADS1115.kicad_pcb, ADS1115.kicad_sch, JETSON_INTERFACE_BOARD.csv, JETSON_INTERFACE_BOARD.kicad_pcb, JETSON_INTERFACE_BOARD.kicad_sch]
2022-05-09 Updated references
    [JETSON_INTERFACE_BOARD.kicad_pcb, JETSON_INTERFACE_BOARD.kicad_sch]
2022-07-21 Added offset to voltage divider for reverse polarity
    [ADS1113.csv, ADS1113.kicad_pcb, ADS1113.kicad_sch, JETSON_INTERFACE_BOARD.csv]
2022-07-21 Corrected comment
    [ADS1113.kicad_sch]
2022-09-17 Cleaned up master
    [CAN_interface.sch, CLP-102-02-L-D-BE.stp, CLP-106-02-F-D-BE-K.stp, RJ45_consolidator.sch, SAMTEC-CLP-102-02-X-D-BE.step, SAMTEC-CLP-106-02-X-D-BE.step, TDK_-_B65808E1508T001.step, USART_interface.sch]
2022-09-19 Added schematic for MCU, node to hats connection and node to node connectors
    [3220-10-0200.step, ESP32.kicad_sch, FLASH.kicad_sch, HAT_CONNECTOR.kicad_sch, HAT_DELOCALIZED.kicad_sch, MCU.kicad_sch, MECHANICAL_TP.kicad_sch, NODE_CONNECTORS.kicad_sch]
2022-09-19 Added USB-UART bridge
    [FLASH.kicad_sch, USB_UART.kicad_sch, orion_pcb.kicad_sch]
2022-09-19 Changed usb uart activity led power net
    [FLASH.kicad_sch, USB_UART.kicad_sch, orion_pcb.kicad_sch]
2022-09-20 Added dual channel switching regulator. TODO: add reverse polarity protection on voltage input
    [FLASH.kicad_sch, HAT_CONNECTOR.kicad_sch, HAT_DELOCALIZED.kicad_sch, MCU.kicad_sch, NODE_CONNECTORS.kicad_sch, NODE_TO_HATS.kicad_sch, POWER.kicad_sch, USB_UART.kicad_sch]
2022-09-21 Added reverse input protection
    [POWER.kicad_sch, orion_pcb.kicad_sch]
2022-09-22 Power and ESP32 moved to daugtherboards
    [3220-10-0200.step, ESP32.kicad_sch, EXT_CONNECTORS.kicad_sch, FLASH.kicad_sch, HAT_CONNECTOR.kicad_sch, HAT_DELOCALIZED.kicad_sch, MCU.kicad_sch, MECHANICAL_TP.kicad_sch]
2022-09-22 Edited page settings. moved blocks around
    [EXT_CONNECTORS.kicad_sch, MCU.kicad_sch, orion_power.kicad_sch]
2022-09-22 Added titles and plots
    [EXT_CONNECTORS.kicad_sch, FLASH.kicad_sch, HAT_CONNECTOR.kicad_sch, HAT_DELOCALIZED.kicad_sch, MECHANICAL_TP.kicad_sch, NODE_TO_HATS.kicad_sch, USB_UART.kicad_sch, orion_pcb.kicad_sch]
2022-09-28 Partial layout with max3232. To change to max3225
    [302-S101.STEP, CL-SB-12C-01.stp, FLASH.kicad_sch, HAT_CONNECTOR.kicad_sch, HAT_DELOCALIZED.kicad_sch, MCU.kicad_sch, MECHANICAL_TP.kicad_sch, NODE_CONNECTORS.kicad_sch]
2022-09-29 Routed most of the digital signals
    [MCU.kicad_sch, NODE_CONNECTORS.kicad_sch, orion_pcb.kicad_pcb, orion_pcb.kicad_sch]
2022-10-02 updated paths
    [302-S101.STEP, 3220-10-0200.step, CL-SB-12C-01.stp, HAT_CONNECTOR.kicad_sch, MCU.kicad_sch, MECHANICAL_TP.kicad_sch, NODE_CONNECTORS.kicad_sch, POWER_CONNECTORS.kicad_sch]
2022-10-02 Added orion lib submodule
    [orion_pcb.kicad_pcb]
2022-10-02 Updated pin type
    [HAT_CONNECTOR.kicad_sch, MCU.kicad_sch, MECHANICAL_TP.kicad_sch, USB_UART.kicad_sch, orion_pcb.kicad_pcb, orion_pcb.kicad_sch]
2022-10-02 Updated power pin type
2022-10-02 Finished routing. Need to add logos
    [MCU.kicad_sch, MECHANICAL_TP.kicad_sch, orion_pcb.kicad_pcb, orion_pcb.kicad_sch]
2022-10-02 Added logos
    [MCU.kicad_sch, MECHANICAL_TP.kicad_sch, MECHANICAL_TP_LOGO.kicad_sch, POWER_CONNECTORS.kicad_sch, orion_pcb.kicad_pcb, orion_pcb.kicad_sch]
2022-10-02 Added orion logo
    [orion_pcb.kicad_pcb]
2022-10-02 Changed page settings, added dimensions
    [MECHANICAL_TP_LOGO.kicad_sch, orion_pcb.kicad_pcb, orion_pcb.kicad_sch]
2022-10-02 Added plots, gerbers and removed unused schematic
    [HAT_DELOCALIZED.kicad_sch, orion_pcb.kicad_pcb, orion_pcb.kicad_sch]
2022-10-02 ädded BOM
    [NODE_CONNECTORS.kicad_sch, USB_UART.kicad_sch, orion_pcb.csv]
2022-10-02 Added test pads for usart1
    [USB_UART.kicad_sch, orion_pcb.kicad_pcb, orion_pcb.kicad_sch]
2022-10-03 Updated uart
    [MCU.kicad_sch, USB_UART.kicad_sch]
2022-10-03 Removed all files on master
    [3220-10-0200.step, ESP32.kicad_sch, FLASH.kicad_sch, HAT_CONNECTOR.kicad_sch, HAT_DELOCALIZED.kicad_sch, MCU.kicad_sch, MECHANICAL_TP.kicad_sch, NODE_CONNECTORS.kicad_sch]
2022-10-03 Replaces polygon pours with keepout zones for DRC check
    [orion_pcb.kicad_pcb]
2022-10-04 Replaced timer 3 with timer 8 (timer 8 is an advanced control timer, dead time might be useful for h-bridge)
    [MCU.kicad_sch, NODE_TO_HATS.kicad_sch, orion_pcb.kicad_sch]
2022-10-04 Replaced timer 3 with timer 8
    [HAT_CONNECTOR.kicad_sch, MCU.kicad_sch, MECHANICAL_TP_LOGO.kicad_sch, NODE_CONNECTORS.kicad_sch, POWER_CONNECTORS.kicad_sch, USB_UART.kicad_sch, orion_pcb.kicad_pcb, orion_pcb.kicad_sch]
2022-10-04 Broke out I2C4 instead of GPIOs on top left hat to support concurrent I2C sensors (easier for sensor fusion)
    [HAT_CONNECTOR.kicad_sch, MCU.kicad_sch, MECHANICAL_TP_LOGO.kicad_sch, NODE_CONNECTORS.kicad_sch, NODE_TO_HATS.kicad_sch, POWER_CONNECTORS.kicad_sch, USB_UART.kicad_sch, orion_pcb.csv]
2022-10-04 Changed logo font
    [orion_pcb.kicad_pcb]
2022-10-04 Fixed typo in value, updated bom
    [HAT_CONNECTOR.kicad_sch, MCU.kicad_sch, MECHANICAL_TP_LOGO.kicad_sch, NODE_CONNECTORS.kicad_sch, POWER_CONNECTORS.kicad_sch, USB_UART.kicad_sch, orion_pcb.csv, orion_pcb.kicad_sch]
2022-10-04 Added spacers for hats in bom
    [MCU.kicad_sch, MECHANICAL_TP_LOGO.kicad_sch, orion_pcb.csv, orion_pcb.kicad_pcb, orion_pcb.kicad_sch]
2022-10-04 Added 3d model for clearance purposes. Warning: female header height is not accurate (will be between 8-9 mm)
2022-10-05 Added symbol and footprint tables
    [HAT_CONNECTOR.kicad_sch, MECHANICAL_TP_LOGO.kicad_sch, NODE_CONNECTORS.kicad_sch, POWER_CONNECTORS.kicad_sch, USB_UART.kicad_sch, orion_pcb.kicad_pcb, orion_pcb.kicad_sch]
2022-10-06 Added teardrops
    [orion_pcb.kicad_pcb]
2022-10-07 Added schematics for Maxon 24/5 CAN interface board
    [Encoder_control.kicad_sch, can_controller_board.kicad_pcb, can_controller_board.kicad_sch, untitled.kicad_sch]
2022-10-07 Changed schematics titles and comments
    [Encoder_control.kicad_sch, can_controller_board.kicad_sch]
2022-10-07 Changed denominations of some resistors
    [Encoder_control.kicad_sch]
2022-10-07 Revert "Changed denominations of some resistors"
    This reverts commit 4a6d0156b4e271dc6a5a0d20dbf2fef468595968.
    [Encoder_control.kicad_sch]
2022-10-07 Revert "Revert "Changed denominations of some resistors""
    This reverts commit 156574cbb61af9626697bf8c4e668c9ed4415650.
    [Encoder_control.kicad_sch]
2022-10-07 Added ground symbol after deleting it
    [can_controller_board.kicad_sch]
2022-10-08 Revert "Removed all files on master"
    This reverts commit ff7e8f853d3abdc9aa0abdacf783b4a9b34c6294.
    [3220-10-0200.step, ESP32.kicad_sch, FLASH.kicad_sch, HAT_CONNECTOR.kicad_sch, HAT_DELOCALIZED.kicad_sch, MCU.kicad_sch, MECHANICAL_TP.kicad_sch, NODE_CONNECTORS.kicad_sch]
2022-10-08 Cleaned file
    [Encoder_control.kicad_sch, can_controller_board.kicad_pcb, can_controller_board.kicad_sch, untitled.kicad_sch]
2022-10-08 Cleaned master branch
    [3220-10-0200.step, ESP32.kicad_sch, FLASH.kicad_sch, HAT_CONNECTOR.kicad_sch, HAT_DELOCALIZED.kicad_sch, MCU.kicad_sch, MECHANICAL_TP.kicad_sch, NODE_CONNECTORS.kicad_sch]
2022-10-08 Updated files
    [MCU.kicad_sch, orion_pcb.kicad_sch]
2022-10-08 Added pullup resistor on qspi N_CS
    [FLASH.kicad_sch, orion_pcb.csv, orion_pcb.kicad_pcb, orion_pcb.kicad_sch, orion_power.kicad_sch]
2022-10-08 Moved reference designator
    [orion_pcb.kicad_pcb]
2022-10-11 Added all component references and footprints, added design rules/stackup
    [orion_power.kicad_pcb, orion_power.kicad_sch]
2022-10-12 Partially routed power
    [orion_power.kicad_pcb, orion_power.kicad_sch]
2022-10-14 Finished routing power supply board
    [orion_power.kicad_pcb, orion_power.kicad_sch]
2022-10-14 Rounded tracks, added teardrops
    [orion_power.kicad_pcb]
2022-10-14 Centered PCB
    [orion_power.kicad_pcb]
2022-10-14 Added BOM, pdf and changed page settings
    [orion_power.csv, orion_power.kicad_sch]
2022-10-14 Finished routing orion power supply
    [orion_pcb.kicad_pcb, orion_power.kicad_pcb, orion_power.kicad_sch]
2022-10-16 Updated values/bom
    [FLASH.kicad_sch, MCU.kicad_sch, MECHANICAL_TP_LOGO.kicad_sch, POWER_CONNECTORS.kicad_sch, USB_UART.kicad_sch, orion_pcb.kicad_pcb, orion_pcb.kicad_sch, orion_power.kicad_pcb]
2022-10-16 Added debug interface and fixed bom
    [HAT_CONNECTOR.kicad_sch, SWD_INTERFACE.kicad_sch, orion_debug.csv, orion_debug.kicad_pcb, orion_debug.kicad_sch, orion_pcb.csv, orion_pcb.kicad_pcb, orion_pcb.kicad_sch]
2022-10-17 Added overall bom (for 5x orion, 5x power and 1x debug)
    [USB_UART.kicad_sch, orion_bom.csv, orion_debug.csv]
2022-10-19 Adjusted zone shapes
    [orion_power.kicad_pcb]
2022-10-19 Adjusted input power fill shape
    [orion_power.kicad_pcb]
2022-10-19 Slightly adjusted fill zones
    [orion_power.kicad_pcb]
2022-11-01 Added orion rev2 (no teardrops/rounded traces)
    [HAT_CONNECTOR.kicad_sch, MCU.kicad_sch, MECHANICAL_TP_LOGO.kicad_sch, NODE_CONNECTORS.kicad_sch, NODE_TO_HATS.kicad_sch, POWER_CONNECTORS.kicad_sch, USB_UART.kicad_sch, orion_pcb.csv]
2022-11-01 Added pdf and updated metadata
    [HAT_CONNECTOR.kicad_sch, MCU.kicad_sch, NODE_CONNECTORS.kicad_sch, orion_pcb.kicad_pcb, orion_pcb.kicad_sch]
2022-11-02 Added support for CAN and RS485 (hats should be designed for top right and bottom left)
    [MCU.kicad_sch, NODE_CONNECTORS.kicad_sch, NODE_TO_HATS.kicad_sch, orion_pcb.kicad_pcb, orion_pcb.kicad_sch]
2022-11-02 Changed order of USART2 RX, TX, RTS pins on hat for easier routing of RS485 transceiver
    [NODE_TO_HATS.kicad_sch, orion_pcb.kicad_pcb]
2022-11-02 Adjusted trace spacing
    [orion_pcb.kicad_pcb]
2022-11-05 Changed pin order for second I2C to be delocalizable
    [MCU.kicad_sch, NODE_CONNECTORS.kicad_sch, NODE_TO_HATS.kicad_sch, orion_pcb.kicad_pcb, orion_pcb.kicad_sch]
2022-11-06 Added testing jig hat
    [3352T-1-201LF.STEP, orion_pcb.kicad_pcb, testing_jig.kicad_pcb, testing_jig.kicad_sch]
2022-11-07 Updated testing jig, added sym and fp table back in power module
    [3352T-1-201LF.STEP, orion_pcb.kicad_pcb, testing_jig.kicad_pcb, testing_jig.kicad_sch]
2022-11-14 minor updates
    [can_transceiver.kicad_pcb, can_transceiver.kicad_sch, orion_pcb.kicad_pcb]
2022-11-19 Updated BOMs and added ST-LINK adapter
    [FLASH.kicad_sch, FTSH-105-01-L-DV-K-TR.stp, ST-LINK_Adapters.kicad_pcb, ST-LINK_Adapters.kicad_sch, orion_pcb.csv, orion_pcb.kicad_pcb, orion_pcb.kicad_sch, orion_power.csv]
2022-12-02 Added voltmeter board
    [voltmeter.csv, voltmeter.kicad_pcb, voltmeter.kicad_sch]
2022-12-02 Updated steps
    [orion_pcb.kicad_pcb, orion_power.kicad_pcb, voltmeter.kicad_pcb]
2022-12-06 moved dimensions to user comment layer
    [orion_power.kicad_pcb]
2022-12-22 Added voltmeter v2
    [voltmeter.csv, voltmeter.kicad_pcb, voltmeter.kicad_sch]
2022-12-22 Matched length of USB differential pair
    [orion_pcb.kicad_pcb]
2023-01-13 Changed ESD chips, still need to route
    [HAT_CONNECTOR.kicad_sch, MCU.kicad_sch, orion_pcb.kicad_pcb, orion_pcb.kicad_sch]
2023-03-02 Minor changes
    [HAT_CONNECTOR.kicad_sch, orion_pcb.kicad_pcb, orion_pcb.kicad_sch]
2023-03-24 Added v3 of the board
    [orion_pcb.kicad_pcb]
2023-04-01 Ported to kicad 7
    [FLASH.kicad_sch, HAT_CONNECTOR.kicad_sch, MCU.kicad_sch, MECHANICAL_TP_LOGO.kicad_sch, NODE_CONNECTORS.kicad_sch, NODE_TO_HATS.kicad_sch, POWER_CONNECTORS.kicad_sch, USB_UART.kicad_sch]
2023-04-01 Finished routing
    [orion_pcb.kicad_pcb]
2023-04-01 Finished v3
    [FLASH.kicad_sch, HAT_CONNECTOR.kicad_sch, MCU.kicad_sch, MECHANICAL_TP_LOGO.kicad_sch, NODE_CONNECTORS.kicad_sch, NODE_TO_HATS.kicad_sch, POWER_CONNECTORS.kicad_sch, USB_UART.kicad_sch]
2023-04-01 Removed obsolete files
    [DLP31SN121ML2L.step]
2023-04-17 Finished v3 without headers for jst GH
    [HAT_CONNECTOR.kicad_sch, NODE_CONNECTORS.kicad_sch, NODE_TO_HATS.kicad_sch, orion_pcb.kicad_sch]
2023-04-24 Updated schematic
    [FLASH.kicad_sch, HAT_CONNECTOR.kicad_sch, MCU.kicad_sch, MECHANICAL_TP_LOGO.kicad_sch, NODE_CONNECTORS.kicad_sch, POWER_CONNECTORS.kicad_sch, USB_UART.kicad_sch, orion_pcb.kicad_sch]
2023-06-26 Added CanOrion
    [CAN_BUS_CONNECTORS.kicad_sch, FLASH.kicad_sch, HAT_CONNECTOR.kicad_sch, MCU.kicad_sch, MECHANICAL_TP_LOGO.kicad_sch, NODE_CONNECTORS.kicad_sch, NODE_TO_HATS.kicad_sch, POWER_CONNECTORS.kicad_sch]
2023-06-26 Changed layout of canorion
    [CAN_BUS_CONNECTORS.kicad_sch, MCU.kicad_sch, POWER_CONNECTORS.kicad_sch, orion_pcb.kicad_pcb, orion_pcb.kicad_sch]
2023-07-01 routed v4, maybe needs another esd protection
    [FLASH.kicad_sch, HAT_CONNECTOR.kicad_sch, MCU.kicad_sch, MECHANICAL_TP_LOGO.kicad_sch, NODE_CONNECTORS.kicad_sch, NODE_TO_HATS.kicad_sch, POWER_CONNECTORS.kicad_sch, TPS25947xx_Design_Calculator.xlsm]
2023-07-02 Finished routing orion v4 with new ESD
    [HAT_CONNECTOR.kicad_sch, MECHANICAL_TP_LOGO.kicad_sch, orion_pcb.kicad_sch]
2023-07-02 Changed fonts and corrected pinout error on common mode choke
    [NODE_CONNECTORS.kicad_sch, orion_pcb.kicad_sch]
2023-07-02 Updated lib and added teardrops
    [NODE_CONNECTORS.kicad_sch, POWER_CONNECTORS.kicad_sch]
2023-07-02 Rectified BOM, added gerbers
    [CAN_BUS_CONNECTORS.kicad_sch, FLASH.kicad_sch, HAT_CONNECTOR.kicad_sch, MCU.kicad_sch, MECHANICAL_TP_LOGO.kicad_sch, NODE_CONNECTORS.kicad_sch, NODE_TO_HATS.kicad_sch, POWER_CONNECTORS.kicad_sch]
2023-07-02 Updated schematics, bom and addes template sheet
    [FLASH.kicad_sch, HAT_CONNECTOR.kicad_sch, MCU.kicad_sch, MECHANICAL_TP_LOGO.kicad_sch, NODE_CONNECTORS.kicad_sch, NODE_TO_HATS.kicad_sch, POWER_CONNECTORS.kicad_sch, USB_UART.kicad_sch]
2023-07-02 Moved author to comment 4
    [FLASH.kicad_sch, POWER_CONNECTORS.kicad_sch, USB_UART.kicad_sch]
2023-07-02 fixed small connection error
    [NODE_CONNECTORS.kicad_sch]
2023-07-03 Better routing for LDO, added spacer 3d model and hat connector in BOM
    [HAT_CONNECTOR.kicad_sch, MCU.kicad_sch, MECHANICAL_TP_LOGO.kicad_sch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]
2023-07-03 Added .step file, minor routing changes
    [orion_pcb-B_Cu (Sig).gbl, orion_pcb-B_Mask.gbs, orion_pcb-B_Paste.gbp, orion_pcb-B_Silkscreen.gbo, orion_pcb-Edge_Cuts.gm1, orion_pcb-F_Cu (Sig).gtl, orion_pcb-F_Mask.gts, orion_pcb-F_Paste.gtp]
2023-07-03 Softer turn for CAN lines
    [orion_pcb-B_Cu (Sig).gbl, orion_pcb-B_Mask.gbs, orion_pcb-B_Paste.gbp, orion_pcb-B_Silkscreen.gbo, orion_pcb-Edge_Cuts.gm1, orion_pcb-F_Cu (Sig).gtl, orion_pcb-F_Mask.gts, orion_pcb-F_Paste.gtp]
2023-07-03 Replaced component in BOM (not in stock). Removed floating text in PCB
    [MCU.kicad_sch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]
2023-07-08 Added GPIOs for CAN silent mode and 3v3 power monitoring. Fixed CANH/CANL pinout
    [FLASH.kicad_sch, HAT_CONNECTOR.kicad_sch, MCU.kicad_sch, MECHANICAL_TP_LOGO.kicad_sch, NODE_CONNECTORS.kicad_sch, POWER_CONNECTORS.kicad_sch, USB_UART.kicad_sch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]
2023-07-09 Meissa v2 routed
    [TPS25947xx_Design_Calculator.xlsm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]
2023-07-10 Updated gerbers
    [orion_pcb-B_Cu (Sig).gbl, orion_pcb-B_Mask.gbs, orion_pcb-B_Paste.gbp, orion_pcb-B_Silkscreen.gbo, orion_pcb-Edge_Cuts.gm1, orion_pcb-F_Cu (Sig).gtl, orion_pcb-F_Mask.gts, orion_pcb-F_Paste.gtp]
2023-07-12 Almost finished routing voltmeter
    [voltmeter.kicad_pcb, voltmeter.kicad_sch]
2023-07-12 Finished routing voltmeter, still need to add bom
    [TPS25947xx_Design_Calculator.xlsm, voltmeter.kicad_pcb, voltmeter.kicad_sch]
2023-07-13 Wrong pinout for NMOS 3V3 selection...
    [POWER_CONNECTORS.kicad_sch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]
2023-07-13 Added voltmeter gerbers, BOM
    [POWER_CONNECTORS.kicad_sch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]
2023-07-14 Added spectrophotometer interface pcb
    [TPS25947xx_Design_Calculator.xlsm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]
2023-07-15 Added teardrops and reduced analog signals trace width
    [voltmeter-B_Cu.gbl, voltmeter-B_Mask.gbs, voltmeter-B_Paste.gbp, voltmeter-B_Silkscreen.gbo, voltmeter-Edge_Cuts.gm1, voltmeter-F_Cu.gtl, voltmeter-F_Mask.gts, voltmeter-F_Paste.gtp]
2023-07-15 Removed uncessary ffiles
    [TPS25947xx_Design_Calculator.xlsm]
2023-07-15 Added ADS1115 hat
    [ADS1115_POTENTIOMETER-B_Cu.gbl, ADS1115_POTENTIOMETER-B_Mask.gbs, ADS1115_POTENTIOMETER-B_Paste.gbp, ADS1115_POTENTIOMETER-B_Silkscreen.gbo, ADS1115_POTENTIOMETER-Edge_Cuts.gm1, ADS1115_POTENTIOMETER-F_Cu.gtl, ADS1115_POTENTIOMETER-F_Mask.gts, ADS1115_POTENTIOMETER-F_Paste.gtp]
2023-07-15 Added level shifter hat
    [servo_level_shifter-B_Cu.gbl, servo_level_shifter-B_Mask.gbs, servo_level_shifter-B_Paste.gbp, servo_level_shifter-B_Silkscreen.gbo, servo_level_shifter-Edge_Cuts.gm1, servo_level_shifter-F_Cu.gtl, servo_level_shifter-F_Mask.gts, servo_level_shifter-F_Paste.gtp]
2023-07-15 Added empty ads1234 project
    [ADS1234_mass_sensor.kicad_pcb, ADS1234_mass_sensor.kicad_sch, servo_level_shifter.kicad_pcb]
2023-07-16 Added mass sensor
    [ADS1234_mass_sensor-B_Cu.gbl, ADS1234_mass_sensor-B_Mask.gbs, ADS1234_mass_sensor-B_Paste.gbp, ADS1234_mass_sensor-B_Silkscreen.gbo, ADS1234_mass_sensor-Edge_Cuts.gm1, ADS1234_mass_sensor-F_Cu.gtl, ADS1234_mass_sensor-F_Mask.gts, ADS1234_mass_sensor-F_Paste.gtp]
2023-07-16 Added load cell connector interface
    [load_cell_connector_interface-B_Cu.gbl, load_cell_connector_interface-B_Mask.gbs, load_cell_connector_interface-B_Paste.gbp, load_cell_connector_interface-B_Silkscreen.gbo, load_cell_connector_interface-Edge_Cuts.gm1, load_cell_connector_interface-F_Cu.gtl, load_cell_connector_interface-F_Mask.gts, load_cell_connector_interface-F_Paste.gtp]
2023-07-16 Fixed wrong ref designator
    [POWER_CONNECTORS.kicad_sch, orion_pcb.kicad_sch]
2023-07-17 Added RS485 Hat
    [RS485_interface-B_Cu.gbl, RS485_interface-B_Mask.gbs, RS485_interface-B_Paste.gbp, RS485_interface-B_Silkscreen.gbo, RS485_interface-Edge_Cuts.gm1, RS485_interface-F_Cu.gtl, RS485_interface-F_Mask.gts, RS485_interface-F_Paste.gtp]
2023-07-17 A small service
    [RS485_interface.kicad_pcb]
2023-07-20 Added IMU hat
    [imu_9_axis-B_Cu.gbl, imu_9_axis-B_Mask.gbs, imu_9_axis-B_Paste.gbp, imu_9_axis-B_Silkscreen.gbo, imu_9_axis-Edge_Cuts.gm1, imu_9_axis-F_Cu.gtl, imu_9_axis-F_Mask.gts, imu_9_axis-F_Paste.gtp]
2023-07-27 Adjusted BOMs, verified sourcing of parts
    [MCU.kicad_sch, orion_bom.csv, orion_pcb.csv, orion_pcb.kicad_sch]
2023-07-27 Generated step for load cell interface
    [load_cell_connector_interface.step]
2023-08-07 Updated schematics
    [ADS1234_mass_sensor.kicad_sch, RS485_interface.kicad_sch, servo_level_shifter.kicad_sch, voltmeter.kicad_pcb, voltmeter.kicad_sch]
2023-08-09 Added jetson hat (temporary) to be modified
    [fdcan_transceiver.kicad_sch, jetson_hat.kicad_pcb, spi_fdcan_controller.kicad_sch, uart_transceiver.kicad_sch]
2023-08-13 updated voltmeter gerbers:
    [voltmeter-B_Cu.gbl, voltmeter-B_Mask.gbs, voltmeter-B_Paste.gbp, voltmeter-B_Silkscreen.gbo, voltmeter-Edge_Cuts.gm1, voltmeter-F_Cu.gtl, voltmeter-F_Mask.gts, voltmeter-F_Paste.gtp]
2023-08-13 added COTS rp2040 LED hat
    [neopixel_cots_hat-B_Cu.gbl, neopixel_cots_hat-B_Mask.gbs, neopixel_cots_hat-B_Paste.gbp, neopixel_cots_hat-B_Silkscreen.gbo, neopixel_cots_hat-Edge_Cuts.gm1, neopixel_cots_hat-F_Cu.gtl, neopixel_cots_hat-F_Mask.gts, neopixel_cots_hat-F_Paste.gtp]
2023-09-30 added controller interface
    [RS422_transceiver.kicad_sch, driving_interface.kicad_sch, logos.kicad_sch, mechanical.kicad_sch, nav_controller_interface_v2.csv, nav_controller_interface_v2.kicad_pcb, nav_controller_interface_v2.kicad_sch, power_can_connectors.kicad_sch]
2023-09-30 added untested led hat
    [Yassine_Leds.kicad_pcb, Yassine_Leds.kicad_sch]
2023-11-03 Moved files for cleaner git
    [RS422_transceiver.kicad_sch, driving_interface.kicad_sch, logos.kicad_sch, mechanical.kicad_sch, nav_controller_interface_v2.csv, nav_controller_interface_v2.kicad_pcb, nav_controller_interface_v2.kicad_sch, power_can_connectors.kicad_sch]
2023-11-03 Git extention
    [RS422_transceiver.kicad_sch, driving_interface.kicad_sch, logos.kicad_sch, mechanical.kicad_sch, nav_controller_interface_v2.csv, nav_controller_interface_v2.kicad_pcb, nav_controller_interface_v2.kicad_sch, power_can_connectors.kicad_sch]
2023-11-04 Mutiplexer to control
    [RS422_transceiver.kicad_sch, driving_interface.kicad_sch, logos.kicad_sch, mechanical.kicad_sch, nav_controller_interface_v2.csv, nav_controller_interface_v2.kicad_sch, nav_multiplexer.kicad_pcb, nav_multiplexer.kicad_sch]
2023-11-11 Eliot Abramo Neopixel hat design redone using ESP32-D4-Pico MCU
    [neopixel_cots_hat-B_Cu.gbl, neopixel_cots_hat-B_Mask.gbs, neopixel_cots_hat-B_Paste.gbp, neopixel_cots_hat-B_Silkscreen.gbo, neopixel_cots_hat-Edge_Cuts.gm1, neopixel_cots_hat-F_Cu.gtl, neopixel_cots_hat-F_Mask.gts, neopixel_cots_hat-F_Paste.gtp]
2023-11-11 Realized I made a labeling error on the D+ and D- lines. Corrected now.
    [neopixel_eliot_hat.kicad_sch]
2023-11-15 not much changed but I am going to test stuff and if I break everything I want to have a backup
    [neopixel_eliot_hat.kicad_sch]
2023-11-24 Nav board routing completed
    [RS422_interface.kicad_sch, RS422_transceiver.kicad_sch, driving_controller.kicad_sch, mechanical.kicad_sch, nav_controller_interface_v2.kicad_pcb, nav_lower_controller.kicad_pcb, nav_lower_controller.kicad_sch, nav_upper_controller.kicad_pcb]
2023-11-24 removed useless files
    [nav_multiplexer.kicad_pcb, nav_multiplexer.kicad_sch, nav_upper_controller.kicad_pcb, nav_upper_controller.kicad_sch]
2023-11-26 v2 of Neopixel hat
    [neopixel_eliot_hat.kicad_sch]
2023-11-26 fixed some wiring
    [neopixel_eliot_hat.kicad_sch]
2023-11-30 Lets hope third time is the charm :)
    [neopixel_eliot_hat.kicad_sch]
2023-12-07 version 4.0
    [neopixel_eliot_hat.kicad_sch]
2023-12-21 Nav board completed
    [RS422_interface.kicad_sch, nav_lower_controller.kicad_pcb, orion_pcb.kicad_sch, power_can_connector.kicad_sch, steering_controller.kicad_sch]
2023-12-21 Few fix
    [driving_controller.kicad_sch, nav_lower_controller.kicad_pcb, power_can_connector.kicad_sch, steering_controller.kicad_sch]
2024-02-04 Updated jetson_hat
    Replaced the "jetson_hat" folder by the one I had locally with the schematic and routing of the new design.
    [CANBUS_1.kicad_sch, CAN_BUS_SPI.kicad_sch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]
2024-02-06 Uploaded the new version
    Hat V3, completely rerouted from V2
    [CANBUS_1.kicad_sch, CAN_BUS_SPI.kicad_sch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]
2024-02-07 Draft 1 neopixel routing
    [neopixel_eliot_hat.kicad_sch]
2024-02-09 Routing Neopixel
    [neopixel_eliot_hat.kicad_pcb, neopixel_eliot_hat.kicad_sch]
2024-02-09 Added to silkscreen neopixel
2024-02-10 Last Jetson Hat update
    HatV4, just some minor tweaks
    [CANBUS_1.kicad_sch, CAN_BUS_SPI.kicad_sch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]
2024-02-10 Draft 2 - Neopixel routing
    [neopixel_eliot_hat.kicad_pcb, neopixel_eliot_hat.kicad_sch]
2024-02-11 Adding SCL address to ADS1115 potentiometer
    [ADS1115_POTENTIOMETER.kicad_pcb, ADS1115_POTENTIOMETER.kicad_sch]
2024-02-12 Draft 3 - Neopixel routing
    [neopixel_eliot_hat.kicad_pcb, neopixel_eliot_hat.kicad_sch]
2024-02-12 Draft 4 - Neopixel Routing
    [neopixel_eliot_hat.kicad_pcb, neopixel_eliot_hat.kicad_sch]
2024-02-12 Connector correctly aligned
    [CANBUS_1.kicad_sch, CAN_BUS_SPI.kicad_sch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]
2024-02-13 Draft 5 - Neopixel Routing
    [neopixel_eliot_hat.kicad_pcb]
2024-02-15 Draft 6 - Neopixel Routing
    [neopixel_eliot_hat.kicad_pcb, neopixel_eliot_hat.kicad_sch]
2024-02-15 Draft 7 - Neopixel Routing
    [neopixel_eliot_hat.kicad_pcb]
2024-02-15 Fixed PCB constrained for command
    [nav_lower_controller.kicad_pcb, nav_lower_controller.kicad_sch, steering_controller.kicad_sch]
2024-02-15 Edited via size for cost reducing + created manuf files
    [RS422_interface.kicad_sch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]
2024-02-22 Added component list
    [ADS1115_POTENTIOMETER.csv, nav_lower_controller.csv, neopixel_eliot_hat.csv]
2024-03-19 updated gerber files
    [neopixel_eliot_hat.kicad_pcb]
2024-03-19 fixing error oops
    [neopixel_cots_hat-B_Cu.gbl, neopixel_cots_hat-B_Mask.gbs, neopixel_cots_hat-B_Paste.gbp, neopixel_cots_hat-B_Silkscreen.gbo, neopixel_cots_hat-Edge_Cuts.gm1, neopixel_cots_hat-F_Cu.gtl, neopixel_cots_hat-F_Mask.gts, neopixel_cots_hat-F_Paste.gtp]
2024-04-22 I changed the 4.7uF termination capacitance for the 4.7nF Vincent told me to change on the Jetson Hat 4 months ago
    [NODE_CONNECTORS.kicad_sch]
2024-04-22 .lck suppression
    [orion_pcb.csv]
2024-05-07 New voltmeter
    [voltmeter_Alexandre_Eliot.kicad_pcb, voltmeter_Alexandre_Eliot.kicad_sch]
2024-05-07 Voltmeter with changes
    [voltmeter_Alexandre_Eliot.kicad_pcb]
2024-05-09 redid routing high speed lines, removed MOSFET.
    [voltmeter_Alexandre_Eliot.kicad_pcb, voltmeter_Alexandre_Eliot.kicad_sch]
2024-05-09 updated power trace
    [voltmeter_Alexandre_Eliot.kicad_pcb]
2024-05-09 built the zones
    [voltmeter_Alexandre_Eliot.kicad_pcb]
2024-05-13 Meriem voltmeter
    [I2CCAN-meriam.SchDoc, Meriem_Eliot_IMU.SchDoc, voltmeter_Alexandre_Eliot.kicad_pcb, voltmeter_Alexandre_Eliot.kicad_sch]
2024-07-11 New Jetson Hat
    [CANBUS_1.kicad_sch, CAN_BUS_SPI.kicad_sch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]
2024-07-11 Minor routing ajustment and silkscreen error correction
    [HatV5.kicad_pcb]
2024-07-11 Forgot to replot the manufacturing files. Now done.
    [HatV5-B_Adhesive.gbr, HatV5-B_Courtyard.gbr, HatV5-B_Cu.gbr, HatV5-B_Fab.gbr, HatV5-B_Mask.gbr, HatV5-B_Paste.gbr, HatV5-B_Silkscreen.gbr, HatV5-Edge_Cuts.gbr]
2024-07-12 impedance checked and traces spaced out
    [HatV5-B_Adhesive.gbr, HatV5-B_Courtyard.gbr, HatV5-B_Cu.gbr, HatV5-B_Fab.gbr, HatV5-B_Mask.gbr, HatV5-B_Paste.gbr, HatV5-B_Silkscreen.gbr, HatV5-Edge_Cuts.gbr]
2024-07-15 Neopixel v2
    [neopixel_eliot_hat.kicad_pcb, neopixel_eliot_hat.kicad_sch]
2024-07-16 Added the links to the BOM
    [CANBUS_1.kicad_sch, HatV5.csv, canbus_0.kicad_sch]
2024-07-22 neopixel update pour Farouk
    [neopixel_eliot_hat.kicad_pcb, neopixel_eliot_hat.kicad_sch]
2024-07-22 completed v2 Neopixel with gerbers and drill files
    [neopixel_eliot_hat-B_Cu (Sig).gbr, neopixel_eliot_hat-B_Mask.gbr, neopixel_eliot_hat-B_Paste.gbr, neopixel_eliot_hat-B_Silkscreen.gbr, neopixel_eliot_hat-Edge_Cuts.gbr, neopixel_eliot_hat-F_Cu (Sig).gbr, neopixel_eliot_hat-F_Mask.gbr, neopixel_eliot_hat-F_Paste.gbr]
2024-07-24 Neopixel v2.1
    [neopixel_eliot_hat-B_Cu (Sig).gbr, neopixel_eliot_hat-B_Mask.gbr, neopixel_eliot_hat-B_Paste.gbr, neopixel_eliot_hat-B_Silkscreen.gbr, neopixel_eliot_hat-Edge_Cuts.gbr, neopixel_eliot_hat-F_Cu (Sig).gbr, neopixel_eliot_hat-F_Mask.gbr, neopixel_eliot_hat-F_Paste.gbr]
2024-07-24 New schematics for the mass sensor, see : ADS1234_mass_sensor/ADS13M08IPAG
    [ads1232.kicad_pcb, ads1232.kicad_sch]
2024-07-27 Neopixel v2.2 with BOM and Gerber/Drill files
    [neopixel_eliot_hat-B_Cu (Sig).gbr, neopixel_eliot_hat-B_Mask.gbr, neopixel_eliot_hat-B_Paste.gbr, neopixel_eliot_hat-B_Silkscreen.gbr, neopixel_eliot_hat-Edge_Cuts.gbr, neopixel_eliot_hat-F_Cu (Sig).gbr, neopixel_eliot_hat-F_Mask.gbr, neopixel_eliot_hat-F_Paste.gbr]
2024-08-02 Gerbers, drill files and BOM updated
    [HatV5-B_Adhesive.gbr, HatV5-B_Courtyard.gbr, HatV5-B_Cu.gbr, HatV5-B_Fab.gbr, HatV5-B_Mask.gbr, HatV5-B_Paste.gbr, HatV5-B_Silkscreen.gbr, HatV5-Edge_Cuts.gbr]
2024-08-02 Moved a hole 2 mm so its cleaner and plotted the gerbers/drill files
    [HatV5-B_Adhesive.gbr, HatV5-B_Courtyard.gbr, HatV5-B_Cu.gbr, HatV5-B_Fab.gbr, HatV5-B_Mask.gbr, HatV5-B_Paste.gbr, HatV5-B_Silkscreen.gbr, HatV5-Edge_Cuts.gbr]
2024-08-02 Terminal Block PCB V1
    [terminal_block-B_Cu.gbr, terminal_block-B_Mask.gbr, terminal_block-B_Paste.gbr, terminal_block-B_Silkscreen.gbr, terminal_block-Edge_Cuts.gbr, terminal_block-F_Cu.gbr, terminal_block-F_Mask.gbr, terminal_block-F_Paste.gbr]
2024-08-02 Terminal Block PCB V2, added vias and fixed symetry issue
    [terminal_block-B_Cu.gbr, terminal_block-B_Mask.gbr, terminal_block-B_Paste.gbr, terminal_block-B_Silkscreen.gbr, terminal_block-Edge_Cuts.gbr, terminal_block-F_Cu.gbr, terminal_block-F_Mask.gbr, terminal_block-F_Paste.gbr]
2024-08-07 Inverted connector orientation to respect the xt connectors polarity
    [terminal_block.kicad_pcb, terminal_block.kicad_sch]
2024-08-16 Terminal Block V3, not finished, need to check some things tomorrow
    [terminal_block copie.kicad_pcb, terminal_block copie.kicad_sch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]
2024-08-18 terminal block routing finished, some checks tomorrow and its done
    [terminal_block-B_Cu.gbr, terminal_block-B_Mask.gbr, terminal_block-B_Paste.gbr, terminal_block-B_Silkscreen.gbr, terminal_block-Edge_Cuts.gbr, terminal_block-F_Cu.gbr, terminal_block-F_Mask.gbr, terminal_block-F_Paste.gbr]
2024-08-18 terminal block finished
    [terminal_block copie.kicad_pcb, terminal_block copie.kicad_sch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]
2024-09-16 Added Power, Last push of 2024
    [0451015.MRL.stp, 10159558-410421RLF.step, 10159558-410421RLF.stp, 53048-0450.stp, 74980111211_Download_STP_74980111211_rev1.stp, Block Diagram.kicad_sch, FTSH-107-01-F-DV-K-P-TR.step, FTSH-107-01-F-DV-K-P-TR.stp]
2024-09-16 First push of 2024-2025
    [0451015.MRL.stp, 10159558-410421RLF.step, 10159558-410421RLF.stp, 53048-0450.stp, 74980111211_Download_STP_74980111211_rev1.stp, Block Diagram.kicad_sch, FTSH-107-01-F-DV-K-P-TR.step, FTSH-107-01-F-DV-K-P-TR.stp]
2024-10-14 Introduction of the Charge Manager
    [Block Diagram.kicad_sch, Interface - Connectors.kicad_sch, MCU - Unit.kicad_sch, Power - Charger.kicad_sch, Power - Connectors.kicad_sch, Power - Generation.kicad_sch, Power - Power Path.kicad_sch, Power - Sequencing.kicad_sch]
2024-10-14 Fixed page numbering
    [Project Architecture.kicad_sch, charge_manager.kicad_sch]
2024-10-15 fixed repo
    [Block Diagram.kicad_sch, Interface - Connectors.kicad_sch, MCU - Unit.kicad_sch, Power - Charger.kicad_sch, Power - Connectors.kicad_sch, Power - Generation.kicad_sch, Power - Power Path.kicad_sch, Power - Sequencing.kicad_sch]
2024-10-15 wago 2.0
    [power_hat.kicad_pcb, power_hat.kicad_sch]
2024-10-15 First review changes, renamed project
    [Block Diagram.kicad_sch, ElonMux.kicad_pcb, ElonMux.kicad_sch, Interface - Connectors.kicad_sch, MCU - Unit.kicad_sch, Power - Charger.kicad_sch, Power - Connectors.kicad_sch, Power - Generation.kicad_sch]
2024-10-16 Added more fede recommandations
    [Interface - Connectors.kicad_sch, MCU - Unit.kicad_sch, Power - Charger.kicad_sch, Power - Power Path.kicad_sch, Project Architecture.kicad_sch, Revision History.kicad_sch]
2024-10-18 Almost done with schematics
    [Interface - Connectors.kicad_sch, MCU - Unit.kicad_sch, Power - Charger.kicad_sch, Power - Connectors.kicad_sch, Power - Generation.kicad_sch, Power - Power Path.kicad_sch, Project Architecture.kicad_sch, Revision History.kicad_sch]
2024-10-18 gerbers power hat
    [power_hat-B_Cu (Sig).gbr, power_hat-B_Mask.gbr, power_hat-B_Paste.gbr, power_hat-B_Silkscreen.gbr, power_hat-Edge_Cuts.gbr, power_hat-F_Cu (Sig).gbr, power_hat-F_Mask.gbr, power_hat-F_Paste.gbr]
2024-10-19 IMU Ismail v3
    [Xplore ERC IMU HAT.kicad_pcb, Xplore ERC IMU HAT.kicad_sch, Xplore ERC IMU.kicad_pcb, Xplore ERC IMU.kicad_sch]
2024-10-21 Rough layout
    [ElonMux.kicad_pcb, Interface - Connectors.kicad_sch, MCU - Unit.kicad_sch, Power - Charger.kicad_sch, Power - Connectors.kicad_sch, Power - Generation.kicad_sch, Power - Power Path.kicad_sch, Project Architecture.kicad_sch]
2024-10-25 Ready for layout review
    [Block Diagram.kicad_sch, ElonMux.kicad_sch, Interface - Connectors.kicad_sch, MCU - Unit.kicad_sch, Misc - Mounting Holes.kicad_sch, Power - Charger.kicad_sch, Power - Generation.kicad_sch, Power - Power Path.kicad_sch]
2024-10-27 Implemented some layout review by Fede
    [Interface - Connectors.kicad_sch, MCU - Unit.kicad_sch, Power - Generation.kicad_sch]
2024-10-27 Implemented more fede recommandations
    [MCU - Unit.kicad_sch, Misc - Mounting Holes.kicad_sch, Power - Charger.kicad_sch, Power - Connectors.kicad_sch, Power - Generation.kicad_sch, Power - Power Path.kicad_sch]
2024-10-29 More ameliorations
    [Interface - Connectors.kicad_sch, MCU - Unit.kicad_sch, Power - Charger.kicad_sch, Power - Connectors.kicad_sch, Power - Generation.kicad_sch, Power - Power Path.kicad_sch, Project Architecture.kicad_sch, Revision History.kicad_sch]
2024-11-08 final version before new comnnectors
    [MCU - Unit.kicad_sch, Power - Connectors.kicad_sch, Power - Generation.kicad_sch, Power - Power Path.kicad_sch, Revision History.kicad_sch]
2024-11-09 Fixed insulation and 1/2 connector
    [Interface - Connectors.kicad_sch, MCU - Unit.kicad_sch, Power - Charger.kicad_sch, Power - Connectors.kicad_sch, Power - Generation.kicad_sch, Power - Power Path.kicad_sch, Sensor - Battery.kicad_sch]
2024-11-19 Preliminary Submission
    [Block Diagram.kicad_sch, MCU - Unit.kicad_sch, Misc - Mounting Holes.kicad_sch, Power - Charger.kicad_sch, Power - Connectors.kicad_sch, Power - Generation.kicad_sch, Power - Power Path.kicad_sch, Power - Sequencing.kicad_sch]
2024-11-25 Removed some weird rooting angles, and fixed capa for reset button
    [MCU - Unit.kicad_sch, Misc - Mounting Holes.kicad_sch, Project Architecture.kicad_sch]
2024-11-26 Nothing to declare
    [Block Diagram.kicad_sch, Power - Sequencing.kicad_sch, Project Architecture.kicad_sch, Revision History.kicad_sch, SMPS_legged_robot_module.kicad_pcb, SMPS_legged_robot_module.kicad_sch, connector_debug.kicad_sch, connector_output.kicad_sch]
2024-11-28 Added MODE, U0TX, U0RX, sourced from Mouser
    [ElonMux_bom_1.0.csv, Interface - Connectors.kicad_sch, MCU - Unit.kicad_sch, Misc - Mounting Holes.kicad_sch, Power - Charger.kicad_sch, Power - Generation.kicad_sch, Power - Power Path.kicad_sch, Project Architecture.kicad_sch]
2024-12-14 Final version with Buck-Boost
    [MCU - Unit.kicad_sch, Misc - Mounting Holes.kicad_sch, Power - Charger.kicad_sch, Power - Connectors.kicad_sch, Power - Generation.kicad_sch, Power - Power Path.kicad_sch, Revision History.kicad_sch, User - LED Indicators.kicad_sch]
2024-12-16 Implemented BQ battery charger
    [BQ25756-DESIGN-CALC-V01X2.xlsx, BQ25756-DESIGN-CALC-V01X2_backup.xlsx, Block Diagram.kicad_sch, MCU - Unit.kicad_sch, Power - Charger.kicad_sch, Power - Generation.kicad_sch, Power - Power Path.kicad_sch, Project Architecture.kicad_sch]
2024-12-17 More corrections and adjustments
    [ElonMux-B_Mask.gbr, ElonMux-B_Paste.gbr, ElonMux-B_Silkscreen.gbr, ElonMux-Edge_Cuts.gbr, ElonMux-F_Mask.gbr, ElonMux-F_Paste.gbr, ElonMux-L1 (Sig, PWR).gbr, ElonMux-L2 (GND).gbr]
2024-12-18 Added Thermal Vias
    [BQ25756-DESIGN-CALC-V01X2_backup.xlsx]
2024-12-20 save before rerooting of mosfets
2024-12-22 Re-rooted charger area for reduced EMI and added 24V FAN soldering holes
    [Misc - Mounting Holes.kicad_sch, Power - Charger.kicad_sch]
2025-01-23 Changed inductors footprints, cleaned copper fills areas, improved silkscreen
    [MCU - Unit.kicad_sch, Misc - Mounting Holes.kicad_sch, Power - Charger.kicad_sch, Power - Generation.kicad_sch, Power - Power Path.kicad_sch, Sensor - Battery.kicad_sch, User - LED Indicators.kicad_sch]
2025-01-25 Final version for review
    [BQ25756-DESIGN-CALC-V01X2.xlsx, BQ25756-DESIGN-CALC-V01X2_backup.xlsx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]
2025-01-26 Rounded USB lines, improved silkscreen
2025-01-27 Added I2C adress on PCB and schematic
    [Power - Charger.kicad_sch]
2025-02-11 Released PCB
    [ElonMux_bom_1.0.csv, MCU - Unit.kicad_sch, Misc - Mounting Holes.kicad_sch, Power - Charger.kicad_sch, Power - Connectors.kicad_sch, Power - Generation.kicad_sch, Power - Power Path.kicad_sch, Revision History.kicad_sch]
2025-02-22 Merged ElonMux v1.0
    [BQ25756-DESIGN-CALC-V01X2_backup.xlsx, Block Diagram.kicad_sch, ElonMux_bom_1.0.csv, MCU - Unit.kicad_sch, Misc - Mounting Holes.kicad_sch, Power - Charger.kicad_sch, Power - Connectors.kicad_sch, Power - Generation.kicad_sch]
