EPFLXplore/ERC_AV_HW/(notices)

Notices in the files:
Power/GEOX/rev1/Geode_FW/Core/Src/spi.c:
Copyright (c) 2024 STMicroelectronics.
All rights reserved.
This software is licensed under terms that can be found in the LICENSE file
Power/GEOX/rev2/SMPS_Motherboard/footprints/connector/JTAG/FTSH-107-01-F-DV-K-P-TR.stp:
author */ ('License CC BY-ND 4.0'),
